malbreitenbach/adp_tauchspulenelektronik/README.md

# adp_tauchspulenelektronik
ADP Tauchspulenelektronik (Versions-/Projektmanagement)
