malbreitenbach/adp_tauchspulenelektronik/Ausarbeitung/ADP_ausarbeitung/ADP.tex

\documentclass[nochapterpage,bigchapter,linedtoc,longdoc,colorback,accentcolor=tud1c]{tudreport}
\usepackage{ngerman}
\usepackage{subfigure} 
\usepackage[stable]{footmisc}
\usepackage[ngerman]{hyperref}
\usepackage{sistyle}
\SIdecimalsign{,}
\SIthousandsep{\,}
\usepackage{longtable}
\usepackage{multirow}
\usepackage{booktabs}
\usepackage{graphicx}
\usepackage[backend=bibtex,style=alphabetic]{biblatex}
\bibliography{./bibtex/library}
\usepackage{amsmath}
\usepackage{caption} 
\usepackage{float}
\usepackage{pdfpages}

\hypersetup{%
  pdftitle={Entwicklung und Test einer
eingebetteten Elektronik für einen
innovativen Schaltaktor},
  pdfauthor={Malte Breitenbach, Johannes Faupel, Jonas Tautz, Johanna Vetter},
  pdfsubject={Beispieltext},
  pdfview=FitH,
  pdfstartview=FitV
}

%%% Zum Tester der Marginalien %%%
  \newif\ifTUDmargin\TUDmarginfalse
  %%% Wird der Folgende Zeile einkommentiert,
  %%% werden Marginalien gesetzt.
  % \TUDmargintrue
  \ifTUDmargin\makeatletter
    \TUD@setmarginpar{2}
  \makeatother\fi
%%% ENDE: Zum Tester der Marginalien %%%

\newlength{\longtablewidth}
\setlength{\longtablewidth}{0.7\linewidth}
\addtolength{\longtablewidth}{-\marginparsep}
\addtolength{\longtablewidth}{-\marginparwidth}

% \settitlepicture{tudreport-pic}
% \printpicturesize

\title{Entwicklung und Test einer eingebetteten Elektronik für einen innovativen Schaltaktor}
\subtitle{Development and test of embedded electronics for an innovative shift actuator}
\subsubtitle{Advanced Design Project (ADP)\\Autoren: Malte Breitenbach, Johannes Faupel, Jonas Tautz, Johanna Vetter\\ Betreuer: Daniel Schöneberger\\Bearbeitungszeitraum: 27. November 2018 ~- 03. April 2019\\Technische Universität Darmstadt}
%\subsubtitle{email: \textaccent{tud-design@pro-kevin.de}}
%\setinstitutionlogo[width]{TUD_sublogo}
%\uppertitleback{(\textaccent{\textbackslash uppertitleback})}
\setinstitutionlogo{./Bilder/IMSLogo}
\lowertitleback{\hfill\today}
\institution{ 
Institut für Mechatronische Systeme im Maschinenbau\\
     Prof. Dr.-Ing. Stephan Rinderknecht}
%\dedication{Hier ist gen"ugend Platz\\
  %f"ur eine Widmung (\textaccent{\textbackslash dedication}).\\
  %\strut\\
  %F"ur Annelore Schmidt\\
  %aus dem Referat Kommunikation.\\
  %Sie hat immer ein offenes Ohr\\
  %f"ur unsere Fragen und Anregungen.}
%\sponsor{\color{tud9b}\rule{\linewidth}{7mm}}
%\sponsor{\hfill\includegraphics[height=6ex]{tud_logo}\hspace{1em}\includegraphics[height=6ex]{TUD_chaos}}

\begin{document}
\maketitle
\pagenumbering{roman}
\cleardoublepage
\phantomsection
\addcontentsline{toc}{chapter}{Aufgabenstellung}
\includepdf[pagecommand={\thispagestyle{plain}},width=1.16\columnwidth]{./input/aufgabenstellung2.pdf}
\cleardoublepage
\phantomsection
\addcontentsline{toc}{chapter}{Erklärung}
\input{./input/Erklaerung} 
\cleardoublepage
\phantomsection
\addcontentsline{toc}{chapter}{Kurzfassung}
\section*{Kurzfassung}
Die vorliegende Arbeit befasst sich mit der Entwicklung und der Realisierung  einer eingebetteten Elektronik für einen linearen Tauchspulenaktor. Dieser wird als Schaltaktor für mehrgängige elektrische Antriebe entwickelt und am Prüfstand des Instituts für Mechatronische Systeme eingesetzt um die Schaltgabel eines Getriebes translatorisch zu bewegen.
In vorangegangenen Arbeiten wurde bereits eine Regelung der Schaltgabelposition entworfen. Auf Basis dessen erfolgt zunächst die Implementierung der bisherigen Programmierung mittels einer geeigneten Toolchain in Matlab-Simulink auf einem Mikrocontroller, der von nun an die Steuerung der Schaltgabel übernehmen soll. Mithilfe von CAN-Kommunikation soll der Mikrocontroller einerseits Statusmeldungen und besonders Fehlzustände übermitteln können, andererseits bietet die CAN-Schnittstelle die Möglichkeit, dem Mikrocontroller Befehle zu senden. Im nächsten Schritt wird die für die Regelstrecke benötigte Elektronik, welche Aktoransteuerung, Sensorik sowie Spannungsversorgung umfasst, an den Aktor integriert, indem die gesamte Schaltung auf einer eigens entworfenen Platine verwirklicht wird, welche anschließend in einem Gehäuse liegend am Aktor verschraubt wird. Zusätzlich wird das System um einen Temperatursensor, der Übertemperaturen erkennen kann, sowie eine Strom- sowie Betriebsspannungsmessung erweitert.
Das Ergebnis der Arbeit ist ein Smart Actuator inklusive kompakter eingebetteter Elektronik, der auf einfachen Befehl über die Benutzeroberfläche Controldesk selbstständig die zwei Gänge einlegen oder in Neutralstellung schalten kann.\\

\textbf{Schlagwörter:} Smart Actuator, eingebettetes System, Linearaktor, Platinendesign

\section*{Abstract}
This thesis deals with the evaluation and implementation of an embedded electronics for a linear plunger coil actuator.  This actuator is used at the test bench of the Institute of Mechatronic Systems to move the shift fork of a transmission.
In previous work a control of the shift fork position has already been developed. On the foundation of this, the implementation of the previous programming is carried out using a suitable toolchain in Matlab-Simulink on a microcontroller, which henceforth will take over the control of the shift fork. With the use of CAN communication, the microcontroller should be able to transmit status messages and especially error states but also the CAN interface gives the opportunity to send commands directly to the microcontroller. In the next step, the electronics required for the controlled system, including the actuator control, sensor technology and power supply, are integrated into the actuator by realizing the entire circuit on a specially designed circuit board, which is then mounted to the motor in a case. In addition, a temperature sensor, which can detect overtemperatures, is integrated as well as some internal functions, for example the current measurement within the used half bridges.  The result of the work is a Smart Actuator including compact embedded electronics, which can engage the two gears independently or shift to neutral position with a simple command via the user interface Control Desk.\\

\textbf{Keywords:} smart actuator, embedded system, linear actuator, PCB design
\cleardoublepage
\phantomsection
\addcontentsline{toc}{chapter}{Inhaltsverzeichnis}
\tableofcontents
\cleardoublepage
\phantomsection
\addcontentsline{toc}{chapter}{\listfigurename}
\listoffigures
\cleardoublepage
\phantomsection
\addcontentsline{toc}{chapter}{\listtablename}
\listoftables
\input{./input/Abkuerzungsverzeichnis}
\cleardoublepage
\pagenumbering{arabic}
%% Hier Tex-Dateien includen
%%%%%%%%%%%%%%%%%%%%%%%%%%%%%%%%%%%%%%%%%%
\input{./input/1_Einleitung}
\input{./input/2_Pruefstand}
\input{./input/3_Vorgehensweise}
\input{./input/4_Komponentenauswahl}
\input{./input/5_Platinendesign}
\input{./input/6_Software}
\input{./input/7_Analyse}
\input{./input/8_Fazit}
%%%%%%%%%%%%%%%%%%%%%%%%%%%%%%%%%%%%%%%%%%
\newpage
\pagenumbering{Roman}
\phantomsection
\addcontentsline{toc}{chapter}{Literaturverzeichnis}
\printbibliography[title=Literaturverzeichnis]

\input{./input/Anhang}
\end{document}
