malbreitenbach/adp_tauchspulenelektronik/Ausarbeitung/ADP_ausarbeitung/input/2_Pruefstand.tex

\chapter{Aufbau des Prüfstands und Grundlagen}\label{kap2}
In diesem Kapitel wird der verwendete Schaltaktorikprüfstand des IMS, an dem  die Entwicklung des Smart Actuators stattgefunden hat, vorgestellt. Beschrieben wird der Aufbau und die Funktionen des Prüfstands zu Beginn der Projektphase, also bevor eigene Änderungen vorgenommen wurden.
\section{Grundlagen des Prüfstandes}
Die Konstruktion des Prüfstandes erfolgte in vorangegangenen Arbeiten und wurde seitdem stetig weiterentwickelt. An diesem werden Schaltaktoriksysteme für Fahrzeugantriebe untersucht. \autoref{fig:Pruefstand} zeigt den Prüfstand aus der Vogelperspektive. Links ist der Aktor zu sehen, der über Schaltstange und Schaltgabel mit dem Getriebe (rechts) verbunden ist.
Es erfolgt zunächst die Vorstellung des mechanischen Aufbaus, woraufhin der elektronische Aufbau anschließt. 
\begin{figure}[h]
	\centering
		
	\caption{Prüfstand \cite[S.5]{adp}}
	\label{fig:Pruefstand}
\end{figure} \noindent
\subsection{Getriebe allgemein}

Ein Getriebe ist im Automobil dafür zuständig, die Drehzahl des Motors in ein Drehmoment umzuwandeln, welches schließlich die Räder antreibt.
Da Verbrennungsmotoren nur einen vergleichbar kleinen Drehzahlbereich abdecken, werden mehrstufige Getriebe verwendet, um verschiedene Raddrehzahlen durch unterschiedliche Übersetzungsverhältnisse der Getriebezahnräder bereitstellen zu können.  Das Einstellen des jeweiligen Ganges kann dabei per Hand (Handschaltgetriebe) oder automatisiert über einen Aktor (Schaltaktorik) erfolgen. 
Im Fahrzeuggetriebe, beispielhaft dargestellt in \autoref{fig:Fahrzeuggetriebe}, ist die Eingangswelle, welche durch den Motor angetrieben wird, über eine Zahnradverbindung  fest mit der  Vorgelegewelle verbunden. Auf ihr sind noch weitere fest fixierte Zahnräder angebracht, deren Anzahl mit den verfügbaren Gängen übereinstimmt. Diese greifen jeweils in Losräder auf der Abtriebswelle. Um einen bestimmten Gang einzulegen, muss nun das jeweilige Losrad für diesen Zeitpunkt fest mit der Abtriebswelle verbunden werden, sodass nur diese Zahnverbindung ein Drehmoment überträgt. Dies geschieht über eine formschlüssige Verbindung mit einer Schaltmuffe, die über die durch den Aktor angetriebene Schaltgabel in Position gebracht wird.

\begin{figure}[h]
	\centering
		
	\caption{Fahrzeuggetriebe \cite[S.17]{Hilgers2016}}
	\label{fig:Fahrzeuggetriebe}
\end{figure} \noindent

\subsection{Getriebe des Prüfstands}

Der Prüfstand besitzt zwei Gänge, in die über eine Schaltgabel geschaltet werden kann. Eine Bewegung der Schaltgabel nach links legt Gang 1 über eine mechanische Synchronisierung ein, während mit Hilfe einer Bewegung nach rechts die Schaltung des Ganges 2 durch eine Klauenkupplung erfolgt. Somit können sowohl Schaltaktoriksysteme mit als auch ohne Synchronring untersucht werden.
Die Bewegung der Schaltgabel wird durch einen Linearaktor ermöglicht, welcher von außen an dem Item-Profil verschraubt ist. In diesem ist eine Tauchspule verbaut, die die benötigten Kräfte auf die Läuferstange aufbringt. Über eine starre Wellenkupplung sind Läuferstange und Schaltgabel miteinander verbunden, wodurch die Kräfte auf die Schaltgabel übertragen werden und Schaltvorgänge ermöglicht werden.

\subsection{Aktor}

Der momentan in dem Prüfstand verbaute Tauchspulenaktor wurde von \cite{Hahn2018} im Rahmen einer Bachelorthesis entwickelt und konstruiert. Er übernimmt im automatisierten Schaltvorgang die Aufgabe, die Schaltgabel  über die Schaltstange translatorisch zu verschieben. Die Übertragung des Schaltbefehls an den Getriebeaktor erfolgt dabei durch ein elektrisches Signal (\textit{shift by wire}).
Der Aktorquerschnitt ist in \autoref{fig:Querschnitt Aktor} schematisch dargestellt.

\begin{figure}[h]
	\centering
		
	\caption{Querschnitt Tauchspulenaktor \cite[S.30]{Hahn2018}}
	\label{fig:Querschnitt Aktor}
\end{figure} \noindent
Der Aufbau ist zylindrisch und kann in den ortsfesten Stator und den beweglichen Läufer unterteilt werden. Der Stator des Aktors besteht aus zwei gegensinnig in Reihe geschalteten Kupferspulen, welche fest in dem Gehäuse aus Weicheisen liegen und nach oben und unten mit Deckeln aus Aluminium fixiert werden. Der Läufer besteht aus einer nichtmagnetischen Läuferwelle, auf der sich fünf Permanentmagneten aus Neodym-Eisen-Bor befinden, welche mit Hilfe von zwei Polstücken aus Weicheisen axial auf der Läuferstange montiert sind. 
Werden nun die Kupferspulen von Strom durchflossen, so wirkt eine vom Magnetfeld der Permanentmagneten induzierte Lorentzkraft orthogonal auf sie. Diese Kraft ist abhängig von der Stromstärke I, der magnetischen Flussdichte der Permanentmagneten B und der vom Magnetfeld durchsetzten Leiterlänge l:
\begin{equation}\label{eq:lorentz}
F=I\cdot l\cdot B
\end{equation}
Da die Spulen jedoch fest im Gehäuse verbaut sind, wirkt eine entgegengerichtete Kraft auf die Permanentmagneten, die auf der axial verschiebbaren Läuferstange lagern. Diese Kraft bewirkt dann eine translatorische Bewegung der Läuferstange und somit auch der Schaltgabel. Die Richtung der translatorischen Bewegung kann dabei über die Richtung des in den Spulen fließenden Stromes, der Betrag der Kraft über den Betrag des Stromes eingestellt werden.
Anhand von \autoref{fig:Kennlinie Aktor} ist zu erkennen, dass die Kraft-Weg Kennlinien des Aktor innerhalb des Nutzungsbereichs von -10 Millimeter bis +10 Millimeter bei verschiedenen Stromstärken annähernd linear verlaufen. \\

\begin{figure}[h]
	\centering
		
	\caption{Kraft-Weg-Strom Kennlinien des Tauchspulenaktors \cite[S.12]{adp}}
	\label{fig:Kennlinie Aktor}
\end{figure} \noindent

\subsection{Aktorsteuerung}
Zur Ansteuerung des Aktors wird ein Arduino IBT2 Motortreiber verwendet, die Stromversorgung erfolgt über ein Manson SBC-2130 Battery Charger im Power Supply Mode. Der Motortreiber besteht aus zwei BTS7960 MOSFETs, die je nach Vorgabe des pulsdauermodulierten Signals (PWM-Frequenz) eine Spannung von bis zu \SI{13,8}{V} an den Aktor durchschalten. 

\subsection{MicroAutoBox}
Die bisherigen Funktionen am Prüfstand laufen auf einer MicroAutoBox II 1401/1513 der dSpace GmbH. Das Programm zum Schalten des Aktors und der Positionsregelung, welches in MATLAB/SIMULINK entwickelt wurde, wird auf die AutoBox geflasht und diese über die Software dSpace ControlDesk gesteuert.

\subsection {Positionsmessung und -regelung}\label{regler}

Das momentane Ziel des Aufbaus ist es, die Schaltgabelposition zu regeln, um schalten zu können. Das Blockschaltbild hierzu ist in \autoref{fig:Regelstrecke} dargestellt.
\begin{figure}[H]
	\centering
		
	\caption{Regelstrecke Prüfstand nach \cite{adp}}
	\label{fig:Regelstrecke}
\end{figure} \noindent
Über das Programm Control Desk erfolgt die Sollwertvorgabe am PC. Diese wird per Ethernet an die MicroAutoBox, welche den Regler darstellt, übermittelt, die den Wert mit der Istgröße vergleicht, die der Sensor bereitstellt. Die H-Brücke, welche mit einer Stellenergie versorgt werden muss, steuert den Aktor an, um die Schaltgabelposition zu verändern.
Die Position der Läuferstange wird über einen PLCD-25M Sensor gemessen, dessen berührungslose PLCD (permanentmagnetic linear contactless displacement) Technologie die magnetische Sättigung zur Positionsbestimmung verwendet. Der weichmagnetische Kern des Sensors ist über seine komplette Länge von einer Primärspule umgeben. Auf der Schaltgabel ist ein Permanentmagnet befestigt, welcher je nach Position zu einer lokalen Sättigung des weichmagnetischen Kerns führt. Über zwei Auswertungsspulen am Rand des Sensors kann die Position der Sättigungszone entlang der Sensorachse über die induzierte Spannung bestimmt werden.

\begin{figure}[h]
	\centering
		
	\caption{Einbauposition PLCD Sensor an der Schaltgabel \cite[S.14]{adp}}
	\label{fig:Sensor}
\end{figure} \noindent
Die Kalibrierung des Sensors wurde in \cite[S.24f]{messtechnik} entwickelt und erfolgt bisher bei jedem Start, da die Kalibrierparameter beim Ausschalten verloren gehen. Zu Beginn des Einfahrvorgangs der Schaltwalze wird dabei das Spannungssignal $U\textsubscript{0}$ ausgelesen, welches der Ausgangslage von $x\textsubscript{0}=\SI{0}{mm}$ entspricht. Anschließend werden die Spannungssignale $U\textsubscript{1}$ und $U\textsubscript{2}$ an beiden Anschlägen gemessen. Die Wegdifferenz zwischen den beiden Anschlagspositionen beträgt $x_{ges}$=\SI{18,2}{mm}. Nun kann eine Geradengleichung zur Bestimmung der aktuellen Schaltgabelposition gemäß \autoref{eq:Lage} aufgestellt werden. U\textsubscript{a} entspricht dabei immer dem aktuellen Ausgangssignal.

\begin{equation}\label{eq:Lage}
	x=\frac{U\textsubscript{a} -U\textsubscript{0}}{U\textsubscript{1}-U\textsubscript{2}}\cdot x\textsubscript{ges}
\end{equation}
\noindent
Die bisherige Regelung der Schaltgabelposition wurde in einem vorangegangenen Advanced Design Project ausgelegt. Dazu wurden mithilfe des Ziegler-Nichols-Verfahren zunächst Parameter für einen PID-Regler ermittelt, welcher allerdings noch zu große Totzeiten und ein Überschwingen aufwies. In einer anschließenden iterativen Optimierung mit Störgrößenkompensation wurden die Regelparameter zu $K_P$ =\SI{2,6}{\%\frac{V}{mm}}, $K_I$ =\SI{20}{\%\frac{V}{s mm}} und $K_D$ =\SI{1,6}{\%\frac{Vs}{mm}} bestimmt. Der Verlauf der Sprungantwort ist in nachstehender \autoref{fig:Sprungantwort Schaltgabelposition} dargestellt.
\begin{figure}[h]
	\centering
		
	\caption{Sprungantwort Schaltgabelposition \cite[S.35]{adp}}
	\label{fig:Sprungantwort Schaltgabelposition}
\end{figure} \noindent

\section{Grundlagen Löten}
Löten gehört zu den Fügeverfahren und bezeichnet das Verbinden zweier Metalle durch eine Metalllegierung unter Einfluss von Wärme \cite{loeten}. Die Metalllegierung wird dabei als Lot bezeichnet und hat eine geringere Schmelztemperatur (Liquidustemperatur) als die beiden zu verbindenden Metalle (Solidustemperatur). Durch das Löten entsteht eine feste, korrosionsbeständige sowie strom- und wärmeleitende Verbindung. Lötverfahren werden nach Arbeitstemperatur eingeteilt in Weichlöten (bis 450°C), Hartlöten (450°C - 900°C) und Hochtemperaturlöten (über 900°C). Im Rahmen dieses Projektes wird das Verfahren Weichlöten mit Lötkolben angewendet, um die elektrischen Bauteile auf der Platine anzubringen. Dazu können die vom Institut bereitgestellten Lötstationen und –materialien verwendet werden. 

\section{Mikrocontroller}
Ein Mikrocontroller (\textit{MCU: microcontroller unit}) ist ein hochintegrierter Halbleiterchip, der ein komplettes Mikrorechnersystem enthält. Prozessoren, Speicher, Ein- und Ausgabegeräte sind somit auf einem kleinen Chip enthalten, der zum Ziel hat, Steuerungs- und Kommunikationsaufgaben möglichst simpel mit wenig Bauelementen zu bearbeiten. \\
\begin{figure}[H]
	\centering
		
	\caption{Blockschaltbild eines Mikrocontrollers nach \cite[S.3]{Bernstein2015}}
	\label{fig:Blockschaltbild Mikrocontroller}
\end{figure} 
\noindent
In \autoref{fig:Blockschaltbild Mikrocontroller} ist der typische Aufbau eines Mikrocontroller dargestellt. Die Schnittstellen zur Peripherie sind durch einen Betriebsspannungsanschluss, einen Takteingang sowie die Portleitungen  gegeben. Bei den Ports wird zwischen Eingangskanälen (\textit{\textbf{I}nput Port}), die digitale Signale lesen, und Ausgangskanälen (\textit{\textbf{O}utput Port}), die digitale Signale setzen beziehungsweise löschen, unterschieden. Des Weiteren können I/O Pins digitale oder analoge Signale auslesen und stellen, wobei analoge Signale mithilfe eines Analog/Digital Wandlers (\textit{ADC}) zuerst in digital Signale umgewandelt werden müssen, damit der Mikrocontroller sie verarbeiten kann.
Eine Spezialform von Eingängskanälen sind die Interrupt-Pins, die bei bestimmten Ereignissen Unterbrechungen des laufenden Programms verursachen, um temporär einen anderen Vorgang zu bearbeiten. \\
Intern sind die einzelnen Bausteine, die im Folgenden kurz erläutert werden, über ein Bussystem verbunden.
Der Prozessor (\textit{CPU: central processing unit}) führt Berechnungen und logische Operationen durch.
Der Arbeitsspeicher (\textit{RAM: random access memory}) speichert temporär Daten, die aber spätestens nach dem Entfernen der Betriebsspannung verloren gehen.
Der Festspeicher (\textit{ROM: read only memory}) behält seinen Speicherinhalt auch nach dem Entfernen der Betriebsspannung und enthält aufgrund dessen das Programm sowie Einstellungen und wichtige Daten. Im Vergleich zum RAM weist dieser eine langsame Schreibgeschwindigkeit auf. 
Ein sogenannter Timer wird genutzt, um das Auftreten von Ereignissen zu zählen oder Zeitabstände zu messen, indem beispielsweise Spannungswechsel an einem Eingangskanal gezählt werden. \\
Die genaue Ausführung des Chips kann je nach Aufgabentyp variieren, sodass eine Vielzahl an verschiedenen Mikrocontrollern erhältlich ist. Diese unterscheiden sich in der Größe des Speichers, in der Anzahl der Anschlüsse beziehungsweise Schnittstellen, in der Bitbreite, in den Taktraten sowie in der Bauform. Typischerweise werden Mikrocontroller in eingebetteten Systemen (\textit{embedded systems}) verwendet, bei denen die Steuereinheit direkt im System selbst integriert ist. Übliche Anwendungen für Mikrocontroller sind Robotik, Handys, Temperaturregler oder Motorsteuerungen \cite{Brinkschulte}. 

\section{Eingebettete Systeme und Smart Actuator}
Eingebettete Systeme werden definiert als Rechenmaschinen, die für den Anwender weitgehend unsichtbar in einem technischen System eingebettet sind und mit diesem in Wechselwirkung stehen \cite[S.8]{Gessler2014}. Der Rechner kann dabei für Regelungs-, Steuer- oder Überwachungsaufgaben und/ oder für Signal- und Datenverarbeitung zuständig sein. Ziel ist, die Stellglieder als Reaktion auf Eingangssignale, die von Sensoren oder manuell vorgegeben werden, zu steuern \cite[S.1]{Broy2003}. Eingebettete Systeme werden oft für speziell eine isolierte Aufgabe entwickelt und angepasst.
Ein Aktor wird genutzt um elektrischen Signale in eine Bewegung oder Kraft umzusetzen und bildet somit das Stellglied. \\
Ein intelligenter Aktor (\textit{smart actuator}) ist definiert als das integrierte Stellglied inklusive aller Komponenten wie Motor, Steuerung, Sensorik und Kommunikationseinheit \cite[S.442]{smartactuator}.
Das Konzept besteht darin, den Aktor um Informationsverarbeitungs- und Kommunikationsmöglichkeiten zu erweitern, sodass der Aktor die eingebettete Elektronik enthält.
Smart Actuators reduzieren beziehungsweise ersetzen die benötigte Interaktion mit einem Menschen oder externen Rechner und können somit effektiver und schneller arbeiten. Über diese kann viel Bauraum eingespart werden, da es weniger Komponenten und deutlich weniger Verkabelung gibt, womit der Einbau in ein Gesamtsystem komfortabler ist. Hervorzuheben sind weiterhin die verringerten Kosten, die Überwachung und Diagnose des eigenen Zustands sowie die verbesserte Präzision. Einbußen müssen Smart Actuators allerdings in Bezug auf flexible Anwendungen machen, da sie oft für eine spezielle Aufgabe ausgelegt sind und ihr Verhalten stark vorgegeben ist. \cite[S.4]{smartaktor}

\section{Controller Area Network (CAN)}\label{sec:CAN_KAP2}
Um eine Kommunikation zwischen mehreren Geräten (z.B. Sensoren, Aktoren oder Steuergeräten) zu ermöglichen, muss ein System zur Datenübertragung vorhanden sein. Dabei hat sich bei vielen PKW- und NKW-Herstellern  das Controller Area Network (CAN) durchgesetzt \cite[S.57]{Werner2014}. CAN ist ein von Bosch für den Automobilbau entwickeltes Bussystem, mit dem mehrere gleichberechtigte Teilnehmer verbunden werden und miteinander kommunizieren können \cite[S. 278]{Woern2006}.
Für ein CAN-Netzwerk werden zwei Leitungen CAN-High und CAN-Low benötigt, an denen alle zu verbindenden Teilnehmer parallel angeschlossen sind. Die beiden Leitungen werden an beiden Enden mit Wellenwiderständen von 120 Ohm verbunden. Der schematische Aufbau eines CAN-Busses mit zwei Teilnehmern ist in \autoref{fig:CAN} dargestellt.\\
\begin{figure}[h]
	\centering
		
	\caption{Aufbau CAN-Bus \cite[S.158]{manual}}
	\label{fig:CAN}
\end{figure} \noindent
Sollten mehrere Teilnehmer gleichzeitig versuchen eine Nachricht zu senden und somit ein gleichzeitiger Buszugriff vorliegt, kommt es zu einer Kollision. Um diese Aufzulösen wird ein CSMA/CR-Verfahren (\textit{Carrier Sense Multiple Access/Collision Resolution}) verwendet, bei dem die höher gewichtete (dominante) Nachricht die niedriger gewichtete (rezessive) Nachricht überschreibt, sodass der Übertragungsversuch beendet wird. Die Einteilung der Relevanz einer Nachricht erfolgt auf Basis der sogenannten Identifier(ID)-Bits, wobei niedrige ID-Bits eine höhere Relevanz als höhere ID-Bits haben. Dadurch wird eine Hierarchie der Nachrichten erzeugt, wodurch die Nachricht mit der niedrigsten ID immer gesendet werden darf. Dementsprechend werden wichtigen Nachrichten niedrige IDs zugeteilt \cite{Lawrenz2010}. 
Die Geschwindigkeit der Datenübertragung zwischen den Teilnehmer ist dabei von der Länge der Leitungen abhängig und beträgt maximal 1Mbit/s. Nach \cite[S.58]{Werner2014} kann die Bitrate überschlagsmäßig mit 
\begin{equation}
	\text{Buslänge}\leq 40...\SI{50}{m}\cdot \frac{1\text{MBit/s}}{\text{Bitrate}}
	\label{eq:CAN}
\end{equation}
berechnet werden.\\
In \autoref{CANNachrichten} wird speziell auf die in dieser Arbeit eingerichtete CAN-Kommunikation eingegangen. Es wird ein CAN-Bus verwendet, mit dem im derzeitigen Versuchsstand zwei Teilnehmer miteinander verbunden werden. Diese sind zum einen die MicroAutoBox und zum anderen der Mikrocontroller des Smart Actuators. Die Länge der Leitungen zwischen den beiden ist wesentlich kürzer als \SI{3}{m}, wodurch nach \autoref{eq:CAN} die maximale Bitrate von 1Mbit/s möglich wird.

\section{Pulsweitenmodulation}
Pulsweitenmodulation (PWM) bietet die Möglichkeit, ein analoges Signal anhand einer digitalen Quelle zu bilden, indem das Tastverhältnis eines Rechteckimpulses bei gleichbleibender Frequenz moduliert wird. Dabei wird der Effekt ausgenutzt, dass sich ein digitales Signal, welches schnell genug und in einem gewissen Tastverhältnis seinen Zustand wechselt, verhält wie ein analoges Signal mit konstanter Spannung. So kann mithilfe von PWM beispielsweise ein Motortreiber angesteuert werden, der über MOSFETS das PWM Signal mit höherem Spannungslevel durchschaltet. Über die Tiefpasswirkung des Motors wird das Signal geglättet, sodass es sich annähernd wie eine angelegte Gleichspannung verhält (vgl. \autoref{sec:hbridge}).\\
Das Tastverhältnis, oder der Tastgrad, p beschreibt dabei das Verhältnis zwischen der Einschaltzeit t\textsubscript{ein} und der Periodendauer $\tau$:
\begin{equation}
	p=\frac{t\textsubscript{ein}}{\tau} = \frac{t\textsubscript{ein}}{t\textsubscript{ein}+t\textsubscript{aus}}
\end{equation}
Das Tastverhältnis kann nur Werte zwischen 0 und 1 annehmen.\\
Der zeitliche Mittelwert der Spannung U\textsubscript{m} ergibt sich dann bei einer Betriebsspannung V\textsubscript{b} zu:
\begin{equation}
	U\textsubscript{m}=V\textsubscript{b}\cdot p
\end{equation}
In Abbildung \ref{fig:PWM} ist ein pulsweitenmoduliertes Signal mit dem entsprechendem zeitlichen Mittelwert aufgetragen. Das Tastverhältnis entspricht hier $p=0,75$.
\begin{figure}[H]
	\centering
		
	\caption{Beispielhaftes PWM Signal}
	\label{fig:PWM}
\end{figure} \noindent

\section{Zustandsautomaten}
Zustandsautomaten, auch endliche Automaten genannt, eignen sich zur Beschreibung von Systemen, in denen eine endliche Anzahl an Ereignissen eintreten können. In ihnen treten Zustände, Zustandsübergänge und Aktionen auf, aus dem das Verhalten einen Systems modelliert wird. Zustandsübergänge sind logische Operatoren, die erfüllt sein müssen, damit ein System von Zustand X in Zustand Y wechselt. Dementsprechend hat ein Übergang immer einen Zustand als Ein- und Ausgang. Aktionen können durch den Eingang in einen Zustand, den Ausgang aus einem Zustand oder durch eine Eingabe ausgelöst werden. \\
Eine visuelle Darstellung von Zustandsautomaten kann über Zustandsübergangsdiagramme erfolgen. Dabei werden die Zustände mit Pfeilen (Zustandsübergänge) verbunden. Diese Pfeile werden mit Bedingungen beschriftet, die erfüllt sein müssen, damit der Zustand in Richtung des Pfeils gewechselt wird. In den Zuständen selbst stehen die Aktionen die bei Ein- und Ausgang aus dem Zustand, sowie bei bestimmten Eingaben ausgeführt werden.\\
In \autoref{fig:automat} ist ein einfaches Beispiel eines Zustandsautomaten zu sehen. Dieser besteht aus zwei Zuständen, welche jeweils durch einen Zustandsnamen benannt werden. Zum Wechseln von Zustand 1 in Zustand 2 muss die Übergangsbedingung (Transitionsbedingung 1) erfüllt sein. Beim Eintritt in den jeweiligen Zustand werden Eingangsaktionen ausgeführt.
\begin{figure}[H]
	\centering
		
	\caption{Beispiel eines Zustandsautomats mit zwei Zuständen}
	\label{fig:automat}
\end{figure} \noindent

\section{Serial Wire Debug}
Serial Wire Debug (SWD) ist eine Weiterentwicklung des IEEE-Standards 1149.1 (\textit{JTAG}), welcher eine Debugging- und Programmiermethode für Mikrocontroller oder FPGAs auf Leiterplatten ist. JTAG wurde ursprünglich entwickelt um die Signalkommunikation zwischen mehreren Chips in einem elektronischen System zu überprüfen und wurde dann zunehmend zur Programmierung eingesetzt \cite{swd}. Während JTAG fünf Pins zur Programmierung benötigt (TCK, State Machine Control, Data In, Data Out, Reset) genügen SWD bei den selben Mikrocontroller-Ausgängen zwei Signale (SWCLK, SWDIO). Die geringe Anzahl der Ports basiert dabei auf dem bidirektionalen SWDIO Pin, welcher die Rolle der Data In und Data Out Ports gleichzeitig übernehmen kann \cite{swd}. Unter Debugging versteht man die geführte Ausführung eines Programms, vornehmlich um Fehlerzustände zu lokalisieren. Programmierung bezeichnet den Vorgang, bei dem ein Programm von einer Programmierumgebung auf die Zielhardware übertragen wird. In diesem ADP wird eine SWD-Verbindung aufgebaut um den Mikrocontroller der Platine zu programmieren.
