malbreitenbach/adp_tauchspulenelektronik/Ausarbeitung/ADP_ausarbeitung/input/7_Analyse.tex

\chapter{Analyse und Performance}\label{kap7}
\section{Produktvergleich mit Anforderungsliste}\label{vergleich}
Um das Endresultat im Kontext der zuvor definierten Anforderungen analysieren zu können, wird sich auf die Anforderungsliste aus \autoref{kap1} berufen, welche aus Übersichtsgründen in \autoref{tab:Anforderungsliste2} noch einmal abgebildet ist.\\ 
Im Rahmen der Arbeit wurde eine zuvor eingerichtete \textbf{CAN-Schnittstelle} zum Senden von CAN-Nachrichten genutzt. Dazu werden die Signale in die nach \autoref{CANNachrichten} definierten Befehle unterschieden, sodass sich eine sinnvolle und benutzerfreundliche Menge an übermittelbaren Nachrichten ergibt. Es ist sowohl möglich die benötigten Schaltbefehle zu übermitteln, als auch Statusmeldungen über Übertemperatur, Überspannung etc. zu empfangen. Damit ist die Festforderung erfüllt.\\
Um eine \textbf{nichtflüchtige Kalibrierung} zu realisieren, werden die Daten der durchgeführten Kalibrierung in den Flash-Speicher abgelegt. Aufgrund der Speichertechnologie ist dieser nichtflüchtig, womit die Kalibrierungsdaten auch bei Unterbrechung der Versorgungsspannung des Mikrocontrollers erhalten bleiben. Bei erneuter Kalibrierung werden die alten Kalibrierungsdaten überschrieben.\\
In \autoref{reglerergebnisse} sind die Plots zu der Regelung des Tauchspulenaktors zu finden, anhand derer eine Abschätzung der \textbf{Schaltzeiten} gewonnen werden kann. In den Plots ist zu sehen, dass zwischen Empfangen des Schaltbefehls und Einlegen des Ganges weniger als \SI{55}{ms} vergehen. Damit ist die Bereichsforderung von Schaltzeiten \SI{<100}{ms} erfüllt.\\
Bei der \textbf{selbstständigen Fehlererkennung} wurden im Zusammenspiel zwischen \autoref{ch:komp} und \autoref{kap6} Erkennungsstrategien für Überstrom, Temperaturüberschreitung und Fehler in der Eingangsspannung implementiert. Überstrom lässt sich über die IS-Pins der H-Brücken detektieren, dessen Funktion in \autoref{sec:hbridge} genauer erklärt wird. Zur Überprüfung einer Temperaturüberschreitung wird ein Temperatursensor im Aktorgehäuse verbaut, der in \autoref{sub:temp} beschrieben ist. Die Überprüfung der Eingangsspannung erfolgt nach \autoref{eingangsspannung}. Die Aufgabe der Dekalibrierungserkennung ließ sich im Rahmen des jetzigen Versuchsstandes nicht realisieren, könnte aber nach einer Erweiterung des Prüfstandes möglich sein. Im Falle eines betriebenen Motors ließe sich detektieren, ob dieser im Leerlauf betrieben wird, was der Getriebestellung im Neutralgang entspricht. Wird ein Lastmoment detektiert, was sich von dem Referenzlastmoment unterscheidet, ließe sich ein Kalibrierungsfehler erkennen, da in diesem Fall ein Gang eingelegt ist. Das Referenzlastmoment entspricht dem Leerlaufmoment. Diese Überlegung zur Detektion eines Kalibrierungsfehlers ist zu prüfen, womit diese Festforderung nur in Teilen erfüllt wurde.\\
Als Anforderungen an die \textbf{Schnittstellen} sind CAN-Kommunikation, Versorgungsspannungen von \SI{8-16}{VDC} und der Aufbau einer Programmierschnittstelle genannt. Diese Schnittstellen sind alle erfolgreich implementiert worden, was in \autoref{ch:komp} beschrieben ist. Als Programmierschnittstelle wurde sich für eine SWD-Verbindung via ST-Link/V2 entschieden, sodass Updates und Bugfixes problemlos über den Stecker möglich sind. Zusätzlich wurde die Möglichkeit einer UART Kommunikation offen gehalten, sodass diese ebenfalls für Debugging benutzt werden kann. Diese Festforderung ist in allen Punkten erfüllt.\\
Der Wunsch über \textbf{Wartbarkeit} wurde erfüllt. Die Sicherungen laufen über einen externen Sicherungsblock, welcher im späteren Einsatz im Fahrzeug dessen Sicherungsblock entsprechen soll. Die Platine ist bei derzeitigem Elektronikgehäusestand entnehmbar und somit austauschbar. Bei Softwareproblemen muss dies jedoch nicht erledigt werden, da die Programmierschnittstelle über den Stecker nach außen geführt wird. \\
Mit einer Baugröße von 88,8x\SI{50}{mm} weist die Platine eine kompakte Baugröße auf und ist somit für den Einbau in einem Smart Actuator geeignet. Im Vergleich mit dem zuvor verwendeten Motortreiber Arduino IBT2 Motortreiber, welcher eine Platinenfläche von 50x\SI{50}{mm} besitzt, weist die Platine weniger als die doppelte Fläche auf, obwohl Logik, CAN-Kommunikation, Spannungsregler, Sensorik und EMV-Maßnahmen ebenfalls darauf platziert sind. Damit ist diese Bereichsforderung erfüllt. \\
Die \textbf{Temperaturbeständigkeit} wird in \autoref{ch:komp} behandelt und die Auswahl der Bauteile nach diesem Kriterium berücksichtigt. Um dieser Anforderung gerecht zu werden, ist die Mehrheit der Bauelemente nach dem AEC-Q Standard ausgewählt worden. Alle verwendeten aktiven und passiven Bauteile entsprechen so den Forderungen an einen Betriebstemperaturbereich von -40...\SI{105}{^\circ C}.\\
In der Regelung des Tauchspulenaktors tritt \textbf{Überschwingen} auf, was in \autoref{reglerergebnisse} dokumentiert ist. Als maximal zulässiger Wert der Überschwingung wird \SI{1}{mm} festgesetzt. Ab einem Überschwingen von \SI{2}{mm} aus dem Neutralgang heraus, ist von einem unabsichtlichen Gangwechseln auszugehen. Somit entspricht diese Forderung einer Sicherheit von zwei. Die Messergebnisse weisen Überschwingweiten von \SI{0,4}{mm} auf, daher ist ein unbeabsichtigter Gangwechsel ausgeschlossen. Die Bereichsforderung ist damit erfüllt.\\
Die \textbf{Standby-Leistungsaufnahme} beträgt in etwa \SI{1,38}{W}, da zur Versorgung des Mikrocontrollers und der restlichen Bauteile ein Standby-Strom von etwa 100mA fließt.\\
Nach \autoref{schaltgabelkraft} ist zu erkennen, dass über Gegenbestromung der Spule eine Gegenkraft zur Massenträgheit (Lorentzkraft) aufgebaut wird. Darüber wird die \textbf{Schaltgabelkraft} am Anschlag minimiert.\\
Die Forderung nach \textbf{Effizienz} konnte nicht zuverlässig überprüft werden, wobei nach \autoref{sec:analyse_stellsignal} davon ausgegangen werden kann, dass sie erfüllt ist.
\begin{table}[h]
	\centering
	\captionabove{Anforderungsliste}
		\begin{tabular}{l|p{5cm}|p{7cm}|c}
			\textbf{Relevanz} & \textbf{Anforderung} & \textbf{Erläuterung} & Erfüllt?\\ \hline
			& &\\
			FF & Benutzerfreundliche Kommunikation durch CAN Schnittstelle & Empfang von Befehlen, Senden von Statusmeldungen & \checkmark\\ \hline
			FF & Programmierbarkeit im eingebauten Zustand & Updates über Schnittstelle im eingebauten Zustand möglich. Diese werden über Waijung erstellt & \checkmark \\ \hline
			FF & Nichtflüchtige Kalibrierung & Eine Kalibrierung ist nur einmalig und zur Rekalibrierung notwendig& \checkmark\\ \hline
			BF & Schaltzeit & < \SI{100}{ms} (Zeit zwischen Senden des Befehls und vollständig ausgeführtem Gangwechsel)& \checkmark\\ \hline
			FF & Selbstständige Fehlererkennung & Überstrom, Übertemperatur, Eingangsspannungsbereich, Dekalibrierung& (\checkmark) \\ \hline
			FF & Schnittstellen & CAN, \SI{8-16}{VDC} Versorgung, Programmierschnittstelle (für Updates \& Bugfixes)& \checkmark \\ \hline
			W & Wartbarkeit & Sicherung wechseln im eingebauten Zustand& \checkmark\\ \hline
			BF & kompakte Baugröße & 88,8x\SI{50}{mm}&\checkmark \\ \hline
			BF & Effizienz (gemittelt über einen Schaltvorgang) & elektrischer Wirkungsgrad > \SI{90}{\%} & ?\\ \hline
			FF & Temperaturbeständigkeit & bis \SI{105}{^\circ C}& \checkmark \\ \hline
			BF & Aktorüberschwingen & Toleriert, solange kein unbeabsichtigter Gangwechsel $\rightarrow$ \SI{<1}{mm}& \checkmark
			\\ \hline
			W & Schaltgabelkraft am Anschlag & möglichst gering& \checkmark \\ \hline
			FF & Standby & Standbyleistungsaufnahme < \SI{2}{W}& \checkmark \\ \hline
		\end{tabular}
	\label{tab:Anforderungsliste2}
\end{table}
\section{Kostenaufstellung}
Die Materialkosten für die fertige Platine inklusive aller Bauteile belaufen sich bei einer einzigen Platine auf \SI{80,26}{\euro}. Bei einer Stückzahl von 100 kann der Preis bereits auf \SI{33,51}{\euro} gesenkt werden, während die Bauteilkosten bei einer Fertigung von 1000 Platinen nochmal auf \SI{24,68}{\euro} sinken. Diesen großen Preisunterschied verursacht vor allem die unbestückte Platine selbst, die bei Bestellung von einer einzigen \SI{38,5}{\euro} kostet und bei einer Bestellung von 1000 Stück nur noch \SI{0,82}{\euro}. \autoref{tab:Preisliste} zeigt die verwendeten Bauteile und deren Anzahl sowie den kumulierte Preis pro Bauteilart (Anzahl des Bauteils multipliziert mit dem Einzelpreis) für jeweils eine Fertigung von einer Platine, von 100 Platinen und von 1000 Platinen. Die Nettopreise stammen dabei von den Anbietern, bei denen die Komponenten jeweils eingekauft wurden.
\begin{table}[h]
	\centering
	\captionabove{Preisliste}
\begin{tabular}{ l   l   c   c   c }
	Anzahl & Bauteil & Bauteilpreis & Bauteilpreis 100+ & Bauteilpreis 1000+\\ \hline
	1 & Platine & \SI{38,5}{\euro} & \SI{2,39}{\euro} & \SI{0,82}{\euro}\\
	\  & \  & \  & \  & \  \\
	1 & Mikrocontroller & \SI{10,66}{\euro} & \SI{7,79}{\euro} & \SI{6,58}{\euro} \\
	2 & Halbbrücken & \SI{6,56}{\euro} & \SI{5,96}{\euro} & \SI{5,04}{\euro}\\
	1 & Leitungstreiber & \SI{0,62}{\euro} & \SI{0,35}{\euro} & \SI{0,25}{\euro} \\
	1 & CAN Transceiver & \SI{2,82}{\euro} & \SI{2,28}{\euro} & \SI{1,51}{\euro} \\
	1 & Voltage Regulator \SI{3,3}{V} & \SI{0,34}{\euro} & \SI{0,16}{\euro} & \SI{0,10}{\euro} \\
	1 & Voltage Regulator \SI{5}{V}& \SI{0,34}{\euro} & \SI{0,16}{\euro} & \SI{0,10}{\euro} \\
	\  & \  & \  & \  & \  \\
	1 & Klemmblock & \SI{1,16}{\euro} & \SI{1,07}{\euro} & \SI{0,91}{\euro} \\
	2 & Klemmblock & \SI{0,74}{\euro} & \SI{0,62}{\euro} & \SI{0,53}{\euro} \\
	1 & Steckverbinder & \SI{0,04}{\euro} & \SI{0,04}{\euro} & \SI{0,04}{\euro} \\
	1 & AMPSEAL Automotive Steckverbinder & \SI{7,09}{\euro} & \SI{6,22}{\euro} & \SI{5,23}{\euro}\\
	\  & \  & \  & \  & \  \\
	1 & Quarz & \SI{0,61}{\euro} & \SI{0,36}{\euro} & \SI{0,38}{\euro} \\
	21 & Widerstände & \SI{4,88}{\euro} & \SI{3,05}{\euro} & \SI{1,68}{\euro}\\
	21 & Kondensatoren & \SI{5,91}{\euro} & \SI{3,06}{\euro} & \SI{1,50}{\euro}\\
	\  & \  & \  & \  & \  \\
	\  & \textbf{Gesamtpreis} & \textbf{\SI{80,26}{\euro}}  & \textbf{\SI{33,51}{\euro}}  & \textbf{\SI{24,68}{\euro}}  \\
\end{tabular}
	\label{tab:Preisliste}
\end{table}\noindent
Die gesamte Preisauflistung für die Stückzahlen 1, 100 und 1000 inklusive der einzelnen Widerstände und Kondensatoren, sowie die Händlerlinks zu allen Bauteilen befindet sich im Anhang.
In nachfolgenden Abbildungen wird die Verteilung der Kosten auf die verschiedenen Bauteilgruppen dargestellt. Die Bauteile wurden unterteilt in die Platine, die passiven Bauteile (Kondensatoren, Widerstände und Schwingquarz), die ICs (Mikrocontroller, Spannungsregler, CAN Transceiver, Leitungstreiber, Halbbrücken) sowie die Stecker, die die Schnittstellen nach außen darstellen. 

\begin{figure}[H]
\begin{minipage}[h]{0.5\textwidth}

\end{minipage}
\begin{minipage}[h]{0.5\textwidth}

\end{minipage}
\caption{Aufteilung der Kosten für die Stückzahlen 1 (links) und 1000 (rechts)}
	\label{fig:LDO}
\end{figure}\noindent
Es ist zu erkennen, dass die Platine bei geringen Stückzahlen ungefähr die Hälfte der Kosten ausmacht, während sie bei hohen Stückzahlen fast gar nicht mehr ins Gewicht fällt. Bei hohen Stückzahlen sind der größte Kostenfaktor die ICs. 
Ein Preisvergleich mit direkter Konkurrenz fällt schwer, da es wenig äquivalente Produkte auf dem Markt gibt, jedoch können die beiden vorherig am Prüfstand verwendeten Motortreiber zum Vergleich gezogen werden, die nur einen Teil der Platinenfunktionen abdecken. Der Kaufpreis des Motorcontrollers MDC1460 des Herstellers RoboteQ liegt bei ca. \SI{260}{\euro} (bei über vierfachem Bauraum), der Kaufpreis des Arduino IBT\_2 Motortreibers liegt bei circa \SI{15}{\euro}. Zu bemerken ist, dass sich die Kosten der Platine auch mit einem mit einzurechnenden Gewinnaufschlag innerhalb des Preisrahmens der beiden Motortreiber bewegt, obwohl sie deutlich mehr Funktionen aufweist.

\section{Platinendesign-Analyse}\label{sec:platan}
Die Platine erfüllt für den derzeitigen Aktor die Aufgaben Positionsregelung bei Schaltvorgängen, Überwachung der Umgebung (Temperatur, Eingangsspannung, Ausgangsstrom) und die Kommunikation mittels CAN-Nachrichten. Bisher sind keine Probleme mit EMV aufgetreten, sodass die Sensorik auch bei Ansteuerung der Halbbrücken funktioniert und die CAN-Kommunikation erhalten bleibt. Die Anforderung an eine kompakte Baugröße wird mit 88,8x\SI{50}{mm} erfüllt. Eine einfache Handhabung in der Peripherie wird über den Anschlussstecker erreicht. Im Falle von Softwareupdates lässt sich der Betriebstecker leicht entfernen und die Updates über den Programmierstecker flashen, was in \autoref{sec:stecker} genauer behandelt wird. Sollten im Betrieb nach Einführen des neuen Aktors trotz der Schirmungsmaßnahmen Probleme mit EMV auftreten, so wird empfohlen das Platinendesign wie in \autoref{app:4layer} auf ein 4-Layer Design zu erweitern, um wie in \autoref{kap5} beschrieben, zusätzliche GND-Planes einfügen zu können. Weiterhin bleiben die LDOs der \SI{3,3}{V} und \SI{5}{V} Schiene zu beobachten, da diese beim Anschluss der Autobatterie relativ viel Wärme abgeben müssen um auf die jeweiligen Spannungsebenen zu regeln. Derzeit sind keine Probleme damit aufgetreten jedoch kann das Verhalten im Dauerbetrieb noch nicht vollständig abgeschätzt werden. Falls keine Probleme auftreten wird empfohlen diese auch bei Einführung eines 4-Layer Designs beizubehalten, da die LDOs konstante Spannungen ohne switching Charakteristiken liefern. Bei Problemen könnte ein Buck-Spannungsregler statt des \SI{5}{V} LDOs eingeführt werden, welcher von Batteriespannung auf die \SI{5}{V} regelt. Für die \SI{3}{V} könnte weiterhin ein LDO verwendet werden, welcher als VCC die \SI{5}{V} des Buck-Spannungsreglers nutzt. Damit wäre die Stabilität der \SI{3}{V} Versorgung für die ADC-Genauigkeit gesichert und das Problem entstehender Wärmeverluste reduziert. Allerdings könnte in dieser Verschaltung die Genauigkeit des Lagesensors nicht auf dem aktuellen Niveau garantiert werden, da dieser an die \SI{5}{V} angeschlossen ist und der Buck-Spannungsregler weniger konstante Spannungen ausgibt als ein LDO. 

\section{Regelergebnisse} \label{reglerergebnisse}
In \autoref{fig:shift_gear2} und \autoref{fig:shift_toneutral} sind die exemplarisch gemessenen Positionsverläufe, Regelabweichungen und Stellgrößen für das Schalten von Gang 2 zu Neutral und umgekehrt aufgetragen. Das Schalten von und nach Gang 1 wird nicht betrachtet, da der verbaute Synchronring die Regelung bei einer Drehzahl $n=0$ zu stark behindert.\\
Die Messungen wurden 20 mal durchgeführt, sodass eine Reproduzierbarkeit der Ergebnisse sichergestellt werden konnte. In den Abbildungen ist jeweils zum Zeitpunkt $t=0$ ein Sollwertsprung zu sehen. Die Sollwerte sind mit roten Linien gekennzeichnet und betragen für den zweiten Gang \SI{10}{mm} und für Neutral \SI{0}{mm}. Für beide wurde ein Toleranzband festgelegt, das \SI{10}{\%} der Sprunghöhe zwischen den Gängen entspricht. Der verwendete PID-Regler mit Störgrößenkompensation wurde in \autoref{regler} beschrieben.

\subsection{Schalten in Gang 2}

Für das Schalten in Gang 2 ist in \autoref{fig:shift_gear2} ein Überschwingen von \SI{380}{\mu m} zu beobachten. Dies kann allerdings auf die lose Befestigung des Lagesensors im Prüfstand zurückgeführt werden. Der Schaltvorgang bringt den ganzen Prüfstand kurzzeitig zum Schwingen, sodass der Lagesensor eine zusätzliche relative Bewegung zur Läuferstange erfährt. Die Sollposition wird erstmals nach \SI{42}{ms} erreicht und verlässt das Toleranzband nach einer Dauer von \SI{54}{ms} nicht mehr. In dem Verlauf der Stellgröße zeigt sich, dass für den Schaltvorgang das maximale PWM-Signal bei \SI{63}{\%} liegt und somit ein großer Anteil der möglichen Stromdurchschaltung gar nicht ausgenutzt wird. Die Stellgröße bleibt nahezu konstant, bis ca. \SI{2}{mm} vor dem Erreichen der Sollposition. Anschließend fällt sie kurzzeitig ins Negative, bevor sie sich bei \SI{0}{\%} einpendelt.  

\subsection{Schalten in Neutral}
Bei diesem Schaltvorgang zeigt \autoref{fig:shift_toneutral} ein erstes Überschwingen von \SI{288}{\mu m} über den Sollwert. Auch dieses Überschwingen kann durch die Bewegung des Sensors erklärt werden. Die Sollwertvorgabe wird nach \SI{42}{ms} zum ersten Mal erreicht und dessen Toleranzband wird nach \SI{50}{ms} nicht mehr verlassen. Die Stellgröße springt zu Beginn des Schaltvorgangs auf ein PWM-Signal von \SI{-72}{\%}, was anschließend betragsmäßig bis zu einer Regelabweichung von \SI{1,4}{mm} auf einen Wert von \SI{-28}{\%} abnimmt. An dieser Stelle springt das PWM-Signal in den niedrigen positiven Bereich, bevor es sich bei \SI{0}{\%} einpendelt.

\subsection{Diskussion der Regelergebnisse}\label{diskreg}
Die beiden Schaltvorgänge erreichen ihren Sollwert und die zugehörige stationäre Genauigkeit in unter \SI{50}{ms}, was die Anforderungen von einer Schaltzeit \SI{\leq100}{ms} klar erfüllt. Für die stationäre Genauigkeit ist die korrekte Positionierung des Lagesensors von entscheidender Bedeutung. Diese Position bleibt allerdings nicht über alle Schaltvorgänge gleich, aufgrund der losen Halterung und den Erschütterungen des Prüfstands. Abhilfe könnte hier eine besserere Fixierung schaffen, wodurch die Regelergebnisse weiter verbessert werden könnten. Aber auch unter Annahme, dass die Überschwingungen nicht auf den Lagesensor zurückzuführen sind, stellen sie aufgrund ihrer geringen Größe (\SI{\leq400}{\mu m}) kein Problem dar. Erst ab einem Überschwingen von \SI{\geq1}{mm} wäre in der Neutralstellung die Gefahr des unabsichtlichen Schaltens in einen anderen Gang gegeben.\\
In den Verläufen der Stellgrößen ist zu erkennen, dass der Aktor ab ca. \SI{1-2}{mm} nicht mehr beschleunigt, sondern leicht abgebremst wird.\\
Mit der erreichten stationären Genauigkeit sind die Bedingungen für eine erfolgreiche Implementierung eines Haltereglers erfüllt. Dabei wird der Positionsregler durch einen anderen Regler abgelöst, sobald die Position das Toleranzband für eine bestimme Zeit nicht mehr verlässt. Die Aufgabe des neuen Reglers besteht dann lediglich darin die Postion zu halten, bis ein neuer Schaltbefehl erfolgt. Hauptproblem für diesen Regler ist der Haftgleiteffekt, welcher auf der Tatsache beruht, dass der Haftreibungskoeffizient größer als der Gleitreibungskoeffizient ist \cite{F.P.Bowden2001}. 

\begin{figure} [H]
	\centering
	
	\caption{Position, Regelabweichung und Stellgröße für das Schalten in Gang 2}
	\label{fig:shift_gear2}
\end{figure}

\begin{figure} [H]
	\centering
	
	\caption{Position, Regelabweichung und Stellgröße für das Schalten in Neutral}
	\label{fig:shift_toneutral}
\end{figure}

\subsection{Schaltgabelkraft am Anschlag}\label{schaltgabelkraft}
In \autoref{fig:aktor_anschlag} ist ein Schaltvorgang von Neutral in Gang 2 und die zugehörige Strommessung des Aktors aufgetragen. Zu sehen ist, dass beim Erreichen der Sollgröße zum Zeitpunkt $t$ = \SI{0,1316}{s} nur etwa \SI{0,1}{A} im Aktor fließt. Das bedeutet, dass die Lorentzkraft der Spule auf den Läufer gemäß \autoref{eq:lorentz} keine nennenswerte Kraft auf den Aktor ausübt. Somit wirkt auf den Läufer zu diesem Zeitpunkt fast ausschließlich die Kraft aufgrund seiner Massenträgheit. Nach dem Übertreten des Läufers der Sollposition reagiert die Regelung durch Gegenbestromung, sodass die Massenträgheit durch die Lorentzkraft gebremst wird und der Läufer in Richtung Sollposition gebracht wird. Die Anschlagskraft wird somit minimiert.

\begin{figure} [H]
	\centering
	
	\caption{Strommessung im Schaltvorgang von Neutral in Gang 2}
	\label{fig:aktor_anschlag}
\end{figure}

\section{Analyse des Stellsignals}\label{sec:analyse_stellsignal}
In \autoref{fig:spannungsverlaeufe} sind die Spannungsabfälle an den Aktorklemmen bei verschiedenen PWM-Signalen dargestellt. Zusätzlich ist der jeweils zugehörige Spannungsverlauf der Versorgungsspannung der Platine aufgetragen. Zu sehen ist, dass die Spannung der Batterie immer sinkt, sobald die H-Brücken die Spannung an den Aktor durchschaltet und anschließend wieder steigt. Diese Schwankung ist für größer werdende PWM-Signale aufgrund des steigenden Stroms ausgeprägter. Neben den zu beobachtbaren Schwankungen, fällt auch das Gesamtniveau der Batteriespannung für steigende PWM-Signale. Bei einem PWM-Signal von \SI{30}{\%} beträgt die Versorgungsspannung noch ca. \SI{13}{V} im durchgeschalteten Zustand, während sie bei \SI{70}{\%} nur noch \SI{10,5}{V} beträgt. Die Spannung am Aktor und die anliegende Batteriespannung weisen in allen drei Fällen im durchgeschalteten Zustand lediglich eine geringe Differenz auf, woraus gefolgert werden kann, dass in diesem Zustand die H-Brücke einen minimalen Widerstand bzw. einen sehr hohen Wirkungsgrad aufweist. Werden die gemessenen Spannungsverläufe über eine Periode (\SI{62,5}{\mu s}) integriert und anschließend mit dem nach \autoref{fig:Strommessung} nahezu konstant geflossenen Strom multipliziert, ergibt sich die dem Aktor zugeführte Leistung. Für $\text{PWM}=\SI{30}{\%}$ beträgt diese \SI{25,86}{W}, für $\text{PWM}=\SI{50}{\%}$ \SI{64,32}{W} und für $\text{PWM}=\SI{70}{\%}$ \SI{104,96}{W}. Dies entspricht lediglich einer Annäherung, da die minimale Stromwelligkeit aus \autoref{fig:Simulationsergebnisse} vernachlässigt wird und der Strom als konstant angenommen wird.
Auch die \textit{slew rate} lässt sich durch den Spannungsverlauf des Aktors ermitteln. Diese bestimmt sich aus dem Quotient des Spannungsdifferenz und der dafür benötigten Zeit. In allen drei Fällen resultiert eine \textit{slew rate} von ca. \SI{5}{V/\mu s}. Das ermittelte Verhalten entspricht den Erwartungen.

\begin{figure} [h]
	\centering
	
	\caption{Spannungsverläufe an Aktor und Quelle für verschiedene PWM-Signale}
	\label{fig:spannungsverlaeufe}
\end{figure} \noindent
