malbreitenbach/adp_tauchspulenelektronik/Ausarbeitung/ADP_ausarbeitung/input/Erklaerung.tex

\chapter*{Erklärung}
Hiermit versichern wir, die vorliegende Projektarbeit ohne Hilfe Dritter nur mit den
angegebenen Quellen und Hilfsmitteln angefertigt zu haben. Alle Stellen, die den
Quellen entnommen wurden, sind als solche kenntlich gemacht worden. Diese
Arbeit hat in gleicher oder ähnlicher Form noch keiner Prüfungsbehörde vorgelegen.\\
Wir sind damit einverstanden, dass das Urheberrecht an unserer Arbeit zu wissenschaftlichen Zwecken genutzt und in Veröffentlichungen zitiert werden kann.

\begin{center}
\setlength{\unitlength}{1cm}
\vspace{2.5cm} 
\begin{picture}(10, 0.1)(0,0)
\linethickness{0.5pt}
\put(0,0){\line(1,0){10}}
\end{picture} \\
\end{center}
\hspace{4cm}Ort, Datum
 
\begin{minipage}{0.5\textwidth}
\centering
\setlength{\unitlength}{1cm}
\vspace{2.5cm} 
\begin{picture}(7, 0.1)(0,0)
\linethickness{0.5pt}
\put(0,0){\line(1,0){7}}
\end{picture} \\
\raggedright
\hspace{1cm}Unterschrift (Malte Breitenbach)
\end{minipage}
\begin{minipage}{0.5\textwidth}
\centering
\setlength{\unitlength}{1cm}
\vspace{2.5cm} 
\begin{picture}(7, 0.1)(0,0)
\linethickness{0.5pt}
\put(0,0){\line(1,0){7}}
\end{picture} \\
\raggedright
\hspace{1cm}Unterschrift (Johannes Faupel)
\end{minipage}

\begin{minipage}{0.5\textwidth}
\centering
\setlength{\unitlength}{1cm}
\vspace{2.5cm} 
\begin{picture}(7, 0.1)(0,0)
\linethickness{0.5pt}
\put(0,0){\line(1,0){7}}
\end{picture} \\
\raggedright
\hspace{1cm}Unterschrift (Jonas Tautz)
\end{minipage}
\begin{minipage}{0.5\textwidth}
\centering
\setlength{\unitlength}{1cm}
\vspace{2.5cm} 
\begin{picture}(7, 0.1)(0,0)
\linethickness{0.5pt}
\put(0,0){\line(1,0){7}}
\end{picture} \\
\raggedright
\hspace{1cm}Unterschrift (Johanna Vetter)
\end{minipage}
\newpage
