malbreitenbach/adp_tauchspulenelektronik/Ausarbeitung/ADP_ausarbeitung/Bilder/Ausgangslage.pdf

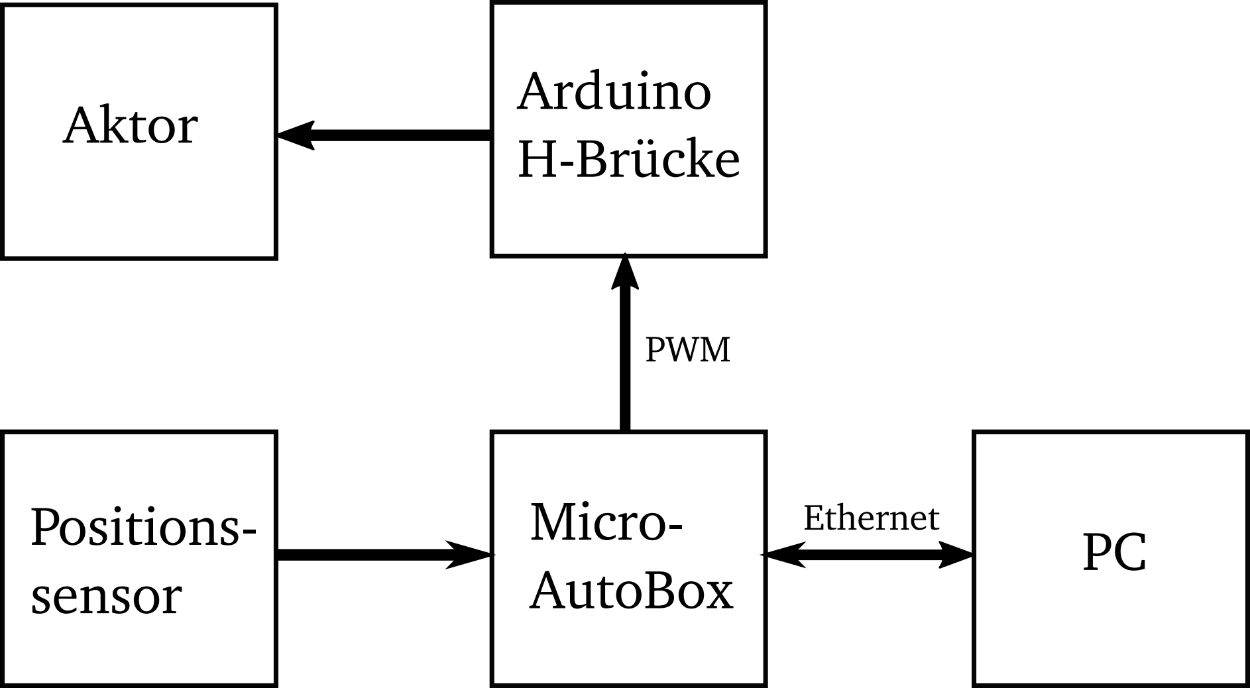
[picture p101: figure]
Aktor; Arduino; H-Brücke; Positions- sensor; Micro- AutoBox; Ethernet; PWM
