malbreitenbach/adp_tauchspulenelektronik/Ausarbeitung/ADP_ausarbeitung/Bilder/fig_pwm.pdf

CONS_PWM_Control
CAL_PWM_Calibration
MAIN_PWM_Select

MAX_PWM

PWM

PWMS

CONH_PWM_Control
