malbreitenbach/adp_tauchspulenelektronik/Ausarbeitung/ADP_ausarbeitung/Bilder/fig_toolchain.pdf

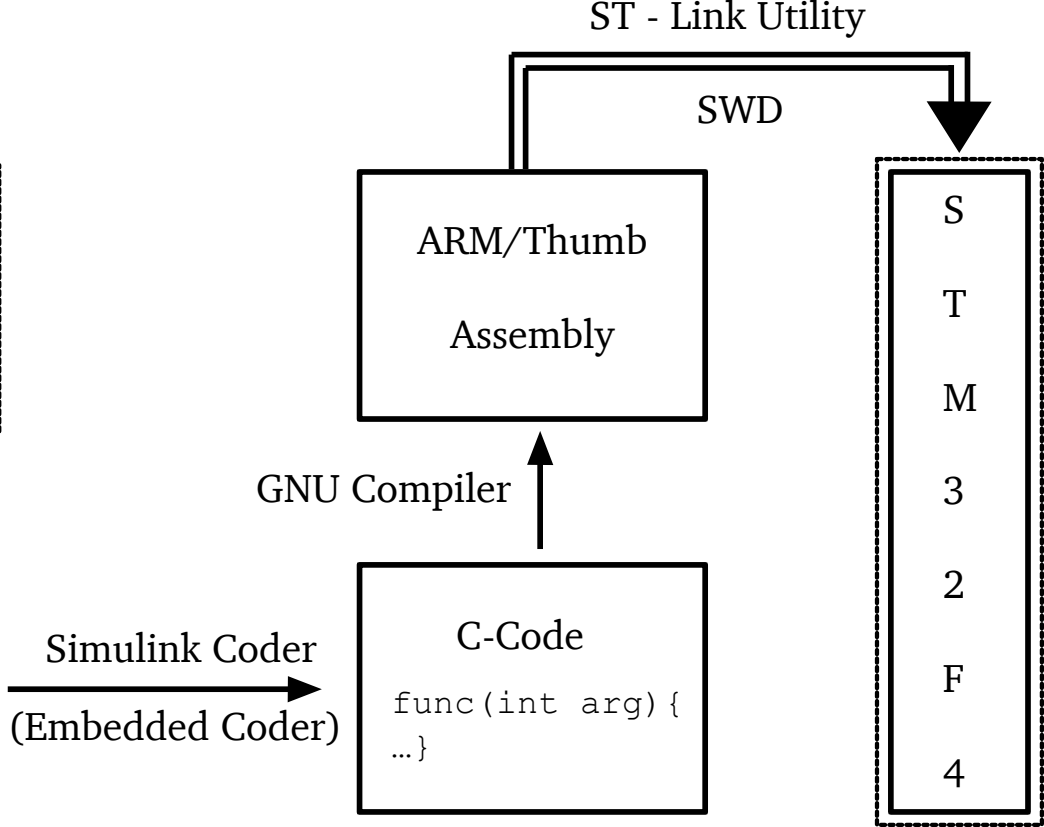
[picture p102: figure]
func(int arg){ …}; C-Code Simulink Coder; (Embedded Coder); ARM/Thumb; Assembly; GNU Compiler; SWD; ST - Link Utility
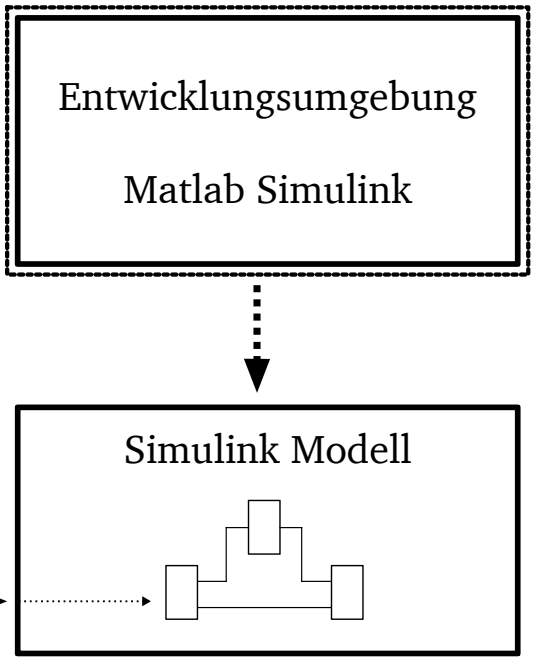
[picture p103: figure]
Entwicklungsumgebung; Matlab Simulink; Simulink Modell

Wajung

Blockset
