malbreitenbach/adp_tauchspulenelektronik/Ausarbeitung/ADP_ausarbeitung/Bilder/Schaltgabelregelung.pdf

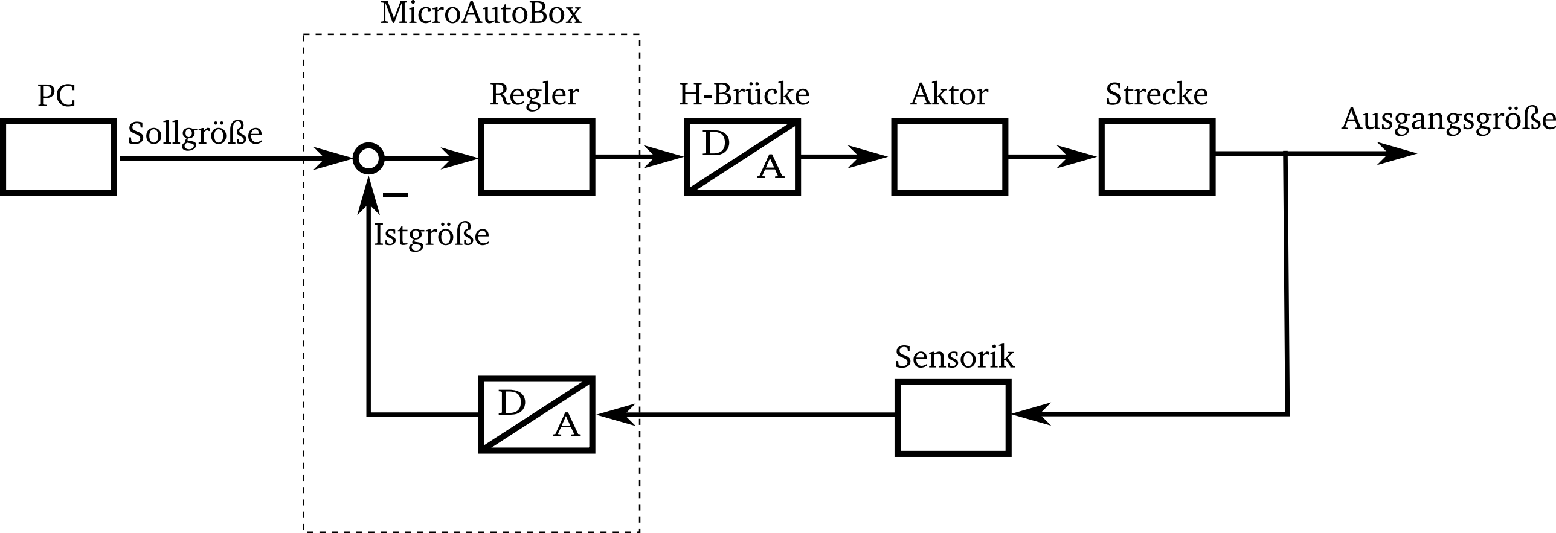
[picture p104: figure]
Regler; H-Brücke; Aktor; Strecke; Sensorik; - Ausgangsgröße; Istgröße; Sollgröße; MicroAutoBox
