malbreitenbach/adp_tauchspulenelektronik/Ausarbeitung/ADP_ausarbeitung/Bilder/Strommessung.pdf

-80 | -60-100 | -40 | -20 | 0 | 20 | 40 | 60 | 80 | 100
PWM in %

mit Leitungsverstärker

ohne Leitungsverstärker

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
Strom in A
