malbreitenbach/adp_tauchspulenelektronik/Ausarbeitung/ADP_ausarbeitung/Bilder/CAN.pdf

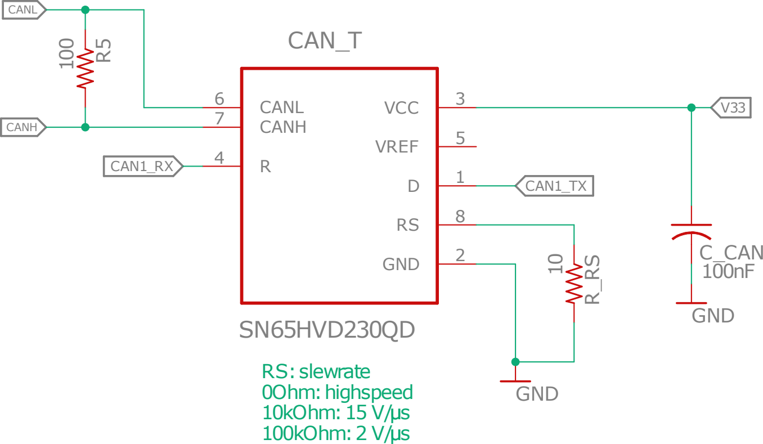
[picture p105: figure]
SN65HVD230QD; GND; VCC; VREF; CANL; CANH; CAN_T; C_CAN; CAN1_RX; CAN1_TX; RS: slewrate 0Ohm: highspeed 10kOhm: 15 V/uµs 100kOhm: 2 V/uµs
