malbreitenbach/adp_tauchspulenelektronik/Ausarbeitung/ADP_ausarbeitung/Bilder/fig_arch.pdf

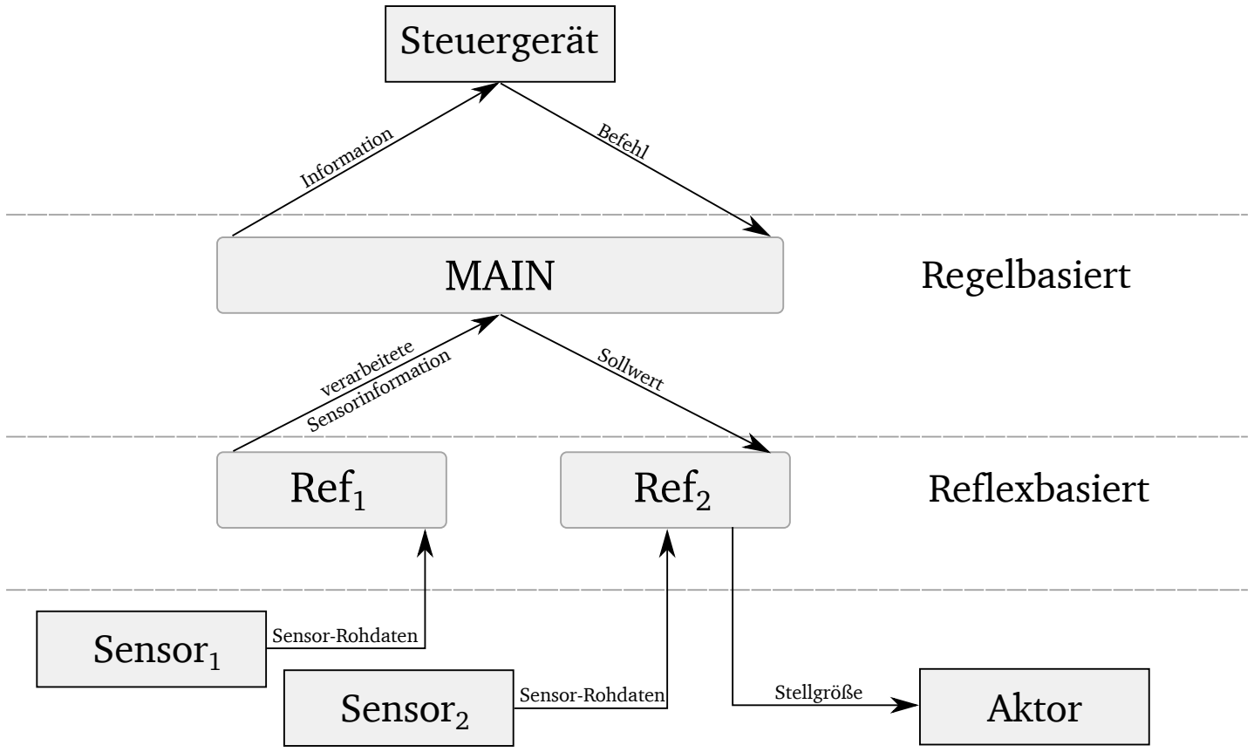
[picture p106: figure]
Ref1; Ref2; MAIN; Regelbasiert; Reflexbasiert; verarbeitete Sensorinformation; Sensor-Rohdaten; Stellgröße; Sensor1; Aktor; Sollwert; Steuergerät; Befehl; Information; Sensor-Rohdaten Sensor2
