malbreitenbach/adp_tauchspulenelektronik/Ausarbeitung/ADP_ausarbeitung/Bilder/fig_can_ov.pdf

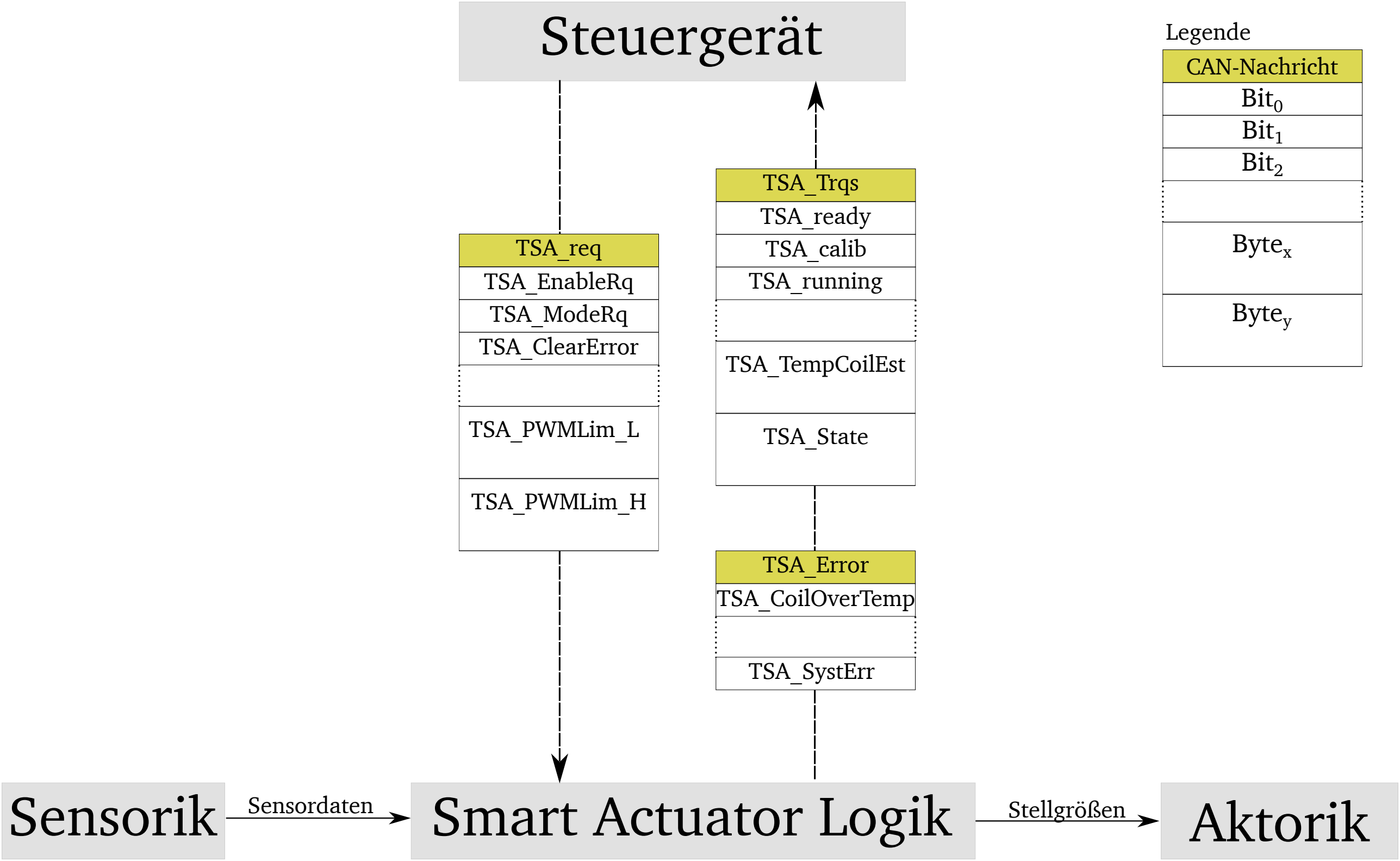
[picture p107: figure]
Steuergerät; Sensorik; Smart Actuator Logik; Aktorik; TSA_Trqs; TSA_ready TSA_calib TSA_running; TSA_TempCoilEst; TSA_State; TSA_Error; TSA_CoilOverTemp; TSA_SystErr; TSA_req; TSA_EnableRq TSA_ModeRq TSA_ClearError; TSA_PWMLim_L; TSA_PWMLim_H; Sensordaten; Stellgrößen; CAN-Nachricht Bit0 Bit1 Bit2; Bytex; Bytey; Legende
