malbreitenbach/adp_tauchspulenelektronik/Ausarbeitung/ADP_ausarbeitung/Bilder/fig_ther_elek.pdf

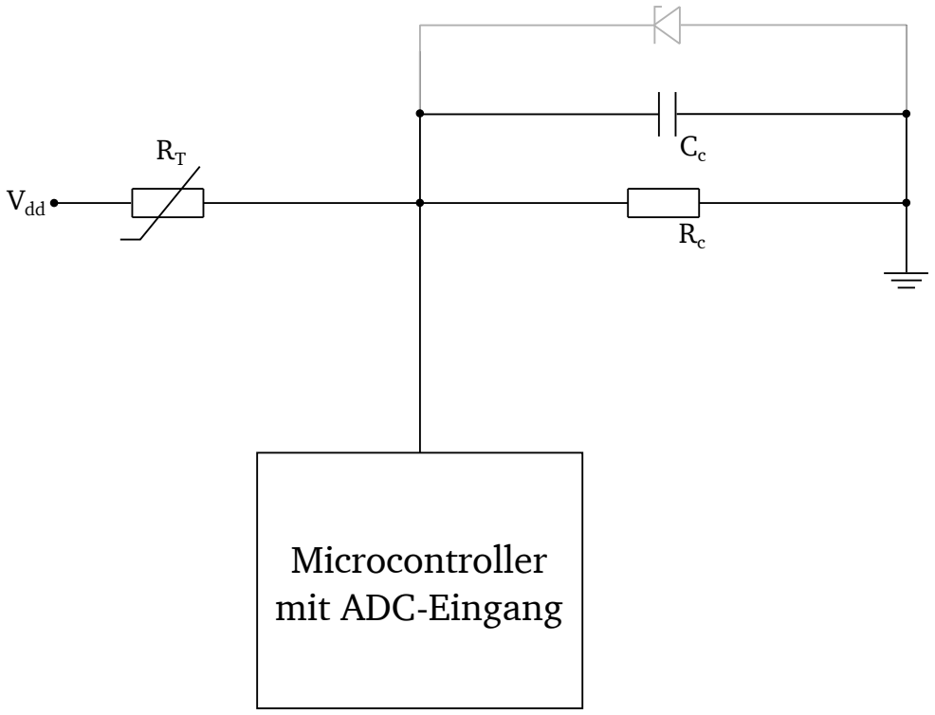
[picture p108: figure]
Vdd; Microcontroller mit ADC-Eingang
