malbreitenbach/adp_tauchspulenelektronik/Platinenentwurf/weitere_bauteile/STM32F405RGTx_PINout.xlsx

Aufgaben
CAN zu Autobox | CAN1_RX | CAN1_TX
H-Brücke | H_IN2 | H_IN1 | H_Enable
Stromsensor | H-Stromsensor1 | H-Stromsensor2
Spannungssensor | U_Sensor (12V)
Lagesensor | 5V | GND | L_Analog1 | L_Analog2
Temperatursensor | Temp_AN | 5V
Zusatzsensorik | Zusatzsensor_AN
USART | USART2_TX | USART2_RX
Peripherien
Timer | Aufgabe |  | ADC | Aufgabe |  |  |  | CAN | Aufgabe | USART | Aufgabe
TIM1 | Temperatur |  | ADC1 | Position_Sensor |  |  |  | CAN1 | Verb. Zu Autobox | USART1
TIM2 | H_PWM |  | ADC2 | H-Stromsensor (2x) | U_Sensor (12V) |  |  | CAN2 |  | USART2 | Verb. PC
TIM3 |  |  | ADC3 | Zusatzsensor_AN | Temp_AN |  |  |  |  | USART3
TIM4 |  |  |  |  |  |  |  |  |  | USART4
TIM5 |  |  |  |  |  |  |  |  |  | USART5
TIM6 |  |  |  |  |  |  |  |  |  | USART6
TIM7
TIM8
TIM9
TIM10
TIM11
TIM12
TIM13
TIM14
PIN OUT
Port A |  |  | Port B |  |  | Port C |  | Port D |  | Port H
PA0 | L_Analog2 [L_2] |  | PB0 | H-Stromsensor1 |  | PC0 |  | PD2 |  | PH0 | OSC_IN
PA1 | L_Analog1 [L_1] |  | PB1 | H-Stromsensor2 |  | PC1 |  |  |  | PH1 | OSC_OUT
PA2 | USART2_TX [U_TX] |  | PB2 |  |  | PC2 | Zusatzsensor_AN [Z1]
PA3 | USART2_RX [U_RX] |  | PB3 | TRACESWO |  | PC3 | Temp_AN [T_1]
PA4 |  |  | PB4 |  |  | PC4 | H_Enable
PA5 |  |  | PB5 |  |  | PC5 | U_Sensor (12V)
PA6 |  |  | PB6 |  |  | PC6
PA7 |  |  | PB7 |  |  | PC7
PA8 |  |  | PB8 |  |  | PC8
PA9 |  |  | PB9 |  |  | PC9
PA10 |  |  | PB10 | H_IN2 |  | PC10
PA11 | CAN1_RX |  | PB11 | H_IN1 |  | PC11
PA12 | CAN1_TX |  | PB12 |  |  | PC12
PA13 | SWDIO |  | PB13 |  |  | PC13
PA14 | SWDCLK |  | PB14 |  |  | PC14
PA15 |  |  | PB15 |  |  | PC15
