malbreitenbach/adp_tauchspulenelektronik/Ausarbeitung/ADP_ausarbeitung/TUDreport.pdf

# Die fabelhaften Benner-Boys präsentieren stolz das TUD-

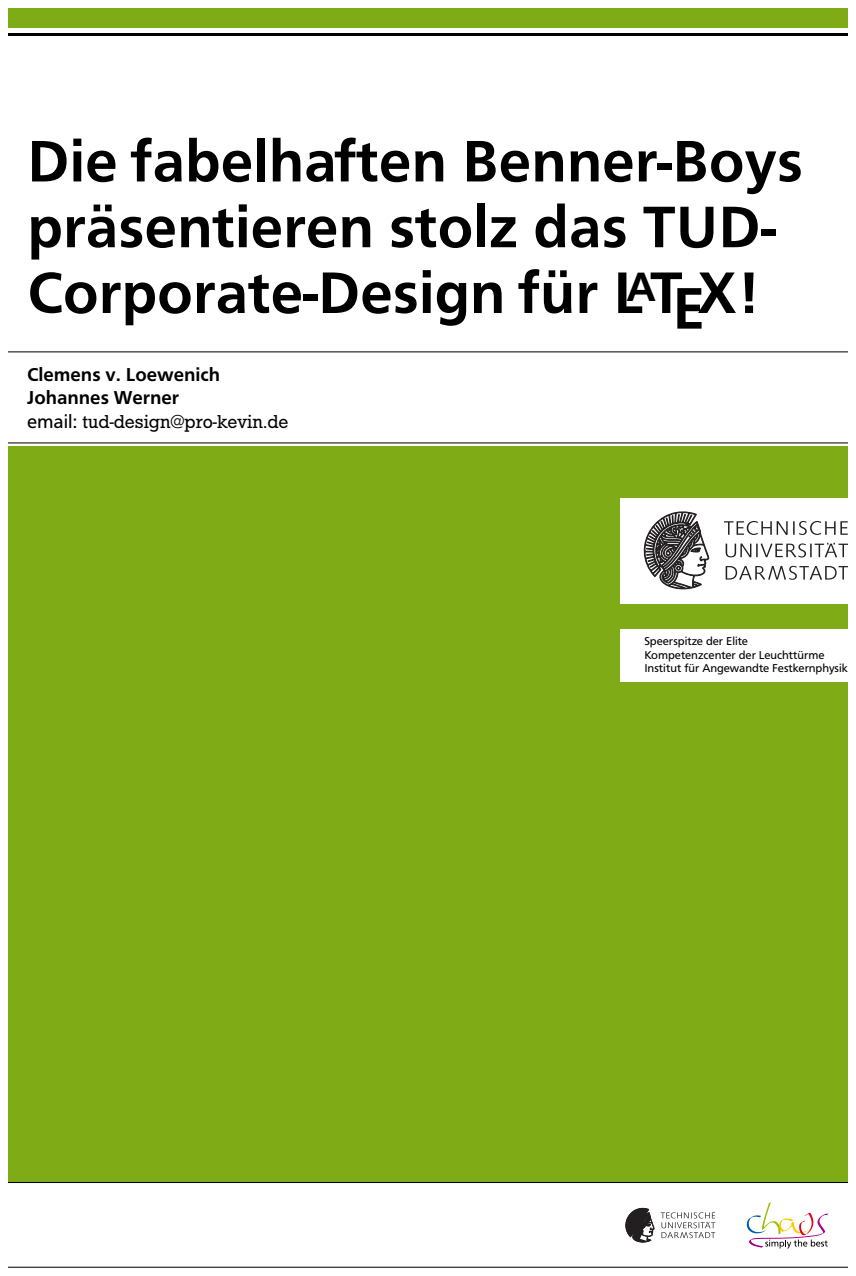
[picture p109: page 1]

Corporate-Design für LATEX!

Clemens v. Loewenich
Johannes Werner
email: tud-design@pro-kevin.de

Speerspitze der Elite
Kompetenzcenter der Leuchttürme
Institut für Angewandte Festkernphysik

## (\uppertitleback)

(\lowertitleback) | 2. März 2019

Hier ist genügend Platz
für eine Widmung (\dedication).

Für Annelore Schmidt
aus dem Referat Kommunikation. Sie hat immer ein offenes Ohr für unsere Fragen und Anregungen.

# Zusammenfassung

Lorem ipsum dolor sit amet, consectetuer adipiscing elit. Sed vitae ligula. Integer pharetra ornare eros. Phasellus vitae magna eget metus iaculis consectetuer. Lorem ipsum dolor sit amet, consectetuer adipiscing elit. Ut fringilla, elit id bibendum pharetra, enim nunc commodo lacus, vel consequat pede elit et massa. Nullam ac neque vel dui sodales malesuada. Phasellus sit amet magna. Nulla nisl metus, dictum et, ultricies vel, vestibulum ut, sem. Nulla nulla felis, gravida non, feugiat eget, interdum non, urna. Nunc nulla nunc, placerat pretium, varius in, dignissim a, eros. Quisque consequat, leo sit amet adipiscing pellentesque, nisl elit iaculis ipsum, quis tincidunt purus risus pulvinar enim. Nulla laoreet. Cras ullamcorper libero eget velit. Nam vel enim id tortor dignissim egestas. Pellentesque mi quam, porttitor sed, nonummy in, semper vitae, nisl. Duis ut dolor ut sem auctor dapibus. Nulla urna pede, facilisis a, hendrerit non, tincidunt vitae, orci. Mauris tincidunt posuere magna. Fusce blandit.

3

# Inhaltsverzeichnis

I. Lorem Ipsum (\part) | 7
1 Lorem Ipsum (\chapter) | 9
2 Interldum volgus (\chapter) | 19
Danksagung (\chapter*) | 23
Abbildungsverzeichnis | 25

5

Teil I.

# Lorem Ipsum (\part)

7

# 1 Lorem Ipsum (\chapter)

Lorem ipsum dolor sit amet, consectetuer adipiscing elit. Sed vitae ligula. Integer pharetra ornare eros. Phasellus vitae magna eget metus iaculis consectetuer. Lorem ipsum dolor sit amet, consectetuer adipiscing elit. Ut fringilla, elit id bibendum pharetra, enim nunc commodo lacus, vel consequat pede elit et massa. Nullam ac neque vel dui sodales malesuada. Phasellus sit amet magna. Nulla nisl metus, dictum et, ultricies vel, vestibulum ut, sem. Nulla nulla felis, gravida non, feugiat eget, interdum non, urna. Nunc nulla nunc, placerat pretium, varius in, dignissim a, eros. Quisque consequat, leo sit amet adipiscing pellentesque, nisl elit iaculis ipsum, quis tincidunt purus risus pulvinar enim. Nulla laoreet. Cras ullamcorper libero eget velit. Nam vel enim id tortor dignissim egestas. Pellentesque mi quam, porttitor sed, nonummy in, semper vitae, nisl. Duis ut dolor ut sem auctor dapibus. Nulla urna pede, facilisis a, hendrerit non, tincidunt vitae, orci. Mauris tincidunt posuere magna. Fusce blandit.
Sed ac sapien. Phasellus diam pede, facilisis at, faucibus vel, semper eu, diam. Morbi eleifend. Curabitur mattis ipsum sit amet purus. Fusce vel dui non ante sagittis consequat. Aliquam eget elit sed tellus euismod fermentum. Nullam sit amet dui vulputate ipsum volutpat molestie. Fusce vehicula tincidunt diam. Sed in nisi. Proin sit amet sem ut lacus mollis laoreet. Proin adipiscing dignissim justo. Sed id eros sit amet metus pretium rutrum. Etiam ultrices orci vitae lectus. Nullam auctor dignissim diam. Nullam mattis dictum tortor.
Praesent justo augue, consequat ac, placerat gravida, ornare vitae, libero. Aliquam erat volutpat. Class aptent taciti sociosqu ad litora torquent per conubia nostra, per inceptos hymenaeos. Vestibulum ante ipsum primis in faucibus orci luctus et ultrices posuere cubilia Curae; Donec sodales, odio in volutpat consectetuer, neque neque lobortis mi, quis sagittis felis neque ut ipsum. Nullam nonummy, ligula eget fermentum lobortis, dui dolor congue est, scelerisque cursus pede nibh sit amet felis. Proin malesuada placerat libero. Aliquam bibendum sollicitudin quam. In quis risus quis leo pretium luctus. Vestibulum enim. Lorem ipsum dolor sit amet, consectetuer adipiscing elit. Proin vitae metus a dui venenatis commodo. Sed eu lacus. Pellentesque et lorem. Ut ut libero vel tellus rutrum varius.

Kf l =

λτ

## 2(−χ⁰τ)

(1 + R) | (1.1)
Kho | =

λτ

## 2(−χ⁰τ)

(1 + R)

1 +

∆Ωhoτ

λτ 2
(1.2)

λτ =

∆Ωho τ
tan ∆Ωho τ
2

·

(1 + R)
(1 − R)

(1.3)

Nulla fermentum convallis nisi.Ut lectus. Praesent pharetra erat porta magna. Nulla vestibulum eleifend velit (1.1). Integer odio. Nam ac dui. Sed auctor, arcu id pharetra pulvinar, dui purus imperdiet tortor, ut egestas ipsum augue nec justo. Cras eu nisl eu urna euismod faucibus. Quisque interdum rhoncus ipsum. Ut libero. Cras ante. Vestibulum ante ipsum primis in faucibus orci luctus et ultrices posuere cubilia Curae; Nam imperdiet nisl ac eros. Suspendisse hendrerit, pede nec condimentum ultricies, turpis elit fermentum dui, quis cursus magna nunc eget nisi. Cras porta nulla non ligula. Maecenas orci felis, ultrices quis, scelerisque nec, mollis at, libero. Mauris lectus urna, lacinia eu, tincidunt non, vehicula a, mi. Sed euismod faucibus ligula. Mauris eu libero. Duis ante lectus, pulvinar in, gravida a, sagittis in, odio.
Proin ornare, lorem id placerat dapibus, nunc libero tristique arcu, eu cursus (1.2) nisl turpis eu est. Sed ut sem nec ligula ornare venenatis. Sed sapien. Aliquam erat volutpat. Aliquam scelerisque scelerisque lacus. Phasellus elit ipsum, dapibus viverra, ullamcorper id, ultricies in, lorem. Nam porta pede vitae nisl. Nulla non felis nec eros porttitor tempor. Nunc ligula quam, pretium quis, ultricies ut, lacinia sit amet, leo. Morbi nonummy lectus vel orci. Sed pede arcu, molestie vitae, tristique in, adipiscing imperdiet, massa. Quisque lacinia erat id metus. Nam tristique malesuada erat. Mauris urna. Praesent scelerisque sem a mi. Pellentesque habitant morbi tristique senectus et netus et malesuada fames ac turpis egestas. Suspendisse vitae dui.
Quisque odio. Ut eget justo ut velit consequat auctor. Curabitur diam (1.3). Suspendisse ullamcorper venenatis purus. Praesent aliquet nunc ut magna. Nulla dignissim fermentum dolor. Nullam in orci rutrum lectus facilisis scelerisque. Integer elementum mi eget elit. Nulla volutpat lorem vel leo. Nam egestas. Donec imperdiet auctor pede. Praesent lobortis mi a metus. Aenean fringilla ante a libero. Aenean consequat, lorem ut scelerisque volutpat, nisi massa tincidunt justo, vel aliquam dolor pede quis nibh. Phasellus vehicula aliquet nibh.
Maecenas et mi nec elit ornare euismod. Mauris elit nisi, faucibus ac, semper quis, ullamcorper vel, augue. Nunc ligula. Duis eu nibh. Vestibulum egestas, nisi sed pharetra pellentesque, elit nibh aliquet arcu, eu lacinia massa lectus id mi. Nulla diam. Vestibulum fermentum rutrum augue. Vestibulum nunc sapien, euismod vitae, lacinia eget, accumsan id, lacus. Class aptent taciti sociosqu ad litora torquent per conubia nostra, per inceptos hymenaeos. Duis nec mauris

9

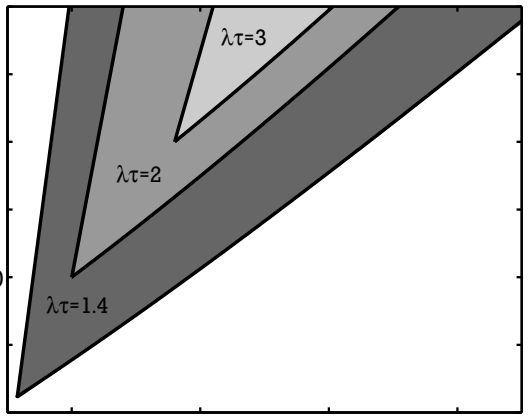
[picture p110: figure]

1 | 2 | 3 | 4

−0.2

−0.1

0

0.1

0.2

0.3

0.4

### (−χτ)K

R

Abbildung 1.1.: Lorem ipsum dolor sit amet, consectetuer adipiscing elit. Sed vitae ligula. Integer pharetra ornare eros. Phasellus vitae magna eget metus iaculis consectetuer. Lorem ipsum dolor sit amet, consectetuer adipiscing elit.

eget urna cursus dapibus. Donec sed neque at metus pretium tincidunt. Integer eget enim eget est interdum dignissim. Vestibulum ante ipsum primis in faucibus orci luctus et ultrices posuere cubilia Curae; Ut erat. Vivamus fringilla justo non libero. Donec lectus est, porttitor nec, posuere et, convallis ac, pede. Cras mi mauris, aliquam a, aliquet eget, elementum ut, velit. Morbi posuere blandit turpis. Aenean cursus.
Proin mattis. Maecenas egestas. Nunc id justo non pede ornare molestie. Aliquam egestas tincidunt magna. Sed tempus tincidunt erat. Cras pharetra varius libero. Curabitur porttitor. Suspendisse potenti. Donec bibendum. Curabitur dignissim neque. Nam sit amet odio. Nulla ligula tortor, fermentum vel, ornare nec, vulputate vel, enim. Nullam sit amet nisl eget dui placerat porta. Donec leo. Nullam dignissim ullamcorper felis. Cras vulputate urna vehicula nibh.
Praesent feugiat, urna eu laoreet porttitor, odio dolor blandit erat, vitae facilisis orci massa sit amet tortor. Donec orci. Ut fringilla ultricies nisl. Aliquam eu dui ut erat bibendum molestie. Maecenas porttitor. Nam ut mauris. Etiam egestas elit a neque. Proin sed eros. Nullam et ipsum. Mauris ut lectus. Quisque tristique ipsum auctor ligula. Pellentesque semper sagittis neque. Nullam sed enim.¹
Cras tempor ligula. Sed egestas sem eu elit dignissim condimentum. Suspendisse velit. Suspendisse iaculis magna vitae elit. Mauris dignissim porttitor magna. Duis nec tortor non velit ultrices iaculis. Aenean enim ante, elementum sit amet, lacinia non, porta nec, quam. Sed bibendum accumsan tortor. Vestibulum vitae mauris in dolor tincidunt eleifend. Vestibulum ante ipsum primis in faucibus orci luctus et ultrices posuere cubilia Curae; Nunc libero sapien, condimentum quis, egestas quis, cursus id, dolor. Fusce dolor lectus, egestas quis, ullamcorper ac, dictum in, nibh.²

1.1 Lorem Ipsum (\section)

Lorem ipsum dolor sit amet, consectetuer adipiscing elit. Sed vitae ligula. Integer pharetra ornare eros. Phasellus vitae magna eget metus iaculis consectetuer. Lorem ipsum dolor sit amet, consectetuer adipiscing elit. Ut fringilla, elit id bibendum pharetra, enim nunc commodo lacus, vel consequat pede elit et massa. Nullam ac neque vel dui sodales malesuada. Phasellus sit amet magna. Nulla nisl metus, dictum et, ultricies vel, vestibulum ut, sem. Nulla nulla felis, gravida non, feugiat eget, interdum non, urna. Nunc nulla nunc, placerat pretium, varius in, dignissim a, eros. Quisque consequat, leo sit amet adipiscing pellentesque, nisl elit iaculis ipsum, quis tincidunt purus risus pulvinar enim. Nulla laoreet. Cras ullamcorper libero eget velit. Nam vel enim id tortor dignissim egestas. Pellentesque mi quam, porttitor sed, nonummy in, semper vitae, nisl. Duis ut dolor ut sem auctor dapibus. Nulla urna pede, facilisis a, hendrerit non, tincidunt vitae, orci. Mauris tincidunt posuere magna. Fusce blandit.³
Sed ac sapien. Phasellus diam pede, facilisis at, faucibus vel, semper eu, diam. Morbi eleifend. Curabitur mattis ipsum sit amet purus. Fusce vel dui non ante sagittis consequat. Aliquam eget elit sed tellus euismod fermentum. Nullam sit
1 | T. Pratchett: ”A guess? Well, that’s good enough for physics!“
2 | Sed ac sapien. Phasellus diam pede, facilisis at, faucibus vel, semper eu, diam. Morbi eleifend. Curabitur mattis ipsum sit amet purus. Fusce
| vel dui non ante sagittis consequat. Aliquam eget elit sed tellus euismod fermentum. Nullam sit amet dui vulputate ipsum volutpat molestie. Fusce vehicula tincidunt diam. Sed in nisi. Proin sit amet sem ut lacus mollis laoreet. Proin adipiscing dignissim justo.
3 | If UNIX isn’t the solution, you’ve got the wrong problem.
10 | 1. Lorem Ipsum (\chapter)

amet dui vulputate ipsum volutpat molestie. Fusce vehicula tincidunt diam. Sed in nisi. Proin sit amet sem ut lacus mollis laoreet. Proin adipiscing dignissim justo. Sed id eros sit amet metus pretium rutrum. Etiam ultrices orci vitae lectus. Nullam auctor dignissim diam. Nullam mattis dictum tortor. 4
Praesent justo augue, consequat ac, placerat gravida, ornare vitae, libero. Aliquam erat volutpat. Class aptent taciti sociosqu ad litora torquent per conubia nostra, per inceptos hymenaeos. Vestibulum ante ipsum primis in faucibus orci luctus et ultrices posuere cubilia Curae; Donec sodales, odio in volutpat consectetuer, neque neque lobortis mi, quis sagittis felis neque ut ipsum. Nullam nonummy, ligula eget fermentum lobortis, dui dolor congue est, scelerisque cursus pede nibh sit amet felis. Proin malesuada placerat libero. Aliquam bibendum sollicitudin quam. In quis risus quis leo pretium luctus. Vestibulum enim. Lorem ipsum dolor sit amet, consectetuer adipiscing elit. Proin vitae metus a dui venenatis commodo. Sed eu lacus. Pellentesque et lorem. Ut ut libero vel tellus rutrum varius.
| | Kf l | =

λτ

## 2(−χ⁰τ)

(1 + R) | (1.4)
| | Kho | =

λτ

## 2(−χ⁰τ)

(1 + R)

1 +

∆Ωhoτ

λτ 2
(1.5)

λτ =

∆Ωho τ
tan ∆Ωho τ
| | | 2

·

(1 + R)
(1 − R)

(1.6)

Nulla fermentum convallis nisi. Ut lectus. Praesent pharetra erat porta magna. Nulla vestibulum eleifend velit. Integer odio. Nam ac dui. Sed auctor, arcu id pharetra pulvinar, dui purus imperdiet tortor, ut egestas ipsum augue nec justo. Cras eu nisl eu urna euismod faucibus. Quisque interdum rhoncus ipsum. Ut libero. Cras ante. Vestibulum ante ipsum primis in faucibus orci luctus et ultrices posuere cubilia Curae; Nam imperdiet nisl ac eros. Suspendisse hendrerit, pede nec condimentum ultricies, turpis elit fermentum dui, quis cursus magna nunc eget nisi. Cras porta nulla non ligula. Maecenas orci felis, ultrices quis, scelerisque nec, mollis at, libero. Mauris lectus urna, lacinia eu, tincidunt non, vehicula a, mi. Sed euismod faucibus ligula. Mauris eu libero. Duis ante lectus, pulvinar in, gravida a, sagittis in, odio.
Proin ornare, lorem id placerat dapibus, nunc libero tristique arcu, eu cursus nisl turpis eu est. Sed ut sem nec ligula ornare venenatis. Sed sapien. Aliquam erat volutpat. Aliquam scelerisque scelerisque lacus. Phasellus elit ipsum, dapibus viverra, ullamcorper id, ultricies in, lorem. Nam porta pede vitae nisl. Nulla non felis nec eros porttitor tempor. Nunc ligula quam, pretium quis, ultricies ut, lacinia sit amet, leo. Morbi nonummy lectus vel orci. Sed pede arcu, molestie vitae, tristique in, adipiscing imperdiet, massa. Quisque lacinia erat id metus. Nam tristique malesuada erat. Mauris urna. Praesent scelerisque sem a mi. Pellentesque habitant morbi tristique senectus et netus et malesuada fames ac turpis egestas. Suspendisse vitae dui.
Quisque odio. Ut eget justo ut velit consequat auctor. Curabitur diam. Suspendisse ullamcorper venenatis purus. Praesent aliquet nunc ut magna. Nulla dignissim fermentum dolor. Nullam in orci rutrum lectus facilisis scelerisque. Integer elementum mi eget elit. Nulla volutpat lorem vel leo. Nam egestas. Donec imperdiet auctor pede. Praesent lobortis mi a metus. Aenean fringilla ante a libero. Aenean consequat, lorem ut scelerisque volutpat, nisi massa tincidunt justo, vel aliquam dolor pede quis nibh. Phasellus vehicula aliquet nibh.
Maecenas et mi nec elit ornare euismod. Mauris elit nisi, faucibus ac, semper quis, ullamcorper vel, augue. Nunc ligula. Duis eu nibh. Vestibulum egestas, nisi sed pharetra pellentesque, elit nibh aliquet arcu, eu lacinia massa lectus id mi. Nulla diam. Vestibulum fermentum rutrum augue. Vestibulum nunc sapien, euismod vitae, lacinia eget, accumsan id, lacus. Class aptent taciti sociosqu ad litora torquent per conubia nostra, per inceptos hymenaeos. Duis nec mauris eget urna cursus dapibus. Donec sed neque at metus pretium tincidunt. Integer eget enim eget est interdum dignissim. Vestibulum ante ipsum primis in faucibus orci luctus et ultrices posuere cubilia Curae; Ut erat. Vivamus fringilla justo non libero. Donec lectus est, porttitor nec, posuere et, convallis ac, pede. Cras mi mauris, aliquam a, aliquet eget, elementum ut, velit. Morbi posuere blandit turpis. Aenean cursus.
Proin mattis. Maecenas egestas. Nunc id justo non pede ornare molestie. Aliquam egestas tincidunt magna. Sed tempus tincidunt erat. Cras pharetra varius libero. Curabitur porttitor. Suspendisse potenti. Donec bibendum. Curabitur dignissim neque. Nam sit amet odio. Nulla ligula tortor, fermentum vel, ornare nec, vulputate vel, enim. Nullam sit amet nisl eget dui placerat porta. Donec leo. Nullam dignissim ullamcorper felis. Cras vulputate urna vehicula nibh.
Praesent feugiat, urna eu laoreet porttitor, odio dolor blandit erat, vitae facilisis orci massa sit amet tortor. Donec orci. Ut fringilla ultricies nisl. Aliquam eu dui ut erat bibendum molestie. Maecenas porttitor. Nam ut mauris. Etiam egestas elit a neque. Proin sed eros. Nullam et ipsum. Mauris ut lectus. Quisque tristique ipsum auctor ligula. Pellentesque semper sagittis neque. Nullam sed enim.
Cras tempor ligula. Sed egestas sem eu elit dignissim condimentum. Suspendisse velit. Suspendisse iaculis magna vitae elit. Mauris dignissim porttitor magna. Duis nec tortor non velit ultrices iaculis. Aenean enim ante, elementum sit
4 | Calvin: ‘I like to verb words.’ | Hobbes: ‘What?’ | Calvin: ‘I take nouns and adjectives and use them as verbs. Remember when “access” was a
thing? Now it’s something you do. It got verbed. – Verbing wierds language.’ | Hobbes: ‘Maybe we can eventually make language a complete
impediment to understanding.’ (Calvin & Hobbes)
1.1. Lorem Ipsum (\section) | 11

1 | 2 | 3 | 4

−0.2

−0.1

0

0.1

0.2

0.3

0.4

### (−χτ)K

R

Abbildung 1.2.: Lorem ipsum dolor sit amet, consectetuer adipiscing elit. Sed vitae ligula. Integer pharetra ornare eros. Phasellus vitae magna eget metus iaculis consectetuer. Lorem ipsum dolor sit amet, consectetuer adipiscing elit.

amet, lacinia non, porta nec, quam. Sed bibendum accumsan tortor. Vestibulum vitae mauris in dolor tincidunt eleifend. Vestibulum ante ipsum primis in faucibus orci luctus et ultrices posuere cubilia Curae; Nunc libero sapien, condimentum quis, egestas quis, cursus id, dolor. Fusce dolor lectus, egestas quis, ullamcorper ac, dictum in, nibh.

1.1.1 Lorem Ipsum (\subsection)

Lorem ipsum dolor sit amet, consectetuer adipiscing elit. Sed vitae ligula. Integer pharetra ornare eros. Phasellus vitae magna eget metus iaculis consectetuer. Lorem ipsum dolor sit amet, consectetuer adipiscing elit. Ut fringilla, elit id bibendum pharetra, enim nunc commodo lacus, vel consequat pede elit et massa. Nullam ac neque vel dui sodales malesuada. Phasellus sit amet magna. Nulla nisl metus, dictum et, ultricies vel, vestibulum ut, sem. Nulla nulla felis, gravida non, feugiat eget, interdum non, urna. Nunc nulla nunc, placerat pretium, varius in, dignissim a, eros. Quisque consequat, leo sit amet adipiscing pellentesque, nisl elit iaculis ipsum, quis tincidunt purus risus pulvinar enim. Nulla laoreet. Cras ullamcorper libero eget velit. Nam vel enim id tortor dignissim egestas. Pellentesque mi quam, porttitor sed, nonummy in, semper vitae, nisl. Duis ut dolor ut sem auctor dapibus. Nulla urna pede, facilisis a, hendrerit non, tincidunt vitae, orci. Mauris tincidunt posuere magna. Fusce blandit.
Sed ac sapien. Phasellus diam pede, facilisis at, faucibus vel, semper eu, diam. Morbi eleifend. Curabitur mattis ipsum sit amet purus. Fusce vel dui non ante sagittis consequat. Aliquam eget elit sed tellus euismod fermentum. Nullam sit amet dui vulputate ipsum volutpat molestie. Fusce vehicula tincidunt diam. Sed in nisi. Proin sit amet sem ut lacus mollis laoreet. Proin adipiscing dignissim justo. Sed id eros sit amet metus pretium rutrum. Etiam ultrices orci vitae lectus. Nullam auctor dignissim diam. Nullam mattis dictum tortor.
Praesent justo augue, consequat ac, placerat gravida, ornare vitae, libero. Aliquam erat volutpat. Class aptent taciti sociosqu ad litora torquent per conubia nostra, per inceptos hymenaeos. Vestibulum ante ipsum primis in faucibus orci luctus et ultrices posuere cubilia Curae; Donec sodales, odio in volutpat consectetuer, neque neque lobortis mi, quis sagittis felis neque ut ipsum. Nullam nonummy, ligula eget fermentum lobortis, dui dolor congue est, scelerisque cursus pede nibh sit amet felis. Proin malesuada placerat libero. Aliquam bibendum sollicitudin quam. In quis risus quis leo pretium luctus. Vestibulum enim. Lorem ipsum dolor sit amet, consectetuer adipiscing elit. Proin vitae metus a dui venenatis commodo. Sed eu lacus. Pellentesque et lorem. Ut ut libero vel tellus rutrum varius.

Kf l =

λτ

## 2(−χ⁰τ)

(1 + R) | (1.7)
Kho | =

λτ

## 2(−χ⁰τ)

(1 + R)

1 +

∆Ωhoτ

λτ 2
(1.8)

λτ =

∆Ωho τ
tan ∆Ωho τ
2

·

(1 + R)
(1 − R)

(1.9)

Nulla fermentum convallis nisi. Ut lectus. Praesent pharetra erat porta magna. Nulla vestibulum eleifend velit. Integer odio. Nam ac dui. Sed auctor, arcu id pharetra pulvinar, dui purus imperdiet tortor, ut egestas ipsum augue nec justo.

12 | 1. Lorem Ipsum (\chapter)

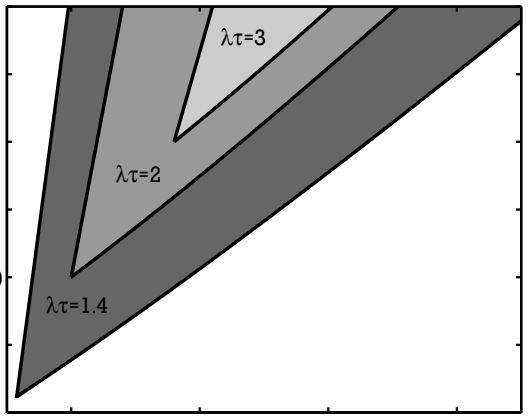
[picture p111: figure]

1 | 2 | 3 | 4

−0.2

−0.1

0

0.1

0.2

0.3

0.4

### (−χτ)K

R

Abbildung 1.3.: Lorem ipsum dolor sit amet, consectetuer adipiscing elit. Sed vitae ligula. Integer pharetra ornare eros. Phasellus vitae magna eget metus iaculis consectetuer. Lorem ipsum dolor sit amet, consectetuer adipiscing elit.

Cras eu nisl eu urna euismod faucibus. Quisque interdum rhoncus ipsum. Ut libero. Cras ante. Vestibulum ante ipsum primis in faucibus orci luctus et ultrices posuere cubilia Curae; Nam imperdiet nisl ac eros. Suspendisse hendrerit, pede nec condimentum ultricies, turpis elit fermentum dui, quis cursus magna nunc eget nisi. Cras porta nulla non ligula. Maecenas orci felis, ultrices quis, scelerisque nec, mollis at, libero. Mauris lectus urna, lacinia eu, tincidunt non, vehicula a, mi. Sed euismod faucibus ligula. Mauris eu libero. Duis ante lectus, pulvinar in, gravida a, sagittis in, odio.
Proin ornare, lorem id placerat dapibus, nunc libero tristique arcu, eu cursus nisl turpis eu est. Sed ut sem nec ligula ornare venenatis. Sed sapien. Aliquam erat volutpat. Aliquam scelerisque scelerisque lacus. Phasellus elit ipsum, dapibus viverra, ullamcorper id, ultricies in, lorem. Nam porta pede vitae nisl. Nulla non felis nec eros porttitor tempor. Nunc ligula quam, pretium quis, ultricies ut, lacinia sit amet, leo. Morbi nonummy lectus vel orci. Sed pede arcu, molestie vitae, tristique in, adipiscing imperdiet, massa. Quisque lacinia erat id metus. Nam tristique malesuada erat. Mauris urna. Praesent scelerisque sem a mi. Pellentesque habitant morbi tristique senectus et netus et malesuada fames ac turpis egestas. Suspendisse vitae dui.
Quisque odio. Ut eget justo ut velit consequat auctor. Curabitur diam. Suspendisse ullamcorper venenatis purus. Praesent aliquet nunc ut magna. Nulla dignissim fermentum dolor. Nullam in orci rutrum lectus facilisis scelerisque. Integer elementum mi eget elit. Nulla volutpat lorem vel leo. Nam egestas. Donec imperdiet auctor pede. Praesent lobortis mi a metus. Aenean fringilla ante a libero. Aenean consequat, lorem ut scelerisque volutpat, nisi massa tincidunt justo, vel aliquam dolor pede quis nibh. Phasellus vehicula aliquet nibh.
Maecenas et mi nec elit ornare euismod. Mauris elit nisi, faucibus ac, semper quis, ullamcorper vel, augue. Nunc ligula. Duis eu nibh. Vestibulum egestas, nisi sed pharetra pellentesque, elit nibh aliquet arcu, eu lacinia massa lectus id mi. Nulla diam. Vestibulum fermentum rutrum augue. Vestibulum nunc sapien, euismod vitae, lacinia eget, accumsan id, lacus. Class aptent taciti sociosqu ad litora torquent per conubia nostra, per inceptos hymenaeos. Duis nec mauris eget urna cursus dapibus. Donec sed neque at metus pretium tincidunt. Integer eget enim eget est interdum dignissim. Vestibulum ante ipsum primis in faucibus orci luctus et ultrices posuere cubilia Curae; Ut erat. Vivamus fringilla justo non libero. Donec lectus est, porttitor nec, posuere et, convallis ac, pede. Cras mi mauris, aliquam a, aliquet eget, elementum ut, velit. Morbi posuere blandit turpis. Aenean cursus.
Proin mattis. Maecenas egestas. Nunc id justo non pede ornare molestie. Aliquam egestas tincidunt magna. Sed tempus tincidunt erat. Cras pharetra varius libero. Curabitur porttitor. Suspendisse potenti. Donec bibendum. Curabitur dignissim neque. Nam sit amet odio. Nulla ligula tortor, fermentum vel, ornare nec, vulputate vel, enim. Nullam sit amet nisl eget dui placerat porta. Donec leo. Nullam dignissim ullamcorper felis. Cras vulputate urna vehicula nibh.
Praesent feugiat, urna eu laoreet porttitor, odio dolor blandit erat, vitae facilisis orci massa sit amet tortor. Donec orci. Ut fringilla ultricies nisl. Aliquam eu dui ut erat bibendum molestie. Maecenas porttitor. Nam ut mauris. Etiam egestas elit a neque. Proin sed eros. Nullam et ipsum. Mauris ut lectus. Quisque tristique ipsum auctor ligula. Pellentesque semper sagittis neque. Nullam sed enim.
Cras tempor ligula. Sed egestas sem eu elit dignissim condimentum. Suspendisse velit. Suspendisse iaculis magna vitae elit. Mauris dignissim porttitor magna. Duis nec tortor non velit ultrices iaculis. Aenean enim ante, elementum sit amet, lacinia non, porta nec, quam. Sed bibendum accumsan tortor. Vestibulum vitae mauris in dolor tincidunt eleifend.
1.1. Lorem Ipsum (\section) | 13

Vestibulum ante ipsum primis in faucibus orci luctus et ultrices posuere cubilia Curae; Nunc libero sapien, condimentum quis, egestas quis, cursus id, dolor. Fusce dolor lectus, egestas quis, ullamcorper ac, dictum in, nibh.

Lorem Ipsum (\subsubsection)

Lorem ipsum dolor sit amet, consectetuer adipiscing elit. Sed vitae ligula. Integer pharetra ornare eros. Phasellus vitae magna eget metus iaculis consectetuer. Lorem ipsum dolor sit amet, consectetuer adipiscing elit. Ut fringilla, elit id bibendum pharetra, enim nunc commodo lacus, vel consequat pede elit et massa. Nullam ac neque vel dui sodales malesuada. Phasellus sit amet magna. Nulla nisl metus, dictum et, ultricies vel, vestibulum ut, sem. Nulla nulla felis, gravida non, feugiat eget, interdum non, urna. Nunc nulla nunc, placerat pretium, varius in, dignissim a, eros. Quisque consequat, leo sit amet adipiscing pellentesque, nisl elit iaculis ipsum, quis tincidunt purus risus pulvinar enim. Nulla laoreet. Cras ullamcorper libero eget velit. Nam vel enim id tortor dignissim egestas. Pellentesque mi quam, porttitor sed, nonummy in, semper vitae, nisl. Duis ut dolor ut sem auctor dapibus. Nulla urna pede, facilisis a, hendrerit non, tincidunt vitae, orci. Mauris tincidunt posuere magna. Fusce blandit.
Sed ac sapien. Phasellus diam pede, facilisis at, faucibus vel, semper eu, diam. Morbi eleifend. Curabitur mattis ipsum sit amet purus. Fusce vel dui non ante sagittis consequat. Aliquam eget elit sed tellus euismod fermentum. Nullam sit amet dui vulputate ipsum volutpat molestie. Fusce vehicula tincidunt diam. Sed in nisi. Proin sit amet sem ut lacus mollis laoreet. Proin adipiscing dignissim justo. Sed id eros sit amet metus pretium rutrum. Etiam ultrices orci vitae lectus. Nullam auctor dignissim diam. Nullam mattis dictum tortor.
Praesent justo augue, consequat ac, placerat gravida, ornare vitae, libero. Aliquam erat volutpat. Class aptent taciti sociosqu ad litora torquent per conubia nostra, per inceptos hymenaeos. Vestibulum ante ipsum primis in faucibus orci luctus et ultrices posuere cubilia Curae; Donec sodales, odio in volutpat consectetuer, neque neque lobortis mi, quis sagittis felis neque ut ipsum. Nullam nonummy, ligula eget fermentum lobortis, dui dolor congue est, scelerisque cursus pede nibh sit amet felis. Proin malesuada placerat libero. Aliquam bibendum sollicitudin quam. In quis risus quis leo pretium luctus. Vestibulum enim. Lorem ipsum dolor sit amet, consectetuer adipiscing elit. Proin vitae metus a dui venenatis commodo. Sed eu lacus. Pellentesque et lorem. Ut ut libero vel tellus rutrum varius.

Kf l =

λτ

## 2(−χ⁰τ)

(1 + R) | (1.10)
Kho | =

λτ

## 2(−χ⁰τ)

(1 + R)

1 +

∆Ωhoτ

λτ 2
(1.11)

λτ =

∆Ωho τ
tan ∆Ωho τ
2

·

(1 + R)
(1 − R)

(1.12)

Nulla fermentum convallis nisi. Ut lectus. Praesent pharetra erat porta magna. Nulla vestibulum eleifend velit. Integer odio. Nam ac dui. Sed auctor, arcu id pharetra pulvinar, dui purus imperdiet tortor, ut egestas ipsum augue nec justo. Cras eu nisl eu urna euismod faucibus. Quisque interdum rhoncus ipsum. Ut libero. Cras ante. Vestibulum ante ipsum primis in faucibus orci luctus et ultrices posuere cubilia Curae; Nam imperdiet nisl ac eros. Suspendisse hendrerit, pede nec condimentum ultricies, turpis elit fermentum dui, quis cursus magna nunc eget nisi. Cras porta nulla non ligula. Maecenas orci felis, ultrices quis, scelerisque nec, mollis at, libero. Mauris lectus urna, lacinia eu, tincidunt non, vehicula a, mi. Sed euismod faucibus ligula. Mauris eu libero. Duis ante lectus, pulvinar in, gravida a, sagittis in, odio.
Proin ornare, lorem id placerat dapibus, nunc libero tristique arcu, eu cursus nisl turpis eu est. Sed ut sem nec ligula ornare venenatis. Sed sapien. Aliquam erat volutpat. Aliquam scelerisque scelerisque lacus. Phasellus elit ipsum, dapibus viverra, ullamcorper id, ultricies in, lorem. Nam porta pede vitae nisl. Nulla non felis nec eros porttitor tempor. Nunc ligula quam, pretium quis, ultricies ut, lacinia sit amet, leo. Morbi nonummy lectus vel orci. Sed pede arcu, molestie vitae, tristique in, adipiscing imperdiet, massa. Quisque lacinia erat id metus. Nam tristique malesuada erat. Mauris urna. Praesent scelerisque sem a mi. Pellentesque habitant morbi tristique senectus et netus et malesuada fames ac turpis egestas. Suspendisse vitae dui.
Quisque odio. Ut eget justo ut velit consequat auctor. Curabitur diam. Suspendisse ullamcorper venenatis purus. Praesent aliquet nunc ut magna. Nulla dignissim fermentum dolor. Nullam in orci rutrum lectus facilisis scelerisque. Integer elementum mi eget elit. Nulla volutpat lorem vel leo. Nam egestas. Donec imperdiet auctor pede. Praesent lobortis mi a metus. Aenean fringilla ante a libero. Aenean consequat, lorem ut scelerisque volutpat, nisi massa tincidunt justo, vel aliquam dolor pede quis nibh. Phasellus vehicula aliquet nibh.
Maecenas et mi nec elit ornare euismod. Mauris elit nisi, faucibus ac, semper quis, ullamcorper vel, augue. Nunc ligula. Duis eu nibh. Vestibulum egestas, nisi sed pharetra pellentesque, elit nibh aliquet arcu, eu lacinia massa lectus id mi. Nulla diam. Vestibulum fermentum rutrum augue. Vestibulum nunc sapien, euismod vitae, lacinia eget, accumsan id, lacus. Class aptent taciti sociosqu ad litora torquent per conubia nostra, per inceptos hymenaeos. Duis nec mauris
14 | 1. Lorem Ipsum (\chapter)

1 | 2 | 3 | 4

−0.2

−0.1

0

0.1

0.2

0.3

0.4

### (−χτ)K

R

Abbildung 1.4.: Lorem ipsum dolor sit amet, consectetuer adipiscing elit. Sed vitae ligula. Integer pharetra ornare eros. Phasellus vitae magna eget metus iaculis consectetuer. Lorem ipsum dolor sit amet, consectetuer adipiscing elit.

eget urna cursus dapibus. Donec sed neque at metus pretium tincidunt. Integer eget enim eget est interdum dignissim. Vestibulum ante ipsum primis in faucibus orci luctus et ultrices posuere cubilia Curae; Ut erat. Vivamus fringilla justo non libero. Donec lectus est, porttitor nec, posuere et, convallis ac, pede. Cras mi mauris, aliquam a, aliquet eget, elementum ut, velit. Morbi posuere blandit turpis. Aenean cursus.
Proin mattis. Maecenas egestas. Nunc id justo non pede ornare molestie. Aliquam egestas tincidunt magna. Sed tempus tincidunt erat. Cras pharetra varius libero. Curabitur porttitor. Suspendisse potenti. Donec bibendum. Curabitur dignissim neque. Nam sit amet odio. Nulla ligula tortor, fermentum vel, ornare nec, vulputate vel, enim. Nullam sit amet nisl eget dui placerat porta. Donec leo. Nullam dignissim ullamcorper felis. Cras vulputate urna vehicula nibh.
Praesent feugiat, urna eu laoreet porttitor, odio dolor blandit erat, vitae facilisis orci massa sit amet tortor. Donec orci. Ut fringilla ultricies nisl. Aliquam eu dui ut erat bibendum molestie. Maecenas porttitor. Nam ut mauris. Etiam egestas elit a neque. Proin sed eros. Nullam et ipsum. Mauris ut lectus. Quisque tristique ipsum auctor ligula. Pellentesque semper sagittis neque. Nullam sed enim.
Cras tempor ligula. Sed egestas sem eu elit dignissim condimentum. Suspendisse velit. Suspendisse iaculis magna vitae elit. Mauris dignissim porttitor magna. Duis nec tortor non velit ultrices iaculis. Aenean enim ante, elementum sit amet, lacinia non, porta nec, quam. Sed bibendum accumsan tortor. Vestibulum vitae mauris in dolor tincidunt eleifend. Vestibulum ante ipsum primis in faucibus orci luctus et ultrices posuere cubilia Curae; Nunc libero sapien, condimentum quis, egestas quis, cursus id, dolor. Fusce dolor lectus, egestas quis, ullamcorper ac, dictum in, nibh.

Lorem Ipsum (\paragraph)
Lorem ipsum dolor sit amet, consectetuer adipiscing elit. Sed vitae ligula. Integer pharetra ornare eros. Phasellus vitae magna eget metus iaculis consectetuer. Lorem ipsum dolor sit amet, consectetuer adipiscing elit. Ut fringilla, elit id bibendum pharetra, enim nunc commodo lacus, vel consequat pede elit et massa. Nullam ac neque vel dui sodales malesuada. Phasellus sit amet magna. Nulla nisl metus, dictum et, ultricies vel, vestibulum ut, sem. Nulla nulla felis, gravida non, feugiat eget, interdum non, urna. Nunc nulla nunc, placerat pretium, varius in, dignissim a, eros. Quisque consequat, leo sit amet adipiscing pellentesque, nisl elit iaculis ipsum, quis tincidunt purus risus pulvinar enim. Nulla laoreet. Cras ullamcorper libero eget velit. Nam vel enim id tortor dignissim egestas. Pellentesque mi quam, porttitor sed, nonummy in, semper vitae, nisl. Duis ut dolor ut sem auctor dapibus. Nulla urna pede, facilisis a, hendrerit non, tincidunt vitae, orci. Mauris tincidunt posuere magna. Fusce blandit.
Sed ac sapien. Phasellus diam pede, facilisis at, faucibus vel, semper eu, diam. Morbi eleifend. Curabitur mattis ipsum sit amet purus. Fusce vel dui non ante sagittis consequat. Aliquam eget elit sed tellus euismod fermentum. Nullam sit amet dui vulputate ipsum volutpat molestie. Fusce vehicula tincidunt diam. Sed in nisi. Proin sit amet sem ut lacus mollis laoreet. Proin adipiscing dignissim justo. Sed id eros sit amet metus pretium rutrum. Etiam ultrices orci vitae lectus. Nullam auctor dignissim diam. Nullam mattis dictum tortor.
Praesent justo augue, consequat ac, placerat gravida, ornare vitae, libero. Aliquam erat volutpat. Class aptent taciti sociosqu ad litora torquent per conubia nostra, per inceptos hymenaeos. Vestibulum ante ipsum primis in faucibus orci luctus et ultrices posuere cubilia Curae; Donec sodales, odio in volutpat consectetuer, neque neque lobortis mi, quis
1.1. Lorem Ipsum (\section) | 15

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

Kf l =

λτ

## 2(−χ⁰τ)

(1 + R) | (1.13)
Kho | =

λτ

## 2(−χ⁰τ)

(1 + R)

1 +

∆Ωhoτ

λτ 2
(1.14)

λτ =

∆Ωho τ
tan ∆Ωho τ
2

·

(1 + R)
(1 − R)

(1.15)

Nulla fermentum convallis nisi. Ut lectus. Praesent pharetra erat porta magna. Nulla vestibulum eleifend velit. Integer odio. Nam ac dui. Sed auctor, arcu id pharetra pulvinar, dui purus imperdiet tortor, ut egestas ipsum augue nec justo. Cras eu nisl eu urna euismod faucibus. Quisque interdum rhoncus ipsum. Ut libero. Cras ante. Vestibulum ante ipsum primis in faucibus orci luctus et ultrices posuere cubilia Curae; Nam imperdiet nisl ac eros. Suspendisse hendrerit, pede nec condimentum ultricies, turpis elit fermentum dui, quis cursus magna nunc eget nisi. Cras porta nulla non ligula. Maecenas orci felis, ultrices quis, scelerisque nec, mollis at, libero. Mauris lectus urna, lacinia eu, tincidunt non, vehicula a, mi. Sed euismod faucibus ligula. Mauris eu libero. Duis ante lectus, pulvinar in, gravida a, sagittis in, odio.
Proin ornare, lorem id placerat dapibus, nunc libero tristique arcu, eu cursus nisl turpis eu est. Sed ut sem nec ligula ornare venenatis. Sed sapien. Aliquam erat volutpat. Aliquam scelerisque scelerisque lacus. Phasellus elit ipsum, dapibus viverra, ullamcorper id, ultricies in, lorem. Nam porta pede vitae nisl. Nulla non felis nec eros porttitor tempor. Nunc ligula quam, pretium quis, ultricies ut, lacinia sit amet, leo. Morbi nonummy lectus vel orci. Sed pede arcu, molestie vitae, tristique in, adipiscing imperdiet, massa. Quisque lacinia erat id metus. Nam tristique malesuada erat. Mauris urna. Praesent scelerisque sem a mi. Pellentesque habitant morbi tristique senectus et netus et malesuada fames ac turpis egestas. Suspendisse vitae dui.
Quisque odio. Ut eget justo ut velit consequat auctor. Curabitur diam. Suspendisse ullamcorper venenatis purus. Praesent aliquet nunc ut magna. Nulla dignissim fermentum dolor. Nullam in orci rutrum lectus facilisis scelerisque. Integer elementum mi eget elit. Nulla volutpat lorem vel leo. Nam egestas. Donec imperdiet auctor pede. Praesent lobortis mi a metus. Aenean fringilla ante a libero. Aenean consequat, lorem ut scelerisque volutpat, nisi massa tincidunt justo, vel aliquam dolor pede quis nibh. Phasellus vehicula aliquet nibh.
Maecenas et mi nec elit ornare euismod. Mauris elit nisi, faucibus ac, semper quis, ullamcorper vel, augue. Nunc ligula. Duis eu nibh. Vestibulum egestas, nisi sed pharetra pellentesque, elit nibh aliquet arcu, eu lacinia massa lectus id mi. Nulla diam. Vestibulum fermentum rutrum augue. Vestibulum nunc sapien, euismod vitae, lacinia eget, accumsan id, lacus. Class aptent taciti sociosqu ad litora torquent per conubia nostra, per inceptos hymenaeos. Duis nec mauris eget urna cursus dapibus. Donec sed neque at metus pretium tincidunt. Integer eget enim eget est interdum dignissim. Vestibulum ante ipsum primis in faucibus orci luctus et ultrices posuere cubilia Curae; Ut erat. Vivamus fringilla justo non libero. Donec lectus est, porttitor nec, posuere et, convallis ac, pede. Cras mi mauris, aliquam a, aliquet eget, elementum ut, velit. Morbi posuere blandit turpis. Aenean cursus.
Proin mattis. Maecenas egestas. Nunc id justo non pede ornare molestie. Aliquam egestas tincidunt magna. Sed tempus tincidunt erat. Cras pharetra varius libero. Curabitur porttitor. Suspendisse potenti. Donec bibendum. Curabitur dignissim neque. Nam sit amet odio. Nulla ligula tortor, fermentum vel, ornare nec, vulputate vel, enim. Nullam sit amet nisl eget dui placerat porta. Donec leo. Nullam dignissim ullamcorper felis. Cras vulputate urna vehicula nibh.
Praesent feugiat, urna eu laoreet porttitor, odio dolor blandit erat, vitae facilisis orci massa sit amet tortor. Donec orci. Ut fringilla ultricies nisl. Aliquam eu dui ut erat bibendum molestie. Maecenas porttitor. Nam ut mauris. Etiam egestas elit a neque. Proin sed eros. Nullam et ipsum. Mauris ut lectus. Quisque tristique ipsum auctor ligula. Pellentesque semper sagittis neque. Nullam sed enim.
Cras tempor ligula. Sed egestas sem eu elit dignissim condimentum. Suspendisse velit. Suspendisse iaculis magna vitae elit. Mauris dignissim porttitor magna. Duis nec tortor non velit ultrices iaculis. Aenean enim ante, elementum sit amet, lacinia non, porta nec, quam. Sed bibendum accumsan tortor. Vestibulum vitae mauris in dolor tincidunt eleifend. Vestibulum ante ipsum primis in faucibus orci luctus et ultrices posuere cubilia Curae; Nunc libero sapien, condimentum quis, egestas quis, cursus id, dolor. Fusce dolor lectus, egestas quis, ullamcorper ac, dictum in, nibh.
Lorem Ipsum (\subparagraph): Lorem ipsum dolor sit amet, consectetuer adipiscing elit. Sed vitae ligula. Integer pharetra ornare eros. Phasellus vitae magna eget metus iaculis consectetuer. Lorem ipsum dolor sit amet, consectetuer adipiscing elit. Ut fringilla, elit id bibendum pharetra, enim nunc commodo lacus, vel consequat pede elit et massa. Nullam ac neque vel dui sodales malesuada. Phasellus sit amet magna. Nulla nisl metus, dictum et, ultricies vel, vestibulum ut, sem. Nulla nulla felis, gravida non, feugiat eget, interdum non, urna. Nunc nulla nunc, placerat pretium, varius in, dignissim a, eros. Quisque consequat, leo sit amet adipiscing pellentesque, nisl elit iaculis ipsum, quis tincidunt purus risus
16 | 1. Lorem Ipsum (\chapter)

1 | 2 | 3 | 4

−0.2

−0.1

0

0.1

0.2

0.3

0.4

### (−χτ)K

R

Abbildung 1.5.: Lorem ipsum dolor sit amet, consectetuer adipiscing elit. Sed vitae ligula. Integer pharetra ornare eros. Phasellus vitae magna eget metus iaculis consectetuer. Lorem ipsum dolor sit amet, consectetuer adipiscing elit.

pulvinar enim. Nulla laoreet. Cras ullamcorper libero eget velit. Nam vel enim id tortor dignissim egestas. Pellentesque mi quam, porttitor sed, nonummy in, semper vitae, nisl. Duis ut dolor ut sem auctor dapibus. Nulla urna pede, facilisis a, hendrerit non, tincidunt vitae, orci. Mauris tincidunt posuere magna. Fusce blandit.
Sed ac sapien. Phasellus diam pede, facilisis at, faucibus vel, semper eu, diam. Morbi eleifend. Curabitur mattis ipsum sit amet purus. Fusce vel dui non ante sagittis consequat. Aliquam eget elit sed tellus euismod fermentum. Nullam sit amet dui vulputate ipsum volutpat molestie. Fusce vehicula tincidunt diam. Sed in nisi. Proin sit amet sem ut lacus mollis laoreet. Proin adipiscing dignissim justo. Sed id eros sit amet metus pretium rutrum. Etiam ultrices orci vitae lectus. Nullam auctor dignissim diam. Nullam mattis dictum tortor.
Praesent justo augue, consequat ac, placerat gravida, ornare vitae, libero. Aliquam erat volutpat. Class aptent taciti sociosqu ad litora torquent per conubia nostra, per inceptos hymenaeos. Vestibulum ante ipsum primis in faucibus orci luctus et ultrices posuere cubilia Curae; Donec sodales, odio in volutpat consectetuer, neque neque lobortis mi, quis sagittis felis neque ut ipsum. Nullam nonummy, ligula eget fermentum lobortis, dui dolor congue est, scelerisque cursus pede nibh sit amet felis. Proin malesuada placerat libero. Aliquam bibendum sollicitudin quam. In quis risus quis leo pretium luctus. Vestibulum enim. Lorem ipsum dolor sit amet, consectetuer adipiscing elit. Proin vitae metus a dui venenatis commodo. Sed eu lacus. Pellentesque et lorem. Ut ut libero vel tellus rutrum varius.
Nulla fermentum convallis nisi. Ut lectus. Praesent pharetra erat porta magna. Nulla vestibulum eleifend velit. Integer odio. Nam ac dui. Sed auctor, arcu id pharetra pulvinar, dui purus imperdiet tortor, ut egestas ipsum augue nec justo. Cras eu nisl eu urna euismod faucibus. Quisque interdum rhoncus ipsum. Ut libero. Cras ante. Vestibulum ante ipsum primis in faucibus orci luctus et ultrices posuere cubilia Curae; Nam imperdiet nisl ac eros. Suspendisse hendrerit, pede nec condimentum ultricies, turpis elit fermentum dui, quis cursus magna nunc eget nisi. Cras porta nulla non ligula. Maecenas orci felis, ultrices quis, scelerisque nec, mollis at, libero. Mauris lectus urna, lacinia eu, tincidunt non, vehicula a, mi. Sed euismod faucibus ligula. Mauris eu libero. Duis ante lectus, pulvinar in, gravida a, sagittis in, odio.
Proin ornare, lorem id placerat dapibus, nunc libero tristique arcu, eu cursus nisl turpis eu est. Sed ut sem nec ligula ornare venenatis. Sed sapien. Aliquam erat volutpat. Aliquam scelerisque scelerisque lacus. Phasellus elit ipsum, dapibus viverra, ullamcorper id, ultricies in, lorem. Nam porta pede vitae nisl. Nulla non felis nec eros porttitor tempor. Nunc ligula quam, pretium quis, ultricies ut, lacinia sit amet, leo. Morbi nonummy lectus vel orci. Sed pede arcu, molestie vitae, tristique in, adipiscing imperdiet, massa. Quisque lacinia erat id metus. Nam tristique malesuada erat. Mauris urna. Praesent scelerisque sem a mi. Pellentesque habitant morbi tristique senectus et netus et malesuada fames ac turpis egestas. Suspendisse vitae dui.
Quisque odio. Ut eget justo ut velit consequat auctor. Curabitur diam. Suspendisse ullamcorper venenatis purus. Praesent aliquet nunc ut magna. Nulla dignissim fermentum dolor. Nullam in orci rutrum lectus facilisis scelerisque. Integer elementum mi eget elit. Nulla volutpat lorem vel leo. Nam egestas. Donec imperdiet auctor pede. Praesent lobortis mi a metus. Aenean fringilla ante a libero. Aenean consequat, lorem ut scelerisque volutpat, nisi massa tincidunt justo, vel aliquam dolor pede quis nibh. Phasellus vehicula aliquet nibh.
Maecenas et mi nec elit ornare euismod. Mauris elit nisi, faucibus ac, semper quis, ullamcorper vel, augue. Nunc ligula. Duis eu nibh. Vestibulum egestas, nisi sed pharetra pellentesque, elit nibh aliquet arcu, eu lacinia massa lectus
1.1. Lorem Ipsum (\section) | 17

id mi. Nulla diam. Vestibulum fermentum rutrum augue. Vestibulum nunc sapien, euismod vitae, lacinia eget, accumsan id, lacus. Class aptent taciti sociosqu ad litora torquent per conubia nostra, per inceptos hymenaeos. Duis nec mauris eget urna cursus dapibus. Donec sed neque at metus pretium tincidunt. Integer eget enim eget est interdum dignissim. Vestibulum ante ipsum primis in faucibus orci luctus et ultrices posuere cubilia Curae; Ut erat. Vivamus fringilla justo non libero. Donec lectus est, porttitor nec, posuere et, convallis ac, pede. Cras mi mauris, aliquam a, aliquet eget, elementum ut, velit. Morbi posuere blandit turpis. Aenean cursus.
Proin mattis. Maecenas egestas. Nunc id justo non pede ornare molestie. Aliquam egestas tincidunt magna. Sed tempus tincidunt erat. Cras pharetra varius libero. Curabitur porttitor. Suspendisse potenti. Donec bibendum. Curabitur dignissim neque. Nam sit amet odio. Nulla ligula tortor, fermentum vel, ornare nec, vulputate vel, enim. Nullam sit amet nisl eget dui placerat porta. Donec leo. Nullam dignissim ullamcorper felis. Cras vulputate urna vehicula nibh.
Praesent feugiat, urna eu laoreet porttitor, odio dolor blandit erat, vitae facilisis orci massa sit amet tortor. Donec orci. Ut fringilla ultricies nisl. Aliquam eu dui ut erat bibendum molestie. Maecenas porttitor. Nam ut mauris. Etiam egestas elit a neque. Proin sed eros. Nullam et ipsum. Mauris ut lectus. Quisque tristique ipsum auctor ligula. Pellentesque semper sagittis neque. Nullam sed enim.
Cras tempor ligula. Sed egestas sem eu elit dignissim condimentum. Suspendisse velit. Suspendisse iaculis magna vitae elit. Mauris dignissim porttitor magna. Duis nec tortor non velit ultrices iaculis. Aenean enim ante, elementum sit amet, lacinia non, porta nec, quam. Sed bibendum accumsan tortor. Vestibulum vitae mauris in dolor tincidunt eleifend. Vestibulum ante ipsum primis in faucibus orci luctus et ultrices posuere cubilia Curae; Nunc libero sapien, condimentum quis, egestas quis, cursus id, dolor. Fusce dolor lectus, egestas quis, ullamcorper ac, dictum in, nibh.
18 | 1. Lorem Ipsum (\chapter)

# 2 Interldum volgus (\chapter)

Interdum volgus rectum videt, est ubi peccat. Si veteres ita miratur laudatque poetas, ut nihil anteferat, nihil illis comparet, errat. Si quaedam nimis antique, si peraque dure dicere credit eos, ignave multa fatetur, et sapit et mecum facit et Iova iudicat aequo. Non equidem insector delendave carmina Livi esse reor, memini quae plagosum mihi parvo Orbilium dictare; sed emendata videri pulchraque et exactis minimum distantia miror. Inter quae verbum emicuit si forte decorum, et si versus paulo concinnior unus et alter, venditque poema. Brevi vel toto est iunior anno. Utor permisso, caudaeque pilos ut equinae paulatim vello unum, demo etiam unum. Si meliora dies, ut vina, poemata reddit, scire velim, chartis perficit quotus pretium quotus arroget annus. Scriptor abhinc reddit misso annos centum qui decidit, inter perfectos veteresque referri debet an inter vilis atque perfectos novos? Excludat iurgia finis. Est vetus atque probus, centum qui perficit annos. Quid, qui deperiitnihis perfectos uno mense vel? Iste quidem veteres inter ponetur honeste, qui vel mense brevi vel toto est iunior anno. Utor permisso, caudaeque nisi pilos ut equinae paulatim vello et virtutem, demo etiam unum, dum cadat elusus ratione ruentis acervi, qui redit in fastos et virtutem aestimat annis miraturque nihil nisi quod. Ennius et sapines et fortis et alter Homerus, ut critici dicunt, leviter curare videtur, quo promissa cadant et somnia Pythagorea. Naevius in manibus non est et sanctum mentibus haeret paene recens? Adeo sanctum est vetus omne poema. Ambigitur quotiens, uter utro sit prior, aufert Pacuvius docti famam senis Accius alti, dicitur Afrani toga convenisse Menandro, Plautus. Hos ediscit et hos arto stipata theatro spectat Roma potens; habet hos nisi numeratque poetas ad ambigitur tempus Livi scriptoris ab aevo. Brevi vel toto est iunior anno. Interdum volgus rectum videt, est ubi peccat. Si veteres ita miratur laudatque poetas, ut nihil anteferat, nihil illis comparet, errat.

Kf l =

λτ

## 2(−χ⁰τ)

(1 + R) | (2.1)
Kho | =

λτ

## 2(−χ⁰τ)

(1 + R)

1 +

∆Ωhoτ

λτ 2
(2.2)

λτ =

∆Ωho τ
tan ∆Ωho τ
2

·

(1 + R)
(1 − R)

(2.3)

Si quaedam nimis antique, si peraque dure dicere credit eos, ignave multa fatetur, et sapit et mecum facit et Iova iudicat aequo. Non equidem insector delendave carmina Livi esse reor, memini quae plagosum mihi parvo Orbilium dictare; sed emendata videri pulchraque et exactis minimum distantia miror. Inter quae verbum emicuit si forte decorum, et si versus paulo concinnior unus et alter, venditque poema. Brevi vel toto est iunior anno. Utor permisso, caudaeque pilos ut equinae paulatim vello unum, demo etiam unum. Si meliora dies, ut vina, poemata reddit, scire velim, chartis perficit quotus pretium quotus arroget annus. Scriptor abhinc reddit misso annos centum qui decidit, inter perfectos veteresque referri debet an inter vilis atque perfectos novos? Excludat iurgia finis. Est vetus atque probus, centum qui perficit annos. Quid, qui deperiitnihis perfectos uno mense vel? Iste quidem veteres inter ponetur honeste, qui vel mense brevi vel toto est iunior anno. Utor permisso, caudaeque nisi pilos ut equinae paulatim vello et virtutem, demo etiam unum, dum cadat elusus ratione ruentis acervi, qui redit in fastos et virtutem aestimat annis miraturque nihil nisi quod. Ennius et sapines et fortis et alter Homerus, ut critici dicunt, leviter curare videtur, quo promissa cadant et somnia Pythagorea. Naevius in manibus non est et sanctum mentibus haeret paene recens? Adeo sanctum est vetus omne poema.

2.1 Pacuvius docti famam senis Accius (\section)

Ambigitur quotiens, uter utro sit prior, aufert Pacuvius docti famam senis Accius alti, dicitur Afrani toga convenisse Menandro, Plautus. Hos ediscit et hos arto stipata theatro spectat Roma potens; habet hos nisi numeratque poetas ad ambigitur tempus Livi scriptoris ab aevo. Brevi vel toto est iunior anno. Interdum volgus rectum videt, est ubi peccat. Si veteres ita miratur laudatque poetas, ut nihil anteferat, nihil illis comparet, errat. Si quaedam nimis antique, si peraque dure dicere credit eos, ignave multa fatetur, et sapit et mecum facit et Iova iudicat aequo. Non equidem insector delendave carmina Livi esse reor, memini quae plagosum mihi parvo Orbilium dictare; sed emendata videri pulchraque et exactis minimum distantia miror. Inter quae verbum emicuit si forte decorum, et si versus paulo concinnior unus et alter, venditque poema. Brevi vel toto est iunior anno. Utor permisso, caudaeque pilos ut equinae paulatim vello unum, demo etiam unum. Si meliora dies, ut vina, poemata reddit, scire velim, chartis perficit quotus pretium quotus arroget annus. Scriptor abhinc reddit misso annos centum qui decidit, inter perfectos veteresque referri debet an inter vilis atque perfectos novos? Excludat iurgia finis. Est vetus atque probus, centum qui perficit annos. Quid, qui deperiitnihis perfectos

19 uno mense vel? Iste quidem veteres inter ponetur honeste, qui vel mense brevi vel toto est iunior anno. Utor permisso, caudaeque nisi pilos ut equinae paulatim vello et virtutem, demo etiam unum, dum cadat elusus ratione ruentis acervi, qui redit in fastos et virtutem aestimat annis miraturque nihil nisi quod. Ennius et sapines et fortis et alter Homerus, ut critici dicunt, leviter curare videtur, quo promissa cadant et somnia Pythagorea. Naevius in manibus non est et sanctum mentibus haeret paene recens? Adeo sanctum est vetus omne poema. Ambigitur quotiens, uter utro sit prior, aufert Pacuvius docti famam senis:

- Accius alti
- dicitur Afrani
- toga convenisse
- Menandro
- Plautus

Hos ediscit et hos arto stipata theatro spectat Roma potens; habet hos nisi numeratque poetas ad ambigitur tempus Livi scriptoris ab aevo. Brevi vel toto est iunior anno. Interdum volgus rectum videt, est ubi peccat. Si veteres ita miratur laudatque poetas, ut nihil anteferat, nihil illis comparet, errat. Si quaedam nimis antique, si peraque dure dicere credit eos, ignave multa fatetur, et sapit et mecum facit et Iova iudicat aequo. Non equidem insector delendave carmina Livi esse reor, memini quae plagosum mihi parvo Orbilium dictare; sed emendata videri pulchraque et exactis minimum distantia miror. Inter quae verbum emicuit si forte decorum, et si versus paulo concinnior unus et alter, venditque poema. Brevi vel toto est iunior anno. Utor permisso, caudaeque pilos ut equinae paulatim vello unum, demo etiam unum. Si meliora dies, ut vina, poemata reddit, scire velim, chartis perficit quotus pretium quotus arroget annus. Scriptor abhinc reddit misso annos centum qui decidit, inter perfectos veteresque referri debet an inter vilis atque perfectos novos?
Excludat iurgia finis. Est vetus atque probus, centum qui perficit annos. Quid, qui deperiitnihis perfectos uno mense vel? Iste quidem veteres inter ponetur honeste, qui vel mense brevi vel toto est iunior anno. Utor permisso, caudaeque nisi pilos ut equinae paulatim vello et virtutem, demo etiam unum, dum cadat elusus ratione ruentis acervi, qui redit in fastos et virtutem aestimat annis miraturque nihil nisi quod. Ennius et sapines et fortis et alter Homerus, ut critici dicunt, leviter curare videtur, quo promissa cadant et somnia Pythagorea. Naevius in manibus non est et sanctum mentibus haeret paene recens? Adeo sanctum est vetus omne poema. Ambigitur quotiens, uter utro sit prior, aufert Pacuvius docti famam senis Accius alti, dicitur Afrani toga convenisse Menandro, Plautus. Hos ediscit et hos arto stipata theatro spectat Roma potens; habet hos nisi numeratque poetas ad ambigitur tempus Livi scriptoris ab aevo.

2.1.1 Utor permisso (\subsection)

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

Excludat iurgia finis (\subsubsection)

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

20 | 2. Interldum volgus (\chapter)

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

Interdum volgus (\paragraph)
Interdum volgus rectum videt, est ubi peccat. Si veteres ita miratur laudatque poetas, ut nihil anteferat, nihil illis comparet, errat. Si quaedam nimis antique, si peraque dure dicere credit eos, ignave multa fatetur, et sapit et mecum facit et Iova iudicat aequo. Non equidem insector delendave carmina Livi esse reor, memini quae plagosum mihi parvo Orbilium dictare; sed emendata videri pulchraque et exactis minimum distantia miror. Inter quae verbum emicuit si forte decorum, et si versus paulo concinnior unus et alter, venditque poema. Brevi vel toto est iunior anno. Utor permisso, caudaeque pilos ut equinae paulatim vello unum, demo etiam unum. Si meliora dies, ut vina, poemata reddit, scire velim, chartis perficit quotus pretium quotus arroget annus. Scriptor abhinc reddit misso annos centum qui decidit, inter perfectos veteresque referri debet an inter vilis atque perfectos novos? Excludat iurgia finis. Est vetus atque probus, centum qui perficit annos. Quid, qui deperiitnihis perfectos uno mense vel? Iste quidem veteres inter ponetur honeste, qui vel mense brevi vel toto est iunior anno. Utor permisso, caudaeque nisi pilos ut equinae paulatim vello et virtutem, demo etiam unum, dum cadat elusus ratione ruentis acervi, qui redit in fastos et virtutem aestimat annis miraturque nihil nisi quod. Ennius et sapines et fortis et alter Homerus, ut critici dicunt, leviter curare videtur, quo promissa cadant et somnia Pythagorea. Naevius in manibus non est et sanctum mentibus haeret paene recens? Adeo sanctum est vetus omne poema. Ambigitur quotiens, uter utro sit prior, aufert Pacuvius docti famam senis Accius alti, dicitur Afrani toga convenisse Menandro, Plautus. Hos ediscit et hos arto stipata theatro spectat Roma potens; habet hos nisi numeratque poetas ad ambigitur tempus Livi scriptoris ab aevo. Brevi vel toto est iunior anno. Interdum volgus rectum videt, est ubi peccat. Si veteres ita miratur laudatque poetas, ut nihil anteferat, nihil illis comparet, errat. Si quaedam nimis antique, si peraque dure dicere credit eos, ignave multa fatetur, et sapit et mecum facit et Iova iudicat aequo. Non equidem insector delendave carmina Livi esse reor, memini quae plagosum mihi parvo Orbilium dictare; sed emendata videri pulchraque et exactis minimum distantia miror. Inter quae verbum emicuit si forte decorum, et si versus paulo concinnior unus et alter, venditque poema. Brevi vel toto est iunior anno. Utor permisso, caudaeque pilos ut equinae paulatim vello unum, demo etiam unum. Ennius et sapines
Si meliora dies (\subparagraph): Si meliora dies, ut vina, poemata reddit, scire velim, chartis perficit quotus pretium quotus arroget annus. Scriptor abhinc reddit misso annos centum qui decidit, inter perfectos veteresque referri debet an inter vilis atque perfectos novos? Excludat iurgia finis. Est vetus atque probus, centum qui perficit annos. Quid, qui deperiitnihis perfectos uno mense vel? Iste quidem veteres inter ponetur honeste, qui vel mense brevi vel toto est iunior anno. Utor permisso, caudaeque nisi pilos ut equinae paulatim vello et virtutem, demo etiam unum, dum cadat elusus ratione ruentis acervi, qui redit in fastos et virtutem aestimat annis miraturque nihil nisi quod. Ennius et sapines et fortis et alter Homerus, ut critici dicunt, leviter curare videtur, quo promissa cadant et somnia Pythagorea. Naevius in manibus non est et sanctum mentibus haeret paene recens? Adeo sanctum est vetus omne poema. Ambigitur quotiens, uter utro sit prior, aufert Pacuvius docti famam senis Accius alti, dicitur Afrani toga convenisse Menandro, Plautus. Hos ediscit et hos arto stipata theatro spectat Roma potens; habet hos nisi numeratque poetas ad ambigitur tempus Livi scriptoris ab aevo. Brevi vel toto est iunior anno.
Name | Number | d < 16 | 16 ≤ d ≤ 40 | 40 ≤ 100
| | Rp0,2 | Rm | Rp0,2 | Rm | Rp0,2 | Rm
C 22 | 1.0402 | 340 | 500 | 290 | 470 | − | −
C 22E | 1.1151 | 340 | ··· | 290 | ··· | − | −
C 22R | 1.1149 | 340 | 650 | 290 | 620 | − | −
C 25 | 1.0406 | 370 | 550 | 320 | 500 | − | −
C 25E | 1.1158 | 370 | ··· | 320 | ··· | − | −
C 25R | 1.1163 | 370 | 700 | 320 | 650 | − | −
C 30 | 1.0528 | 400 | 600 | 350 | 550 | 300 | 500
2.1. Pacuvius docti famam senis Accius (\section) | 21

Name | Number | d < 16 | 16 ≤ d ≤ 40 | 40 ≤ 100
Rp0,2 | Rm | Rp0,2 | Rm | Rp0,2 | Rm

Tabelle 2.1.: Rm, ReH von Vergütungsstahlen nach DIN EN 10 083-1/2: Mech. Eigenschaften der Stahle im Vergüteten Zustand (+QT)

22 | 2. Interldum volgus (\chapter)

# Danksagung (\chapter*)

Danke, danke, danke — Danke vielmals — Danke, sie können aufhören zu klatschen — Wirklich — Ach bitte setzen Sie sich doch — Ja danke , danke. . .

23

# Abbildungsverzeichnis

25
