malbreitenbach/adp_tauchspulenelektronik/Ausarbeitung/ADP_ausarbeitung/Bilder/Endprodukt.pdf

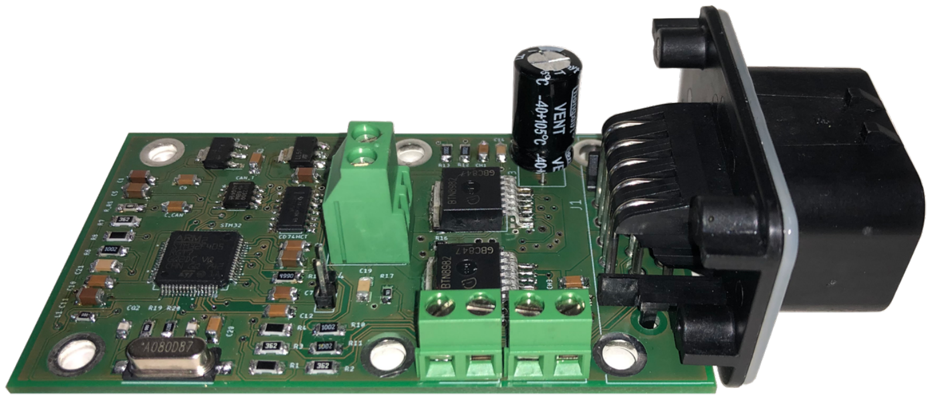
[picture p112: page 1]
