malbreitenbach/adp_tauchspulenelektronik/Ausarbeitung/ADP_ausarbeitung/Bilder/Platinefertig.pdf

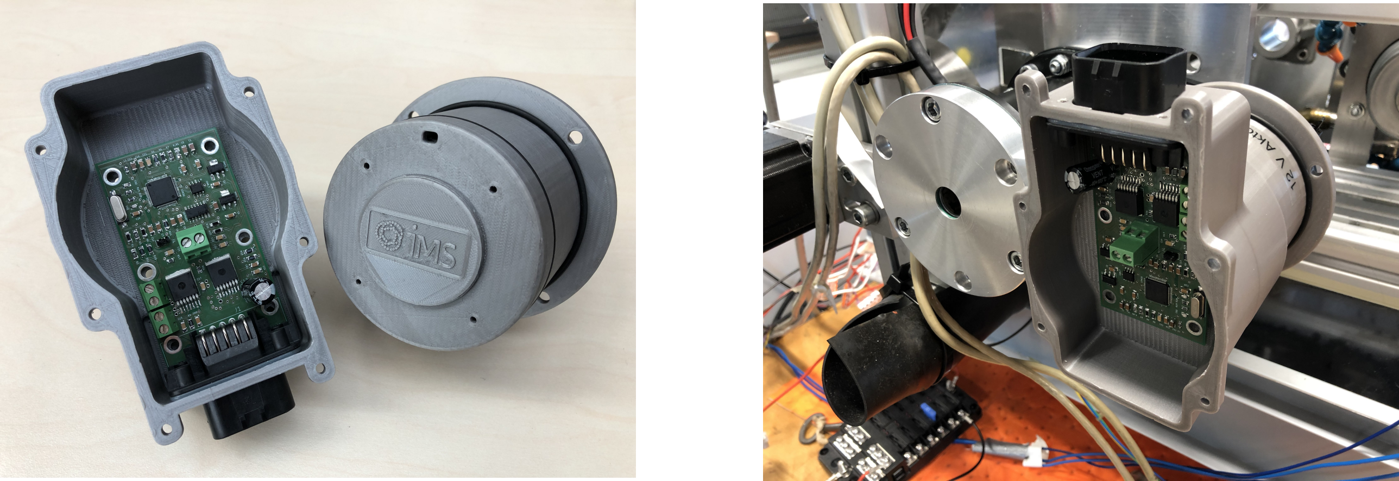
[picture p113: page 1]
