malbreitenbach/adp_tauchspulenelektronik/Ausarbeitung/ADP_ausarbeitung/input/aufgabenstellung.pdf

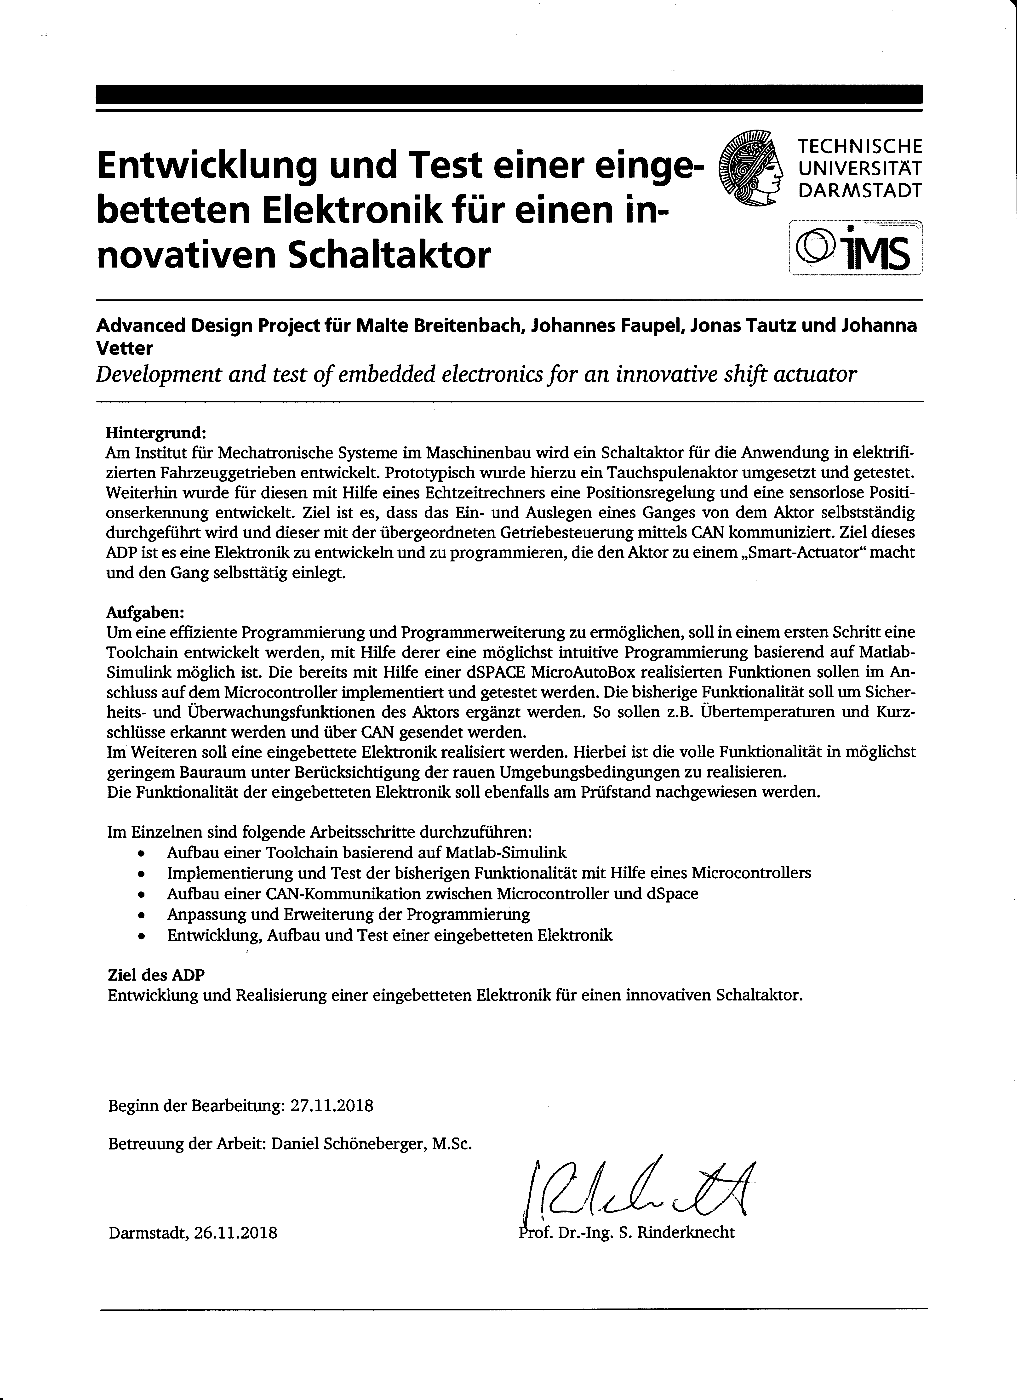
[picture p114: page 1]
