malbreitenbach/adp_tauchspulenelektronik/Ausarbeitung/ADP_ausarbeitung/input/aufgabenstellung2.pdf

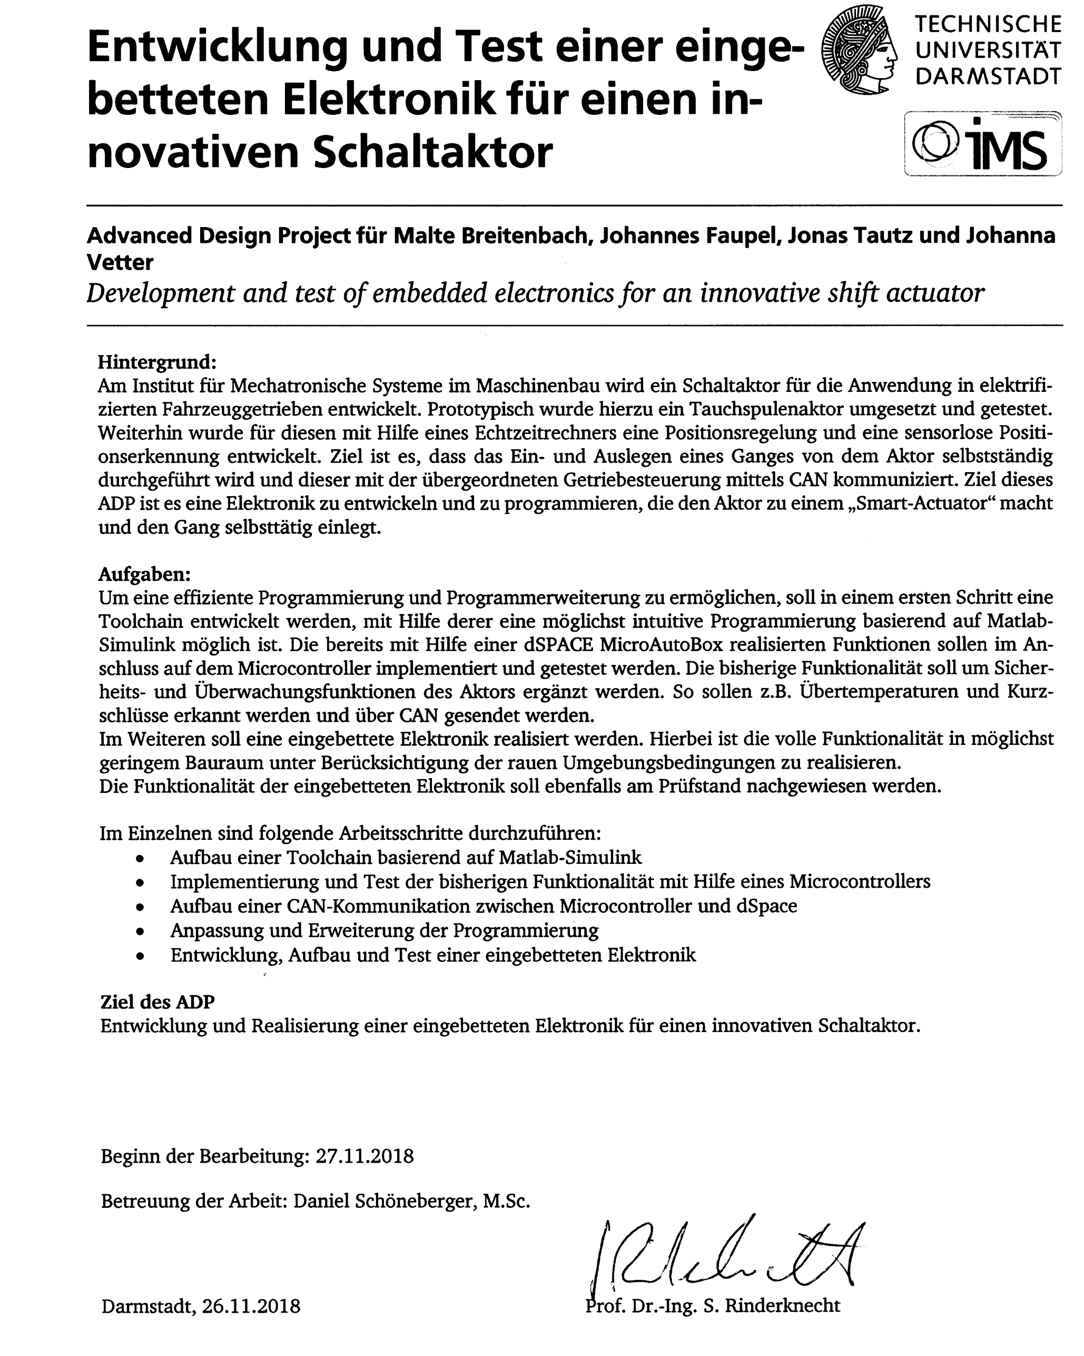
[picture p115: page 1]
