malbreitenbach/adp_tauchspulenelektronik/Ausarbeitung/ADP_ausarbeitung/Bilder/fig_conh_cons.pdf

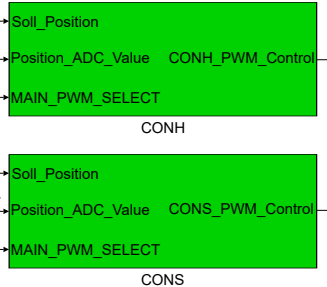
[picture p116: figure]
Soll_Position; Position_ADC_Value; MAIN_PWM_SELECT; CONH_PWM_Control; CONH; CONS; CONS_PWM_Control
