malbreitenbach/adp_tauchspulenelektronik/Ausarbeitung/ADP_ausarbeitung/Bilder/QuerschnittAktordo.pdf

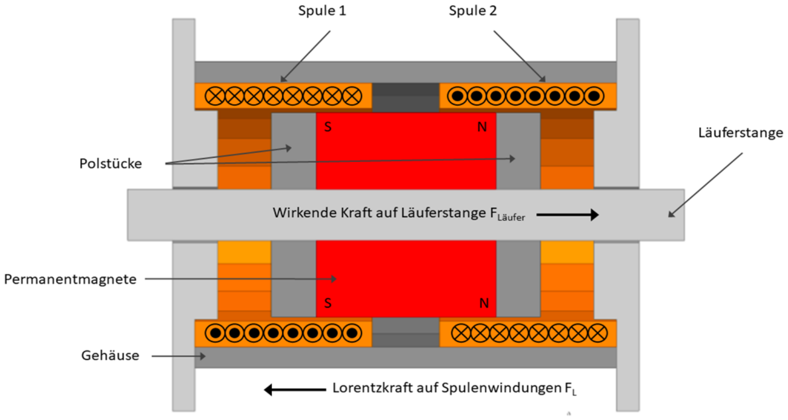
[picture p117: page 1]
