malbreitenbach/adp_tauchspulenelektronik/Ausarbeitung/ADP_ausarbeitung/Bilder/fig_main.pdf

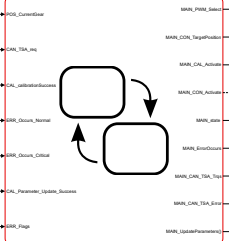
[picture p118: figure]
POS_CurrentGear; CAN_TSA_req; CAL_calibrationSuccess; ERR_Occurs_Normal; ERR_Occurs_Critical; CAL_Parameter_Update_Success; ERR_Flags; MAIN_PWM_Select; MAIN_CON_TargetPosition; MAIN_CAL_Activate; MAIN_CON_Activate; MAIN_state; MAIN_ErrorOccurs; MAIN_CAN_TSA_Trqs; MAIN_CAN_TSA_Error; MAIN_UpdateParameters()

### Main State Chart
