malbreitenbach/adp_tauchspulenelektronik/Ausarbeitung/ADP_ausarbeitung/Bilder/hbruecke.pdf

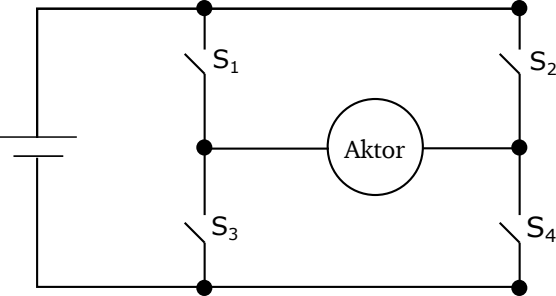
[picture p119: figure]
Aktor
