malbreitenbach/adp_tauchspulenelektronik/Ausarbeitung/ADP_ausarbeitung/Bilder/Blockschaltbild Mikrocontroller.png

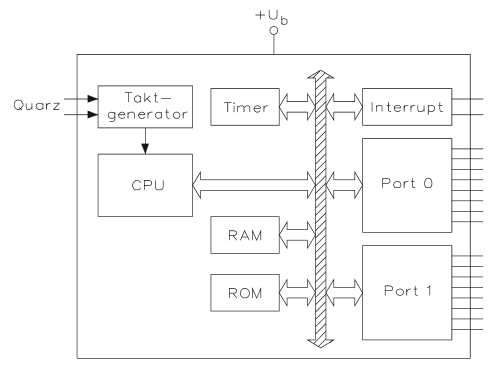
Ausarbeitung/ADP_ausarbeitung/Bilder/Blockschaltbild Mikrocontroller.png
