malbreitenbach/adp_tauchspulenelektronik/Ausarbeitung/ADP_ausarbeitung/Bilder/fig_entw_evo2.png

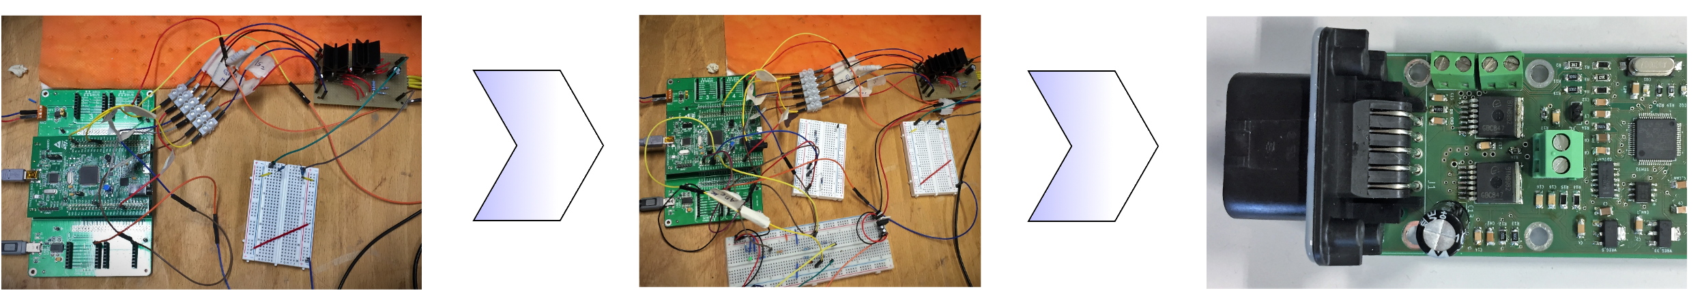
Ausarbeitung/ADP_ausarbeitung/Bilder/fig_entw_evo2.png
