malbreitenbach/adp_tauchspulenelektronik/Ausarbeitung/ADP_ausarbeitung/Bilder/fig_entw_evo3.png

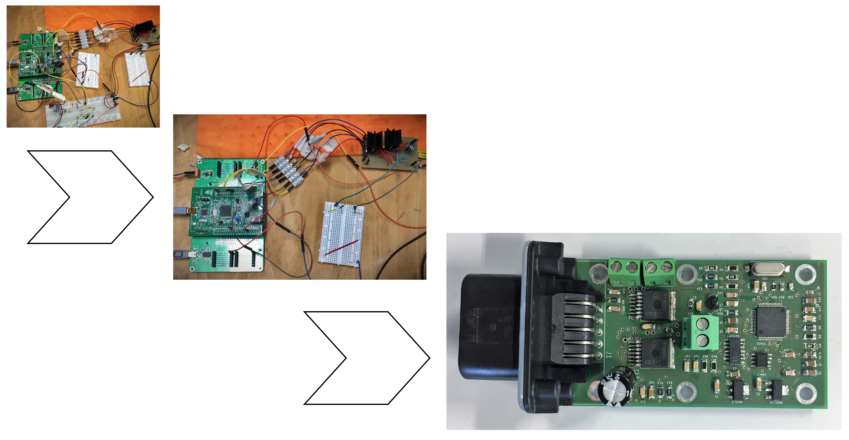
Ausarbeitung/ADP_ausarbeitung/Bilder/fig_entw_evo3.png
