malbreitenbach/adp_tauchspulenelektronik/Ausarbeitung/ADP_ausarbeitung/Bilder/IMG_5610.JPG

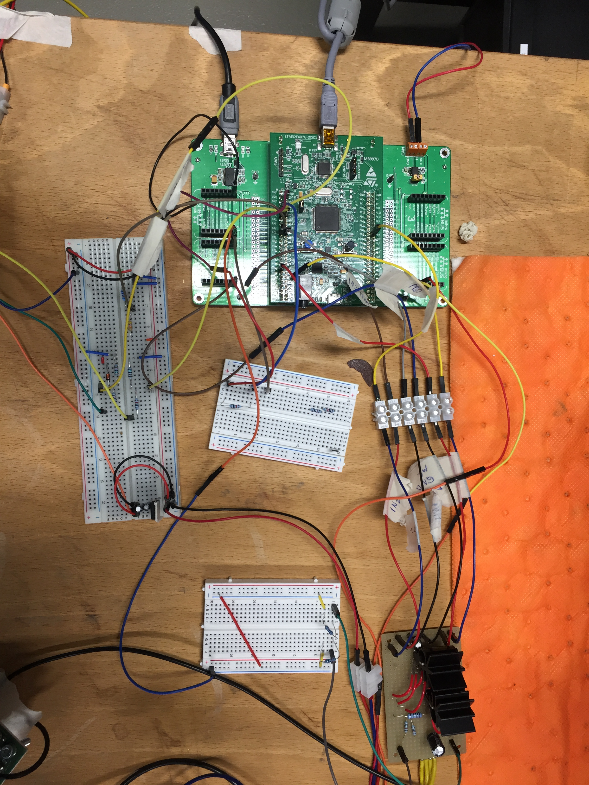
Ausarbeitung/ADP_ausarbeitung/Bilder/IMG_5610.JPG
