malbreitenbach/adp_tauchspulenelektronik/Ausarbeitung/ADP_ausarbeitung/Bilder/IMG_5612.JPG

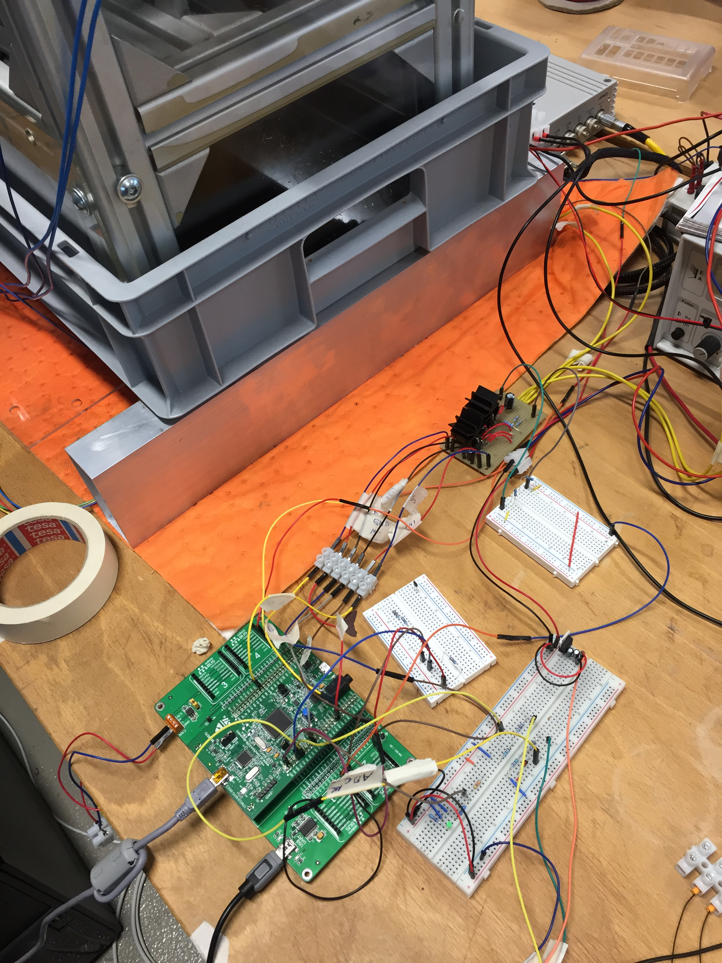
Ausarbeitung/ADP_ausarbeitung/Bilder/IMG_5612.JPG
