malbreitenbach/adp_tauchspulenelektronik/Ausarbeitung/ADP_ausarbeitung/Bilder/IMG_5613.JPG

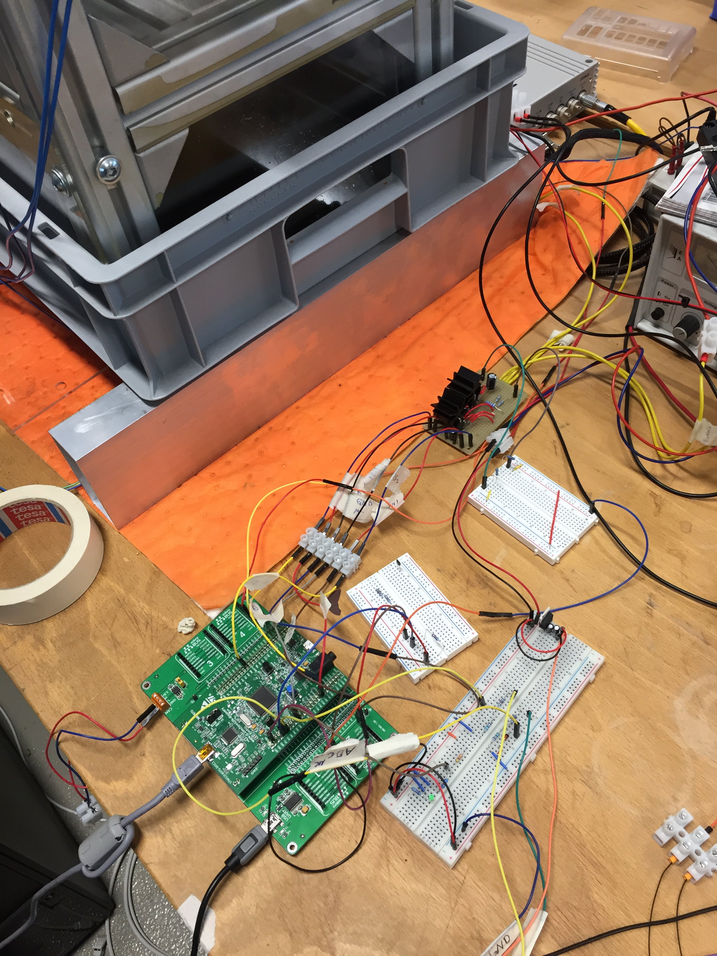
Ausarbeitung/ADP_ausarbeitung/Bilder/IMG_5613.JPG
