malbreitenbach/adp_tauchspulenelektronik/Ausarbeitung/ADP_ausarbeitung/Bilder/IMG_5614.JPG

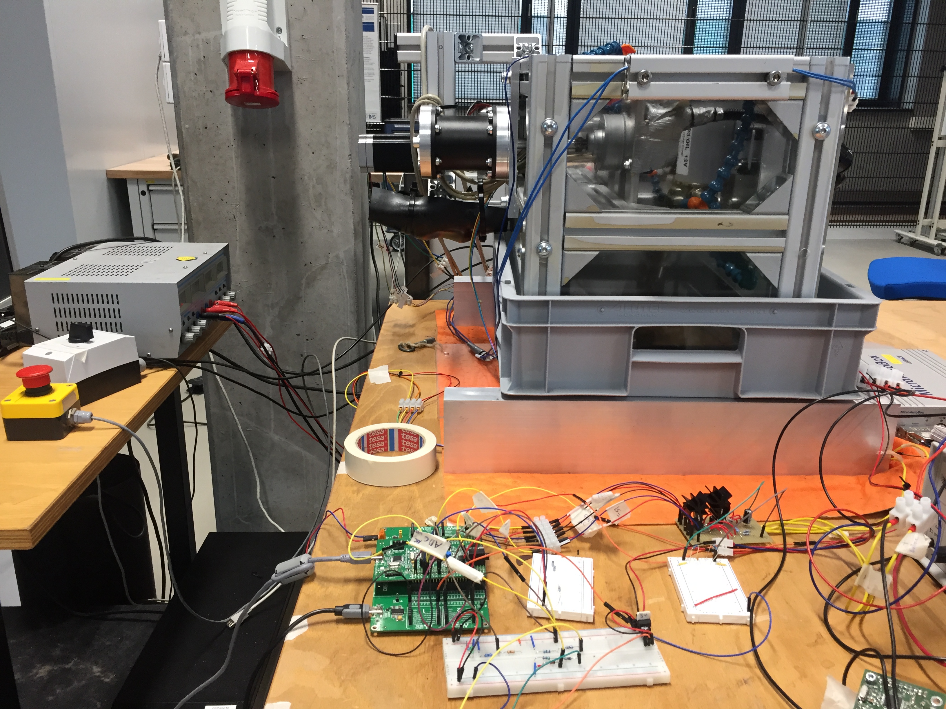
Ausarbeitung/ADP_ausarbeitung/Bilder/IMG_5614.JPG
