malbreitenbach/adp_tauchspulenelektronik/Ausarbeitung/ADP_ausarbeitung/Bilder/IMG_5615.JPG

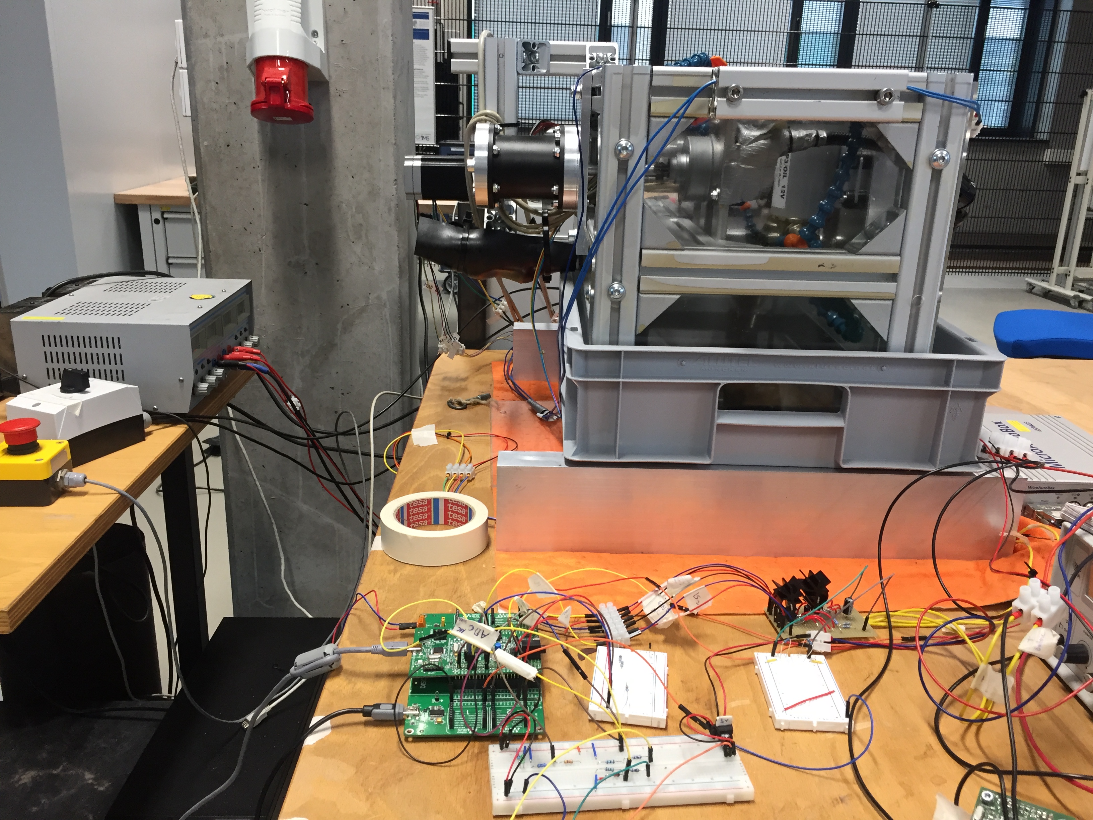
Ausarbeitung/ADP_ausarbeitung/Bilder/IMG_5615.JPG
