malbreitenbach/adp_tauchspulenelektronik/Ausarbeitung/ADP_ausarbeitung/Bilder/IMG_5617.JPG

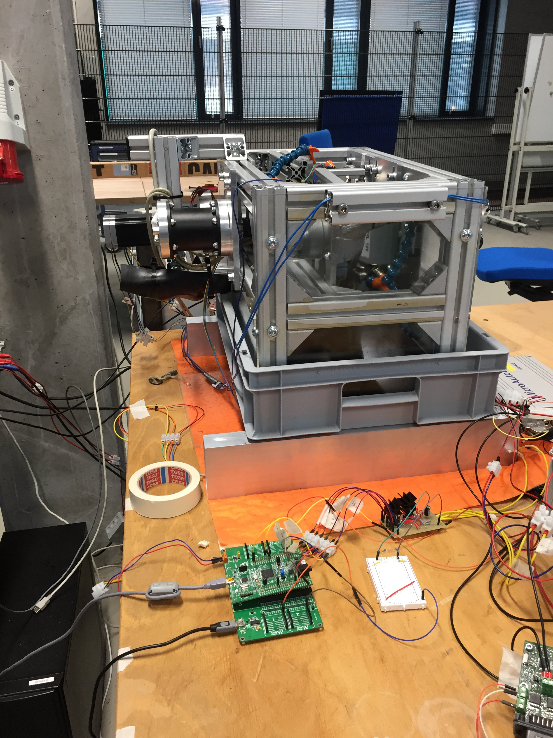
Ausarbeitung/ADP_ausarbeitung/Bilder/IMG_5617.JPG
