malbreitenbach/adp_tauchspulenelektronik/Ausarbeitung/ADP_ausarbeitung/Bilder/IMG_5618.JPG

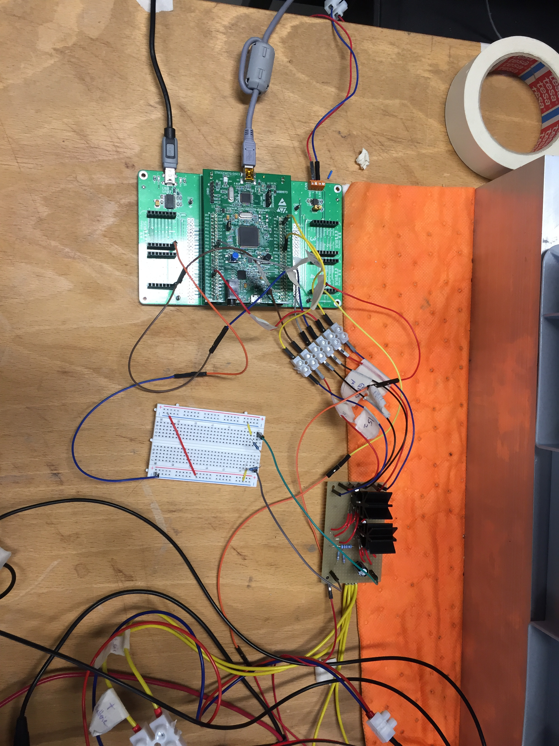
Ausarbeitung/ADP_ausarbeitung/Bilder/IMG_5618.JPG
