malbreitenbach/adp_tauchspulenelektronik/Ausarbeitung/ADP_ausarbeitung/Bilder/IMG_5619.JPG

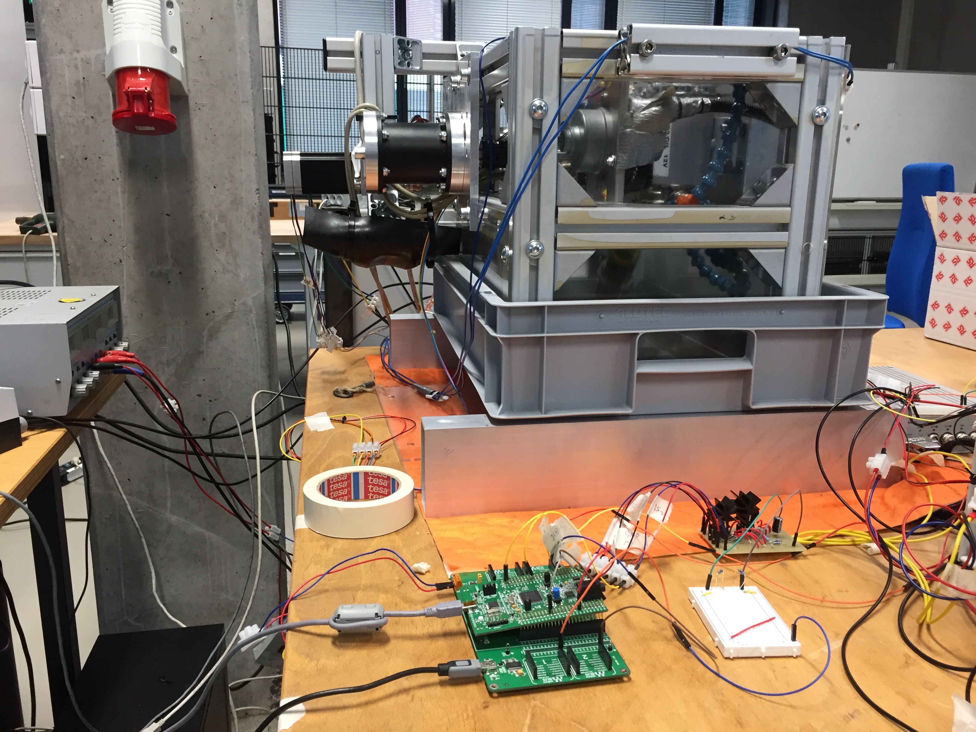
Ausarbeitung/ADP_ausarbeitung/Bilder/IMG_5619.JPG
