malbreitenbach/adp_tauchspulenelektronik/Ausarbeitung/ADP_ausarbeitung/Bilder/pla_top.jpg

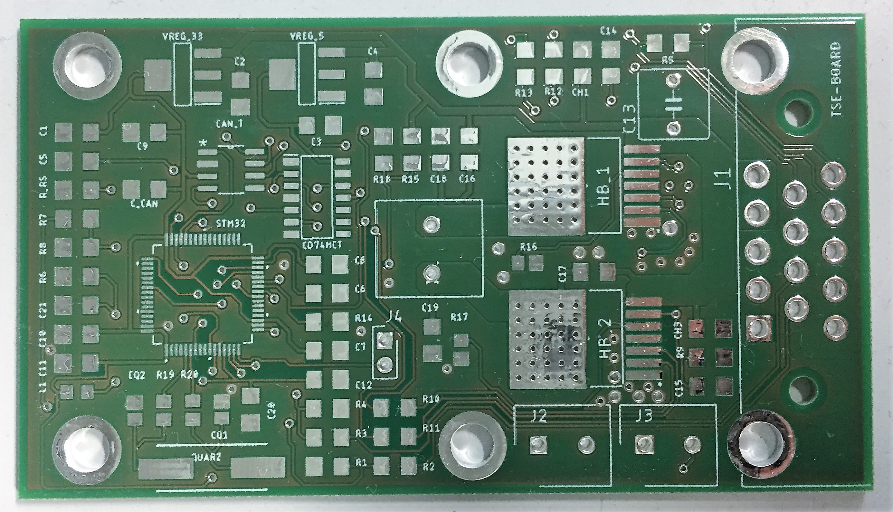
Ausarbeitung/ADP_ausarbeitung/Bilder/pla_top.jpg
