malbreitenbach/adp_tauchspulenelektronik/Ausarbeitung/ADP_ausarbeitung/Bilder/PlatineAktor.jpg

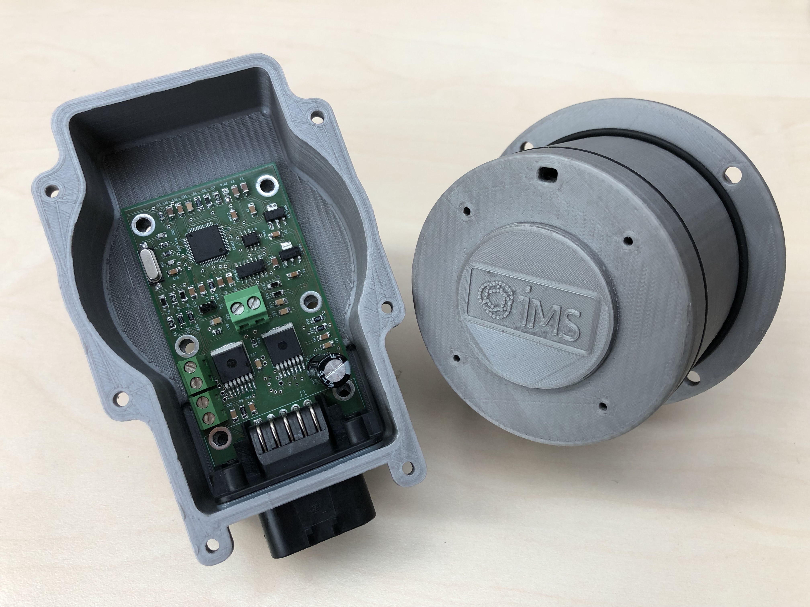
Ausarbeitung/ADP_ausarbeitung/Bilder/PlatineAktor.jpg
