malbreitenbach/adp_tauchspulenelektronik/Ausarbeitung/ADP_ausarbeitung/Bilder/PlatinePruefstand.jpg

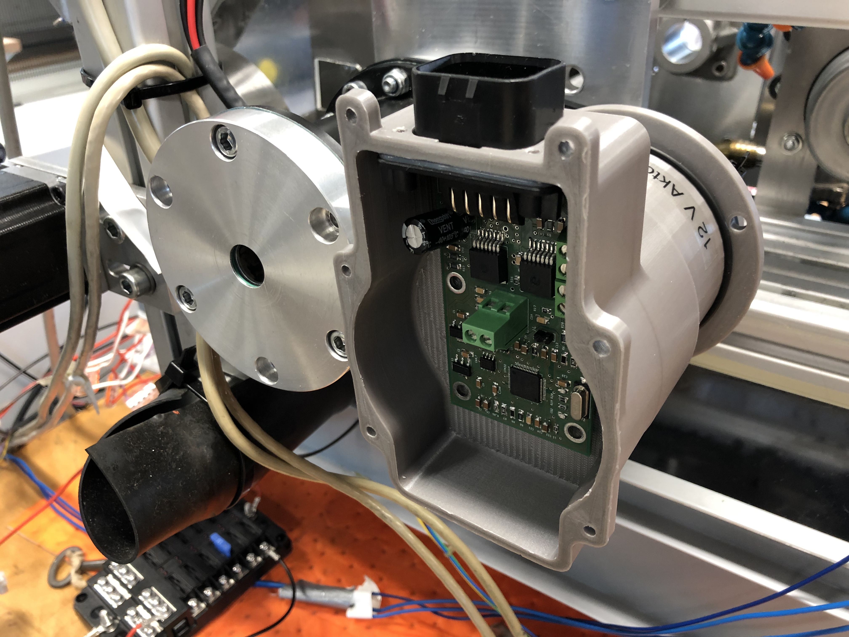
Ausarbeitung/ADP_ausarbeitung/Bilder/PlatinePruefstand.jpg
