malbreitenbach/adp_tauchspulenelektronik/Ausarbeitung/ADP_ausarbeitung/Bilder/Proto_v1.jpg

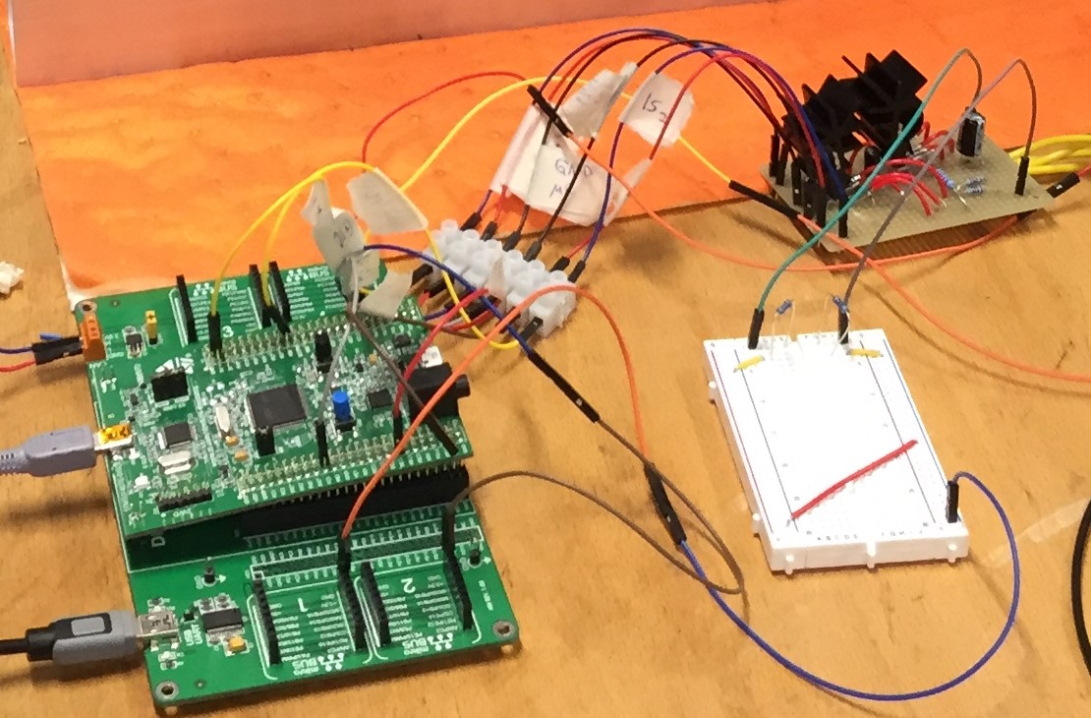
Ausarbeitung/ADP_ausarbeitung/Bilder/Proto_v1.jpg
