malbreitenbach/adp_tauchspulenelektronik/Ausarbeitung/ADP_ausarbeitung/Bilder/Proto_V2.jpg

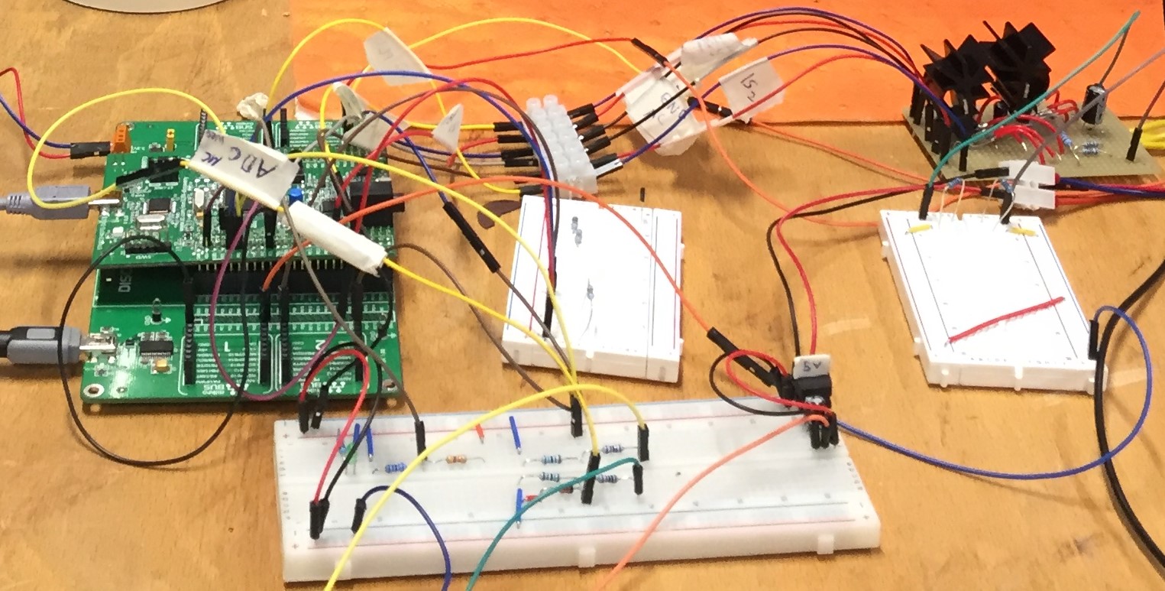
Ausarbeitung/ADP_ausarbeitung/Bilder/Proto_V2.jpg
