malbreitenbach/adp_tauchspulenelektronik/Ausarbeitung/ADP_ausarbeitung/Bilder/Proto_V3.JPG

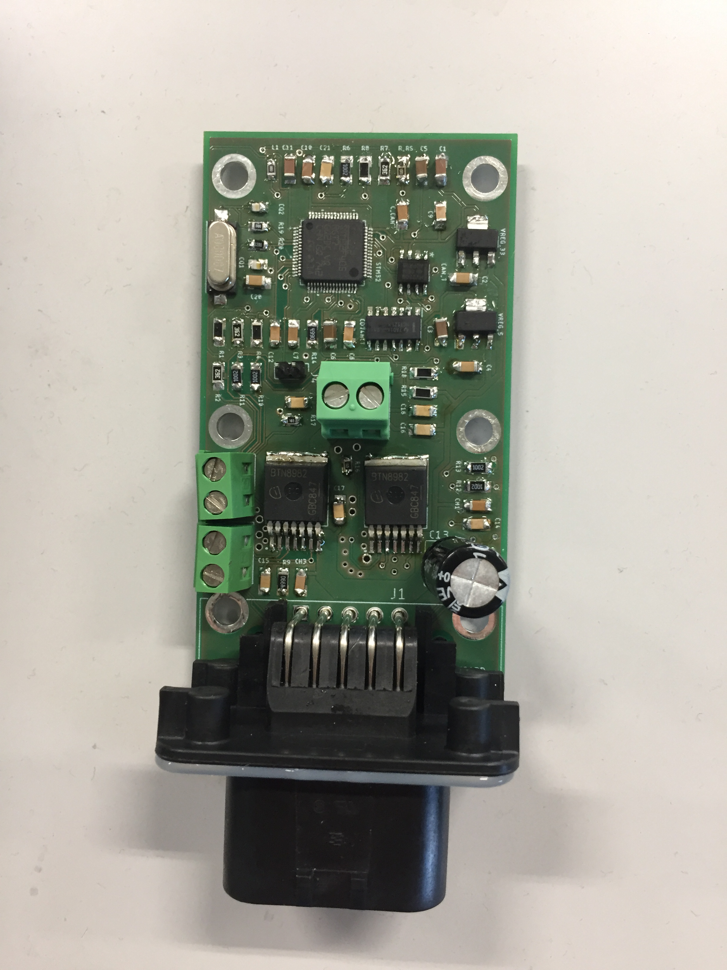
Ausarbeitung/ADP_ausarbeitung/Bilder/Proto_V3.JPG
