malbreitenbach/adp_tauchspulenelektronik/Ausarbeitung/ADP_ausarbeitung/Bilder/Schaltung HBruecke.jpg

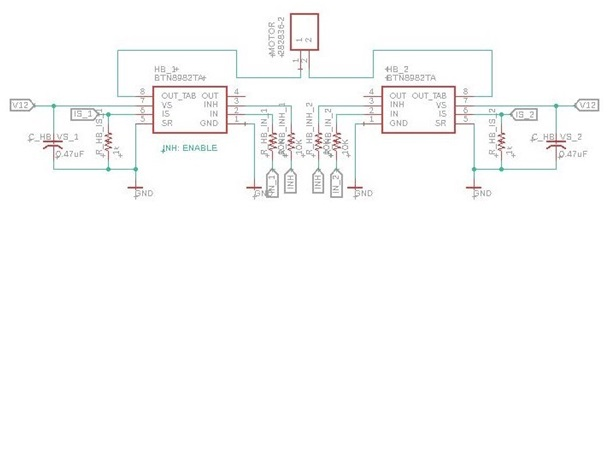
Ausarbeitung/ADP_ausarbeitung/Bilder/Schaltung HBruecke.jpg
