malbreitenbach/adp_tauchspulenelektronik/Ausarbeitung/ADP_ausarbeitung/Bilder/Sensor.png

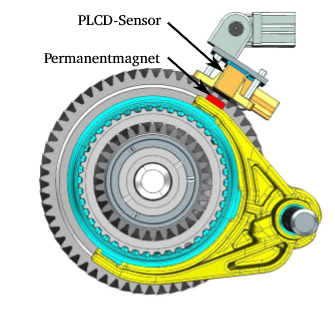
Ausarbeitung/ADP_ausarbeitung/Bilder/Sensor.png
