malbreitenbach/adp_tauchspulenelektronik/Ausarbeitung/ADP_ausarbeitung/Bilder/Sprungantwort Schaltgabelposition.png

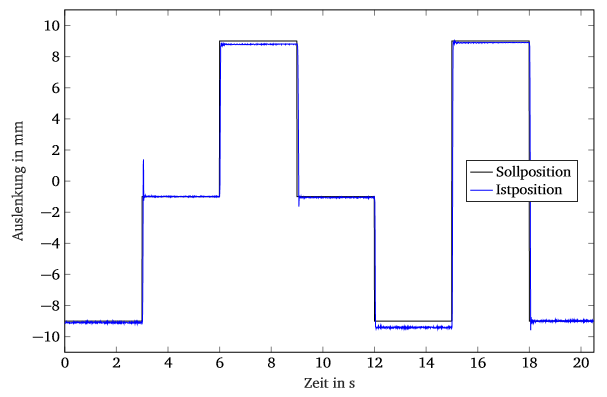
Ausarbeitung/ADP_ausarbeitung/Bilder/Sprungantwort Schaltgabelposition.png
