malbreitenbach/adp_tauchspulenelektronik/Ausarbeitung/ADP_ausarbeitung/Bilder/VergleichPlatine.jpg

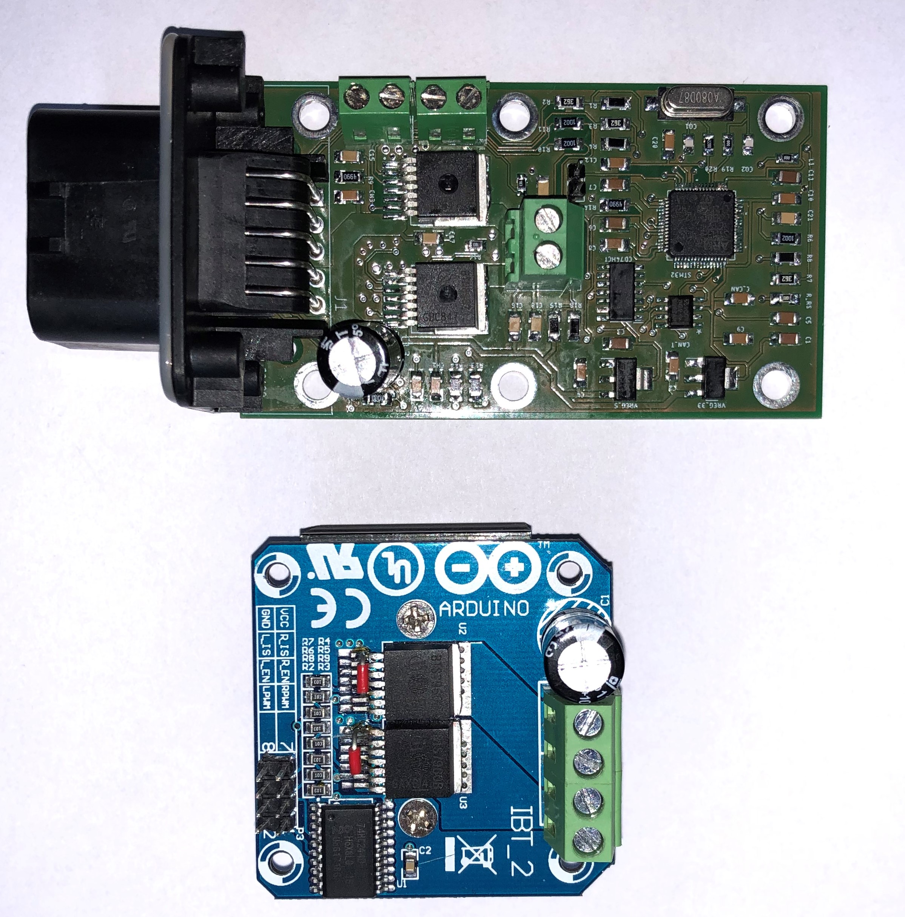
Ausarbeitung/ADP_ausarbeitung/Bilder/VergleichPlatine.jpg
