malbreitenbach/adp_tauchspulenelektronik/Literatur/Informationsblaetter/Beispielplan_Board.png

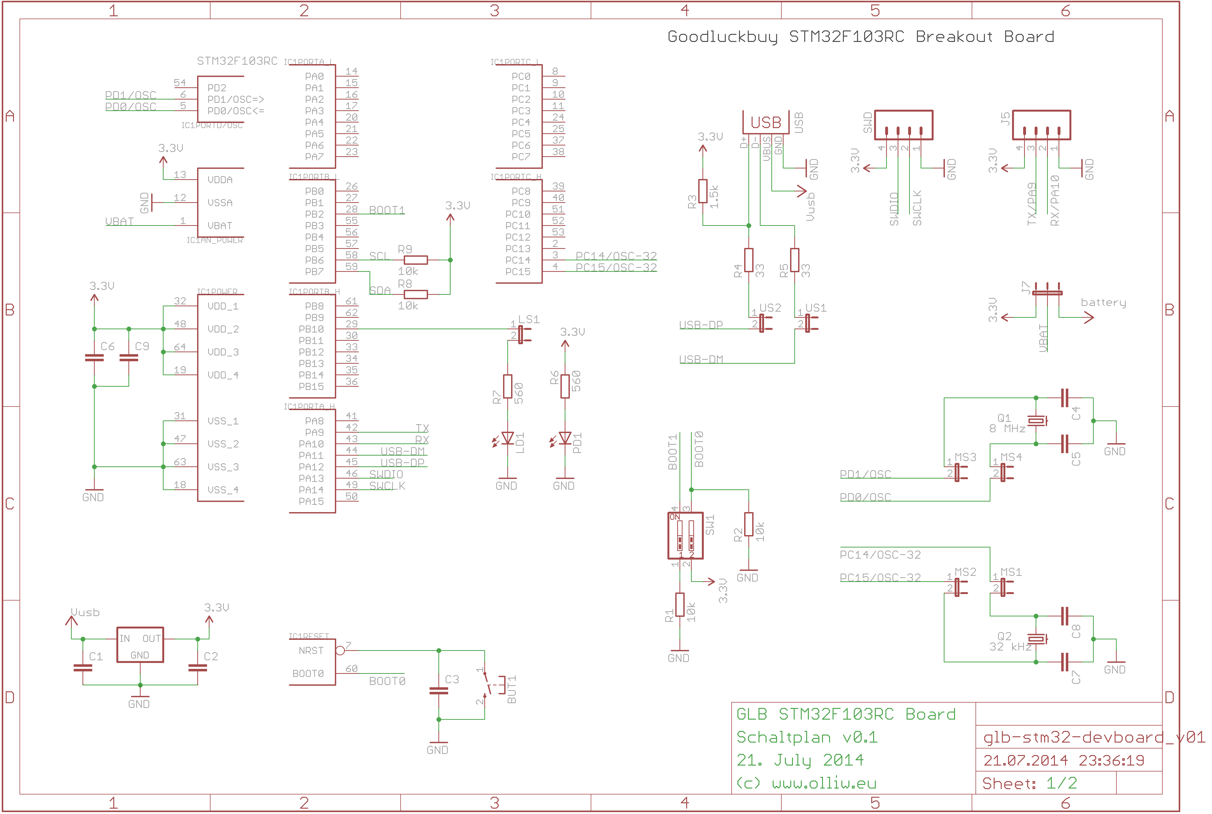
Literatur/Informationsblaetter/Beispielplan_Board.png
