malbreitenbach/adp_tauchspulenelektronik/Platinenentwurf/BoardBilder/BoardB1.JPG

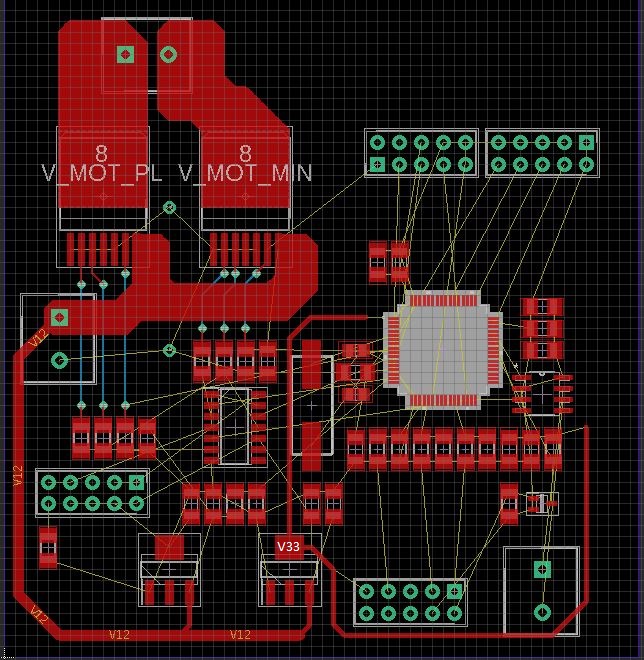
Platinenentwurf/BoardBilder/BoardB1.JPG
