malbreitenbach/adp_tauchspulenelektronik/Platinenentwurf/BoardBilder/BoardB2.JPG

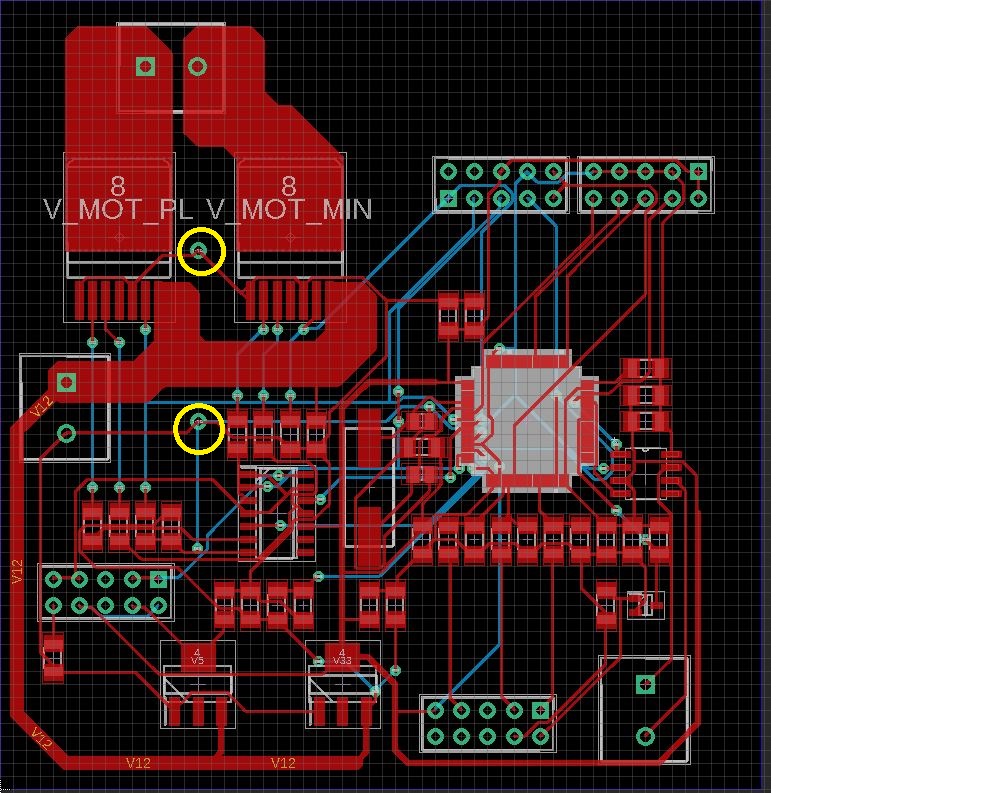
Platinenentwurf/BoardBilder/BoardB2.JPG
