malbreitenbach/adp_tauchspulenelektronik/Platinenentwurf/BoardBilder/BoardB3.JPG

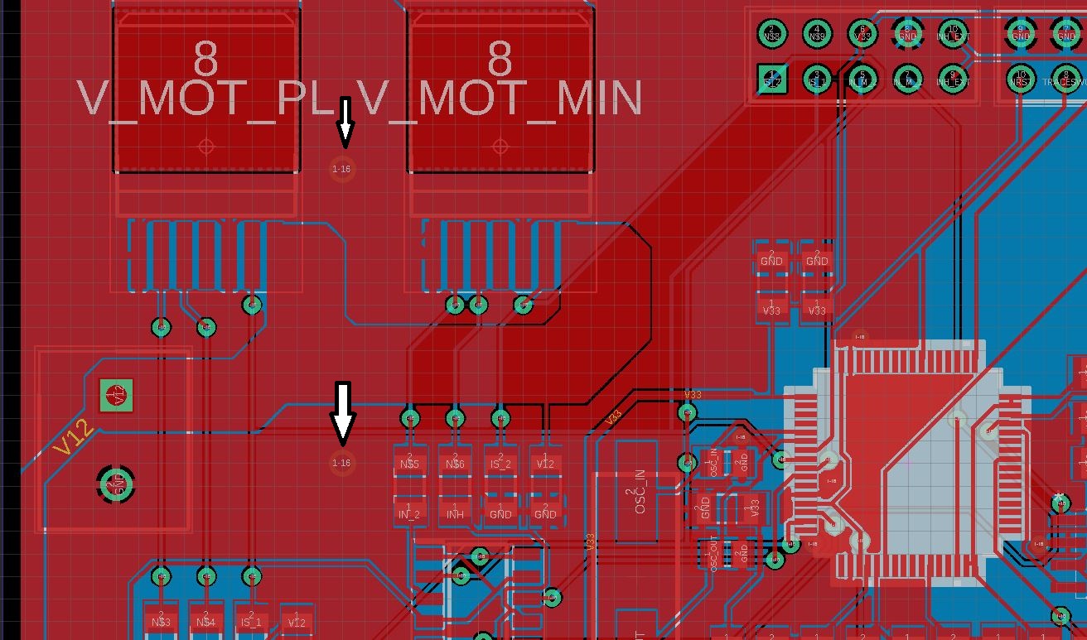
Platinenentwurf/BoardBilder/BoardB3.JPG
