malbreitenbach/adp_tauchspulenelektronik/Platinenentwurf/BoardBilder/CAD-Bilder/Elektronik_Gehauese2.png

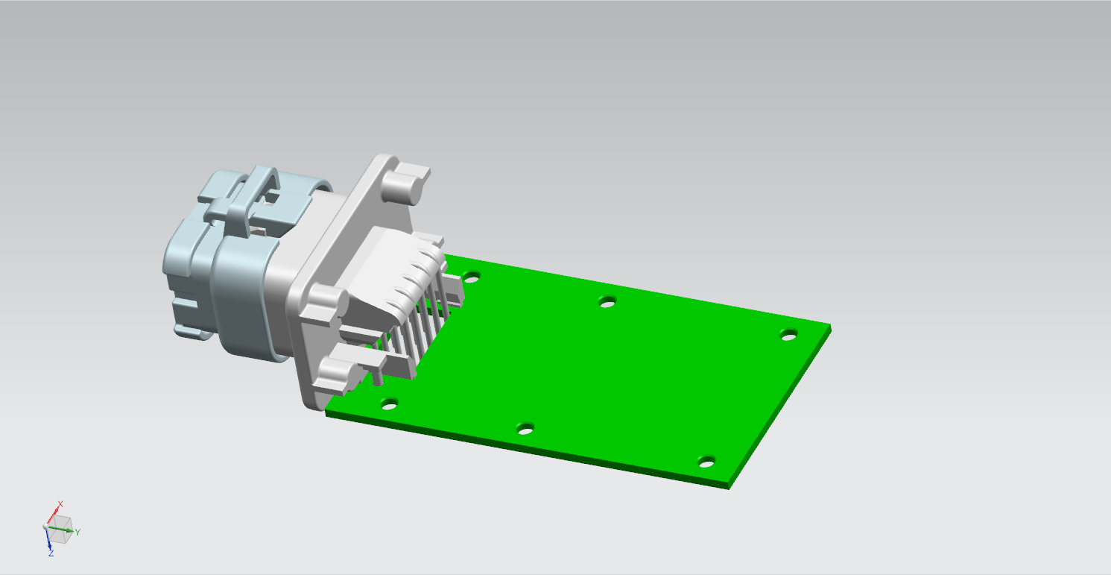
Platinenentwurf/BoardBilder/CAD-Bilder/Elektronik_Gehauese2.png
