malbreitenbach/adp_tauchspulenelektronik/Platinenentwurf/BoardBilder/CAD-Bilder/Elektronik_Gehauese.png

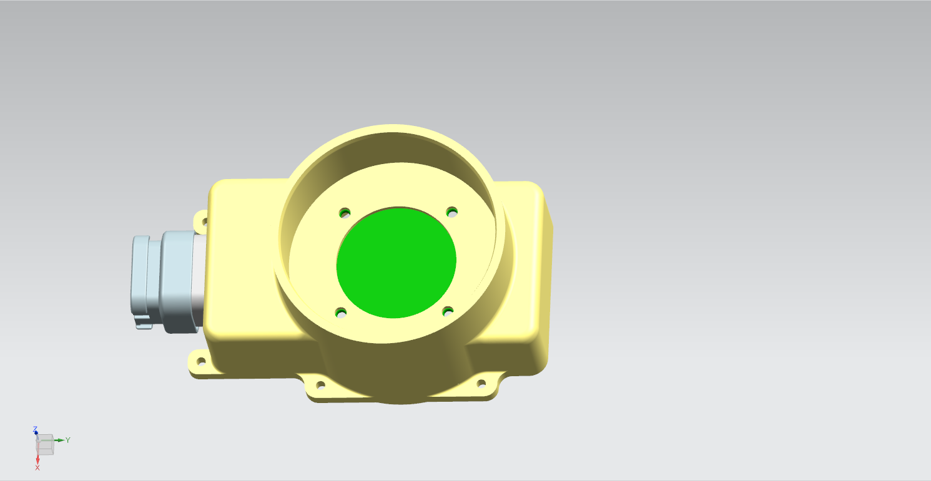
Platinenentwurf/BoardBilder/CAD-Bilder/Elektronik_Gehauese.png
