malbreitenbach/adp_tauchspulenelektronik/Platinenentwurf/BoardBilder/CAD-Bilder/Elektronik_Gehauese_ver3.png

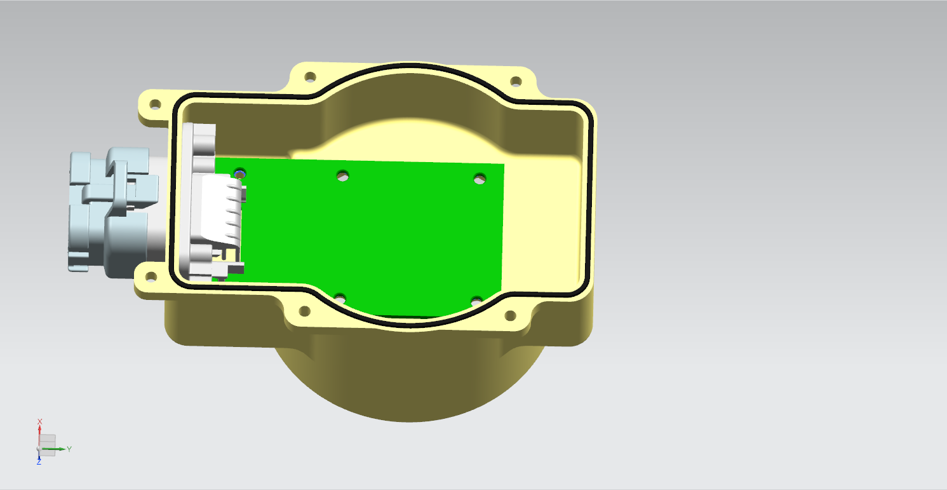
Platinenentwurf/BoardBilder/CAD-Bilder/Elektronik_Gehauese_ver3.png
