malbreitenbach/adp_tauchspulenelektronik/Platinenentwurf/BoardBilder/CAD-Bilder/Elektronik_Gehauese_ver3.tif

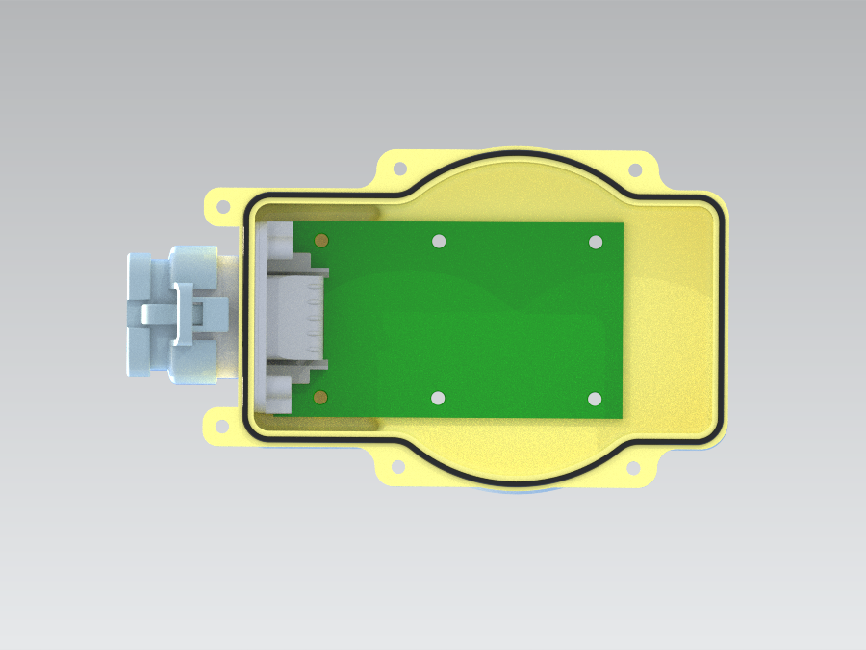
Platinenentwurf/BoardBilder/CAD-Bilder/Elektronik_Gehauese_ver3.tif
