malbreitenbach/adp_tauchspulenelektronik/Platinenentwurf/BoardBilder/CAD-Bilder/platinen_Stecker_dummy.png

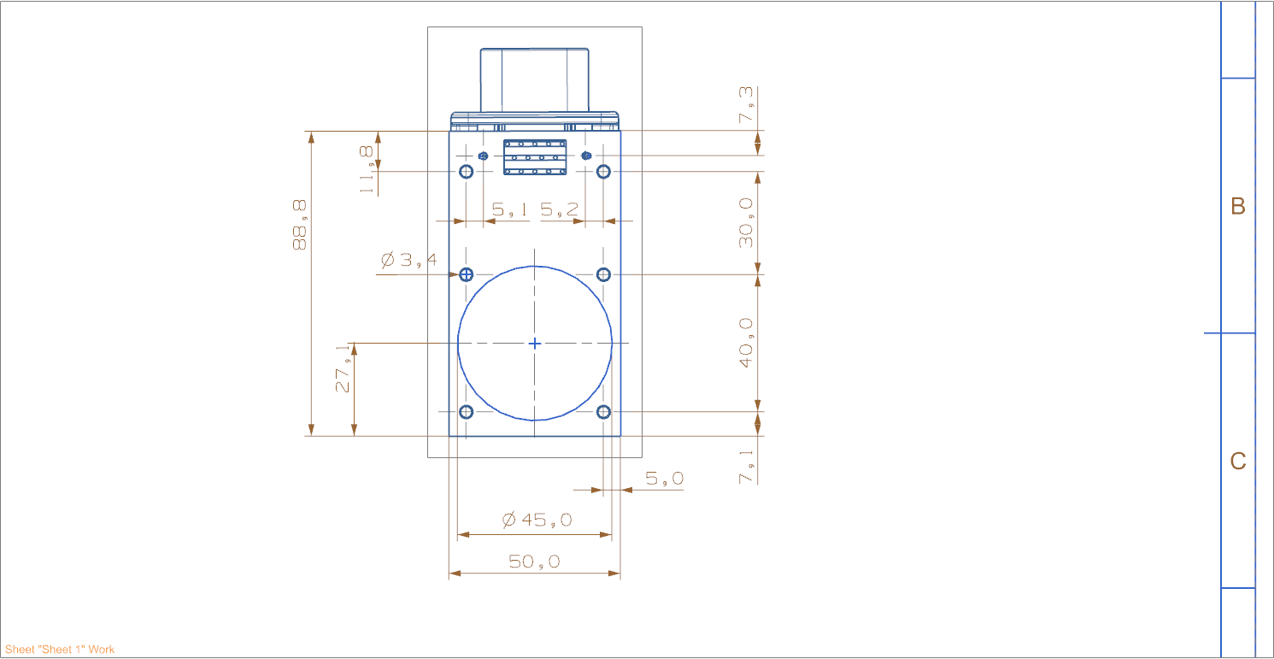
Platinenentwurf/BoardBilder/CAD-Bilder/platinen_Stecker_dummy.png
