malbreitenbach/adp_tauchspulenelektronik/Platinenentwurf/BoardBilder/CAD-Bilder/studio_image_capture.png

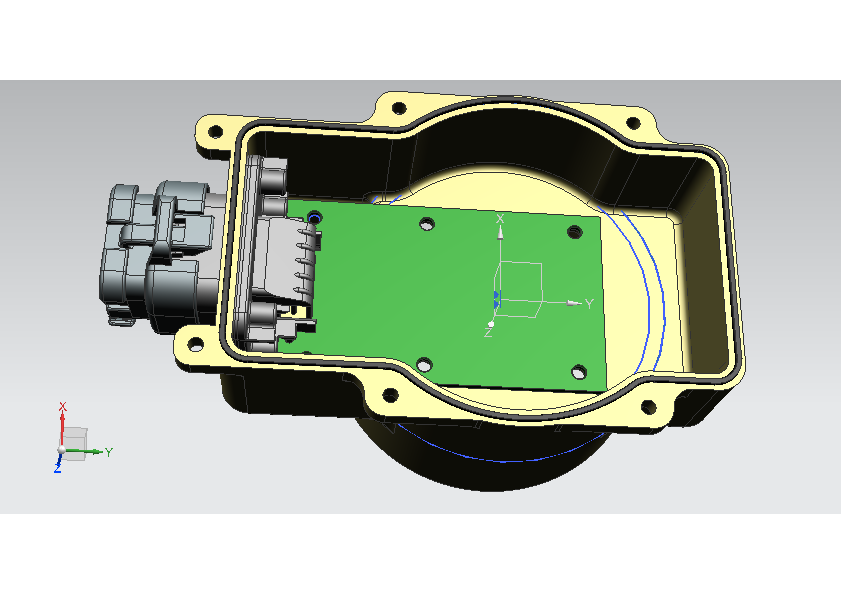
Platinenentwurf/BoardBilder/CAD-Bilder/studio_image_capture.png
