malbreitenbach/adp_tauchspulenelektronik/Platinenentwurf/BoardBilder/footprintHB.JPG

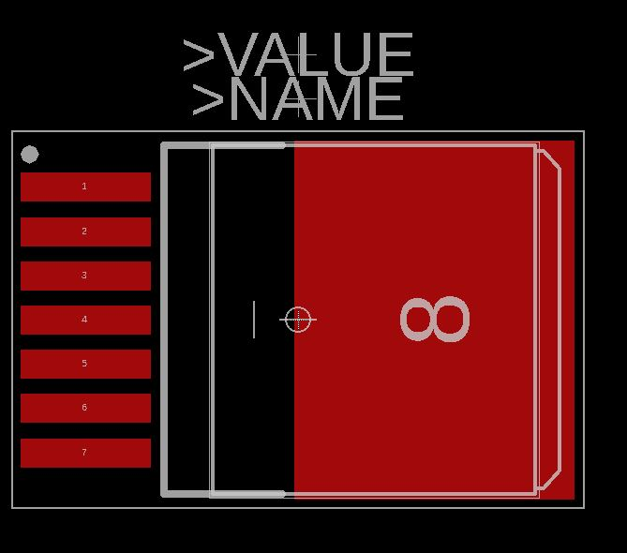
Platinenentwurf/BoardBilder/footprintHB.JPG
