malbreitenbach/adp_tauchspulenelektronik/Platinenentwurf/BoardBilder/GND_VIAs.JPG

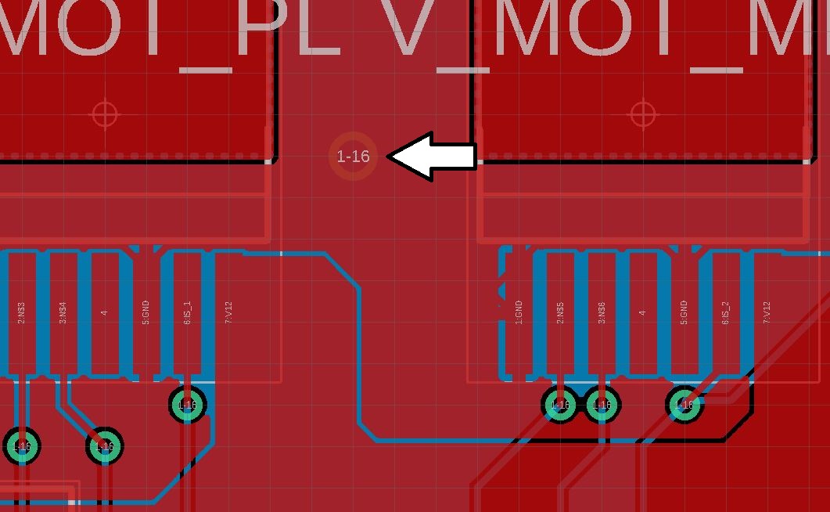
Platinenentwurf/BoardBilder/GND_VIAs.JPG
