malbreitenbach/adp_tauchspulenelektronik/Platinenentwurf/BoardBilder/HB.JPG

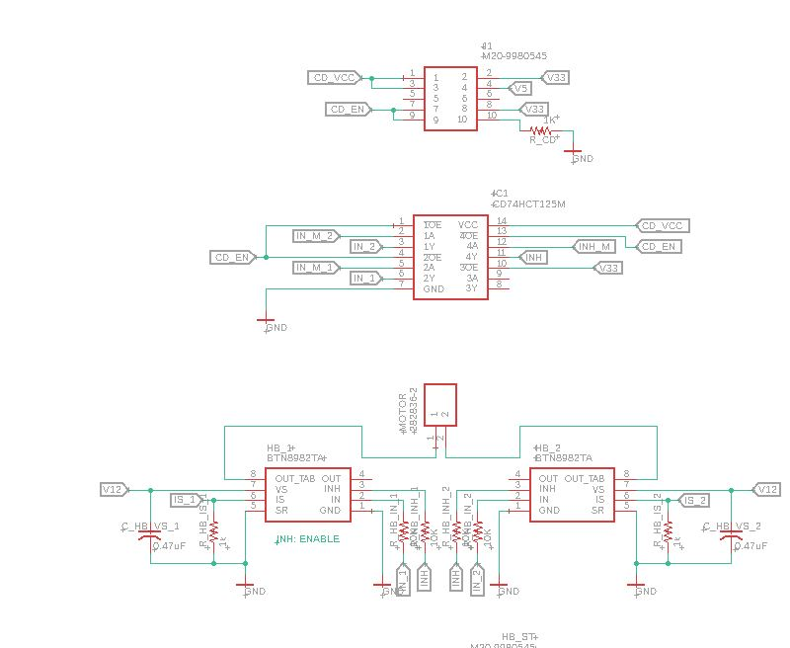
Platinenentwurf/BoardBilder/HB.JPG
