malbreitenbach/adp_tauchspulenelektronik/Platinenentwurf/BoardBilder/IMG_5462.JPG

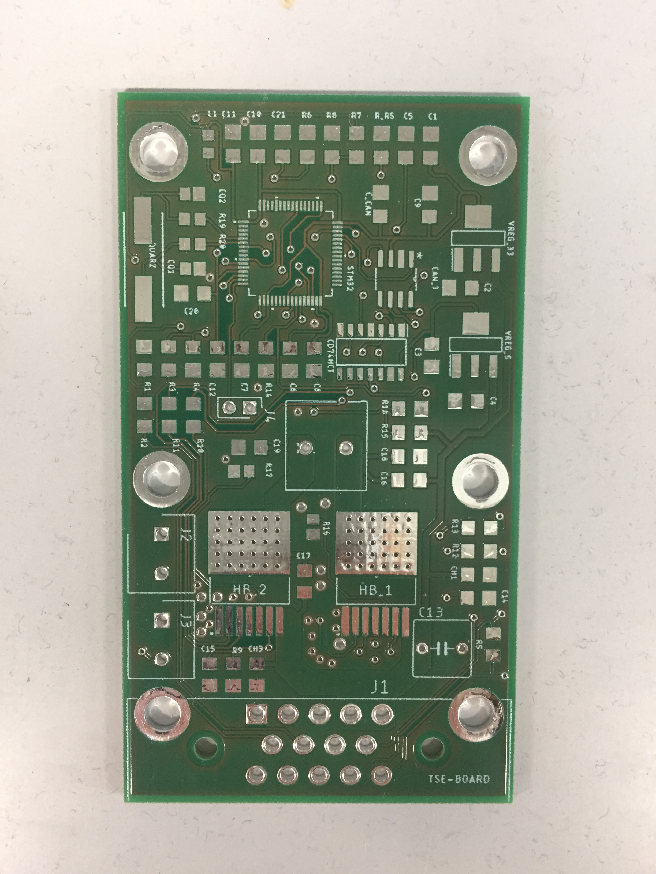
Platinenentwurf/BoardBilder/IMG_5462.JPG
