malbreitenbach/adp_tauchspulenelektronik/Platinenentwurf/BoardBilder/IMG_5463.JPG

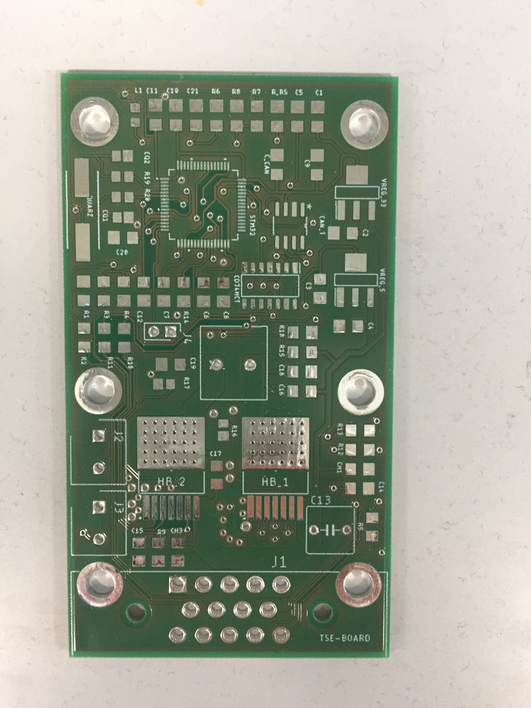
Platinenentwurf/BoardBilder/IMG_5463.JPG
