malbreitenbach/adp_tauchspulenelektronik/Platinenentwurf/BoardBilder/IMG_5464.JPG

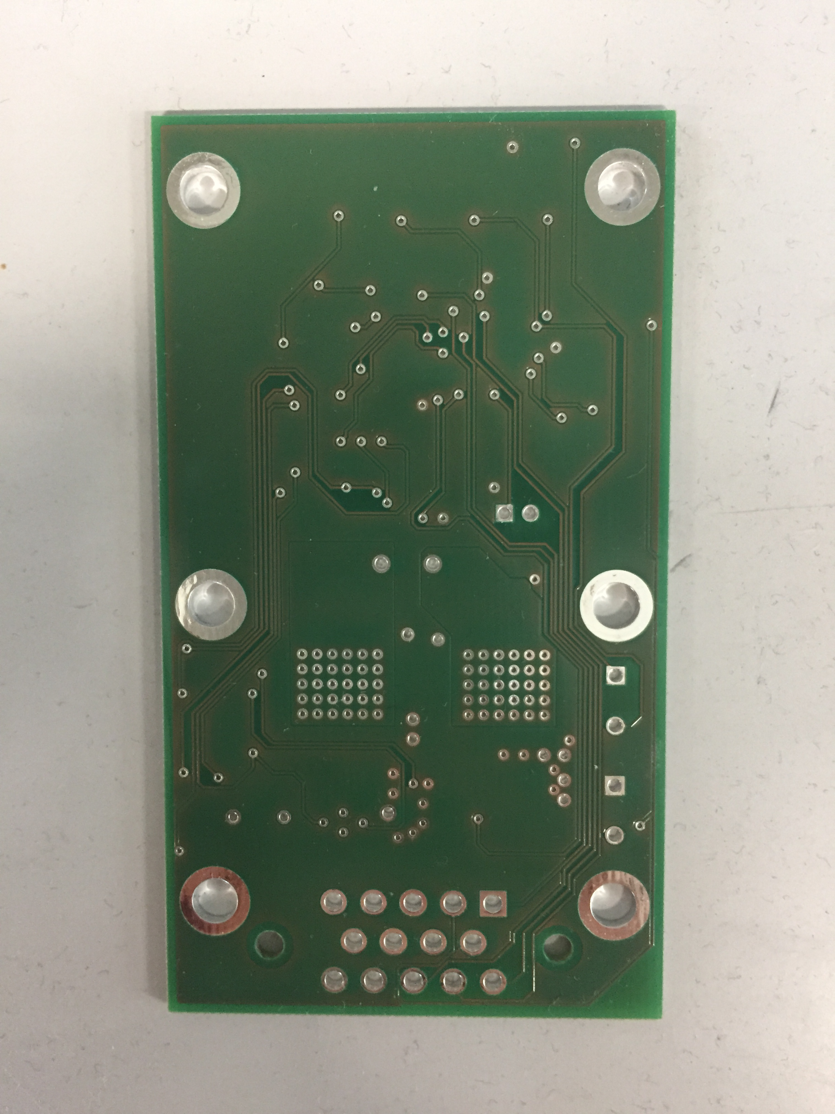
Platinenentwurf/BoardBilder/IMG_5464.JPG
