malbreitenbach/adp_tauchspulenelektronik/Platinenentwurf/BoardBilder/IMG_5466.JPG

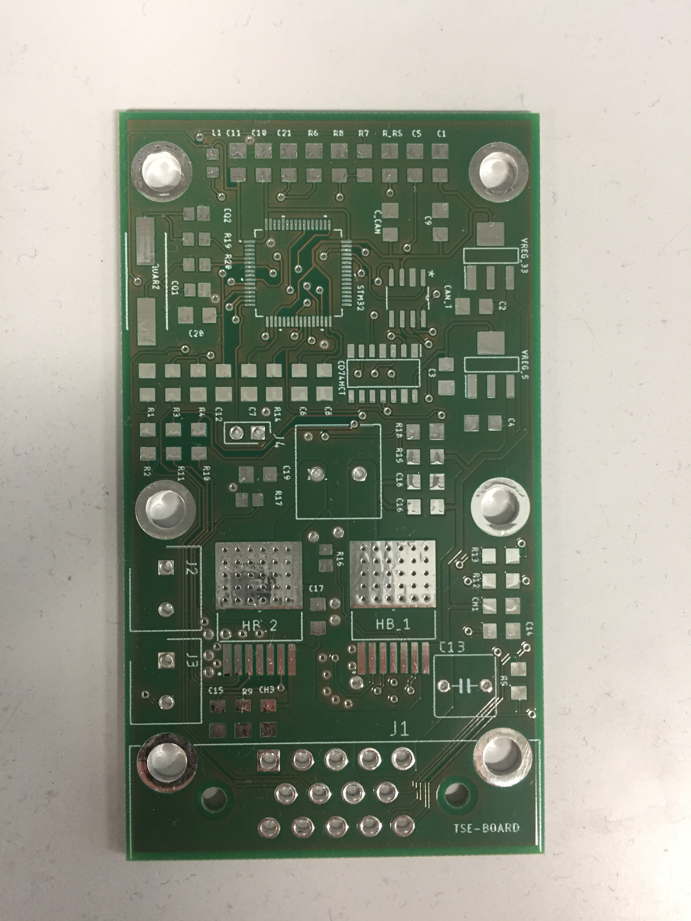
Platinenentwurf/BoardBilder/IMG_5466.JPG
