malbreitenbach/adp_tauchspulenelektronik/Platinenentwurf/BoardBilder/IMG_5467.JPG

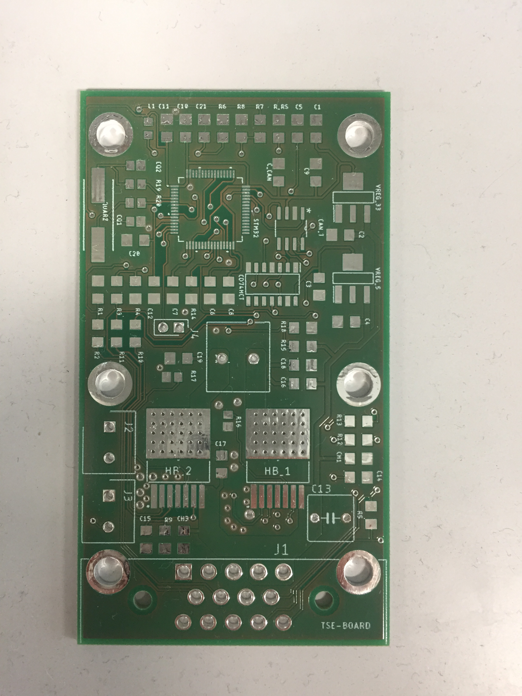
Platinenentwurf/BoardBilder/IMG_5467.JPG
