malbreitenbach/adp_tauchspulenelektronik/Platinenentwurf/BoardBilder/MCU.JPG

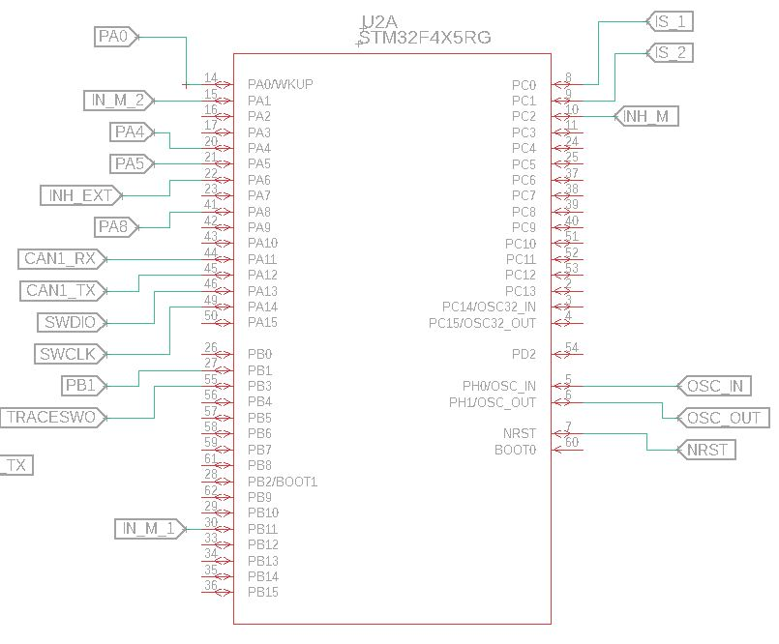
Platinenentwurf/BoardBilder/MCU.JPG
