malbreitenbach/adp_tauchspulenelektronik/Platinenentwurf/BoardBilder/MCU_mit_Quartz.JPG

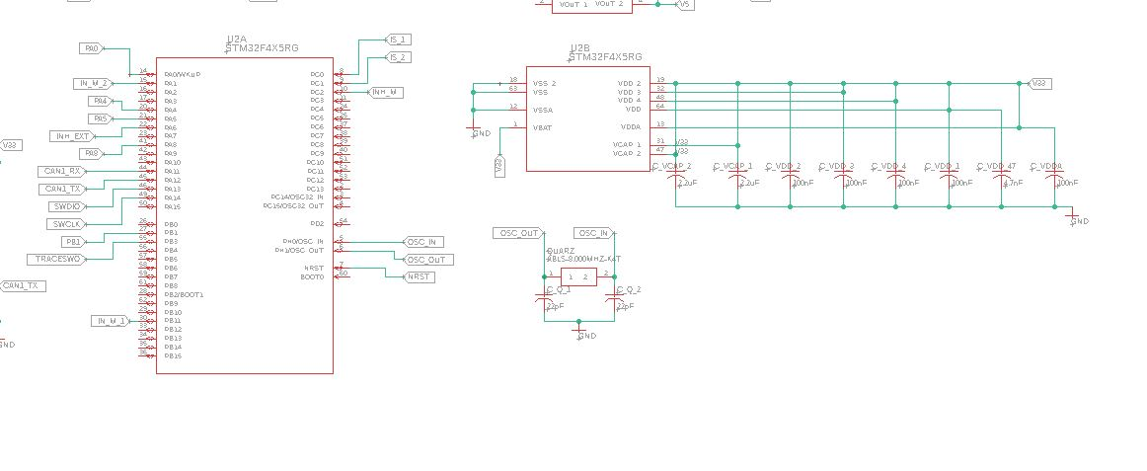
Platinenentwurf/BoardBilder/MCU_mit_Quartz.JPG
