malbreitenbach/adp_tauchspulenelektronik/Platinenentwurf/BoardBilder/PINOUT.png

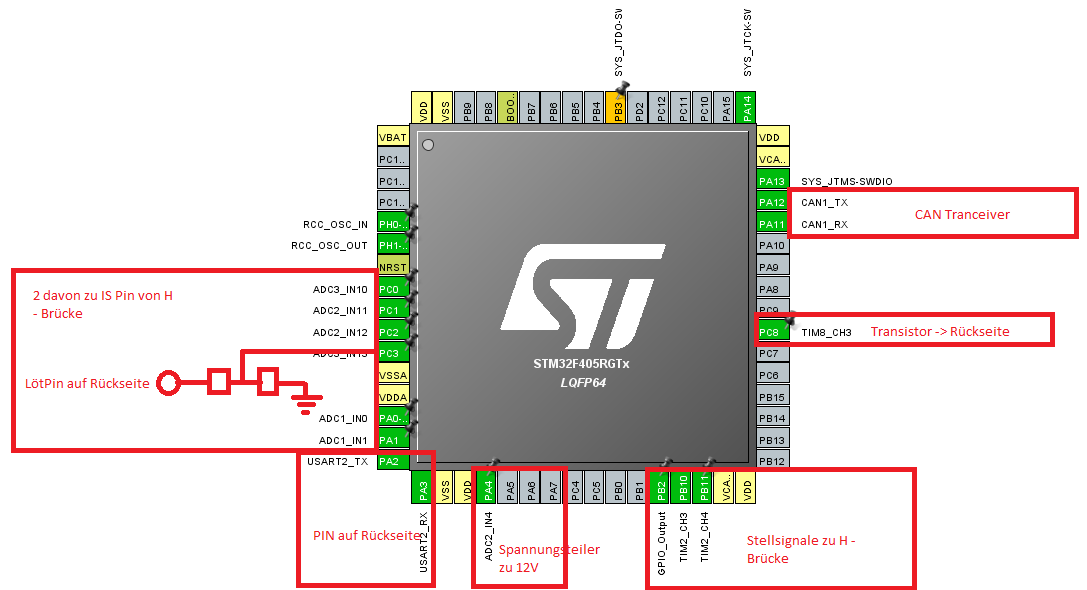
Platinenentwurf/BoardBilder/PINOUT.png
