malbreitenbach/adp_tauchspulenelektronik/Platinenentwurf/BoardBilder/Sendorik.JPG

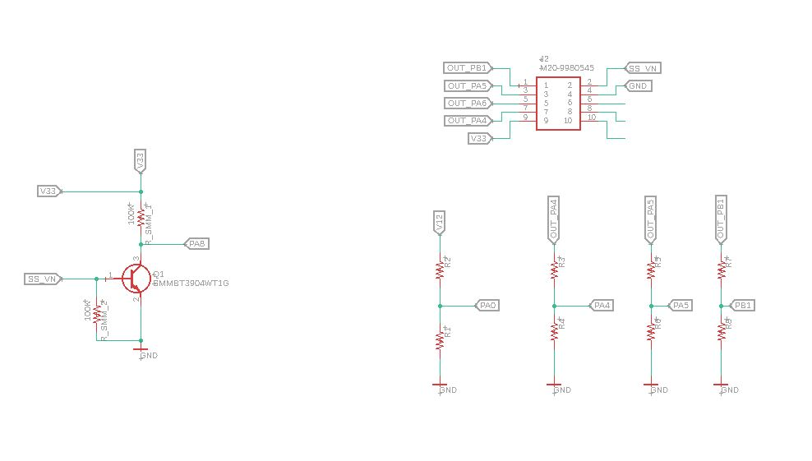
Platinenentwurf/BoardBilder/Sendorik.JPG
