malbreitenbach/adp_tauchspulenelektronik/Platinenentwurf/BoardBilder/Sensorik.png

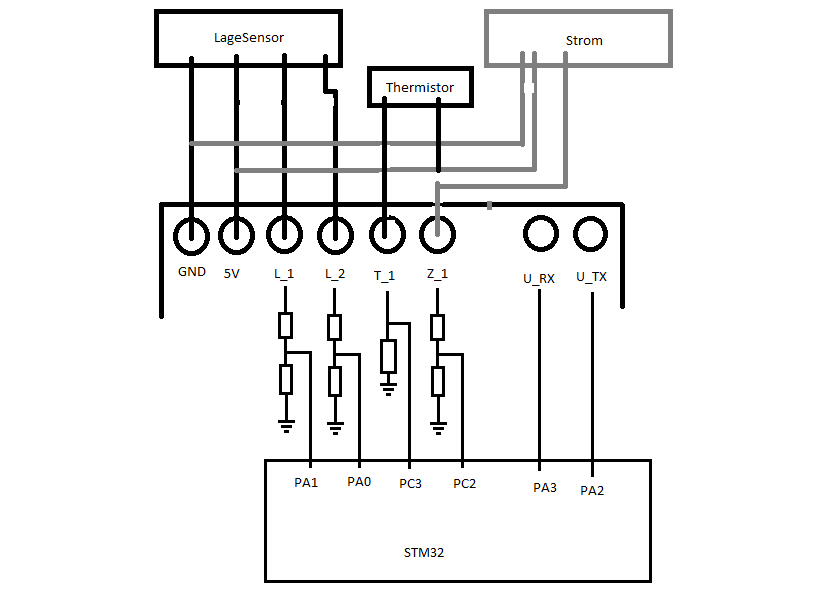
Platinenentwurf/BoardBilder/Sensorik.png
