malbreitenbach/adp_tauchspulenelektronik/Platinenentwurf/BoardBilder/thermalVias.JPG

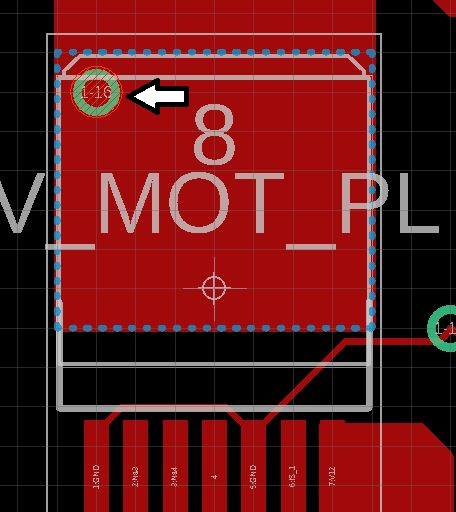
Platinenentwurf/BoardBilder/thermalVias.JPG
