malbreitenbach/adp_tauchspulenelektronik/Platinenentwurf/Platinenkosten1.xlsx

Sheet: Kostenüberschlag
 |  |  |  |  |  |  | 80.2615 | 33.51 | 24.6816
 | Anzahl | Bezeichnung | Bauteil | Stückpreis | Stückpreis 100+ | Stückpreis 1000+ | Gesamtpreis | Gesamtpreis 100+ | Gesamtpreis 1000+ | Link
 | 1 | Platine | Platine | 38.5 | 2.39 | 0.82 | 38.5 | 2.39 | 0.82 | MCB
 | 1 | STM32F405RGT7 | Mikrocontroller | 10.66 | 7.79 | 6.58 | 10.66 | 7.79 | 6.58 | https://tinyurl.com/y5tnhwpe
 | 2 | BTN8982TAAUMA1 | Halbbrücken | 3.28 | 2.98 | 2.52 | 6.56 | 5.96 | 5.04 | https://tinyurl.com/yylt442k
 | 1 | CD74HCT125M | Leitungstreiber | 0.617 | 0.348 | 0.252 | 0.617 | 0.348 | 0.252 | https://tinyurl.com/yymvgnaa
 | 1 | SN65HVD230QD | Can Transceiver | 2.82 | 2.28 | 1.51 | 2.82 | 2.28 | 1.51 | https://de.rs-online.com/web/p/can-bus-transceiver/6607789/
 | 1 | LDL1117S33R | Voltage Regulator 3,3V | 0.337 | 0.162 | 0.103 | 0.337 | 0.162 | 0.103 | https://tinyurl.com/y4v4ohbm
 | 1 | LDL1117S50R | Voltage Regulator 5V | 0.337 | 0.162 | 0.103 | 0.337 | 0.162 | 0.103 | https://tinyurl.com/yxwp9hn7
 | 1 | 1711725 | Klemmblock | 1.16 | 1.07 | 0.912 | 1.16 | 1.07 | 0.912 | https://tinyurl.com/yxat2nuj
 | 2 | 282836-2 | Klemmblock | 0.371 | 0.309 | 0.263 | 0.742 | 0.618 | 0.526 | https://tinyurl.com/yxq468lg
 | 1 | M20-9990246 | Steckverbinder | 0.0442 | 0.0442 | 0.0387 | 0.0442 | 0.0442 | 0.0387 | https://tinyurl.com/yy6sv4fs
 | 1 | 776267-1 | AMPSEAL Automotive Steckverbinder | 7.09 | 6.22 | 5.23 | 7.09 | 6.22 | 5.23 | https://de.rs-online.com/web/p/automotive-steckverbinder/7181496/
 | 1 | ABLS-8.000MHZ-K4T | Quarz | 0.605 | 0.355 | 0.384 | 0.605 | 0.355 | 0.384 | https://tinyurl.com/y3wcouhr
 |  |  |  |  |  |  | 0 | 0 | 0
j | 2 | C0805C220K5RACAUTO | 22pF Kondensator (0805) | 0.189 | 0.1 | 0.0614 | 0.378 | 0.2 | 0.1228 | https://tinyurl.com/y4wnsgfr
j | 2 | MC1206B102K500CT | 1nF Kondensator | 0.0856 | 0.0493 | 0.0239 | 0.1712 | 0.0986 | 0.0478 | https://tinyurl.com/y3ttj5tv
 | 8 | C1206F104K1RACAUTO | 100nF Kondensator | 0.241 | 0.128 | 0.0579 | 1.928 | 1.024 | 0.4632 | https://tinyurl.com/yykjslk4
 | 5 | 06033C224KAT2A | 220nF Kondensator | 0.186 | 0.0728 | 0.0246 | 0.93 | 0.364 | 0.123 | https://tinyurl.com/y2kla3h8
 | 3 | C1206C105K3RACAUTO | 1uF Kondensator | 0.171 | 0.0984 | 0.0691 | 0.513 | 0.2952 | 0.2073 | https://tinyurl.com/yy8uoj4r
 | 2 | GCM31CR71H225KA55L | 2,2uF Kondensator | 0.525 | 0.27 | 0.129 | 1.05 | 0.54 | 0.258 | https://tinyurl.com/y4qseagf
 | 3 | 12063C475K4T2A | 4,7uF Kondensator | 0.236 | 0.142 | 0.0697 | 0.708 | 0.426 | 0.2091 | https://tinyurl.com/y4kezger
 | 1 | MCGPR16V108M10X16 | 1000uF | 0.229 | 0.117 | 0.0763 | 0.229 | 0.117 | 0.0763 | https://tinyurl.com/y6s4bjhs
 |  |  |  |  |  |  | 0 | 0 | 0
 | 2 | MCMR08X000 PTL | 0 Ohm Widerstand (0805) | 0.0152 | 0.0091 | 0.0051 | 0.0304 | 0.0182 | 0.0102 | https://tinyurl.com/y5m4gt32
 | 1 | MCMR12X100 JTL | 10O Widerstand | 0.0168 | 0.0134 | 0.009 | 0.0168 | 0.0134 | 0.009 | https://tinyurl.com/y4sl6uz6
 | 1 | CRCW1206100RFKEA | 100O Widerstand | 0.0364 | 0.0242 | 0.0132 | 0.0364 | 0.0242 | 0.0132 | https://tinyurl.com/y5w8o7kh
 | 2 | CRCW1206499RFKEA | 0,5kO Widerstand | 0.0215 | 0.0164 | 0.0132 | 0.043 | 0.0328 | 0.0264 | https://tinyurl.com/yxc4t7o5
 | 1 | MCMR08X102 JTL | 1kO (0805) | 0.0152 | 0.0091 | 0.0051 | 0.0152 | 0.0091 | 0.0051 | https://tinyurl.com/y3d95sqt
 | 3 | ERA8ARB362V | 3,6kO Widerstand | 0.8 | 0.612 | 0.313 | 2.4 | 1.836 | 0.939 | https://tinyurl.com/y5tnb535
 | 4 | ERA8AEB6491V | 6,49kO Widerstand | 0.425 | 0.191 | 0.107 | 1.7 | 0.764 | 0.428 | https://tinyurl.com/y28lobzt
 | 5 | WCR1206-10KFI | 10kO Widerstand | 0.0203 | 0.0147 | 0.0105 | 0.1015 | 0.0735 | 0.0525 | https://tinyurl.com/y5pmg4ds
 | 2 | MCMR08X103 JTL | 10kO Widerstand (0805) | 0.0149 | 0.0089 | 0.005 | 0.0298 | 0.0178 | 0.01 | https://tinyurl.com/y5nwvp7m
 | 1 | ERA8AEB3832V | 38,3kO Widerstand | 0.509 | 0.257 | 0.182 | 0.509 | 0.257 | 0.182 | https://tinyurl.com/y4c33jau
 |  |  |  |  |  |  | 0 | 0 | 0
 |  |  |  |  |  |  |  |  | 0
 |  |  |  |  |  |  |  |  | 0
 |  | Widerstände |  |  |  |  | 4.8821 | 3.046 | 1.6754
 |  | Kondensatoren |  |  |  |  | 5.9072 | 3.0648 | 1.5075
 |  | Stecker |  |  |  |  | 9.0362 | 7.9522 | 6.7067
 |  | ICs |  |  |  |  | 21.331 | 16.702 | 13.588
 |  | Platine |  |  |  |  | 38.5 | 2.39 | 0.82
 |  | passive Bauelemente |  |  |  |  | 11.3943 | 6.4658 | 3.5669
 |  |  |  |  |  |  | 80.2615 | 33.51 | 24.6816

Sheet: Kondensatoren
C1 | 4,7uF | j
C2 | 1uF | j
C3 | 4,7uF | j
C4 | 1uF | j
C5 | 2,2uF | j
C6 | 2,2uF | j
C7 | 100nF | j
C8 | 100nF | j
C9 | 100nF | j
C10 | 100nF | j
C11 | 4,7uF | j
C12 | 100nF | j
C13 | 1000uF
C14 | 1nF | j
C15 | 1nF | j
C16 | 220nF | x
C17 | 220nF | x
C18 | 220nF | x
C19 | 220nF | x
C20 | 1uF | j
C21 | 220nF | x
CQ1 | 22pF | j
CQ2 | 22pF | j
CCAN | 100nF | j
CH1 | 100nF | j
CH3 | 100nF | j

Sheet: Widerstände
R1 | 6,49kO | x
R2 | 3,6kO | x
R3 | 3,6kO | x
R4 | 6,49kO | x
R5 | 100O | j
R6 | 10kO | j
R7 | 3,6kO | x
R8 | 6,49kO | x
R9 | 0,5kO | j
R10 | 10kO | j
R11 | 10kO | j
R12 | 10kO | j
R13 | 10kO | j
R14 | 0,5kO | j
R15 | 38,3kO | x
R16 | 10kO | j
R17 | 10kO | j
R18 | 6,49kO | x
R_RS | 10O | j
R19 | 0 | j
R20 | 220O

Sheet: Tabelle1
Anzahl | Bauteil | Gesamtpreis | Gesamtpreis 100+ | Gesamtpreis 1000+ | Stückpreis | Stückpreis 100+ | Stückpreis 1000+
1 | Platine | 38.5 | 2.39 | 0.82 | 38.5 | 2.39 | 0.82
1 | Mikrocontroller | 10.66 | 7.79 | 6.58 | 10.66 | 7.79 | 6.58
2 | Halbbrücken | 6.56 | 5.96 | 5.04 | 3.28 | 2.98 | 2.52
1 | Leitungstreiber | 0.617 | 0.348 | 0.252 | 0.617 | 0.348 | 0.252
1 | Can Transceiver | 2.82 | 2.28 | 1.51 | 2.82 | 2.28 | 1.51
1 | Voltage Regulator 3,3V | 0.337 | 0.162 | 0.103 | 0.337 | 0.162 | 0.103
1 | Voltage Regulator 5V | 0.337 | 0.162 | 0.103 | 0.337 | 0.162 | 0.103
1 | Klemmblock | 1.16 | 1.07 | 0.912 | 1.16 | 1.07 | 0.912
2 | Klemmblock | 0.742 | 0.618 | 0.526 | 0.371 | 0.309 | 0.263
1 | Steckverbinder | 0.0442 | 0.0442 | 0.0387 | 0.0442 | 0.0442 | 0.0387
1 | AMPSEAL Automotive Steckverbinder | 7.09 | 6.22 | 5.23 | 7.09 | 6.22 | 5.23
1 | Quarz | 0.605 | 0.355 | 0.384 | 0.605 | 0.355 | 0.384
21 | Widerstände | 4.8821 | 3.046 | 1.6754 | 1.8743 | 1.1558 | 0.6631
21 | Kondensatoren | 5.9072 | 3.0648 | 1.5075 | 1.8626 | 0.9775 | 0.5119
2 | 22pF Kondensator (0805) | 0.378 | 0.2 | 0.1228 | 0.189 | 0.1 | 0.0614
2 | 1nF Kondensator | 0.1712 | 0.0986 | 0.0478 | 0.0856 | 0.0493 | 0.0239
8 | 100nF Kondensator | 1.928 | 1.024 | 0.4632 | 0.241 | 0.128 | 0.0579
5 | 220nF Kondensator | 0.93 | 0.364 | 0.123 | 0.186 | 0.0728 | 0.0246
3 | 1uF Kondensator | 0.513 | 0.2952 | 0.2073 | 0.171 | 0.0984 | 0.0691
2 | 2,2uF Kondensator | 1.05 | 0.54 | 0.258 | 0.525 | 0.27 | 0.129
3 | 4,7uF Kondensator | 0.708 | 0.426 | 0.2091 | 0.236 | 0.142 | 0.0697
1 | 1000uF | 0.229 | 0.117 | 0.0763 | 0.229 | 0.117 | 0.0763
 |  | 0 | 0 | 0
2 | 0 Ohm Widerstand (0805) | 0.0304 | 0.0182 | 0.0102 | 0.0152 | 0.0091 | 0.0051
1 | 10O Widerstand | 0.0168 | 0.0134 | 0.009 | 0.0168 | 0.0134 | 0.009
1 | 100O Widerstand | 0.0364 | 0.0242 | 0.0132 | 0.0364 | 0.0242 | 0.0132
2 | 0,5kO Widerstand | 0.043 | 0.0328 | 0.0264 | 0.0215 | 0.0164 | 0.0132
1 | 1kO (0805) | 0.0152 | 0.0091 | 0.0051 | 0.0152 | 0.0091 | 0.0051
3 | 3,6kO Widerstand | 2.4 | 1.836 | 0.939 | 0.8 | 0.612 | 0.313
4 | 6,49kO Widerstand | 1.7 | 0.764 | 0.428 | 0.425 | 0.191 | 0.107
5 | 10kO Widerstand | 0.1015 | 0.0735 | 0.0525 | 0.0203 | 0.0147 | 0.0105
2 | 10kO Widerstand (0805) | 0.0298 | 0.0178 | 0.01 | 0.0149 | 0.0089 | 0.005
1 | 38,3kO Widerstand | 0.509 | 0.257 | 0.182 | 0.509 | 0.257 | 0.182

Sheet: Tabelle2
Anzahl | Bauteil | Gesamtpreis | Gesamtpreis 100+ | Gesamtpreis 1000+ | Stückpreis | Stückpreis 100+ | Stückpreis 1000+
1 | Platine | 38.5 | 2.39 | 0.82 | 38.5 | 2.39 | 0.82
1 | Mikrocontroller | 10.66 | 7.79 | 6.58 | 10.66 | 7.79 | 6.58
2 | Halbbrücken | 6.56 | 5.96 | 5.04 | 3.28 | 2.98 | 2.52
1 | Leitungstreiber | 0.617 | 0.348 | 0.252 | 0.617 | 0.348 | 0.252
1 | Can Transceiver | 2.82 | 2.28 | 1.51 | 2.82 | 2.28 | 1.51
1 | Voltage Regulator 3,3V | 0.337 | 0.162 | 0.103 | 0.337 | 0.162 | 0.103
1 | Voltage Regulator 5V | 0.337 | 0.162 | 0.103 | 0.337 | 0.162 | 0.103
1 | Klemmblock | 1.16 | 1.07 | 0.912 | 1.16 | 1.07 | 0.912
2 | Klemmblock | 0.742 | 0.618 | 0.526 | 0.371 | 0.309 | 0.263
1 | Steckverbinder | 0.0442 | 0.0442 | 0.0387 | 0.0442 | 0.0442 | 0.0387
1 | AMPSEAL Automotive Steckverbinder | 7.09 | 6.22 | 5.23 | 7.09 | 6.22 | 5.23
1 | Quarz | 0.605 | 0.355 | 0.384 | 0.605 | 0.355 | 0.384
21 | Widerstände | 4.8821 | 3.046 | 1.6754 | 1.8743 | 1.1558 | 0.6631
21 | Kondensatoren | 5.9072 | 3.0648 | 1.5075 | 1.8626 | 0.9775 | 0.5119
2 | 22pF Kondensator (0805) | 0.378 | 0.2 | 0.1228 | 0.189 | 0.1 | 0.0614
2 | 1nF Kondensator | 0.1712 | 0.0986 | 0.0478 | 0.0856 | 0.0493 | 0.0239
8 | 100nF Kondensator | 1.928 | 1.024 | 0.4632 | 0.241 | 0.128 | 0.0579
5 | 220nF Kondensator | 0.93 | 0.364 | 0.123 | 0.186 | 0.0728 | 0.0246
3 | 1uF Kondensator | 0.513 | 0.2952 | 0.2073 | 0.171 | 0.0984 | 0.0691
2 | 2,2uF Kondensator | 1.05 | 0.54 | 0.258 | 0.525 | 0.27 | 0.129
3 | 4,7uF Kondensator | 0.708 | 0.426 | 0.2091 | 0.236 | 0.142 | 0.0697
1 | 1000uF | 0.229 | 0.117 | 0.0763 | 0.229 | 0.117 | 0.0763
 |  | 0 | 0 | 0
2 | 0 Ohm Widerstand (0805) | 0.0304 | 0.0182 | 0.0102 | 0.0152 | 0.0091 | 0.0051
1 | 10O Widerstand | 0.0168 | 0.0134 | 0.009 | 0.0168 | 0.0134 | 0.009
1 | 100O Widerstand | 0.0364 | 0.0242 | 0.0132 | 0.0364 | 0.0242 | 0.0132
2 | 0,5kO Widerstand | 0.043 | 0.0328 | 0.0264 | 0.0215 | 0.0164 | 0.0132
1 | 1kO (0805) | 0.0152 | 0.0091 | 0.0051 | 0.0152 | 0.0091 | 0.0051
3 | 3,6kO Widerstand | 2.4 | 1.836 | 0.939 | 0.8 | 0.612 | 0.313
4 | 6,49kO Widerstand | 1.7 | 0.764 | 0.428 | 0.425 | 0.191 | 0.107
5 | 10kO Widerstand | 0.1015 | 0.0735 | 0.0525 | 0.0203 | 0.0147 | 0.0105
2 | 10kO Widerstand (0805) | 0.0298 | 0.0178 | 0.01 | 0.0149 | 0.0089 | 0.005
1 | 38,3kO Widerstand | 0.509 | 0.257 | 0.182 | 0.509 | 0.257 | 0.182

Sheet: Tabelle3
Anzahl | Bauteil | Gesamtpreis | Gesamtpreis 100+ | Gesamtpreis 1000+
1 | Platine | 38.5 | 2.39 | 0.82
1 | Mikrocontroller | 10.66 | 7.79 | 6.58
2 | Halbbrücken | 6.56 | 5.96 | 5.04
1 | Leitungstreiber | 0.617 | 0.348 | 0.252
1 | Can Transceiver | 2.82 | 2.28 | 1.51
1 | Voltage Regulator 3,3V | 0.337 | 0.162 | 0.103
1 | Voltage Regulator 5V | 0.337 | 0.162 | 0.103
1 | Klemmblock | 1.16 | 1.07 | 0.912
2 | Klemmblock | 0.742 | 0.618 | 0.526
1 | Steckverbinder | 0.0442 | 0.0442 | 0.0387
1 | AMPSEAL Automotive Steckverbinder | 7.09 | 6.22 | 5.23
1 | Quarz | 0.605 | 0.355 | 0.384
21 | Widerstände | 4.8821 | 3.046 | 1.6754
21 | Kondensatoren | 5.9072 | 3.0648 | 1.5075
