malbreitenbach/adp_tauchspulenelektronik/Dokumente/Halbbrücke.xlsx

Sheet: Features
Pinverteilung BTN
Pin | Name | I/O | Funktion
1 | GND (Ground) | -
2 | IN (Input) | I | Definiert die Schalterstellung (I: High Switch Mode)
3 | INH (Inhibit) | I | Schlafmodus, wenn auf 0 gestellt
4.8 | OUT (Output) | O | Ausgang der Halbbrücke
5 | SR (Slew Rate) = Anstiegsrate | I | Die Slew Rate kann verändert werden, indem ein Resistor zwischen SR und GND geschaltet wird | SR=max(|dUAusgang(t)/t|)
6 | IS (Status Pin) | O | Normalbetrieb: verbunden mit Stromquelle proportional zum Strom durch den High Side Schalter
 |  |  | andere Richtung: kein Strom fließt
 |  |  | Fehlbetrieb: verbunden mit unabhängiger Stromquelle -> Strom IIS(lim)
7 | VS | - | Stromversorgung
Ein-/ Ausgangsgrößen BTN
Symbol (Einheit) | Bezeichnung (Einheit) | Minimalwert | Maximalwert | Betriebsbereich
VVS (V) | Versorgungsspannung | -0.3 | 45 | 8-18
VIN, VINH (V) | Logic Input Voltage | -0.3 | 5.3
VSR (V) | Spannung am SR Pin | -0.3 | 1
VS-VIS (V) | Spannung zwsichen VS und IS Pin | -0.3 | 45
VIS (V) | Spannung am IS Pin | -20 | 45
ID(HS), ID(LS) (A) | High/ Low Switch kontinuierlicher Strom | -40 | 40
 | High/ Low Switch Pulsstrom | -90 | 90
 | High/ Low Switch PWM Strom | -55 | 55
IVS(on) (A) | Versorgungsstrom | - | 3
IVS(off) (µA) | Ruhestrom | - | 15
Tj (°C) | Sperrschicht Temperatur | -40 | 150
Tstg (°C) | Lagertemperatur | -55 | 150

Sheet: Bestelliste
Bezeichnung | Stückzahl min | Stückzahl Wunsch | Fragen
BTN7960P | 2 | 4
R=10 kOhm | 4 | 10 | gehen die eventuell kaputt?
R=470 Ohm | 2 | 10
R=0-51 kOhm | 2
C=470 nF | 2 | 10
fetter Kondensator |  |  | brauchen wir den?
Kabel M-F | 4 | je nach Packung
Kabel M-M | 20 | 50 (je nach Packung)
Wago Klemmen (3er) | 15 |  | schlimm, wenn nur 2 von 3 Anschlüssen benutzt werden?
(Testmotor) |  | 1
Steckbrett | 1 | 2
Batterie + Verbindungsclip | 1
Stromsensor | 1 |  | https://de.farnell.com/allegro-microsystems/acs758lcb-050b-pff-t/stromsensor-50a-40mv-a-bidirectional/dp/1791392
