malbreitenbach/adp_tauchspulenelektronik/Dokumente/Bestellungen/Bestelliste Backup.ods

Anzahl | Name | Link
4 | Halbbrücken BTN8982TAAUMA1 | https://tinyurl.com/yylt442k
10 | 6,49kO Widerstand | https://tinyurl.com/y28lobzt
10 | 3,6kO Widerstand | https://tinyurl.com/y5tnb535
15 | 10kO Widerstand | https://tinyurl.com/y5pmg4ds
5 | 4,7uF Kondensator | https://tinyurl.com/y4kezger
15 | 220nF Kondensator | https://tinyurl.com/y2kla3h8
18 | 100nF Kondensator | https://de.farnell.com/avx/12061c104kat2a/kondensator-0-1-f-100v-10-x7r/dp/1327703?st=0,1%20uF%201206%20smd
5 | 1uF Kondensator | https://tinyurl.com/yy8uoj4r
5 | 2,2uF Kondensator | https://tinyurl.com/y4qseagf
8 | 4,7uF Kondensator | https://tinyurl.com/y4kezger
10 | 18pF Kondensator | https://de.farnell.com/avx/08055a180jat2a/kondensator-18pf-50v-5-c0g-np0/dp/2280674?st=18pF%200805
2 | Klemmblock | https://de.farnell.com/phoenix-contact/1711725/klemmblock-print-schraub-2pol/dp/3041165?st=terminal%20block
