malbreitenbach/adp_tauchspulenelektronik/Dokumente/Bestellungen/Bestellliste_Platine.ods

Kondensatorenliste: | Name: | Link: | Anzahl | Benötigt | AEC Standard
4.7 µF | 12063C475K4T2A | https://de.farnell.com/avx/12063c475k4t2a/kondensator-4-7-f-25v-10-x7r-1206/dp/2507766?st=12063C475K4T2A | 5 | 3 | ja
1uF | 12065C105K4Z2A | https://de.farnell.com/avx/12065c105k4z2a/kondensator-1-f-50v-10-x7r-1206/dp/2566064?st=12065C105K4Z2A | 5 | 2 | ja
100nF | C1206F104K1RACAUTO | https://de.farnell.com/kemet/c1206f104k1racauto/kondensator-0-1-f-100v-10-x7r/dp/2478270?st=C1206F104K1RACAUTO | 10 | 6 | ja
2.2uF | C1206X225K5RACAUTO | https://de.farnell.com/kemet/c1206x225k5racauto/kondensator-2-2-f-50v-10-x7r-1206/dp/2478274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 | 5 | 2 | ja
22pF | C0805C220K5RACAUTO | https://de.farnell.com/kemet/c0805c220k5racauto/kondensator-22pf-50v-10-x7r-0805/dp/2905242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 | 10 | 2 | ja
Sonstiges:
Steckverbinder 2-pol | M20-9990246 | https://de.farnell.com/harwin/m20-9990246/stiftleiste-2-54mm-offen-vertikal/dp/1022247 | 10 | 2
Transistor (NPN) | SMMBT3904WT1G | https://de.farnell.com/on-semiconductor/smmbt3904wt1g/transistor-aec-q101-npn-40v-sot/dp/2845332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 | 5 | 3 | ja
Jumperbuchse | M7581-05 | https://de.farnell.com/harwin/m7581-05/jumper-2pos-f-stiftleiste/dp/2396303 | 10 | 5
Widerstände: | Name: | Link: | Anzahl | Benötigt | AEC Standard
100kOhm | CRCW1206100KFKEA | https://de.farnell.com/vishay/crcw1206100kfkea/dickschichtwiderstand-100k-1-0/dp/1469975 | 10 | 3 | ja
7,5kOhm | CRCW12067K50FKEA | https://de.farnell.com/vishay/crcw12067k50fkea/dickschichtwiderstand-7k5-1-0/dp/1653170 | 10 | 3 | ja
6,49kOhm (dü) | ERA8AEB6491V | https://de.farnell.com/panasonic-electronic-components/era8aeb6491v/d-nnsch-widerstand-6k49-0-1-0/dp/2095216 | 10 | 7 | ja
3,6kOhm (dü) | ERA8ARB362V | https://de.farnell.com/panasonic/era8arb362v/d-nnschichtwiderstand-3k6-0-1/dp/2484825 | 3 | 3 | ja
38,3kOhm (dü) | ERA8AEB3832V | https://de.farnell.com/panasonic-electronic-components/era8aeb3832v/d-nnsch-widerstand-38k3-0-1-0/dp/2095104 | 10 | 4 | ja
