malbreitenbach/adp_tauchspulenelektronik/Dokumente/Bestellungen/Bestellungen_Minimalbeschaltung.ods

Artikel | Beschreibung | Link | Menge
STM32F405RGT7 | Mikrocontroller | https://de.farnell.com/stmicroelectronics/stm32f405rgt7/mcu-32bit-cortex-m4-168mhz-lqfp/dp/2333285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 | 2
SN65HVD230QD | CAN Transceiver | https://de.farnell.com/texas-instruments/sn65hvd230qd/transceiver-3-3v-soic8/dp/1648752?st=SN65HVD230Q | 2
8329TCS-6ML | Wärmeleitkleber | https://de.farnell.com/mg-chemicals/8329tcs-6ml/klebstoff-2-komp-epoxid-spritze/dp/2811937 | 1
FK 248 SA 220 | Kühlkörper | https://de.farnell.com/fischer-elektronik/fk-248-sa-220/k-hlk-rper/dp/1892322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 | 2
ABLS-8.000MHZ-K4T | Quarz | https://de.farnell.com/abracon/abls-8-000mhz-k4t/quarz-8mhz-18pf-11-5mm-x-4-7mm/dp/2849566?st=quarz | 4
M20-9980545 | steckverbinder | https://de.farnell.com/harwin/m20-9980545/stiftleiste-tht-vertikal-2-54mm/dp/1022235?st=m20-998 | 10
AZDeliveryJumperWire | wire jumper | https://www.amazon.de/AZDelivery-Jumper-Arduino-Raspberry-Breadboard/dp/B074P726ZR | 1
MMBT3904WT1G | transistor | https://de.farnell.com/on-semiconductor/mmbt3904wt1g/transistor-npn-sot-323/dp/1459102 | 5
1N5931BRLG | Zener-Diode | https://de.farnell.com/on-semiconductor/1n5931brlg/zener-diode-3w-18v-do-41/dp/2630274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 | 5
MICTuning12-Fach Sicherungshalter | Sicherungen | https://www.amazon.de/dp/B07FT7GCG6 | 1
