malbreitenbach/adp_tauchspulenelektronik/Dokumente/Bestellungen/Bestellung_Prototyp.ods

Bestelliste – Prototyp
Beschreibung | Produktname | Datenblatt | Shoplink | Anzahl
Stromsensor | ACS758LCB-050B-PFF-T | http://www.farnell.com/datasheets/1934117.pdf | https://de.farnell.com/allegro-microsystems/acs758lcb-050b-pff-t/stromsensor-50a-40mv-a-bidirectional/dp/1791392 | 2
Zener Diode 3.3V | BZX85C3V3-TR |  | https://www.mouser.de/ProductDetail/Vishay-Semiconductors/BZX85C3V3-TR | 2
Votage Regulator 3.3V Steckbar | LD1117V33C |  | https://www.mouser.de/ProductDetail/STMicroelectronics/LD1117V33C | 1
Votage Regulator 3.3V Lötbar | LDL1117S33R |  | https://www.mouser.de/ProductDetail/STMicroelectronics/LDL1117S33R | 1
Voltage Regulator 5 V Steckbar | LD1117V50 |  | https://www.mouser.de/ProductDetail/STMicroelectronics/LD1117V50 | 1
Voltage Regulator 5 V Lötbar | LDL1117S50R |  | https://www.mouser.de/ProductDetail/STMicroelectronics/LDL1117S50R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 | 1
Halbbrücke Infineon | BTN7960P |  | https://www.mouser.de/ProductDetail/Infineon-Technologies/BTN7960P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 | 3
Kabel | MIKROE-512 |  | https://www.mouser.de/ProductDetail/MikroElektronika/MIKROE-512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 | 3
Steckbrett | 240-131 |  | https://www.mouser.de/ProductDetail/Digilent/240-131 | 3
Kondensator 100nF | 860010672001 |  | https://www.mouser.de/ProductDetail/Wurth-Electronics/860010672001 | 4
Kondensator 10uF | 860130874006 |  | https://www.mouser.de/ProductDetail/Wurth-Electronics/860130874006 | 4
