malbreitenbach/adp_tauchspulenelektronik/Platinenentwurf/Bauteilzuweisung.ods

Bauteilzuweisung
Bauteilname | Wert/ Bauteil
C1 | 4.7uF
C2 | 1uF
C3 | 4.7uF
C4 | 1uF
C5 | 2.2uF
C6 | 2.2uF
C7 | 100nF
C8 | 100nF
C9 | 100nF
C10 | 100nF
C11 | 4.7nF
C12 | 100nF
C13 | 470uF
C14 | 1nF
C15 | 1nF
CH1 | 0.47uF
CH3 | 0.47uF
CQ1 | 22pF
CQ2 | 22pF
C_CAN | 100nF
R9 | 1k
R10 | 10k
R11 | 10k
R12 | 10k
R13 | 10k
R14 | 1k
R15 | 38,3
R16 | 100k
R17 | 7.5k
R18 | 6,49k
R19 | 1k
R8 | 6,49k
R7 | 3,6k
R6 | 10k
R5
R4 | 6,49k
R3 | 3,6k
R2 | 3,6k
R1 | 6,49k
