malbreitenbach/adp_tauchspulenelektronik/(threads)

Thread 1 (2018-11-22):

Was passiert hier?

malbreitenbach, 2018-11-22:
Hier können Probleme aufgeführt  und z.B. grafisch dargestellt werden. Dann kann zusammen an einer Lösung gearbeitet werden.

Thread 2 (2018-11-22):

STM32 kann noch nicht über Matlab geflashed werden.

malbreitenbach, 2018-11-22:
Leider verhindert mein Virenschutzprogramm eine Auführung des Waijung-Installers. Ich werde es später mal deaktivieren und melde mich nochmal deshalb.
