malbreitenbach/adp_tauchspulenelektronik/Ausarbeitung/ADP_ausarbeitung/Bilder/shift_gear2_test.pdf

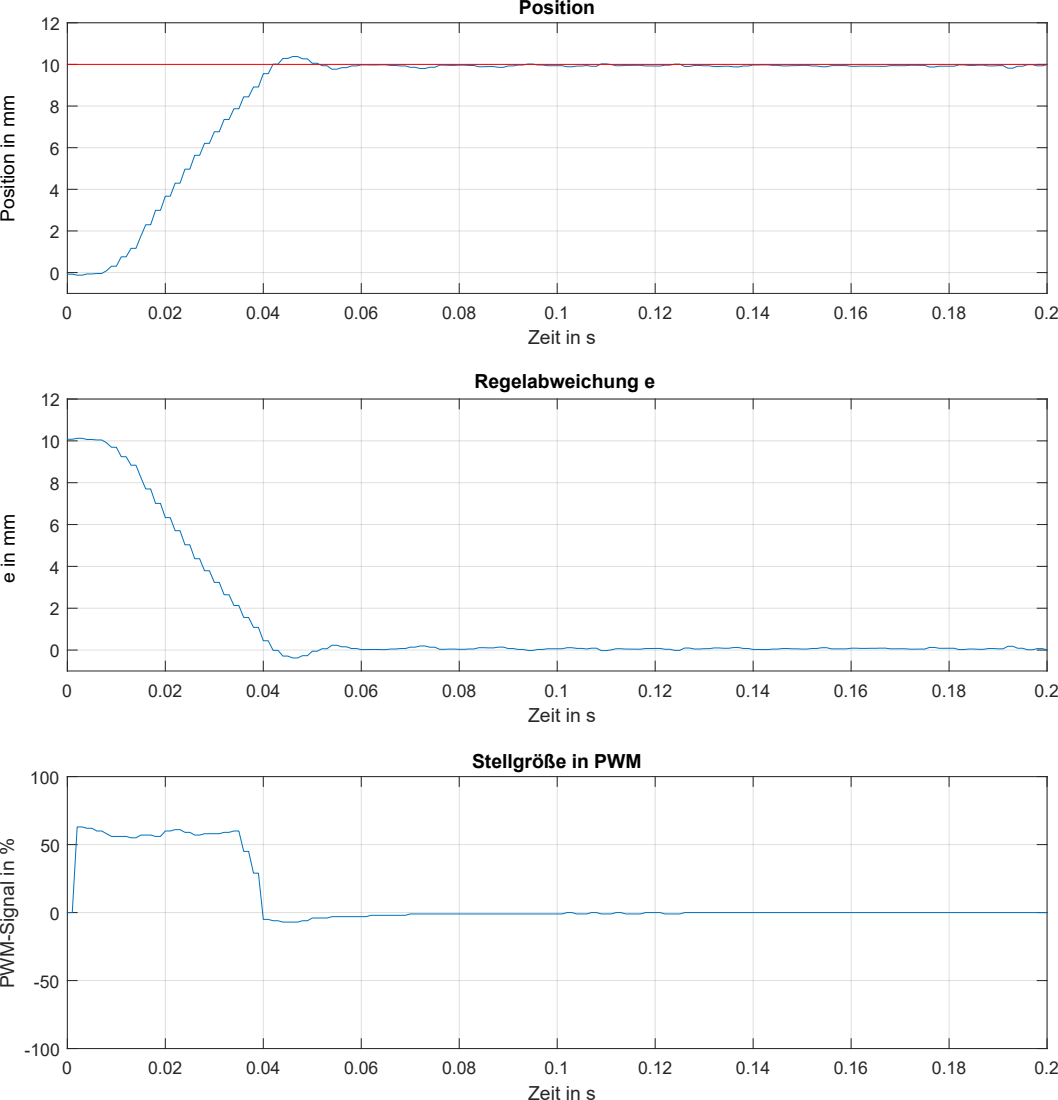
[picture p165: page 1]
Zeit in s; Position; Regelabweichung e

Position in mm

Stellgröße in PWM

PWM-Signal in %
