malbreitenbach/adp_tauchspulenelektronik/Ausarbeitung/tudreport/Bilder/shift_toneutral.pdf

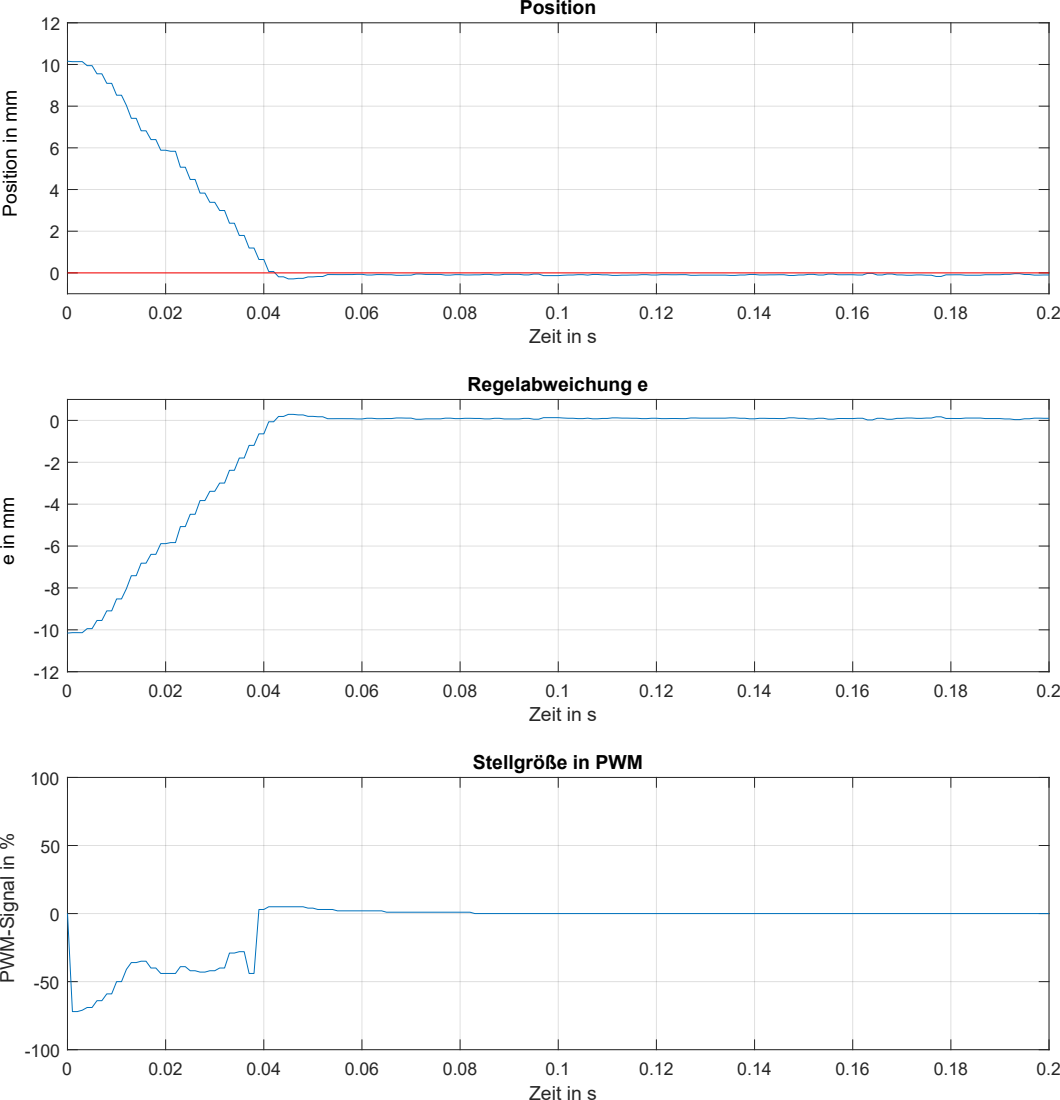
[picture p166: page 1]
Position; Regelabweichung e; Stellgröße in PWM; Zeit in s

Position in mm PWM-Signal in %
