malbreitenbach/adp_tauchspulenelektronik/Ausarbeitung/tudreport/Bilder/temp-eps-converted-to.pdf

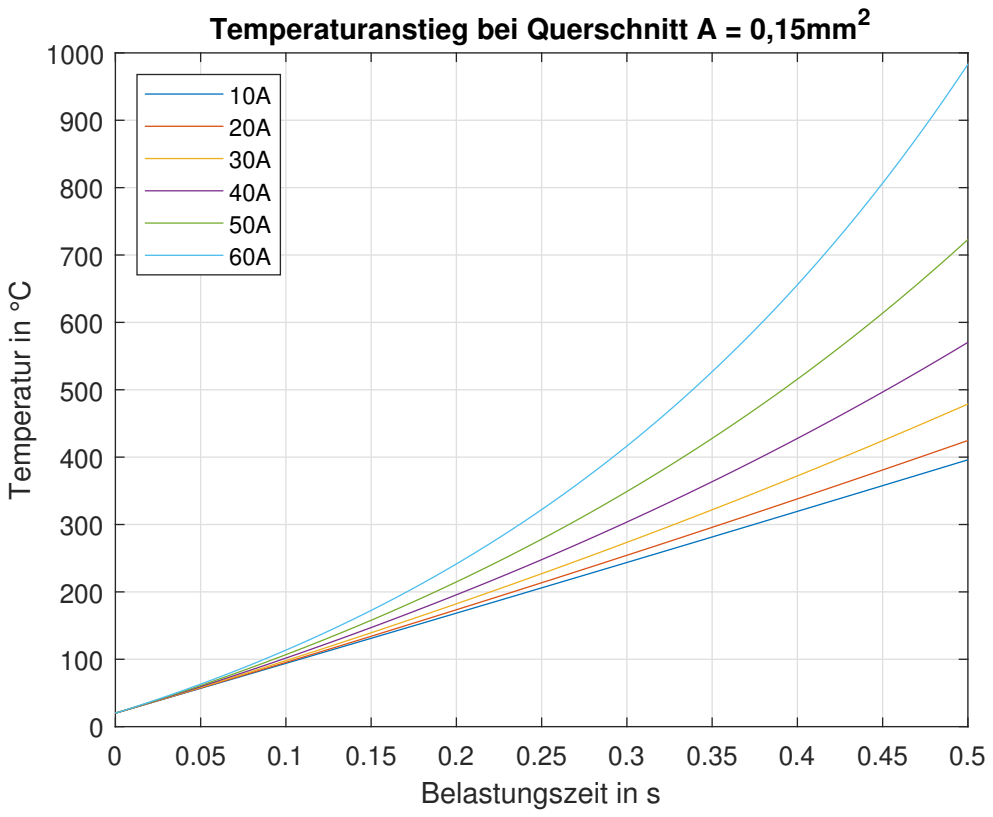
[picture p167: page 1]
Belastungszeit in s; Temperatur in °C

Temperaturanstieg bei Querschnitt A = 0,15mm²

10A
20A 30A
