malbreitenbach/adp_tauchspulenelektronik/Ausarbeitung/ADP_ausarbeitung/Bilder/spannungsverlauefe.pdf

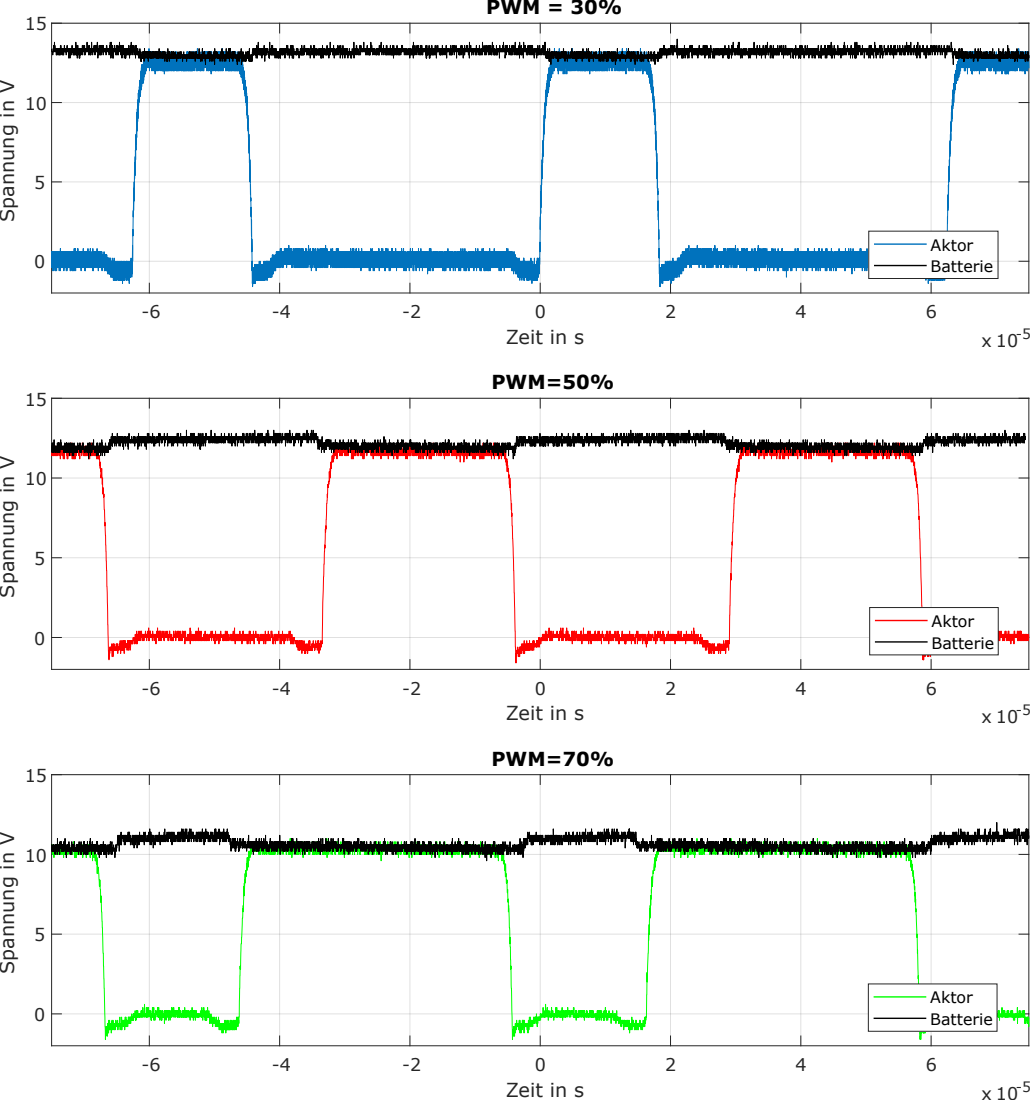
[picture p168: page 1]
Zeit in s; Spannung in V; PWM = 30%; PWM=50%; PWM=70%

Aktor
Batterie
