malbreitenbach/adp_tauchspulenelektronik/Ausarbeitung/ADP_ausarbeitung/Bilder/fig_gesamtsystem.pdf

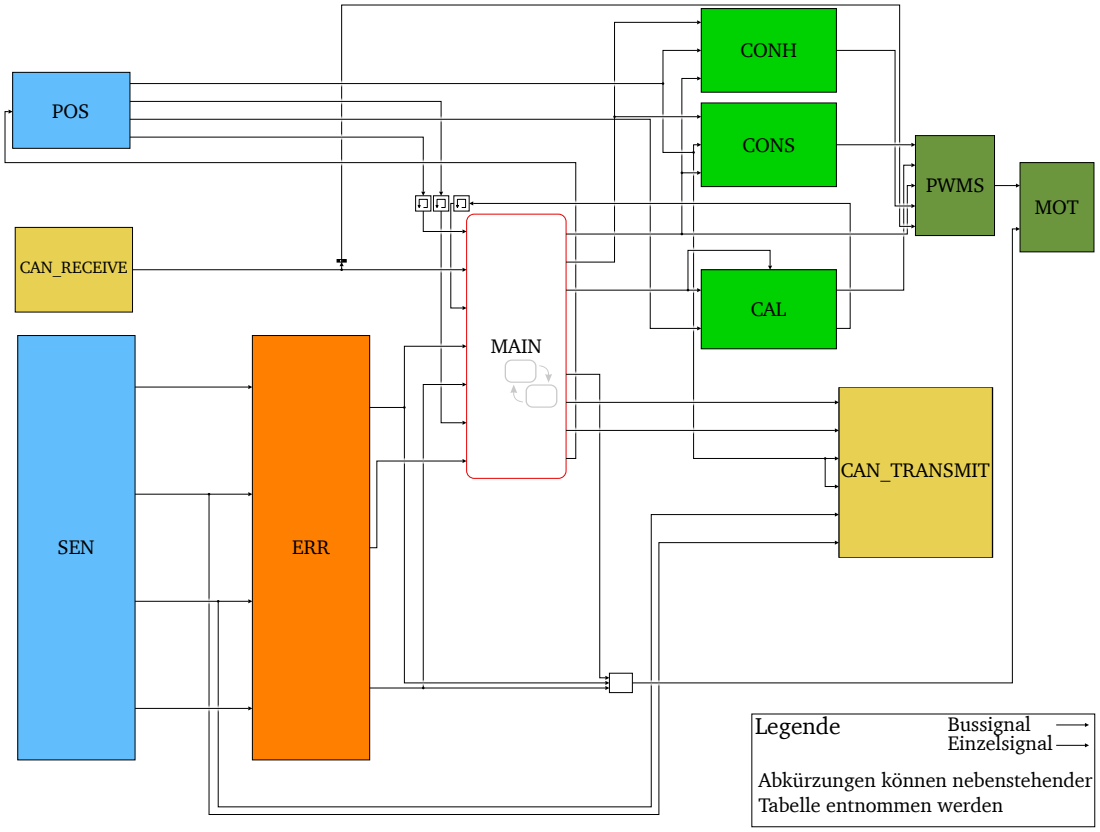
[picture p169: page 1]
POS; CAN_RECEIVE; SEN; ERR; CAN_TRANSMIT; CAL; CONS; CONH; PWMS; MOT; MAIN; Einzelsignal Legende; Bussignal

Abkürzungen können nebenstehender
Tabelle entnommen werden
