malbreitenbach/adp_tauchspulenelektronik/Ausarbeitung/ADP_ausarbeitung/Bilder/volt.pdf

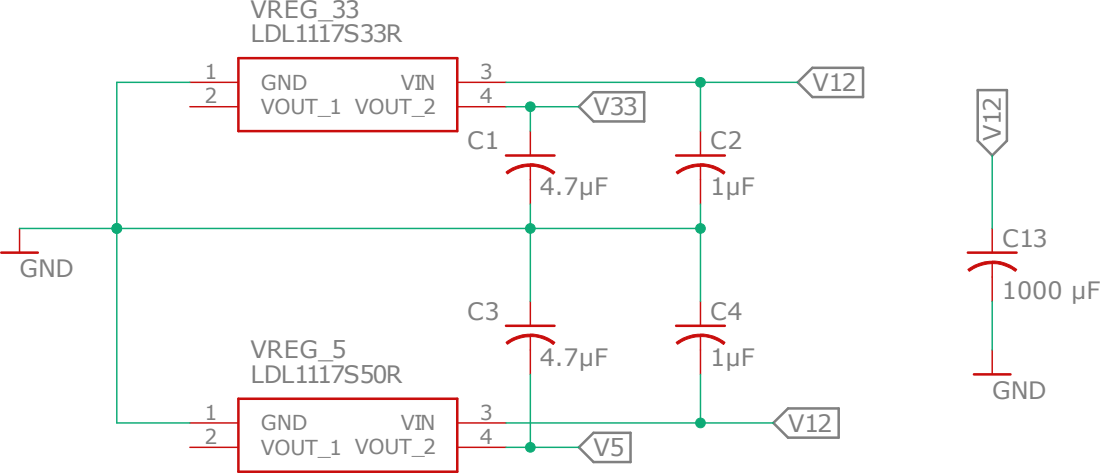
[picture p170: page 1]
LDL1117S33R; LDL1117S50R; GND; VOUT_1; VIN; VOUT_2; VREG_33; VREG_5
