malbreitenbach/adp_tauchspulenelektronik/Ausarbeitung/ADP_ausarbeitung/Bilder/Simulationsergebnisse.pdf

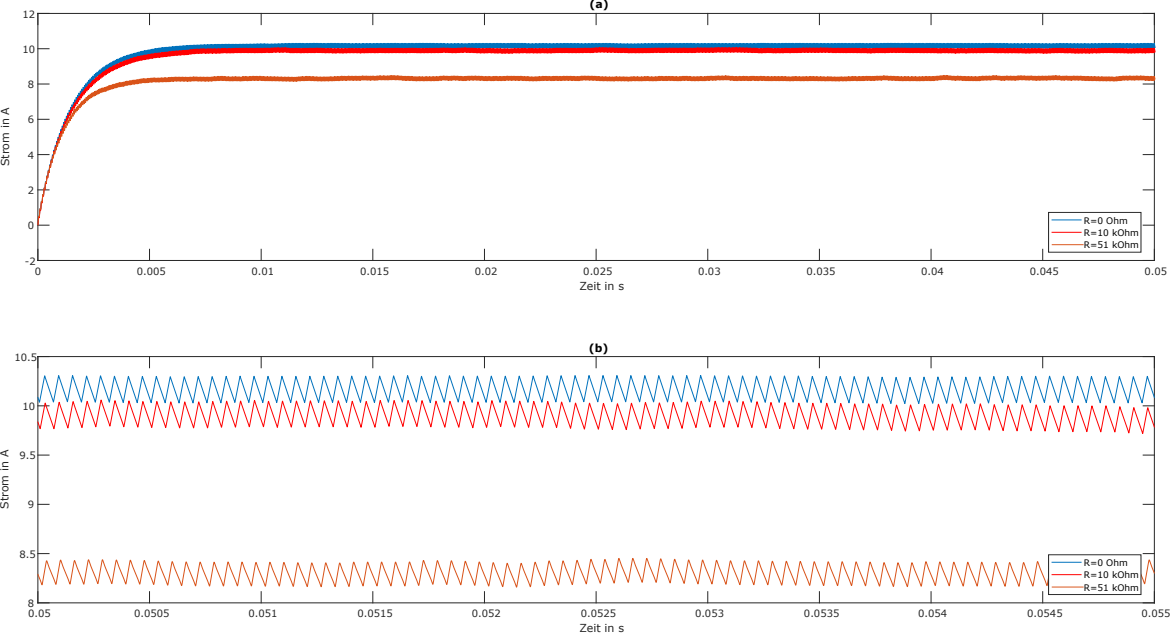
[picture p171: page 1]
Zeit in s; Strom in A; R=0 Ohm R=10 kOhm R=51 kOhm
