malbreitenbach/adp_tauchspulenelektronik/Ausarbeitung/ADP_ausarbeitung/Bilder/buffer.pdf

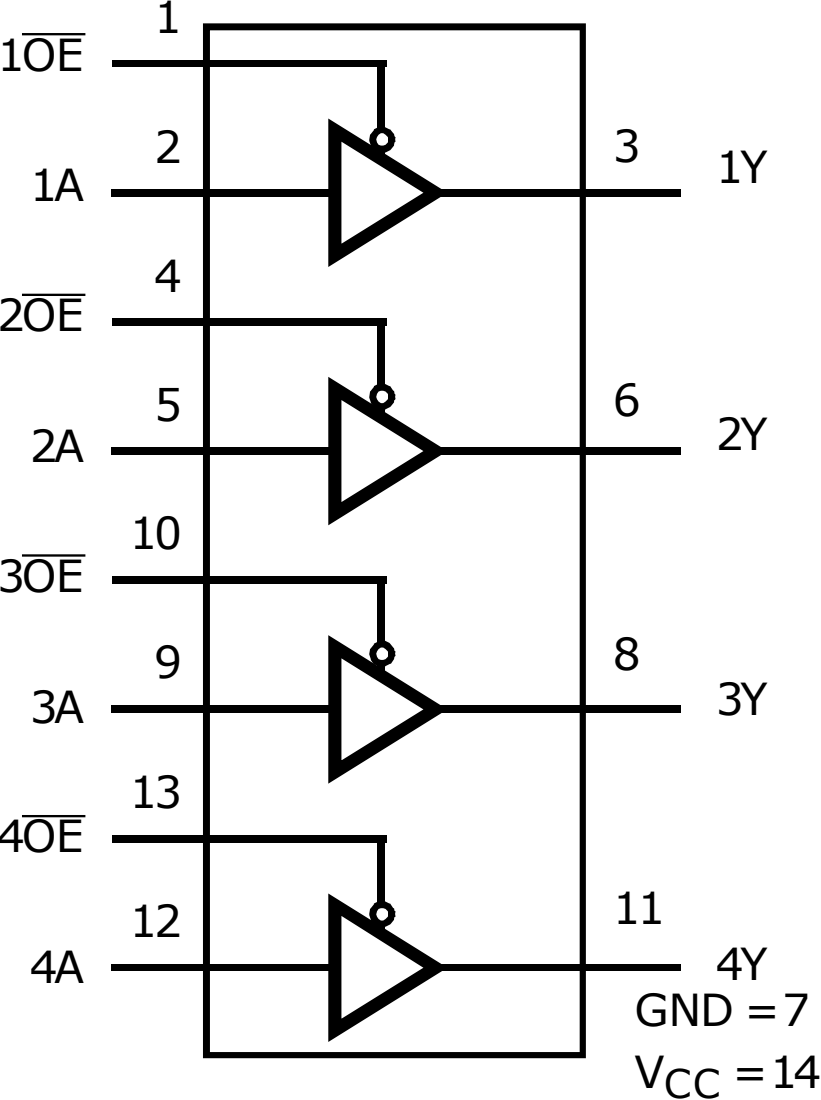
[picture p172: page 1]
4Y GND = 7 VCC = 14
