malbreitenbach/adp_tauchspulenelektronik/Ausarbeitung/ADP_ausarbeitung/Bilder/infineon_design.pdf

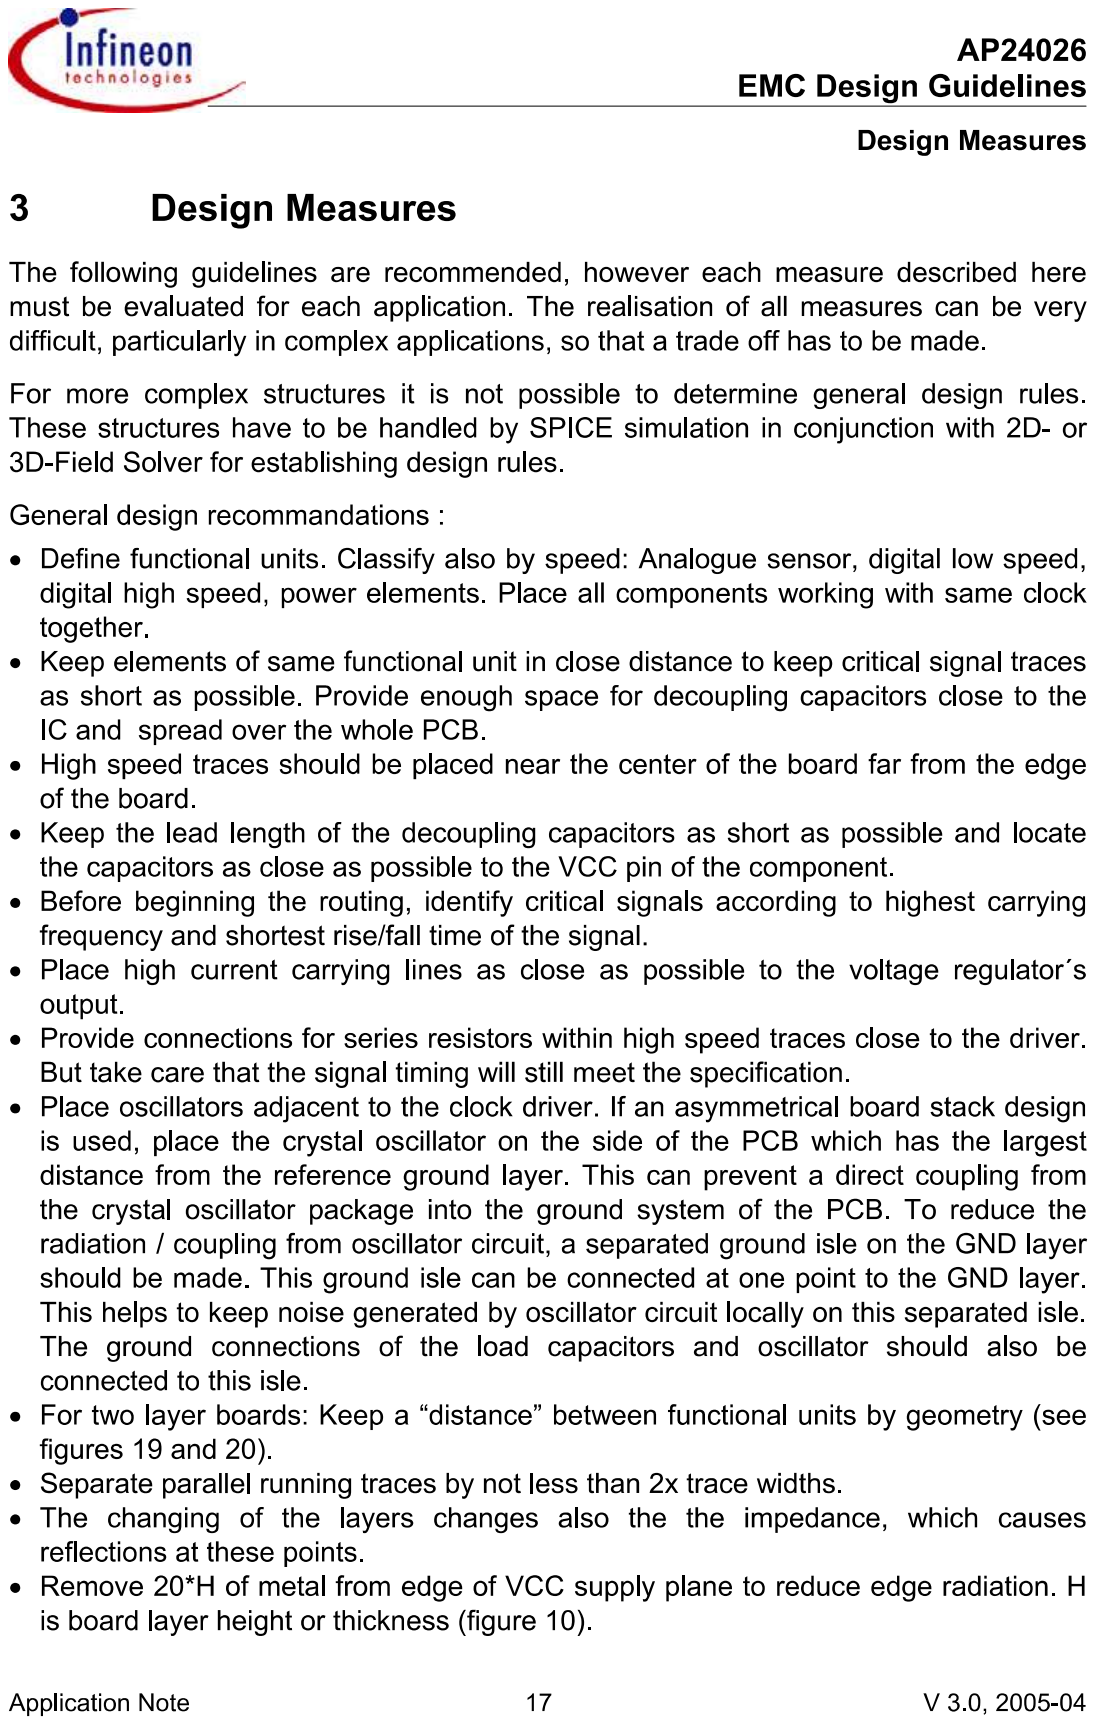
[picture p173: page 1]
