malbreitenbach/adp_tauchspulenelektronik/Ausarbeitung/tudreport/Bilder/aktor_anschlag2.pdf

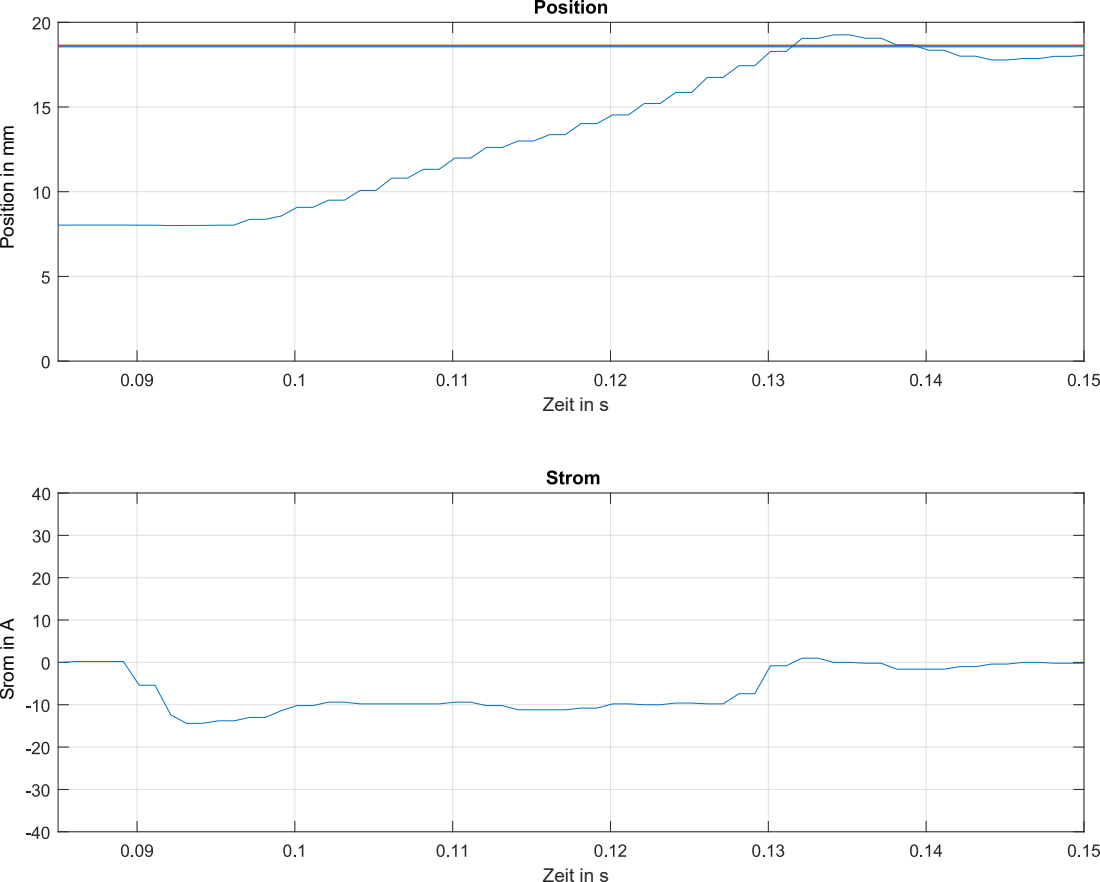
[picture p174: page 1]
Zeit in s

Position in mm Srom in A
