malbreitenbach/adp_tauchspulenelektronik/Ausarbeitung/tudreport/Bilder/quer-eps-converted-to.pdf

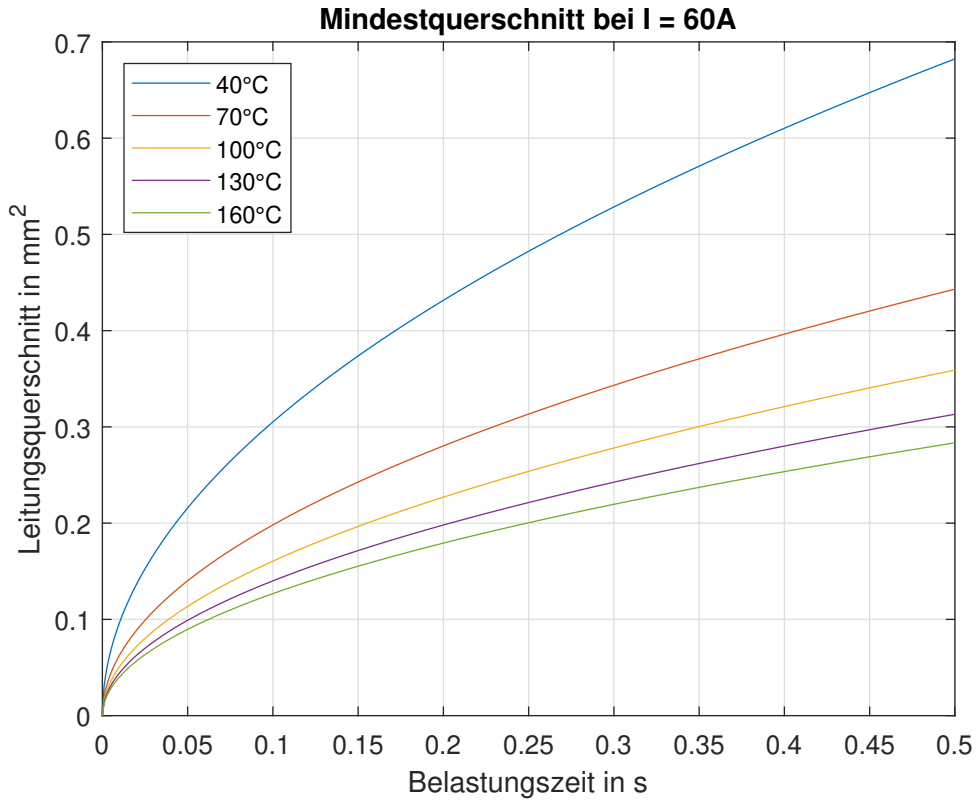
[picture p175: page 1]
Belastungszeit in s; Mindestquerschnitt bei I = 60A

Leitungsquerschnitt in mm
