malbreitenbach/adp_tauchspulenelektronik/Platinenentwurf/BauteileBoard.pdf

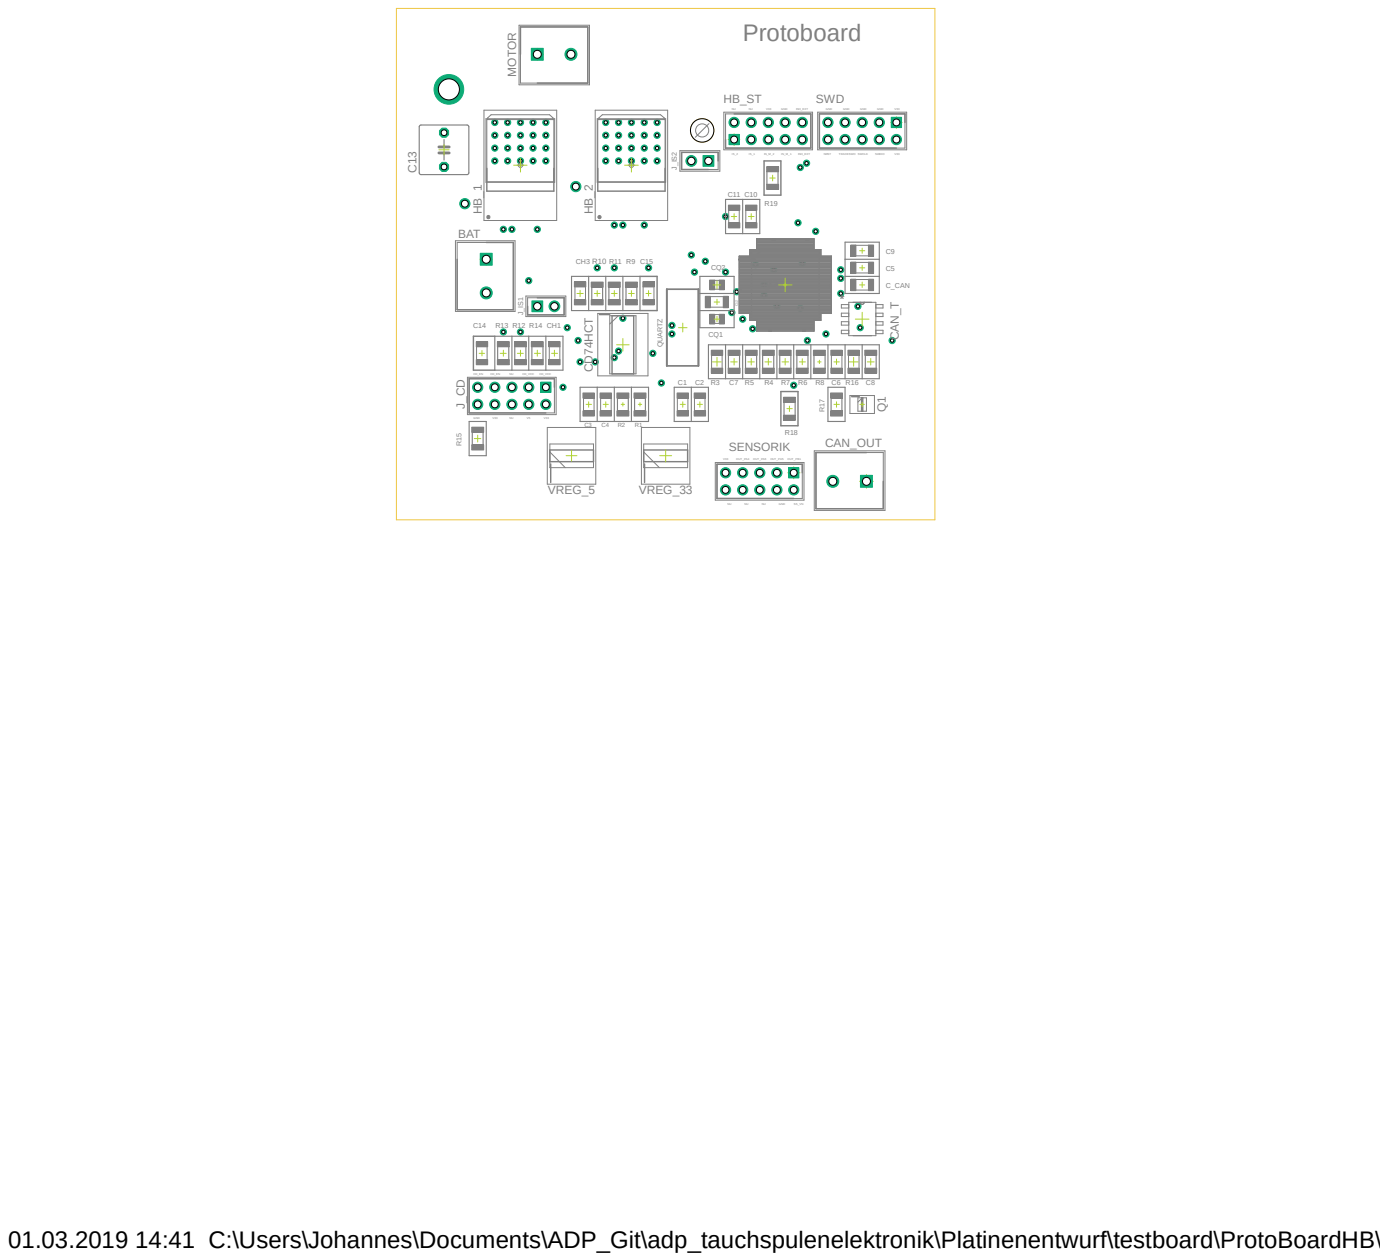
[picture p176: page 1]

U2 | C5 C¹²

01.03.2019 14:41 C:\Users\Johannes\Documents\ADP_Git\adp_tauchspulenelektronik\Platinenentwurf\testboard\ProtoBoardHB\protoBoardHB.brd
