malbreitenbach/adp_tauchspulenelektronik/Ausarbeitung/ADP_ausarbeitung/Bilder/BlockschaltbildMikrocontroller2.pdf

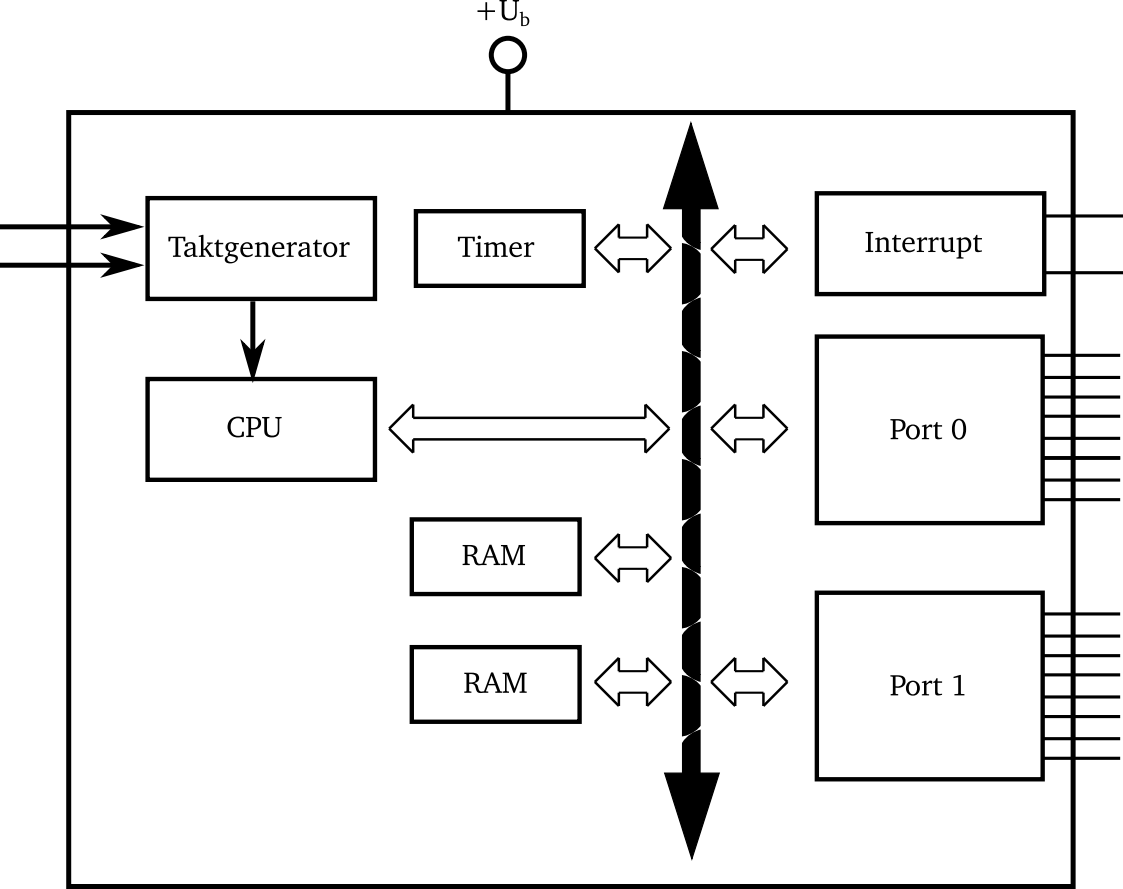
[picture p179: page 1]
