malbreitenbach/adp_tauchspulenelektronik/Ausarbeitung/ADP_ausarbeitung/Bilder/fig_entw_evo4.pdf

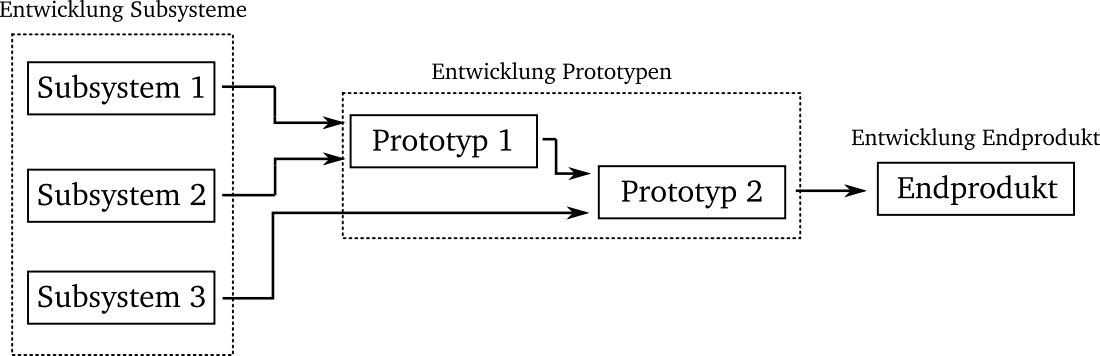
[picture p180: page 1]
