malbreitenbach/adp_tauchspulenelektronik/Ausarbeitung/ADP_ausarbeitung/Bilder/Fahrzeuggetriebe.pdf

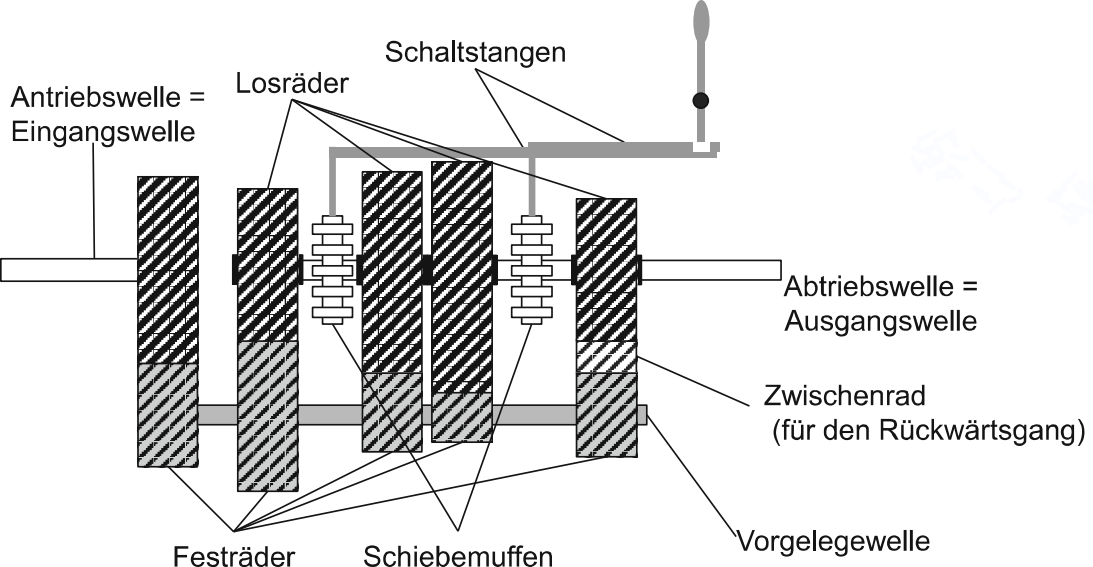
[picture p181: page 1]
