malbreitenbach/adp_tauchspulenelektronik/Ausarbeitung/ADP_ausarbeitung/Bilder/15route4layer.pdf

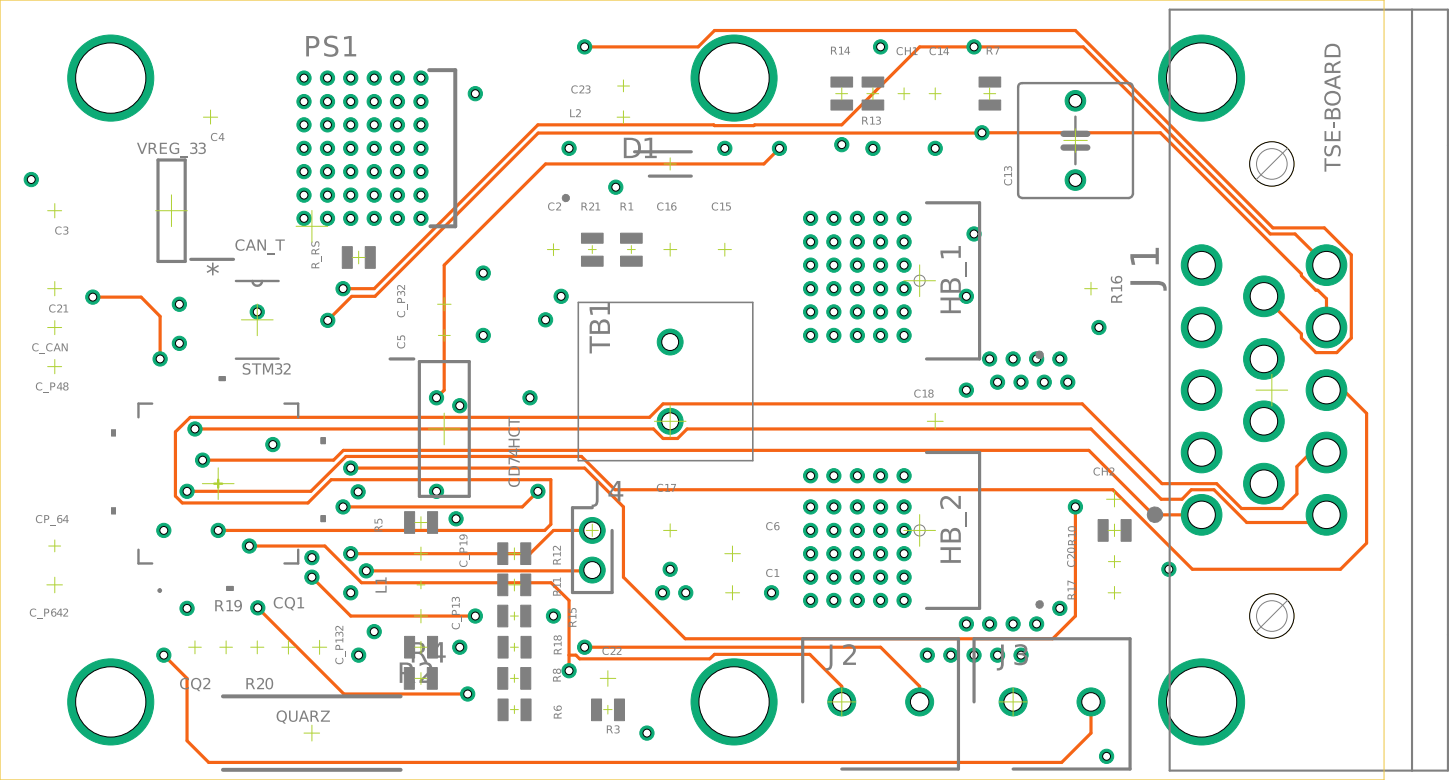
[picture p182: page 1]
