malbreitenbach/adp_tauchspulenelektronik/Ausarbeitung/ADP_ausarbeitung/Bilder/2route4layer.pdf

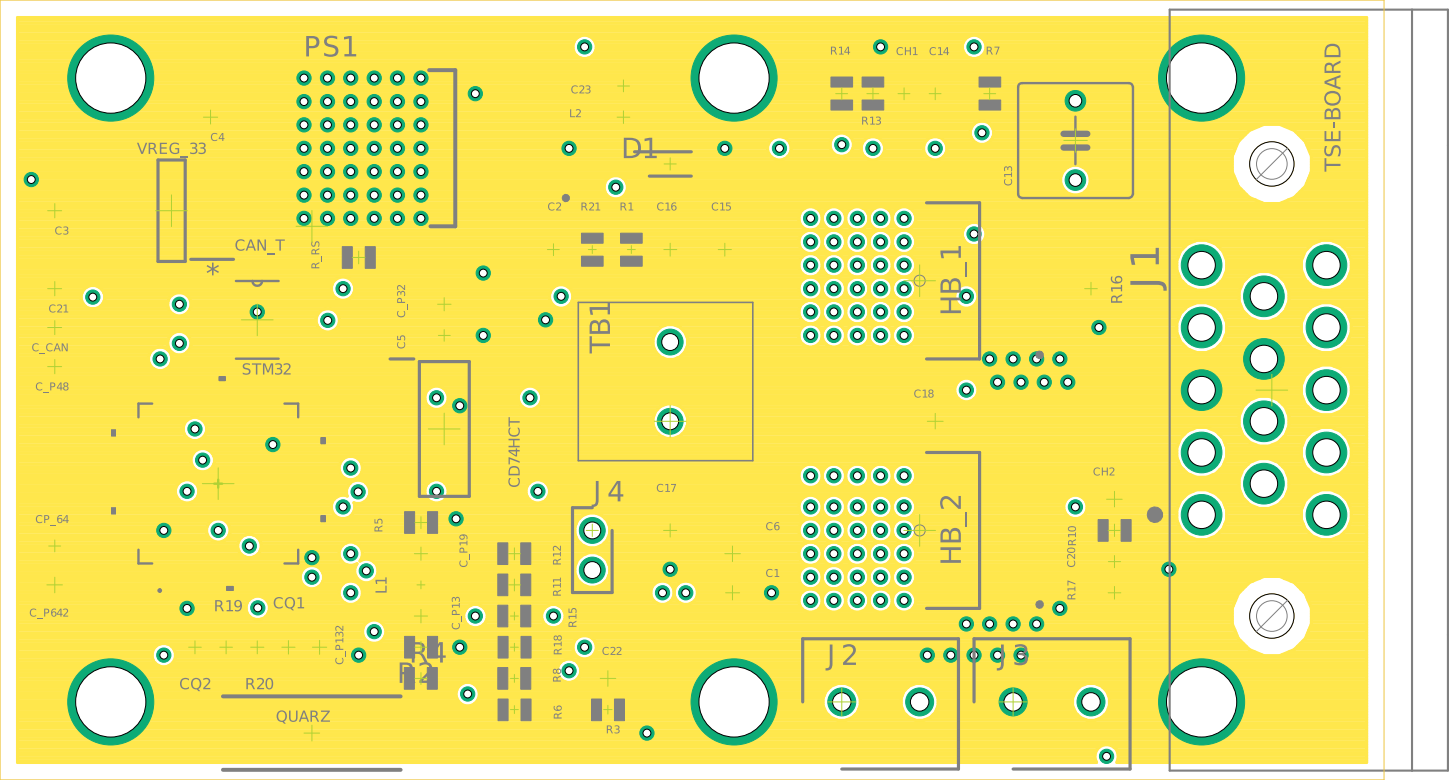
[picture p183: page 1]
