malbreitenbach/adp_tauchspulenelektronik/Ausarbeitung/ADP_ausarbeitung/Bilder/bot4layer.pdf

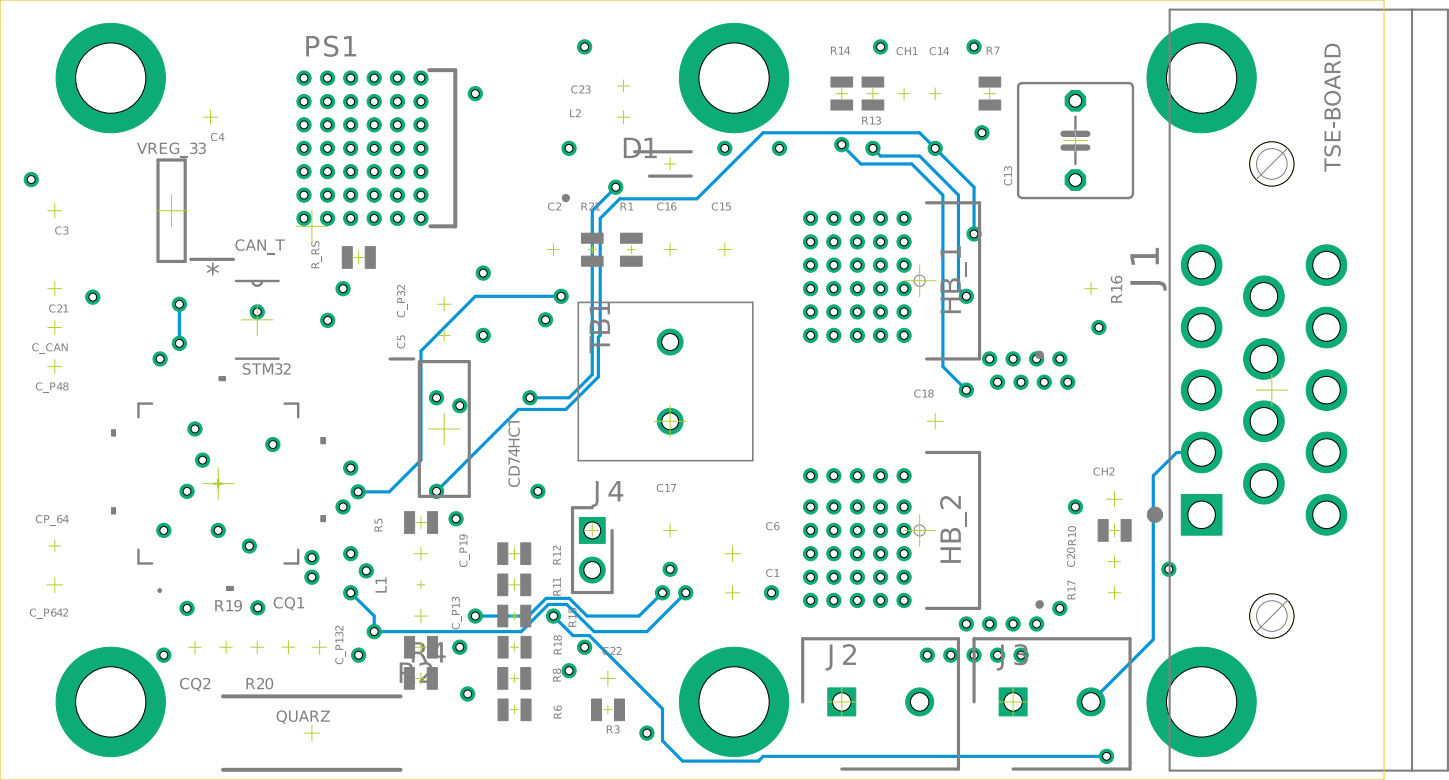
[picture p184: page 1]
