malbreitenbach/adp_tauchspulenelektronik/Ausarbeitung/ADP_ausarbeitung/Bilder/doc4layer.pdf

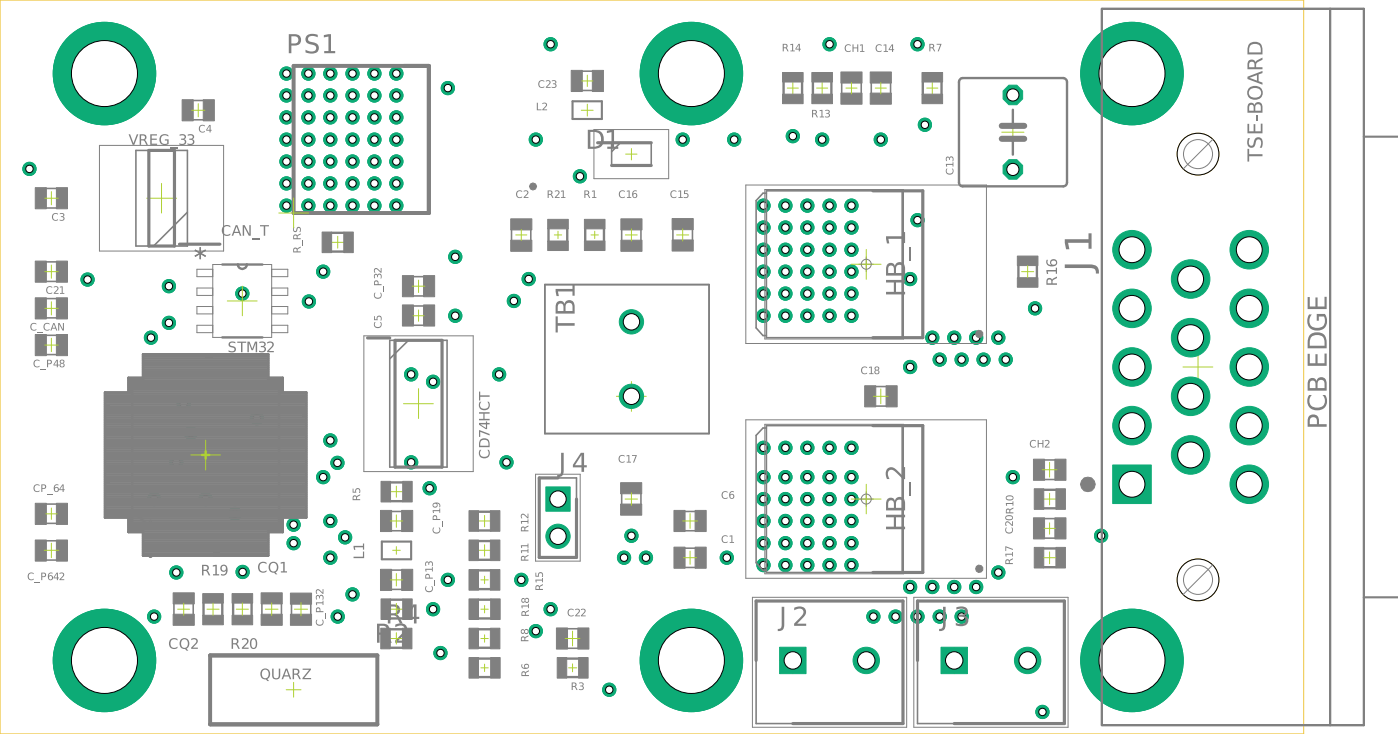
[picture p186: page 1]
