malbreitenbach/adp_tauchspulenelektronik/Ausarbeitung/ADP_ausarbeitung/Bilder/schem_app_1.pdf

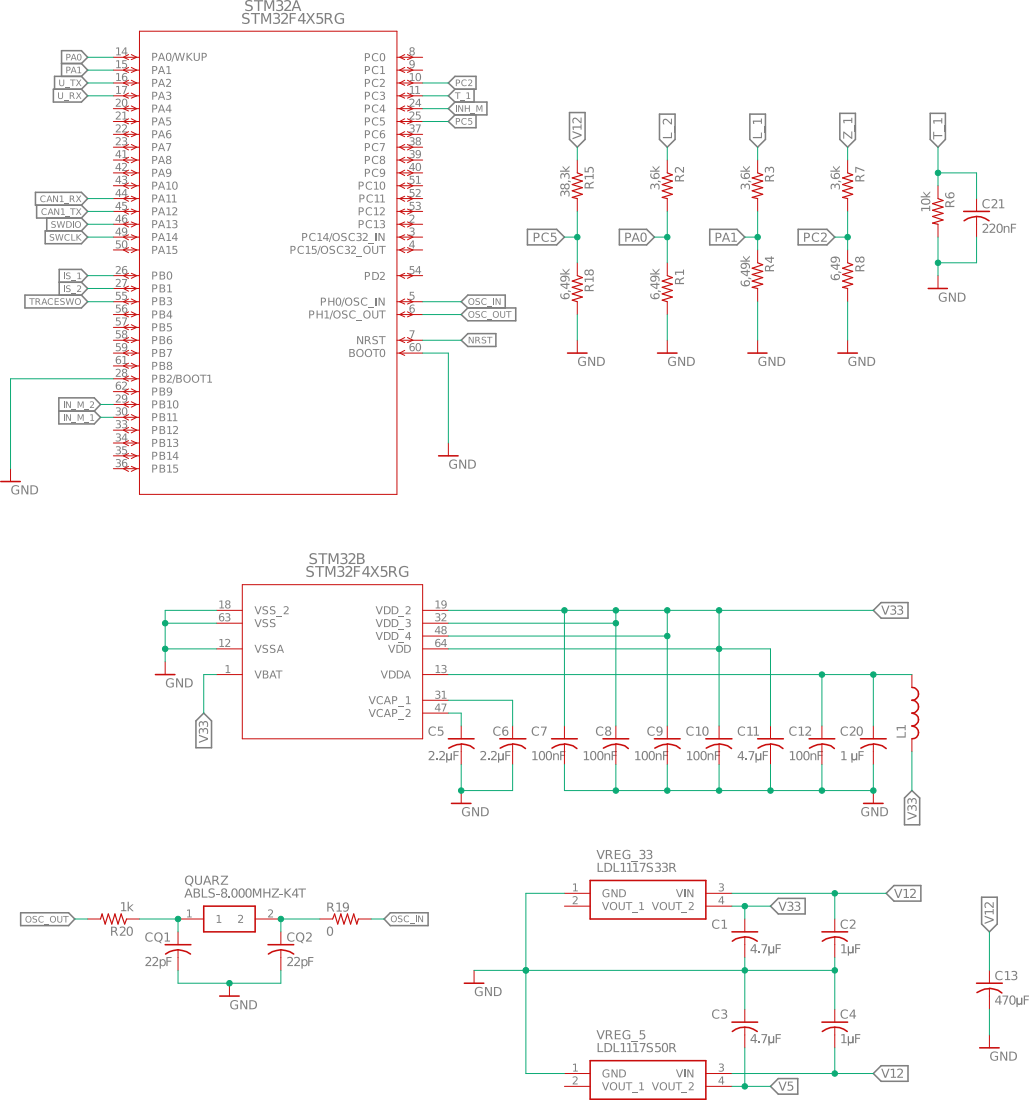
[picture p187: page 1]
