malbreitenbach/adp_tauchspulenelektronik/Ausarbeitung/ADP_ausarbeitung/Bilder/schem_app_2.pdf

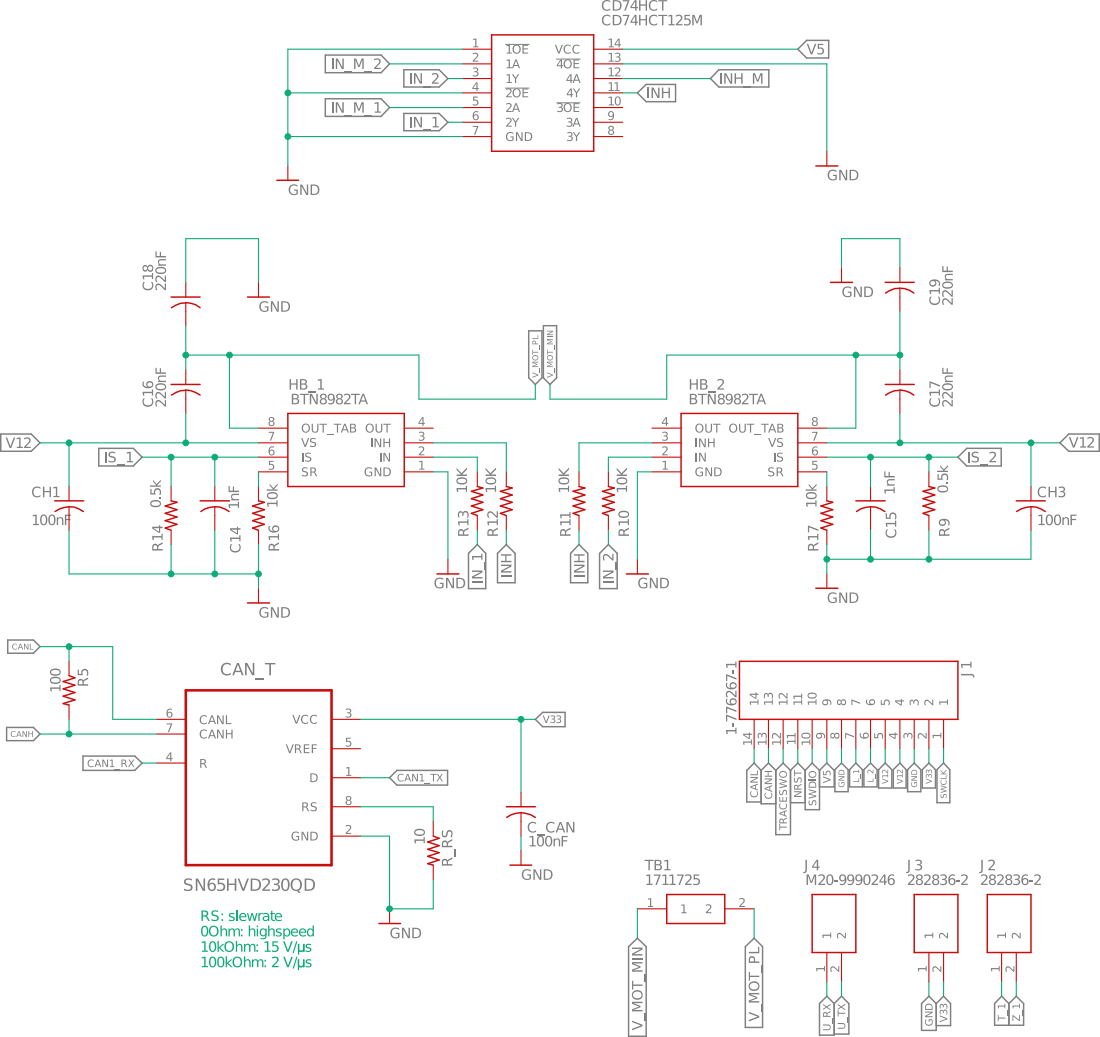
[picture p188: page 1]
