malbreitenbach/adp_tauchspulenelektronik/Ausarbeitung/ADP_ausarbeitung/Bilder/schem_app_3.pdf

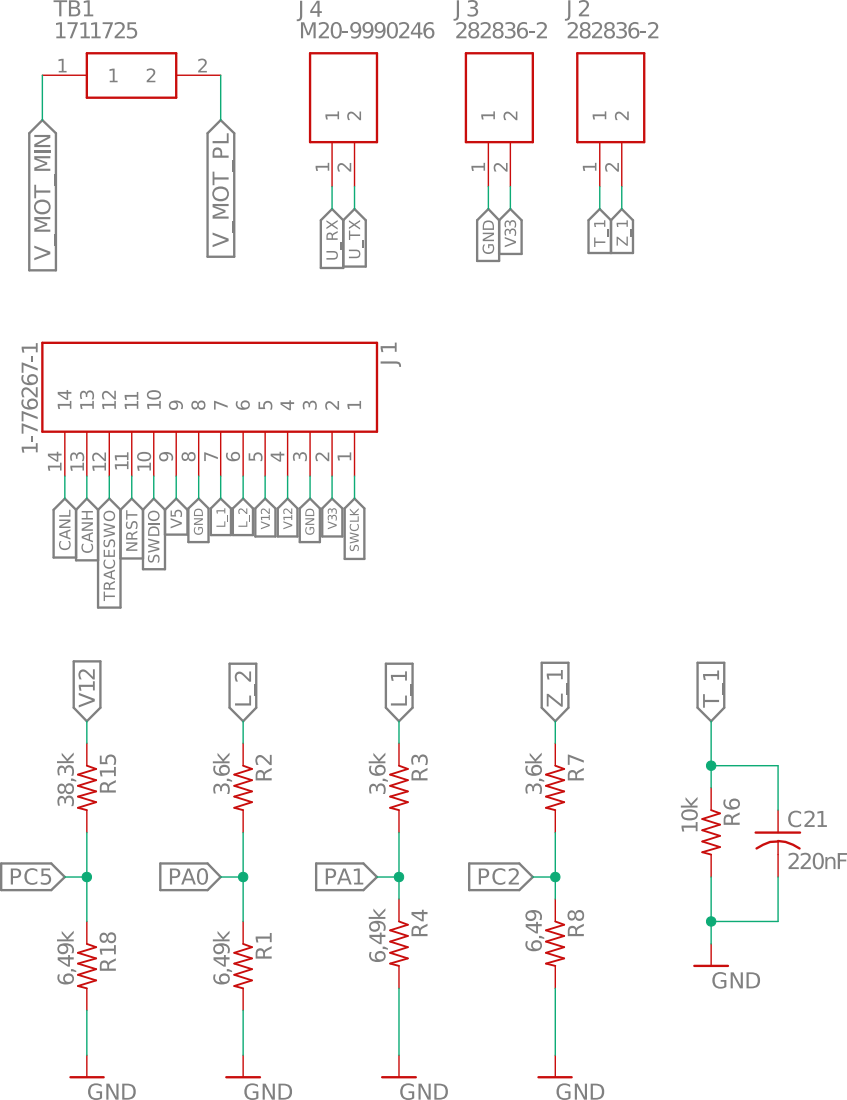
[picture p189: page 1]
