malbreitenbach/adp_tauchspulenelektronik/Ausarbeitung/ADP_ausarbeitung/Bilder/top4layer.pdf

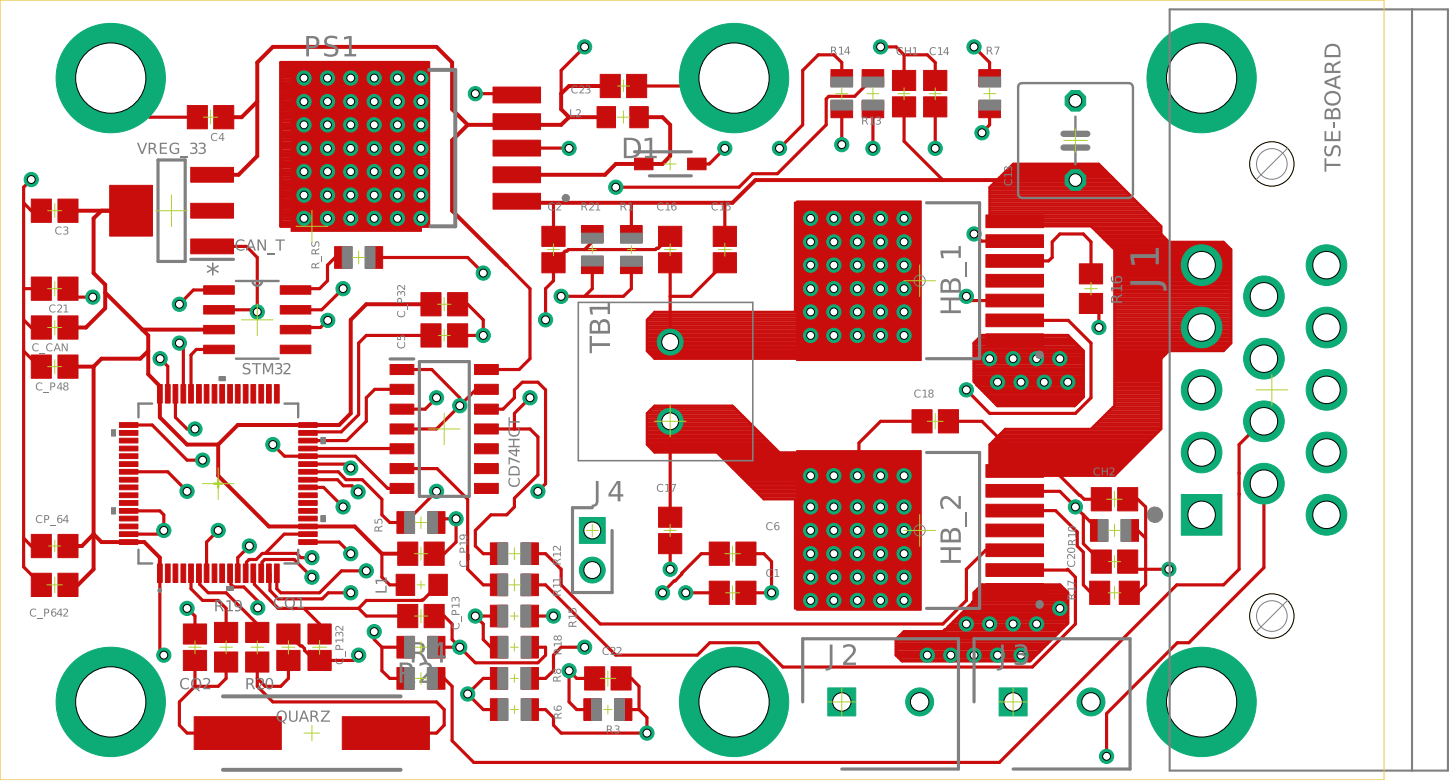
[picture p190: page 1]
