malbreitenbach/adp_tauchspulenelektronik/Ausarbeitung/ADP_ausarbeitung/Bilder/v334layer.pdf

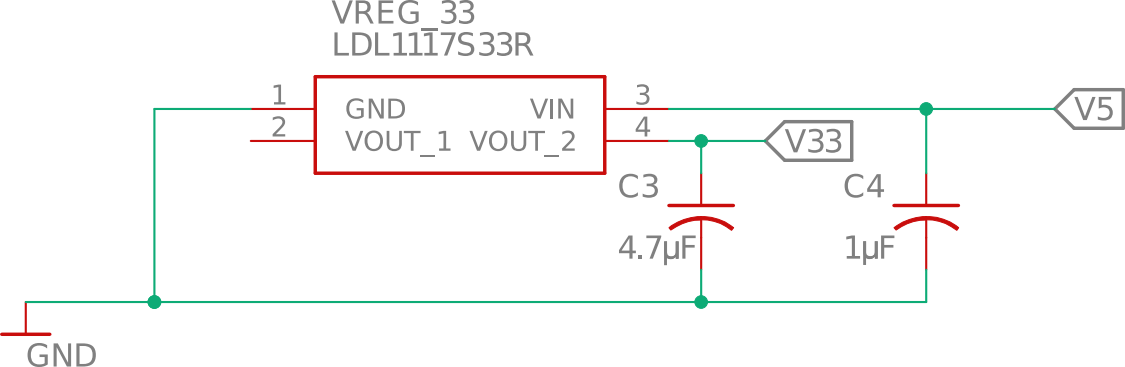
[picture p191: page 1]
