malbreitenbach/adp_tauchspulenelektronik/Ausarbeitung/ADP_ausarbeitung/Bilder/aktor_anschlag2.pdf

Zeit in s

Position in mm Srom in A
