malbreitenbach/adp_tauchspulenelektronik/Ausarbeitung/ADP_ausarbeitung/Bilder/MCU_MIN.pdf

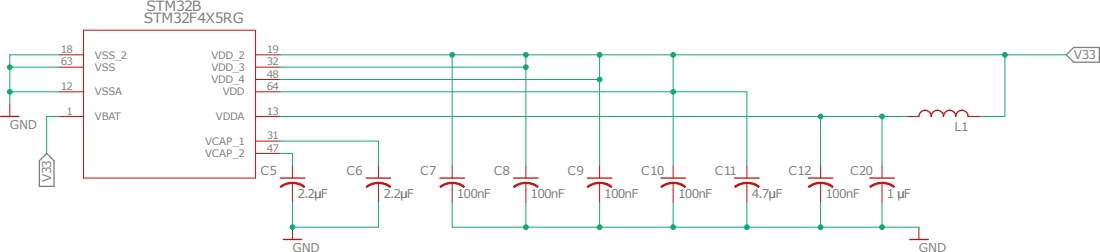
[picture p192: page 1]
