malbreitenbach/adp_tauchspulenelektronik/Ausarbeitung/ADP_ausarbeitung/Bilder/fig_main_detail.pdf

# Initialisierung

# Kalibrierpara-

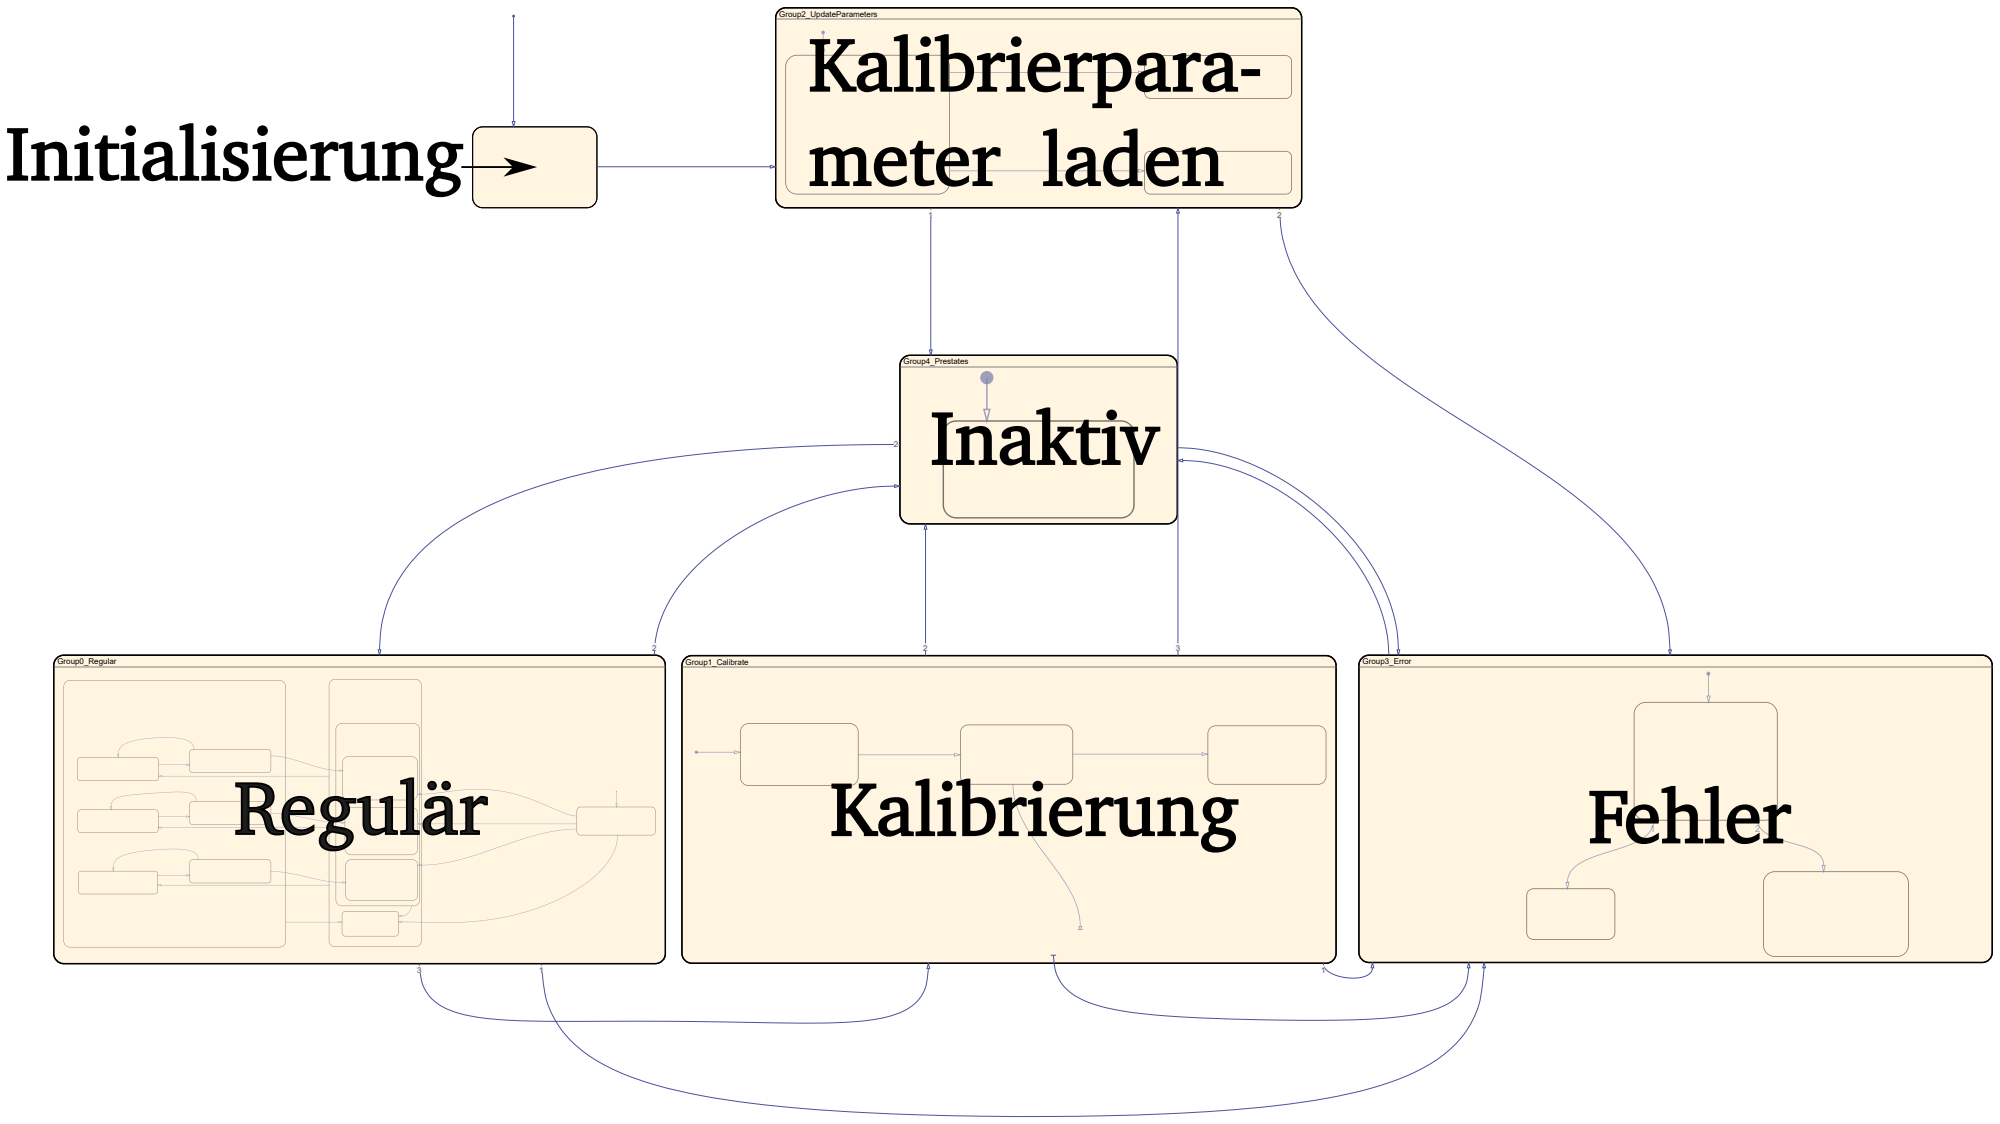
[picture p193: page 1]
Group0_Regular; Group1_Calibrate; Group3_Error; Group4_Prestates; Group2_UpdateParameters; meter laden; Inaktiv; Regulär; Kalibrierung; Fehler
