malbreitenbach/adp_tauchspulenelektronik/Ausarbeitung/ADP_ausarbeitung/Bilder/eingangs_sens.pdf

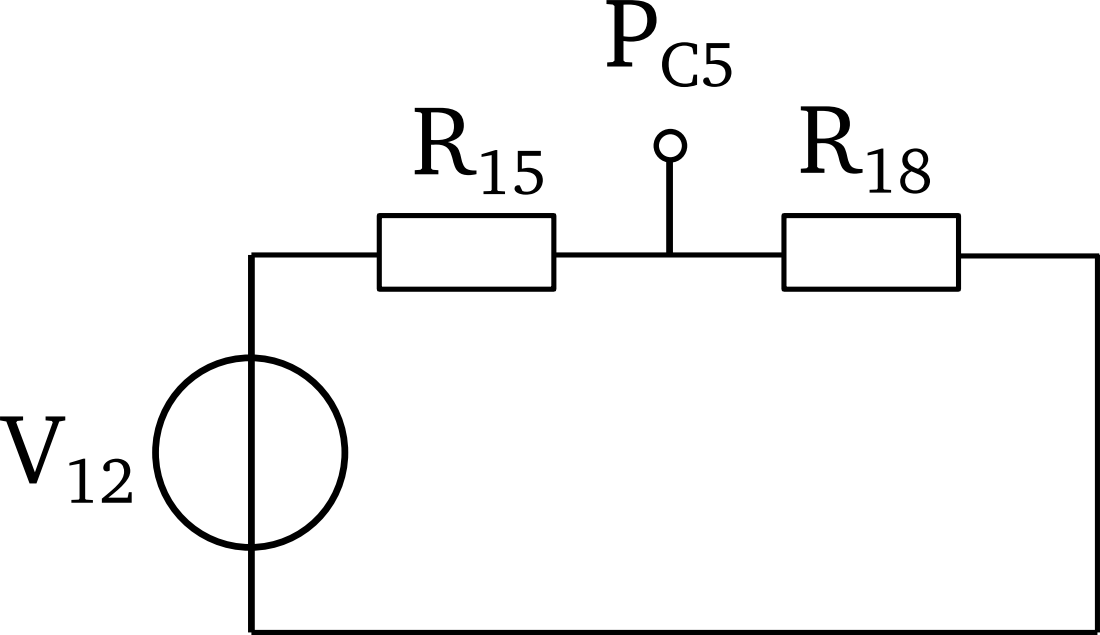
[picture p195: page 1]
