malbreitenbach/adp_tauchspulenelektronik/Ausarbeitung/ADP_ausarbeitung/Bilder/btn8982.pdf

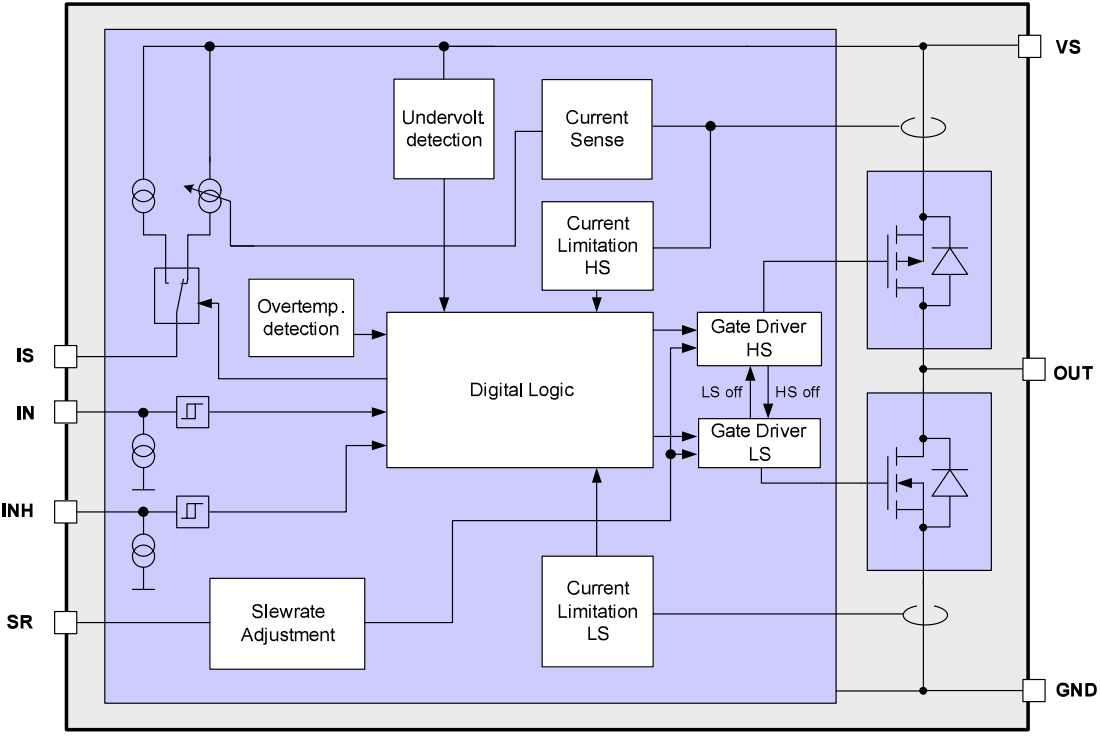
[picture p196: page 1]
