malbreitenbach/adp_tauchspulenelektronik/Ausarbeitung/ADP_ausarbeitung/Bilder/IS_PIn.pdf

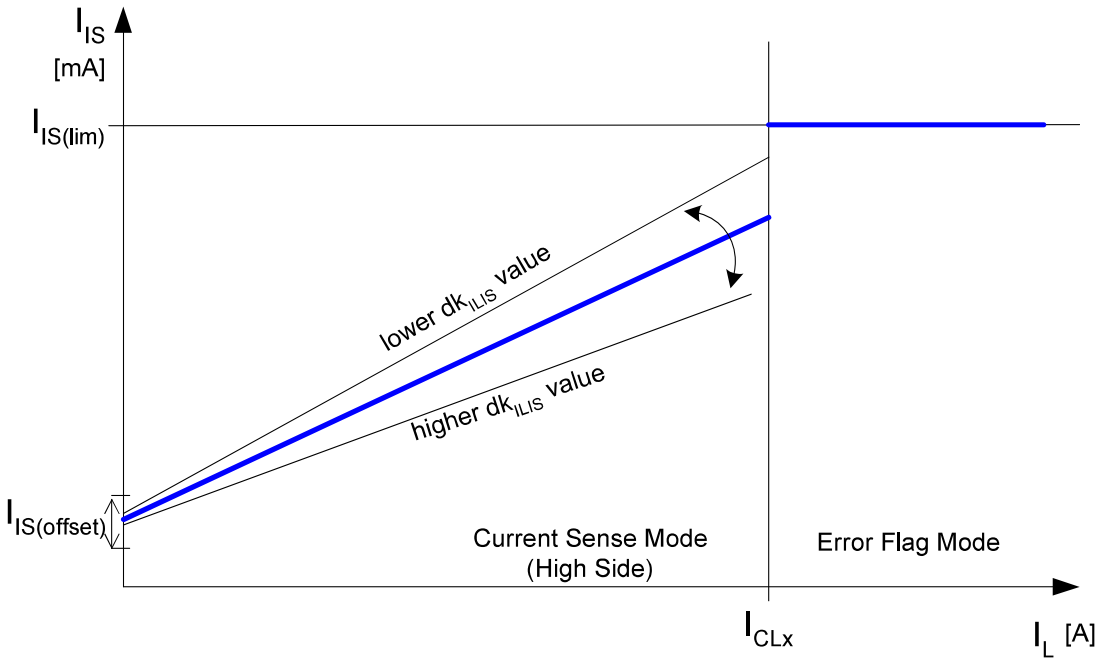
[picture p197: page 1]
