malbreitenbach/adp_tauchspulenelektronik/Platinenentwurf/Platinendateien[4094]/Platinendateien/Eagle/Board4Layer(Alternative)/Board.brd

## EAGLE design Platinenentwurf/Platinendateien[4094]/Platinendateien/Eagle/Board4Layer(Alternative)/Board.brd (2019-10-24)

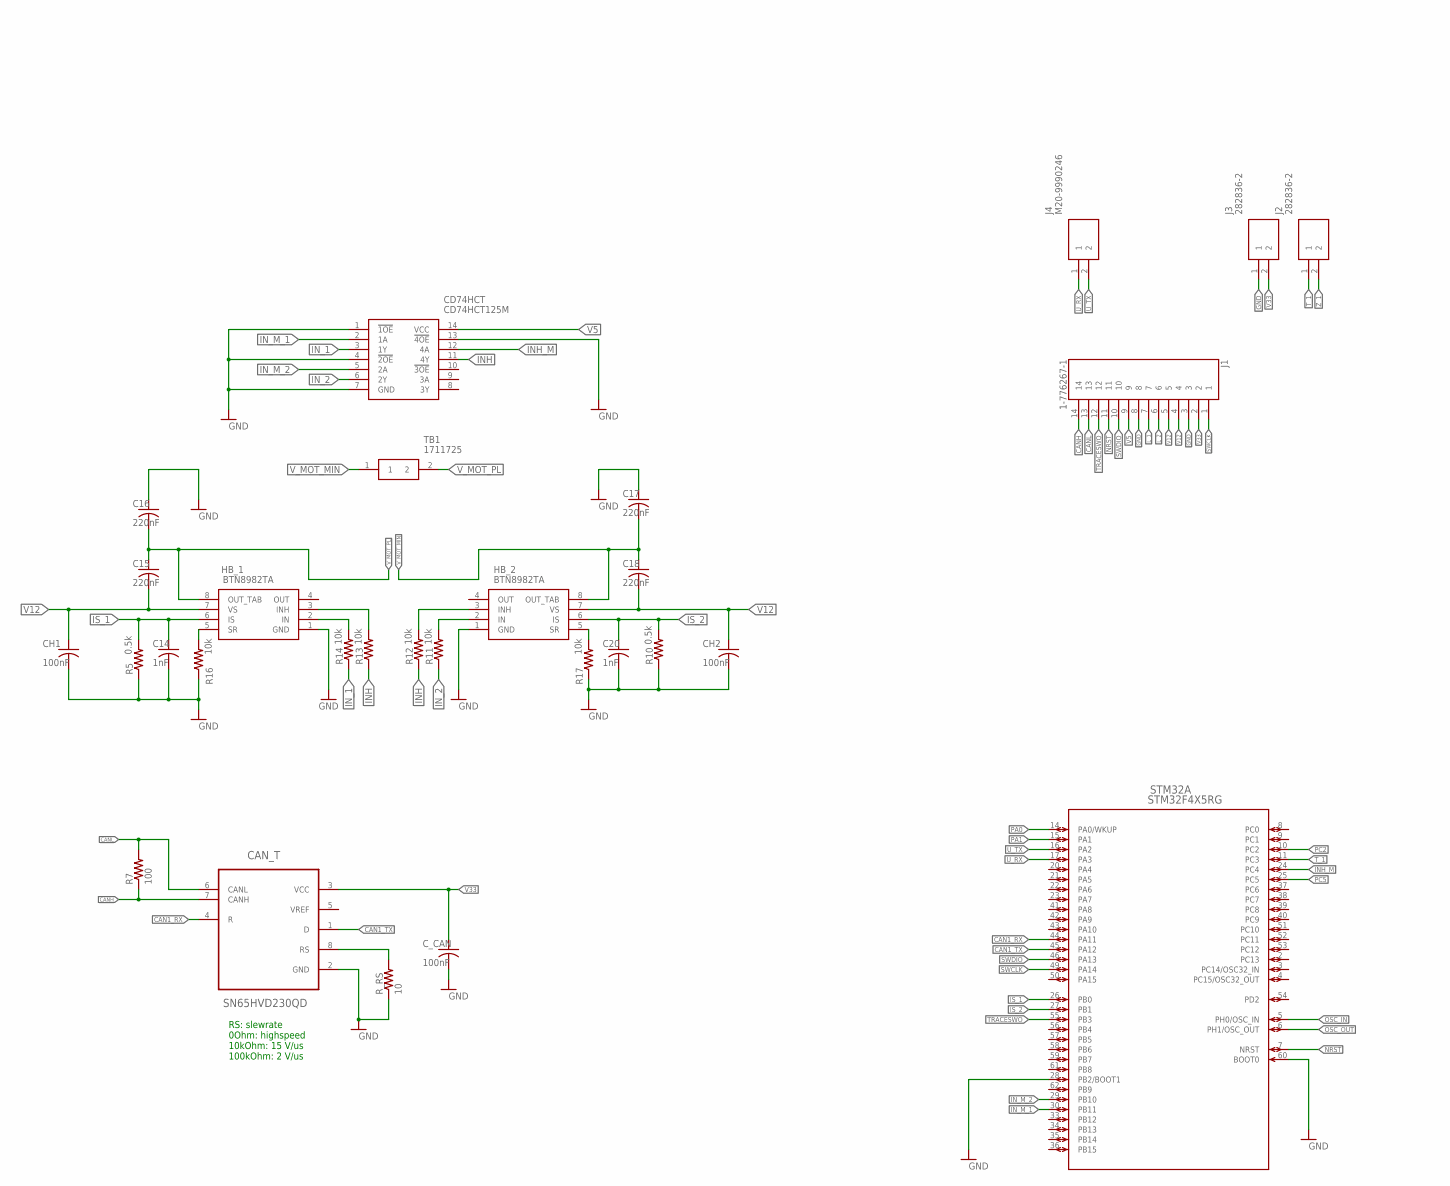
[picture p198: schematic Board.sch, part in row 1, column 1]

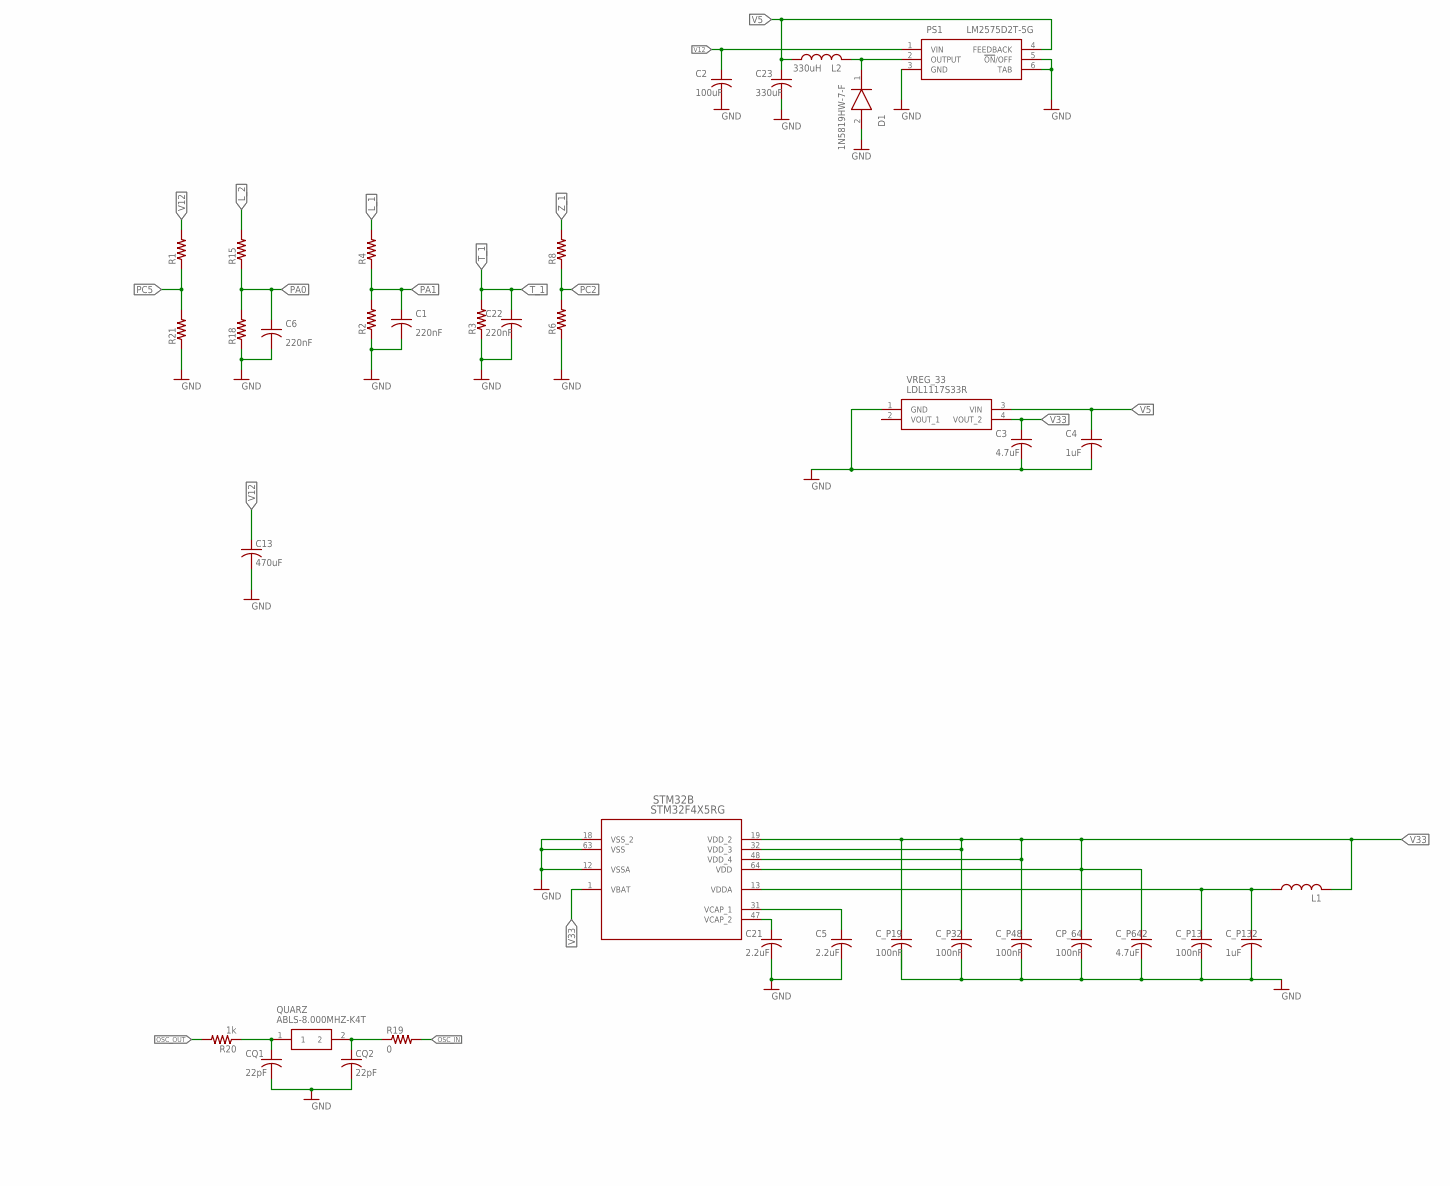
[picture p199: schematic Board.sch, part in row 1, column 2]

Parts:
C1, C6, C15, C16, C17, C18, C22: 220nF; C0805
C2: 100uF; C0805
C3: 4.7uF; C0805
C4: 1uF; C0805
C5, C21: 2.2uF; C0805
C13: 470uF; C050-075X075
C14, C20: 1nF; C0805
C23: 330uF; C0805
CAN_T: SN65HVD230QD; SOIC127P600X175-8N; MPN SN65HVD230QD..
CD74HCT: CD74HCT125M; SOIC127P600X175-14N
CH1, CH2: 100nF; C0805
CP_64: 100nF; C0805
CQ1, CQ2: 22pF; C0805
C_CAN: 100nF; C0805
C_P13, C_P19, C_P32, C_P48: 100nF; C0805
C_P132: 1uF; C0805
C_P642: 4.7uF; C0805
D1: 1N5819HW-7-F; SOD3716X145N
HB_1, HB_2: BTN8982TA; TO127P1500X440-8N
J1: 1-776267-1; TE_1-776267-1
J2, J3: 282836-2; SHDR2W100P0X500_1X2_1000X820X1
J4: M20-9990246; HDRV2W64P0X254_1X2_508X254X864
L1: INDUCTOR_0805_N; RESC0805_N
L2: 330uH; RESC0805_N
PS1: LM2575D2T-5G; D2TSUFFIX-CASE936A-02-ISSUEC
QUARZ: ABLS-8.000MHZ-K4T; ABLS-12.000MHZ-B2; MPN ABLS-8.000MHZ-K4T
R1, R2, R3, R4, R6, R8, R15, R18, R21: R-US_R0805; R0805
R5, R10: 0.5k; R0805
R7: 100; R0805
R11, R12, R13, R14, R16, R17: 10k; R0805
R19: 0; R0805
R20: 1k; R0805
R_RS: 10; R0805
STM32: STM32F4X5RG; LQFP64-10X10MM
TB1: 1711725; PHEONIX-5.08PITCH-2PIN
VREG_33: LDL1117S33R; SOT230P700X180-4N; MPN LDL1117S33R

Connections:
CAN1_RX: CAN_T.4 (R), STM32.44 (PA11)
CAN1_TX: CAN_T.1 (D), STM32.45 (PA12)
CANH: CAN_T.7 (CANH), J1.14, R7.1
CANL: CAN_T.6 (CANL), J1.13, R7.2
CAN_RS: CAN_T.8 (RS), R_RS.2
GND: C1.2, C2.2, C3.2, C4.2, C5.2, C6.2, C13.2, C14.2, C16.1, C17.1, C20.2, C21.2, C22.2, C23.2, CAN_T.2 (GND), CD74HCT.1 (!1OE), CD74HCT.4 (!2OE), CD74HCT.7 (GND), CD74HCT.13 (!4OE), CH1.2, CH2.2, CP_64.2, CQ1.2, CQ2.2, C_CAN.2, C_P13.2, C_P19.2, C_P32.2, C_P48.2, C_P132.2, C_P642.2, D1.2 (A), HB_1.1 (GND), HB_2.1 (GND), J1.3, J1.8, J3.1, PS1.3 (GND), PS1.5 (!ON!/OFF), PS1.6 (TAB), R2.1, R3.1, R5.1, R6.1, R10.1, R16.1, R17.1, R18.1, R21.1, R_RS.1, STM32.12 (VSSA), STM32.18 (VSS_2), STM32.28 (PB2/BOOT1), STM32.60 (BOOT0), STM32.63 (VSS), VREG_33.1 (GND)
HB1_IN: HB_1.2 (IN), R14.2
HB1_INH: HB_1.3 (INH), R13.2
HB2_IN: HB_2.2 (IN), R11.2
HB2_INH: HB_2.3 (INH), R12.2
INH: CD74HCT.11 (4Y), R12.1, R13.1
INH_M: CD74HCT.12 (4A), STM32.24 (PC4)
IN_1: CD74HCT.3 (1Y), R14.1
IN_2: CD74HCT.6 (2Y), R11.1
IN_M_1: CD74HCT.2 (1A), STM32.30 (PB11)
IN_M_2: CD74HCT.5 (2A), STM32.29 (PB10)
IS_1: C14.1, HB_1.6 (IS), R5.2, STM32.26 (PB0)
IS_2: C20.1, HB_2.6 (IS), R10.2, STM32.27 (PB1)
L_1: J1.7, R4.2
L_2: J1.6, R15.2
unnamed: D1.1 (K), L2.2, PS1.2 (OUTPUT)
NRST: J1.11, STM32.7 (NRST)
OSC_IN: R19.2, STM32.5 (PH0/OSC_IN)
OSC_OUT: R20.2, STM32.6 (PH1/OSC_OUT)
PA0: C6.1, R15.1, R18.2, STM32.14 (PA0/WKUP)
PA1: C1.1, R2.2, R4.1, STM32.15 (PA1)
PC2: R6.2, R8.1, STM32.10 (PC2)
PC5: R1.1, R21.2, STM32.25 (PC5)
Q_IN: CQ2.1, QUARZ.2, R19.1
Q_OUT: CQ1.1, QUARZ.1, R20.1
SR1: HB_1.5 (SR), R16.2
SR2: HB_2.5 (SR), R17.2
SWCLK: J1.1, STM32.49 (PA14)
SWDIO: J1.10, STM32.46 (PA13)
TRACESWO: J1.12, STM32.55 (PB3)
T_1: C22.1, J2.1, R3.2, STM32.11 (PC3)
U_RX: J4.1, STM32.17 (PA3)
U_TX: J4.2, STM32.16 (PA2)
V5: C4.1, C23.1, CD74HCT.14 (VCC), J1.9, L2.1, PS1.4 (FEEDBACK), VREG_33.3 (VIN)
V12: C2.1, C13.1, C15.2, C18.2, CH1.1, CH2.1, HB_1.7 (VS), HB_2.7 (VS), J1.4, J1.5, PS1.1 (VIN), R1.2
V33: C3.1, CAN_T.3 (VCC), CP_64.1, C_CAN.1, C_P19.1, C_P32.1, C_P48.1, C_P642.1, J1.2, J3.2, L1.2, STM32.1 (VBAT), STM32.19 (VDD_2), STM32.32 (VDD_3), STM32.48 (VDD_4), STM32.64 (VDD), VREG_33.4 (VOUT_2)
VCAP_1: C5.1, STM32.31 (VCAP_1)
VCAP_2: C21.1, STM32.47 (VCAP_2)
VDDA: C_P13.1, C_P132.1, L1.1, STM32.13 (VDDA)
V_MOT_MIN: C17.2, C18.1, HB_2.8 (OUT_TAB), TB1.1
V_MOT_PL: C15.1, C16.2, HB_1.8 (OUT_TAB), TB1.2
Z_1: J2.2, R8.2

Notes on the sheet:
RS: slewrate 0Ohm: highspeed 10kOhm: 15 V/us 100kOhm: 2 V/us

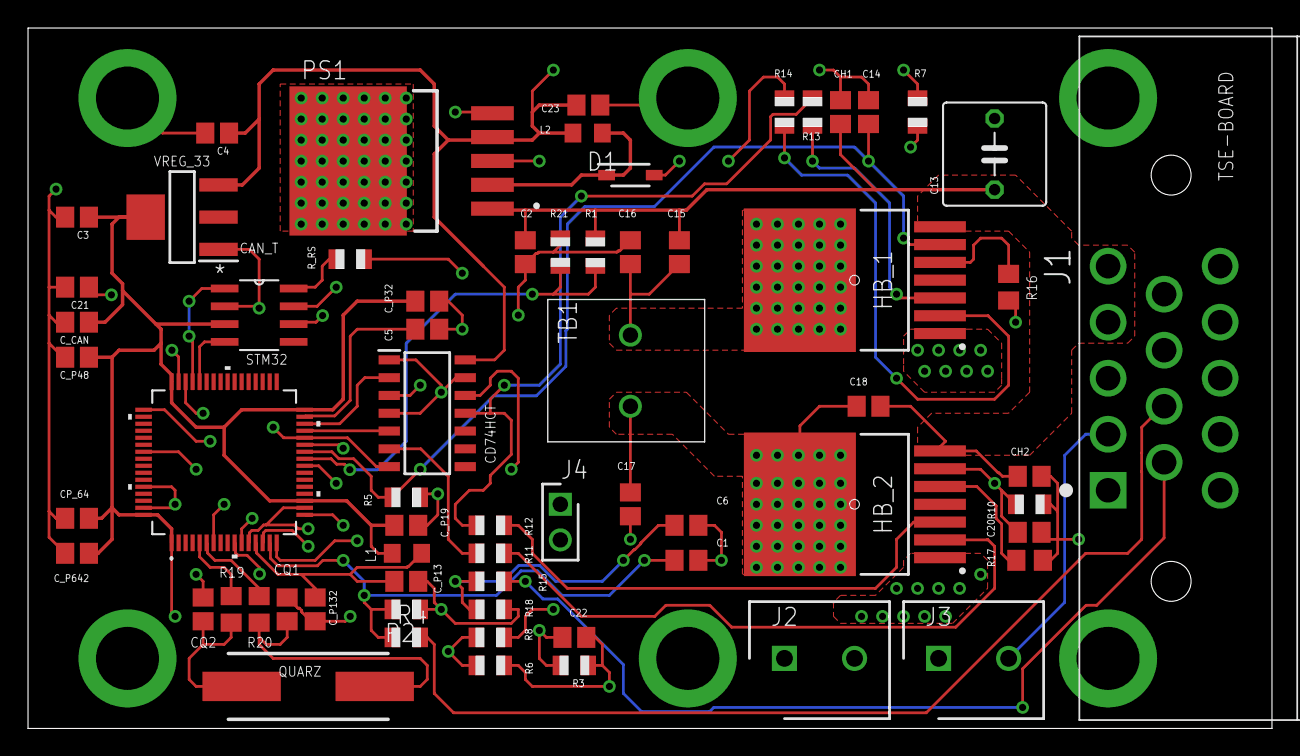
[picture p200: board Platinenentwurf/Platinendateien[4094]/Platinendateien/Eagle/Board4Lay… from above]

Board: 4 copper layers, 88.8 x 50.0 mm, 65 parts (0 on the bottom side), 47 nets.
