malbreitenbach/adp_tauchspulenelektronik/Platinenentwurf/weitere_bauteile/testboard/protoBoardLogic.brd

## EAGLE design Platinenentwurf/weitere_bauteile/testboard/protoBoardLogic.brd (2019-02-17)

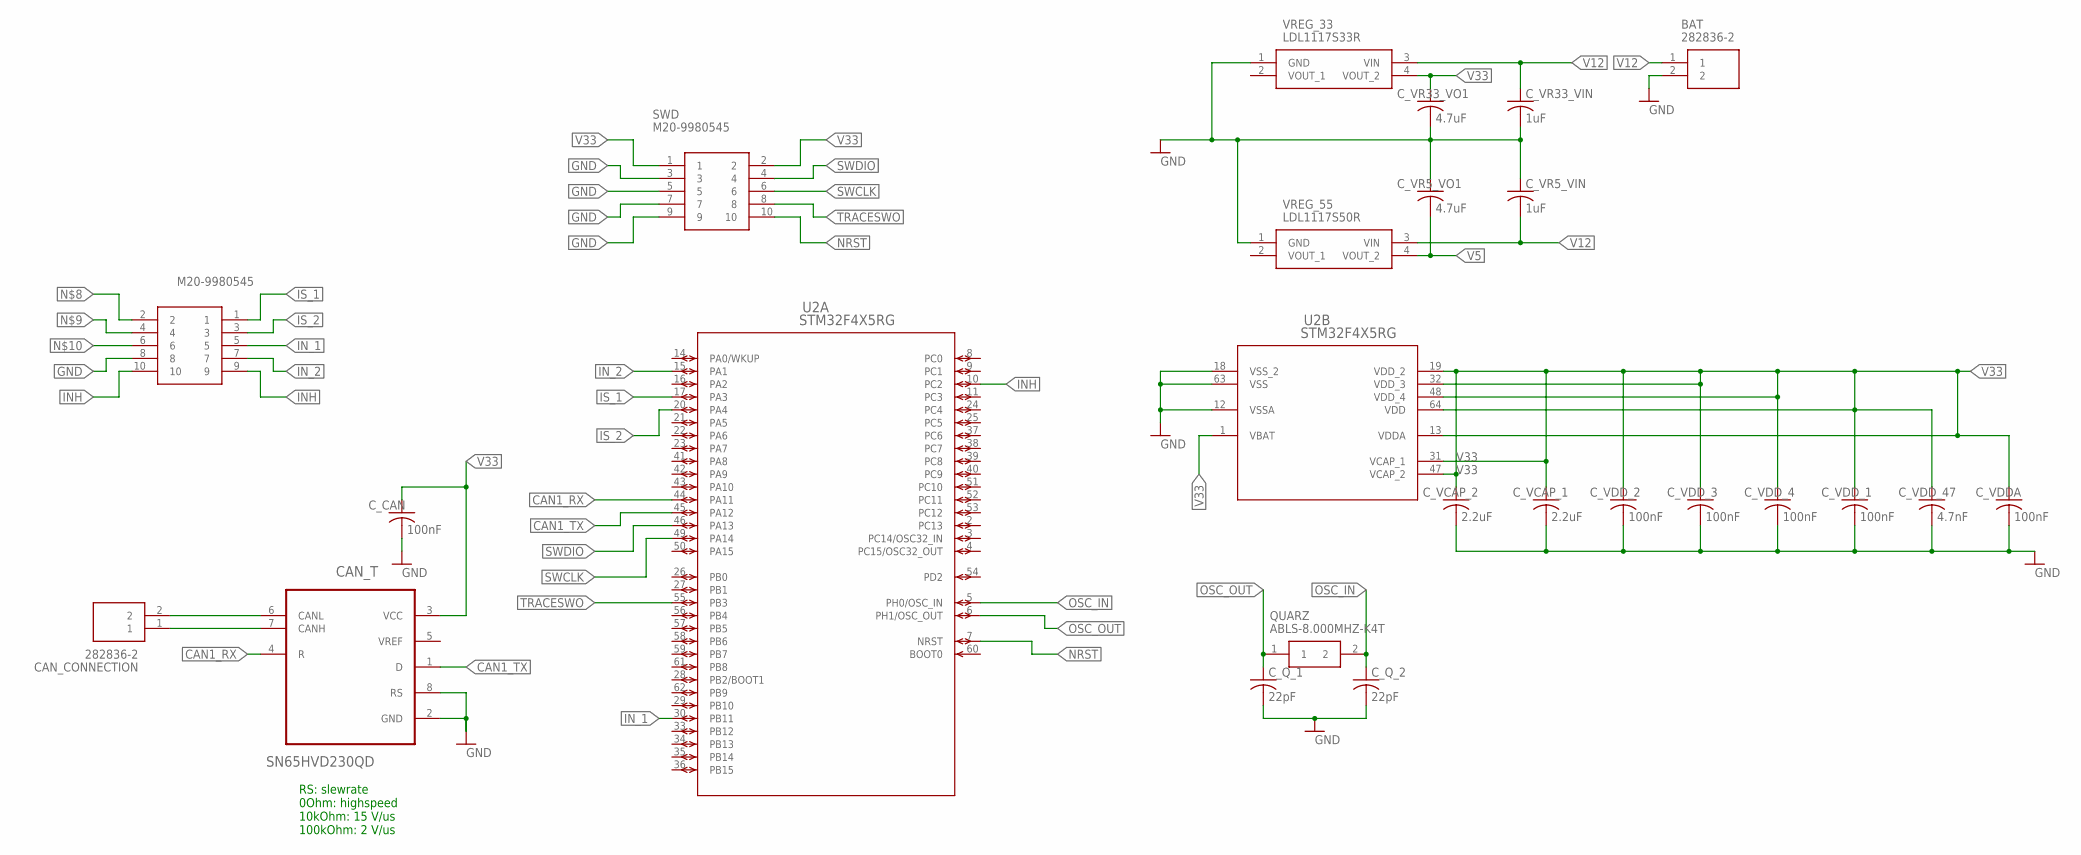
[picture p204: schematic protoBoardLogic.sch]

Parts:
BAT: 282836-2; SHDR2W100P0X500_1X2_1000X820X1
CAN_CONNECTION: 282836-2; SHDR2W100P0X500_1X2_1000X820X1
CAN_T: SN65HVD230QD; SOIC127P600X175-8N; MPN SN65HVD230QD..
C_CAN: 100nF; C1206
C_Q_1, C_Q_2: 22pF; C0805
C_VCAP_1, C_VCAP_2: 2.2uF; C1206
C_VDDA: 100nF; C1206
C_VDD_1, C_VDD_2, C_VDD_3, C_VDD_4: 100nF; C1206
C_VDD_47: 4.7nF; C1206
C_VR5_VIN, C_VR33_VIN: 1uF; C1206
C_VR5_VO1, C_VR33_VO1: 4.7uF; C1206
HB_ST: M20-9980545; HDRV10W80P254_2X5_1270X508X864; MPN M20-9980545
QUARZ: ABLS-8.000MHZ-K4T; ABLS-12.000MHZ-B2; MPN ABLS-8.000MHZ-K4T
SWD: M20-9980545; HDRV10W80P254_2X5_1270X508X864; MPN M20-9980545
U2: STM32F4X5RG; LQFP64-10X10MM
VREG_33: LDL1117S33R; SOT230P700X180-4N; MPN LDL1117S33R
VREG_55: LDL1117S50R; SOT230P700X180-4N; MPN LDL1117S50R

Connections:
CAN1_RX: CAN_T.4 (R), U2.44 (PA11)
CAN1_TX: CAN_T.1 (D), U2.45 (PA12)
CANH: CAN_CONNECTION.1, CAN_T.7 (CANH)
CANL: CAN_CONNECTION.2, CAN_T.6 (CANL)
GND: BAT.2, CAN_T.2 (GND), CAN_T.8 (RS), C_CAN.2, C_Q_1.2, C_Q_2.2, C_VCAP_1.2, C_VCAP_2.2, C_VDDA.2, C_VDD_1.2, C_VDD_2.2, C_VDD_3.2, C_VDD_4.2, C_VDD_47.2, C_VR5_VIN.1, C_VR5_VO1.1, C_VR33_VIN.2, C_VR33_VO1.2, HB_ST.8, SWD.3, SWD.5, SWD.7, SWD.9, U2.12 (VSSA), U2.18 (VSS_2), U2.63 (VSS), VREG_33.1 (GND), VREG_55.1 (GND)
INH: HB_ST.9, HB_ST.10, U2.10 (PC2)
IN_1: HB_ST.5, U2.30 (PB11)
IN_2: HB_ST.7, U2.15 (PA1)
IS_1: HB_ST.1, U2.17 (PA3)
IS_2: HB_ST.3, U2.20 (PA4)
NRST: SWD.10, U2.7 (NRST)
OSC_IN: C_Q_2.1, QUARZ.2, U2.5 (PH0/OSC_IN)
OSC_OUT: C_Q_1.1, QUARZ.1, U2.6 (PH1/OSC_OUT)
SWCLK: SWD.6, U2.49 (PA14)
SWDIO: SWD.4, U2.46 (PA13)
TRACESWO: SWD.8, U2.55 (PB3)
V5: C_VR5_VO1.2, VREG_55.4 (VOUT_2)
V12: BAT.1, C_VR5_VIN.2, C_VR33_VIN.1, VREG_33.3 (VIN), VREG_55.3 (VIN)
V33: CAN_T.3 (VCC), C_CAN.1, C_VCAP_1.1, C_VCAP_2.1, C_VDDA.1, C_VDD_1.1, C_VDD_2.1, C_VDD_3.1, C_VDD_4.1, C_VDD_47.1, C_VR33_VO1.1, SWD.1, SWD.2, U2.1 (VBAT), U2.13 (VDDA), U2.19 (VDD_2), U2.31 (VCAP_1), U2.32 (VDD_3), U2.47 (VCAP_2), U2.48 (VDD_4), U2.64 (VDD), VREG_33.4 (VOUT_2)

Notes on the sheet:
RS: slewrate 0Ohm: highspeed 10kOhm: 15 V/us 100kOhm: 2 V/us

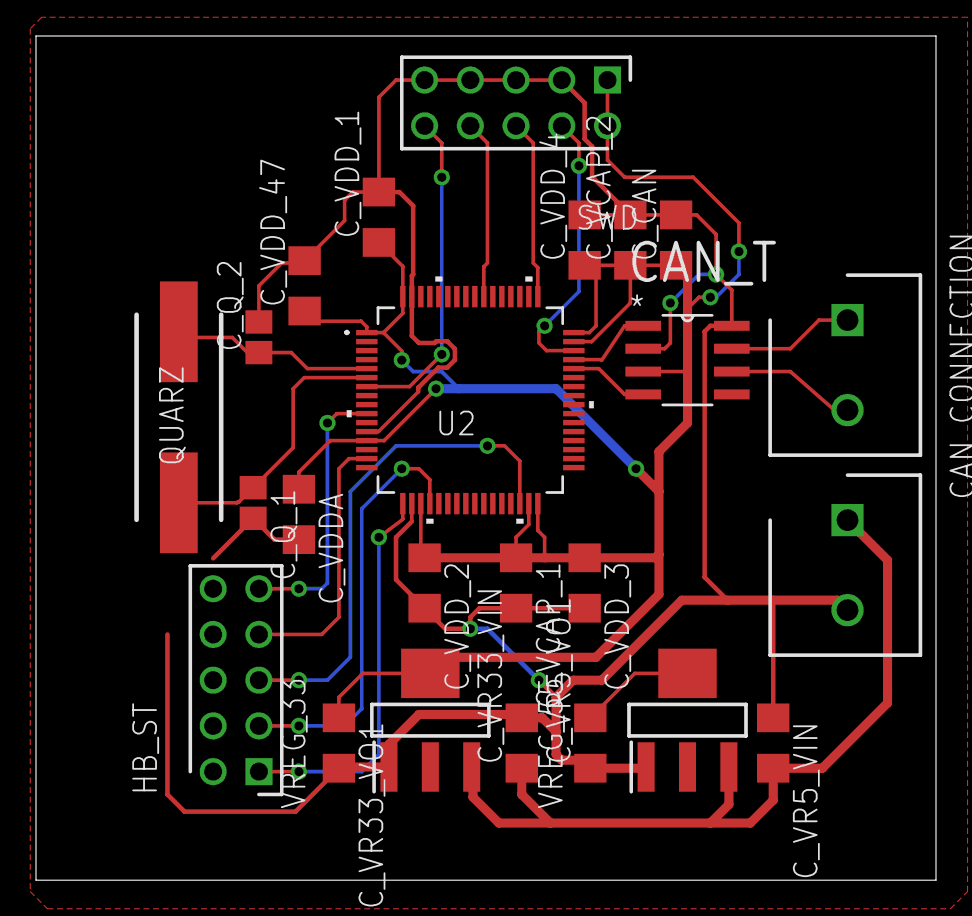
[picture p205: board protoBoardLogic.brd from above]

Board: 2 copper layers, 50.0 x 46.9 mm, 24 parts (0 on the bottom side), 19 nets.
