malbreitenbach/adp_tauchspulenelektronik/Platinenentwurf/weitere_bauteile/testboard/ProtoBoardHB/protoBoardHB.brd

## EAGLE design Platinenentwurf/weitere_bauteile/testboard/ProtoBoardHB/protoBoardHB.brd (2019-02-19)

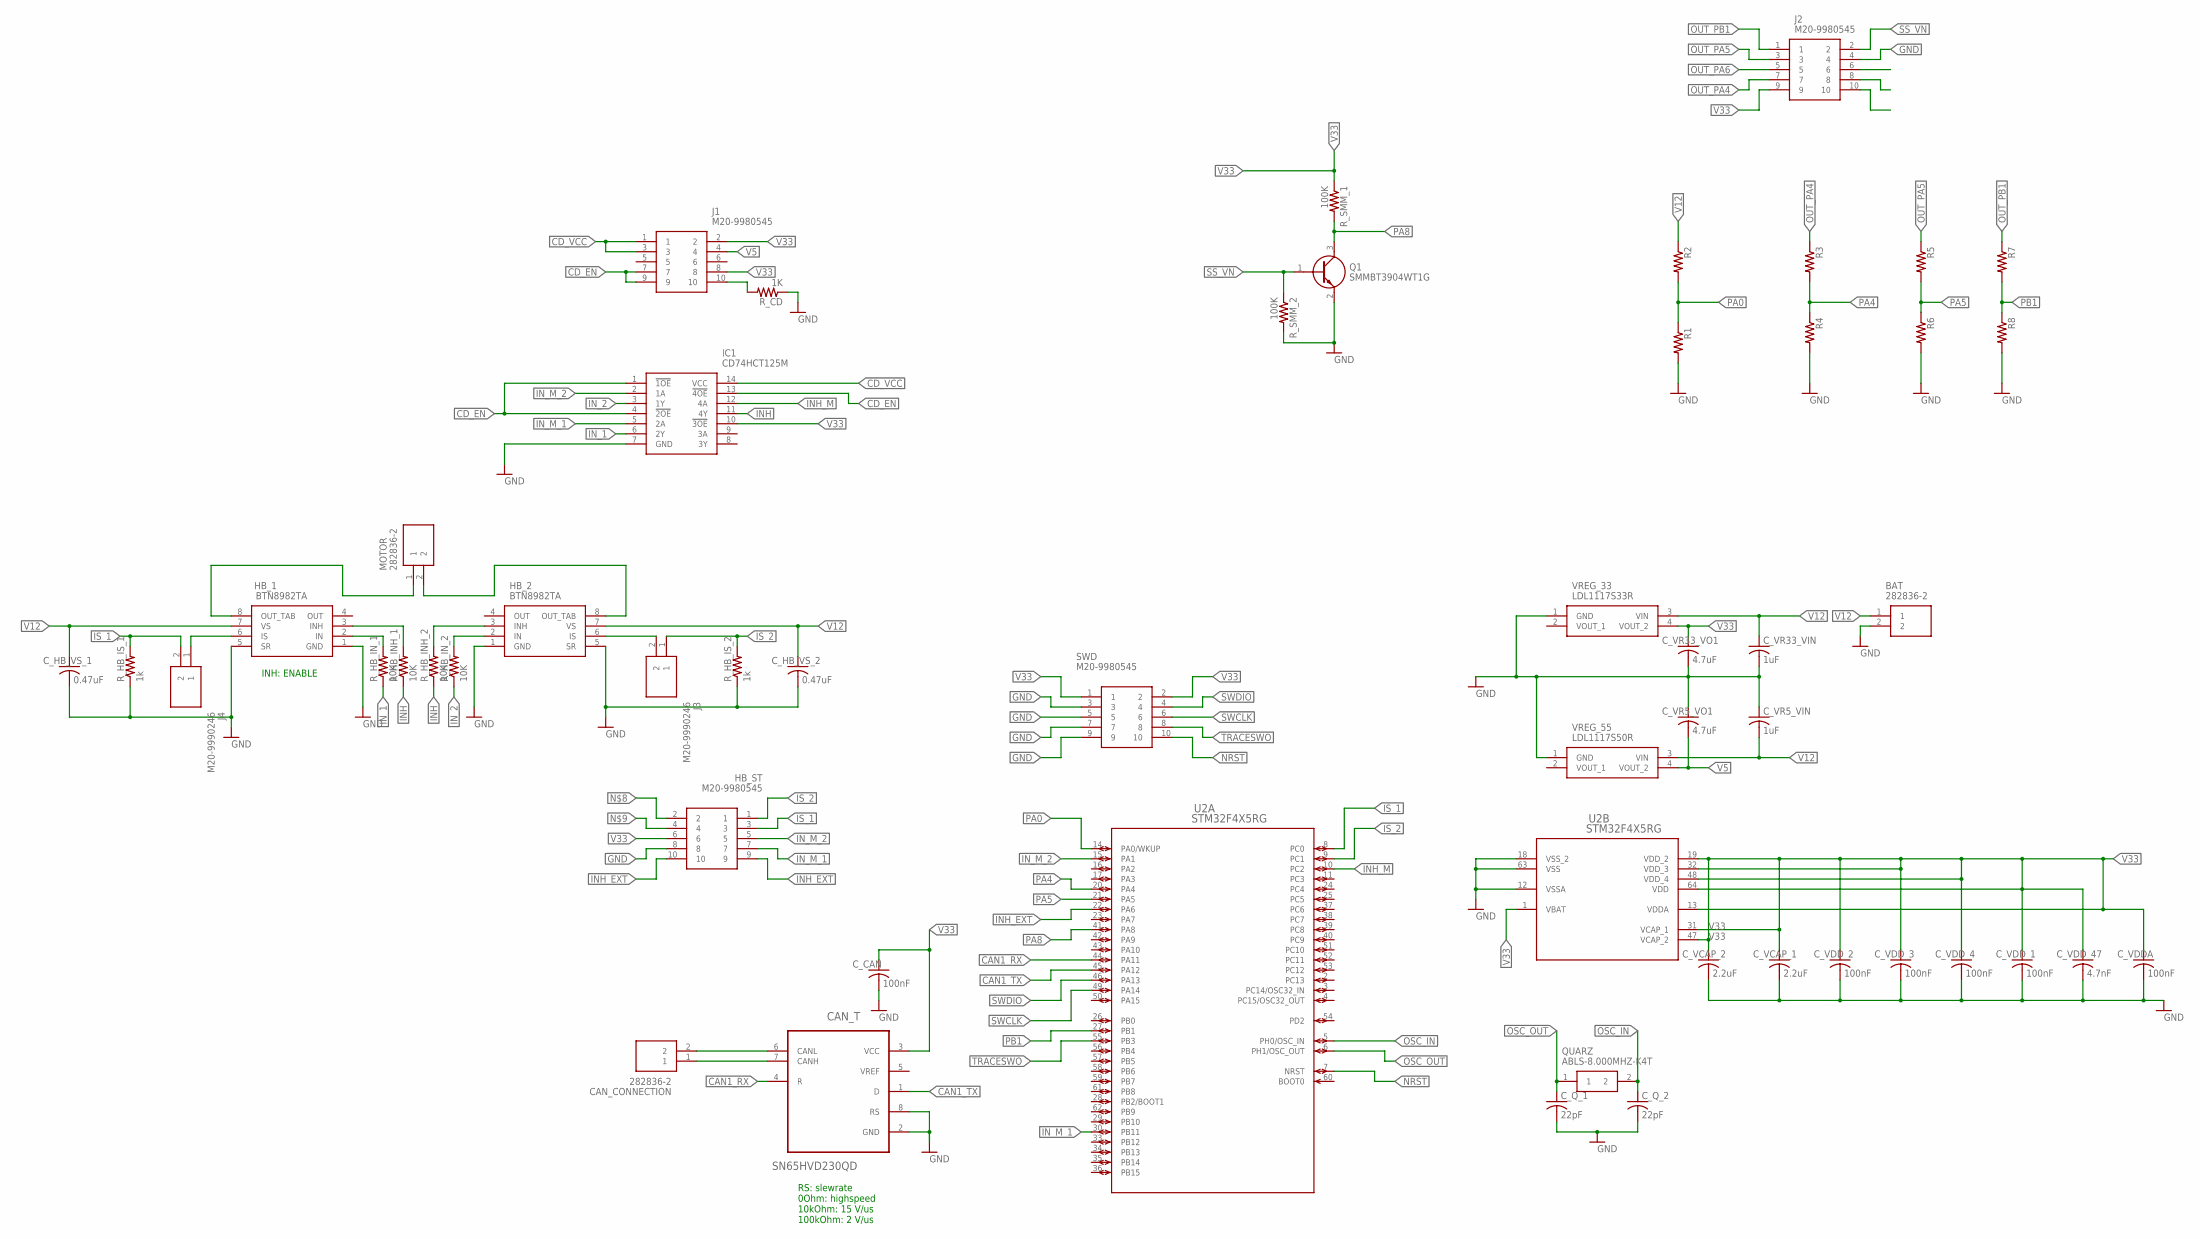
[picture p206: schematic protoBoardHB.sch]

Parts:
BAT: 282836-2; SHDR2W100P0X500_1X2_1000X820X1
CAN_CONNECTION: 282836-2; SHDR2W100P0X500_1X2_1000X820X1
CAN_T: SN65HVD230QD; SOIC127P600X175-8N; MPN SN65HVD230QD..
C_CAN: 100nF; C1206
C_HB_VS_1, C_HB_VS_2: 0.47uF; C1206
C_Q_1, C_Q_2: 22pF; C0805
C_VCAP_1, C_VCAP_2: 2.2uF; C1206
C_VDDA: 100nF; C1206
C_VDD_1, C_VDD_2, C_VDD_3, C_VDD_4: 100nF; C1206
C_VDD_47: 4.7nF; C1206
C_VR5_VIN, C_VR33_VIN: 1uF; C1206
C_VR5_VO1, C_VR33_VO1: 4.7uF; C1206
HB_1, HB_2: BTN8982TA; TO127P1500X440-8N
HB_ST: M20-9980545; HDRV10W80P254_2X5_1270X508X864; MPN M20-9980545
IC1: CD74HCT125M; SOIC127P600X175-14N
J1, J2: M20-9980545; HDRV10W80P254_2X5_1270X508X864
J3, J4: M20-9990246; HDRV2W64P0X254_1X2_508X254X864
MOTOR: 282836-2; SHDR2W100P0X500_1X2_1000X820X1
Q1: SMMBT3904WT1G; SOT65P220X100-3N
QUARZ: ABLS-8.000MHZ-K4T; ABLS-12.000MHZ-B2; MPN ABLS-8.000MHZ-K4T
R1, R2, R3, R4, R5, R6, R7, R8: R-US_R1206; R1206
R_CD: 1K; R1206
R_HB_INH_1, R_HB_INH_2: 10K; R1206
R_HB_IN_1, R_HB_IN_2: 10K; R1206
R_HB_IS_1, R_HB_IS_2: 1k; R1206
R_SMM_1, R_SMM_2: 100K; R1206
SWD: M20-9980545; HDRV10W80P254_2X5_1270X508X864; MPN M20-9980545
U2: STM32F4X5RG; LQFP64-10X10MM
VREG_33: LDL1117S33R; SOT230P700X180-4N; MPN LDL1117S33R
VREG_55: LDL1117S50R; SOT230P700X180-4N; MPN LDL1117S50R

Connections:
CAN1_RX: CAN_T.4 (R), U2.44 (PA11)
CAN1_TX: CAN_T.1 (D), U2.45 (PA12)
CANH: CAN_CONNECTION.1, CAN_T.7 (CANH)
CANL: CAN_CONNECTION.2, CAN_T.6 (CANL)
CD_EN: IC1.1 (!1OE), IC1.4 (!2OE), IC1.13 (!4OE), J1.7, J1.9
CD_VCC: IC1.14 (VCC), J1.1, J1.3
GND: BAT.2, CAN_T.2 (GND), CAN_T.8 (RS), C_CAN.2, C_HB_VS_1.2, C_HB_VS_2.2, C_Q_1.2, C_Q_2.2, C_VCAP_1.2, C_VCAP_2.2, C_VDDA.2, C_VDD_1.2, C_VDD_2.2, C_VDD_3.2, C_VDD_4.2, C_VDD_47.2, C_VR5_VIN.1, C_VR5_VO1.1, C_VR33_VIN.2, C_VR33_VO1.2, HB_1.1 (GND), HB_1.5 (SR), HB_2.1 (GND), HB_2.5 (SR), HB_ST.8, IC1.7 (GND), J2.4, Q1.2 (E), R1.2, R4.2, R6.2, R8.2, R_CD.1, R_HB_IS_1.1, R_HB_IS_2.1, R_SMM_2.2, SWD.3, SWD.5, SWD.7, SWD.9, U2.12 (VSSA), U2.18 (VSS_2), U2.63 (VSS), VREG_33.1 (GND), VREG_55.1 (GND)
INH: IC1.11 (4Y), R_HB_INH_1.1, R_HB_INH_2.1
INH_EXT: HB_ST.9, HB_ST.10, U2.22 (PA6)
INH_M: IC1.12 (4A), U2.10 (PC2)
IN_1: IC1.6 (2Y), R_HB_IN_1.1
IN_2: IC1.3 (1Y), R_HB_IN_2.1
IN_M_1: HB_ST.7, IC1.5 (2A), U2.30 (PB11)
IN_M_2: HB_ST.5, IC1.2 (1A), U2.15 (PA1)
IS_1: HB_ST.3, J4.2, R_HB_IS_1.2, U2.8 (PC0)
IS_2: HB_ST.1, J3.1, R_HB_IS_2.2, U2.9 (PC1)
unnamed: J1.10, R_CD.2
unnamed: HB_2.6 (IS), J3.2
unnamed: HB_1.2 (IN), R_HB_IN_1.2
unnamed: HB_1.3 (INH), R_HB_INH_1.2
unnamed: HB_2.2 (IN), R_HB_IN_2.2
unnamed: HB_2.3 (INH), R_HB_INH_2.2
unnamed: HB_1.6 (IS), J4.1
NRST: SWD.10, U2.7 (NRST)
OSC_IN: C_Q_2.1, QUARZ.2, U2.5 (PH0/OSC_IN)
OSC_OUT: C_Q_1.1, QUARZ.1, U2.6 (PH1/OSC_OUT)
OUT_PA4: J2.7, R3.1
OUT_PA5: J2.3, R5.1
OUT_PA6: J2.5
OUT_PB1: J2.1, R7.1
PA0: R1.1, R2.2, U2.14 (PA0/WKUP)
PA4: R3.2, R4.1, U2.20 (PA4)
PA5: R5.2, R6.1, U2.21 (PA5)
PA8: Q1.3 (C), R_SMM_1.2, U2.41 (PA8)
PB1: R7.2, R8.1, U2.27 (PB1)
SS_VN: J2.2, Q1.1 (B), R_SMM_2.1
SWCLK: SWD.6, U2.49 (PA14)
SWDIO: SWD.4, U2.46 (PA13)
TRACESWO: SWD.8, U2.55 (PB3)
V5: C_VR5_VO1.2, J1.4, VREG_55.4 (VOUT_2)
V12: BAT.1, C_HB_VS_1.1, C_HB_VS_2.1, C_VR5_VIN.2, C_VR33_VIN.1, HB_1.7 (VS), HB_2.7 (VS), R2.1, VREG_33.3 (VIN), VREG_55.3 (VIN)
V33: CAN_T.3 (VCC), C_CAN.1, C_VCAP_1.1, C_VCAP_2.1, C_VDDA.1, C_VDD_1.1, C_VDD_2.1, C_VDD_3.1, C_VDD_4.1, C_VDD_47.1, C_VR33_VO1.1, HB_ST.6, IC1.10 (!3OE), J1.2, J1.8, J2.9, R_SMM_1.1, SWD.1, SWD.2, U2.1 (VBAT), U2.13 (VDDA), U2.19 (VDD_2), U2.31 (VCAP_1), U2.32 (VDD_3), U2.47 (VCAP_2), U2.48 (VDD_4), U2.64 (VDD), VREG_33.4 (VOUT_2)
V_MOT_MIN: HB_2.8 (OUT_TAB), MOTOR.2
V_MOT_PL: HB_1.8 (OUT_TAB), MOTOR.1

Notes on the sheet:
RS: slewrate 0Ohm: highspeed 10kOhm: 15 V/us 100kOhm: 2 V/us
INH: ENABLE
