malbreitenbach/adp_tauchspulenelektronik/Platinenentwurf/weitere_bauteile/testboard/ProtoBoardHB/protoBoardHB.brd

## EAGLE design Platinenentwurf/weitere_bauteile/testboard/ProtoBoardHB/protoBoardHB.brd (continued)

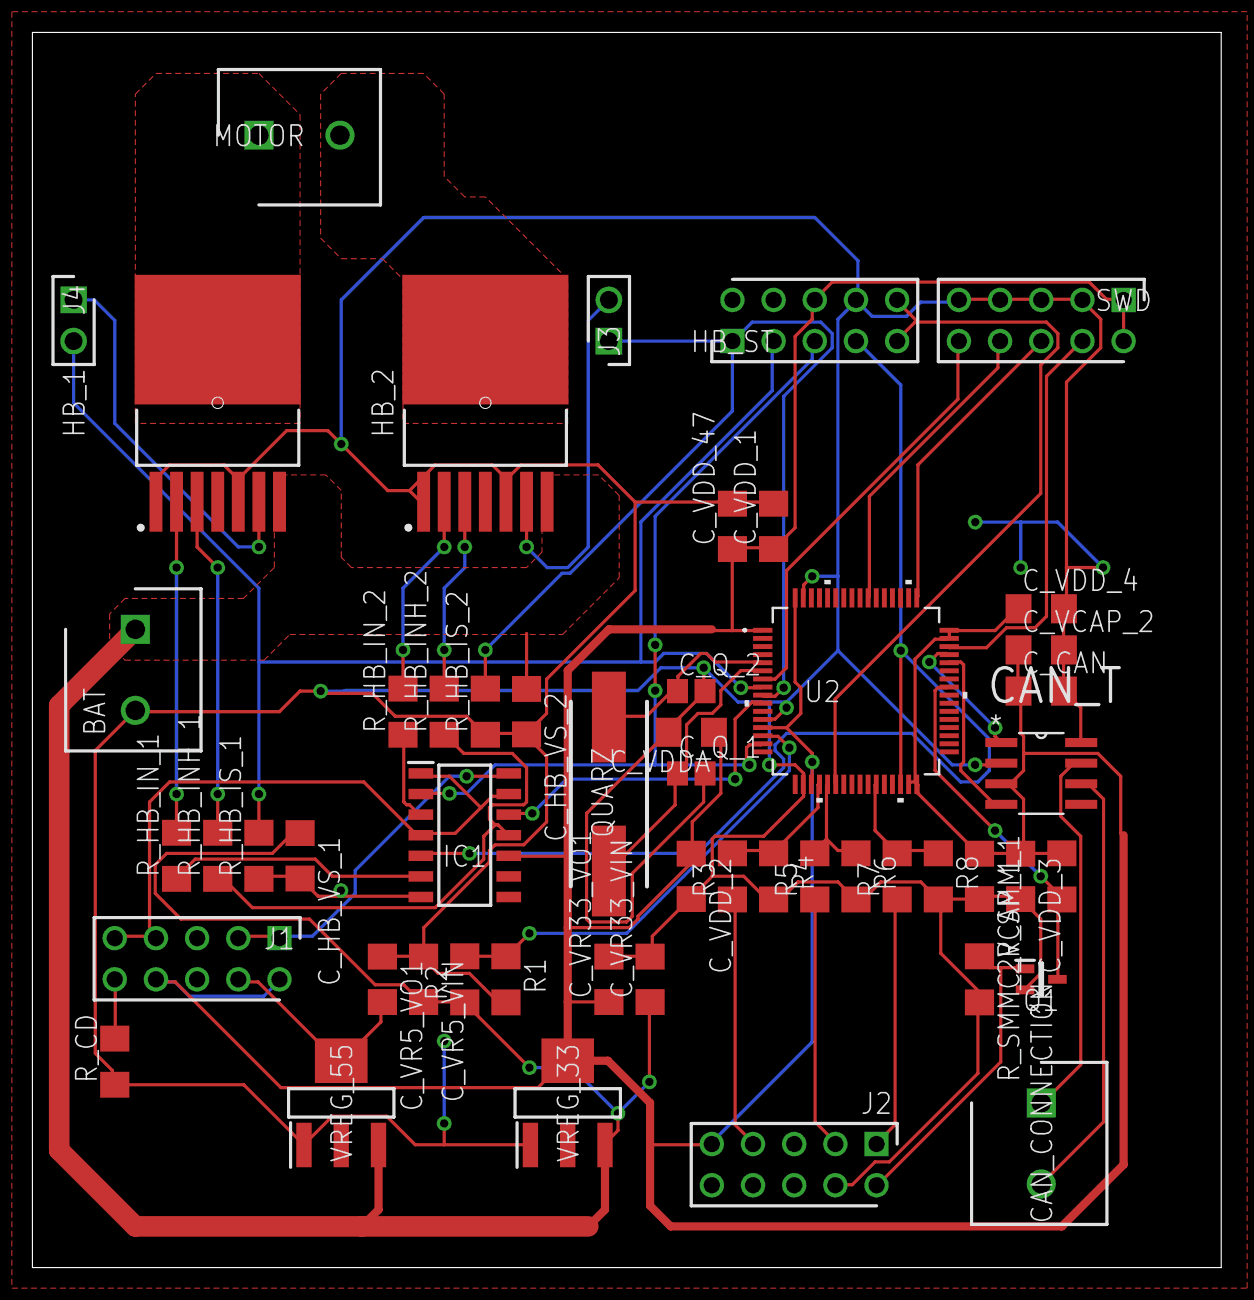
[picture p207: board protoBoardHB.brd from above]

Board: 2 copper layers, 73.3 x 76.2 mm, 52 parts (0 on the bottom side), 43 nets.
