malbreitenbach/adp_tauchspulenelektronik/Platinenentwurf/weitere_bauteile/PINOUT.ioc

Mcu.UserName=STM32F405RGTx
PA0-WKUP.Signal=ADCx_IN0
PA1.Signal=ADCx_IN1
PA11.Signal=CAN1_RX
PA12.Signal=CAN1_TX
PA13.Signal=SYS_JTMS-SWDIO
PA14.Signal=SYS_JTCK-SWCLK
PA2.Signal=USART2_TX
PA3.Signal=USART2_RX
PB0.Signal=ADCx_IN8
PB1.Signal=ADCx_IN9
PB10.Signal=S_TIM2_CH3
PB11.Signal=S_TIM2_CH4
PB3.Signal=SYS_JTDO-SWO
PC2.Signal=ADCx_IN12
PC3.Signal=ADCx_IN13
PC4.Signal=GPIO_Output
PC5.Signal=ADCx_IN15
PH0-OSC_IN.Signal=RCC_OSC_IN
PH1-OSC_OUT.Signal=RCC_OSC_OUT
