malbreitenbach/adp_tauchspulenelektronik/(commit log)

2018-12-05 Probeweise Änderung.
2018-12-17 Bestelliste fuer Prototypen erstellt.
    [Bestellung_Prototyp.ods]
2018-12-17 Ergaenzung zu Bestelliste
    [Bestellung_Prototyp.ods]
2018-12-19 Anforderungsliste erstellt
    [Anforderungsliste.ods]
2018-12-19 Kleine Rechtschreibanpassungen
    [Anforderungsliste.ods]
2018-12-19 Anforderungsliste angepasst nach Treffen mit Daniel
    [Anforderungsliste.ods]
2018-12-19 Bestellliste vervollständigt
    [Bestellung_Prototyp.ods]
2019-01-29 Datenblattt discovery shield, Bestellung Minimalbesschaltung added
    [Bestellungen_Minimalbeschaltung.ods]
2019-01-29 Aenderung Bestellliste
    [Bestellungen_Minimalbeschaltung.ods]
2019-02-01 aenderung bestellliste minimalbeschaltung
    [Bestellungen_Minimalbeschaltung.ods]
2019-02-15 Platinenentwurf added
    [protoBoard.brd, protoBoard.sch, protoBoardLogic.brd, protoBoardLogic.sch]
2019-02-17 ProtoBoard update
    [protoBoard.brd, protoBoard.sch, protoBoardHB.brd, protoBoardHB.sch, protoBoardLogic.brd, protoBoardLogic.sch]
2019-02-18 weitere Bauteile
    [Bauteil_Liste.xlsx, STM32F405RGTx_PINout.xlsx]
2019-02-18 Platinenzeugs + Boardbilder zur ueberpruefung
    [protoBoardHB.brd, protoBoardHB.sch]
2019-02-18 Platinenentwurf: kleines Update
    [protoBoardHB.brd, protoBoardHB.sch]
2019-02-18 Datenblätter+ neue Bestellliste
    [Bestellliste_Platine.ods]
2019-02-19 änderungen Platine + Bestellliste
    [Bestellliste_Platine.ods, protoBoardHB.brd]
2019-02-19 Bauteile für Platine hinzugefügt
    [Bestellliste_Platine.ods]
2019-02-19 kleine Ergänzung
    [Bestellliste_Platine.ods]
2019-02-19 update Platine
    [protoBoardHB.brd, protoBoardHB.sch]
2019-02-20 Add files via upload
    Sorry, musste es neu hochladen.
    Johanna
    [Bestellliste_Platine (1).ods]
2019-02-20 Platinenupdate auf 0.7um Kupfer
    [protoBoardHB.brd]
2019-02-20 lötpaste hinzugefügt in bestellliste
    [Bestellliste_Platine (1).ods]
2019-03-01 Bauteilzuweisungen fuer loeten
    [Bauteilzuweisung.ods, protoBoardHB.brd]
2019-03-04 Sicherung und Ringkabelschuhe hinzugefügt
    [Nachbestellung.ods]
2019-03-07 Neue Platine
    [STM32F405RGTx_PINout.xlsx]
2019-03-07 Aktualisierung nach Telefonat
    [STM32F405RGTx_PINout.xlsx]
2019-03-07 Platinenänderung
    [Board.brd, Board.sch, protoBoardLogic.brd, protoBoardLogic.sch]
2019-03-07 Ausarbeitung vorheriges ADP und Bilder hinzugefügt
2019-03-07 CAD Bilder
2019-03-07 Neue Bauteile
    [STM32F405RGTx_PINout.xlsx]
2019-03-08 Inventarliste added
    [Bestellung-Endplatine.ods, Board.brd, Board.sch, Inventarliste.ods]
2019-03-10 Bestellliste aktualisiert
    [Bestellung-Endplatine.ods]
2019-03-10 inventarliste aktualiesiert
    [Inventarliste.ods]
2019-03-13 bestellliste aktualiesiert
    [Bestellung-Endplatine.ods]
2019-03-21 Kostenüberschlag
    [Bauteilzuweisung.ods, Platinenkosten.xlsx]
2019-03-25 Bestellung Backup
    [Bestelliste Backup.ods, Platinenkosten.xlsx]
2019-10-24 Finales Platinenlayout
    [Board.brd, Board.sch]
